domino-team/domino-hardware/Common/Datasheets/USB-AF-006(SMT).jpg

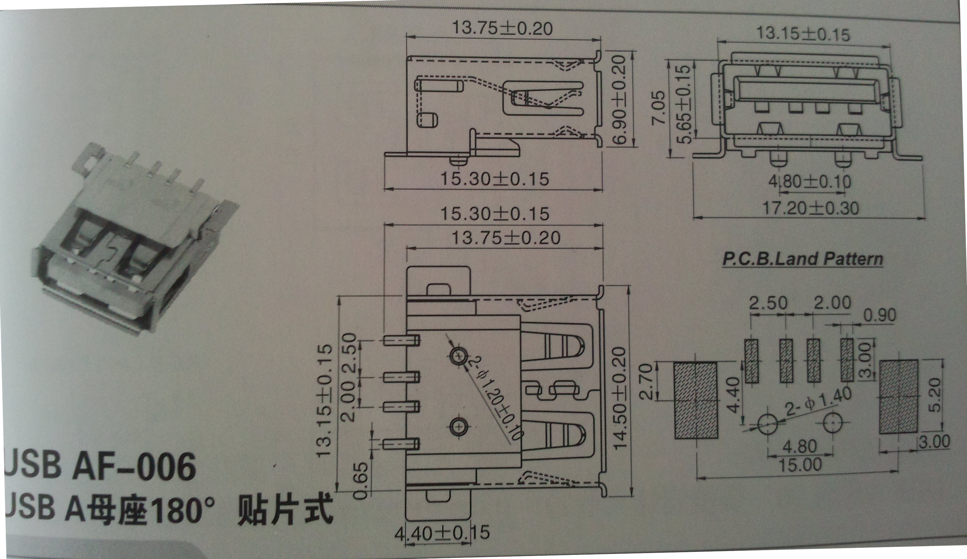
Common/Datasheets/USB-AF-006(SMT).jpg
