domino-team/domino-hardware/Common/Datasheets/usb smt.jpeg

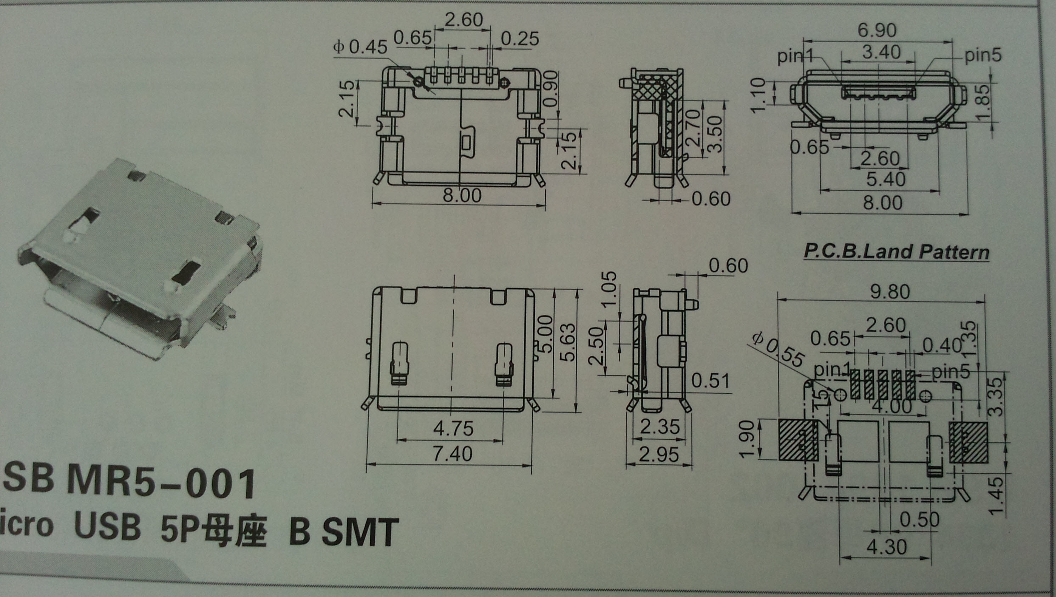
Common/Datasheets/usb smt.jpeg
