domino-team/domino-hardware/README.md

This repository contains the Domino.IO hardware design files.

For further information, please check http://domino.io/
