domino-team/domino-hardware/Common/Datasheets/IT-1124SMD.jpg

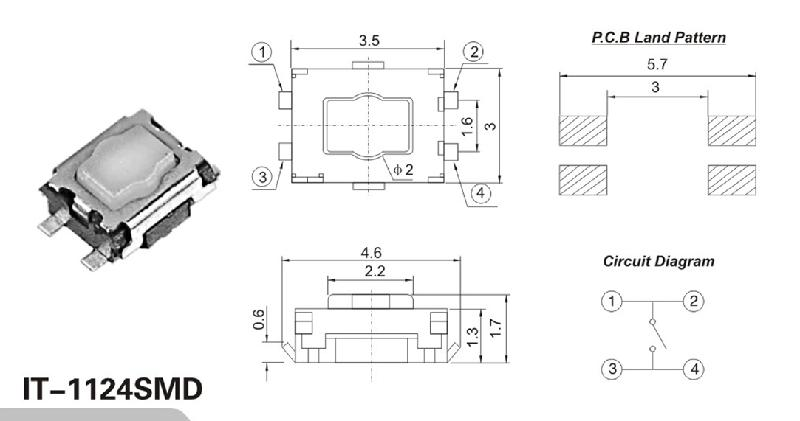
Common/Datasheets/IT-1124SMD.jpg
