domino-team/domino-hardware/Common/Datasheets/IT-1210-footprint.jpg

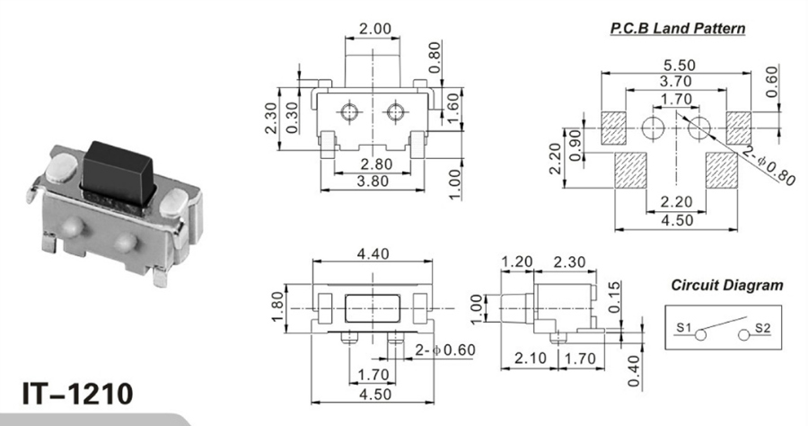
Common/Datasheets/IT-1210-footprint.jpg
