domino-team/domino-hardware/Common/Datasheets/IT-1210.jpg

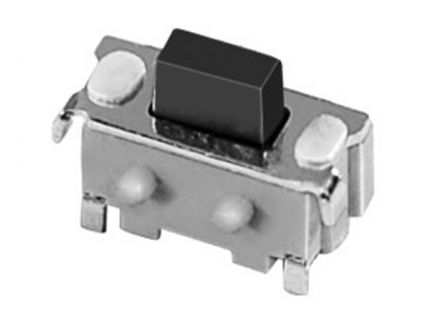
Common/Datasheets/IT-1210.jpg
