domino-team/domino-hardware/Common/Datasheets/MicroUSB-MK5P-5.9(long legs).jpg

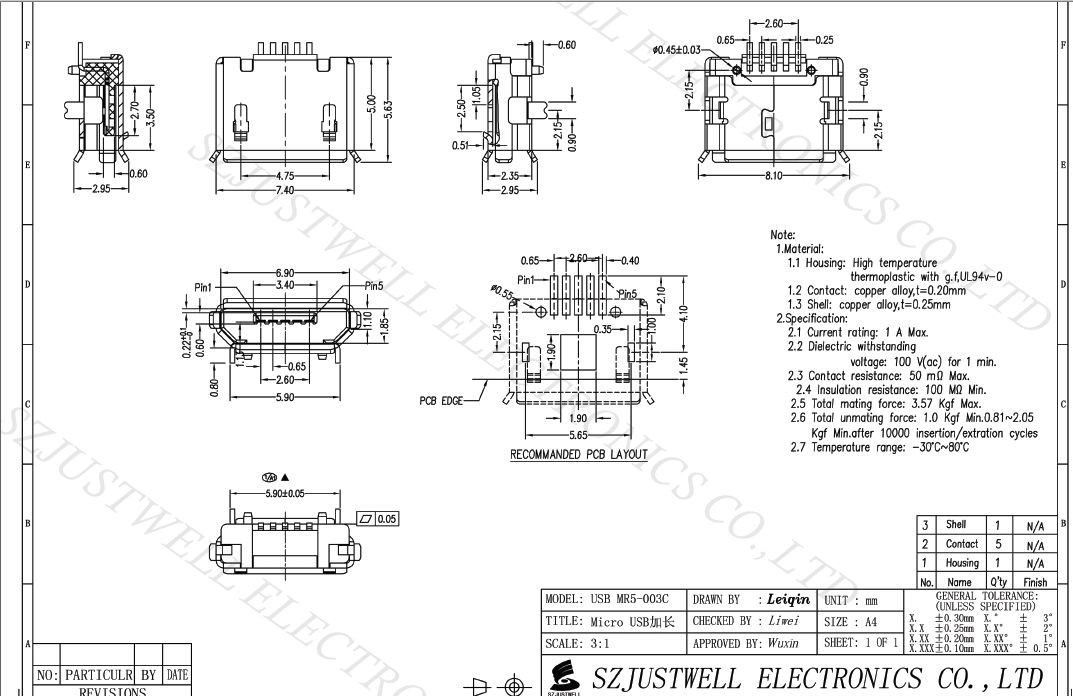
Common/Datasheets/MicroUSB-MK5P-5.9(long legs).jpg
