domino-team/domino-hardware/Common/Datasheets/USB AF-020.jpg

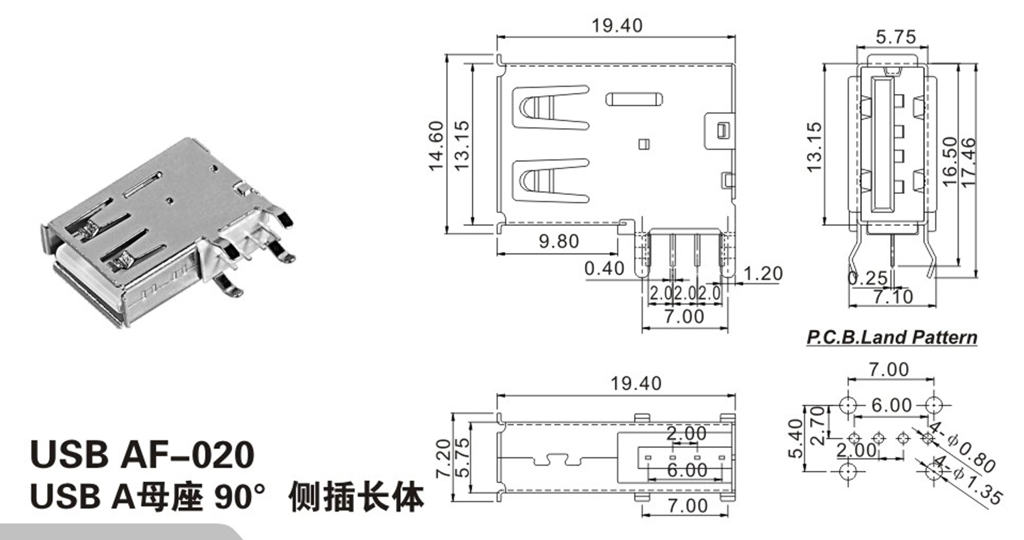
Common/Datasheets/USB AF-020.jpg
