domino-team/domino-hardware/Common/Datasheets/USB-MR5-001.jpg

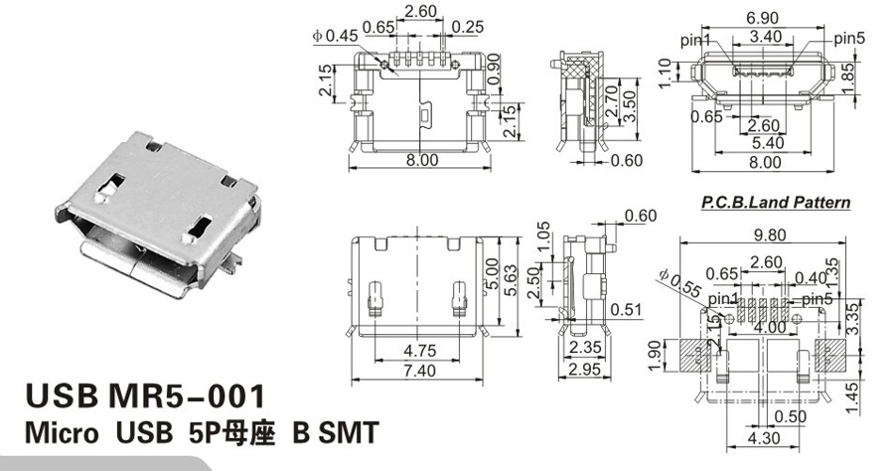
Common/Datasheets/USB-MR5-001.jpg
