domino-team/domino-hardware/Domino Di/PDF/Domino Di_BOM.pdf

# Domino Di Rev. B

Item Qty | Value | Manufacturer | Device | Package | Reference | Description | Remarks
1 | 1 ANY | 2n2 | C1210_2n2_X7R_10%_CER_2kV | C1206 | C1 | CAP CER 2200PF 1KV 10% X7R 1210
2 | 5 ANY | 100n | C0402_100n_X7R_10%_CER_50V | C0402 | C2, C3, C4, C5, C6 | CAP CER 0.1UF 50V 10% X7R 0402
3 | 1 ANY | BLUE | LED0603-BLUE | LED0603 | D1 | LED BLUE CLEAR 0603 SMD
4 | 1 ANY | WHITE | LED0603-WHITE | LED0603 | D2 | LED WHITE CLEAR 0603 SMD
5 | 4 ANY | GREEN | LED0603-GREEN | LED0603 | D3, D4, D5, D6 | LED GREEN CLEAR 0603 SMD
6 | 1 ANY | RED | LED0603-ORANGE | LED0603 | D7 | LED ORANGE CLEAR 0603 SMD
7 | 1 ANY | ORANGE | LED0603-ORANGE | LED0603 | D8 | LED ORANGE CLEAR 0603 SMD
8 | 1 ANY | YELLOW | LED0603-YELLOW | LED0603 | D9 | LED YELLOW CLEAR 0603 SMD
9 | 1 SHEZHEN HUILY ELECTHBJ-2H101NLF | HBJ-2H101NLF | HBJ-2H101NLF | J1 | CONN MAGJACK 2PORT 100 BASE-T
10 | 1 ANY | MH3-1 | MH3-1-0.1 | MH3-1-0.1 | J2 | CONN HEADER VERT .100 1ROW 3POS 8.08 HEAD 3.05 TAIL 15AU
11 | 2 ANY | MH18-1 | MH18-1-0.1 | MH18-1-0.1 | J3, J4 | CONN HEADER VERT .100 1ROW 18POS 8.08 HEAD 3.05 TAIL 15AU
12 | 1 ANY | 4k7 | R0402_4k7_5%_62.5mW | R0402 | R1 | RES 4.7K OHM 1/16W 5% 0402 SMD
13 | 6 ANY | 270R | R0603_270R_5%_125mW | R0603 | R12, R13, R14, R15, R16, R17 | RES 270 OHM 1/8W 5% 0603 SMD
14 | 3 ANY | 330R | R0603_330R_5%_125mW | R0603 | R18, R19, R20 | RES 330 OHM 1/8W 5% 0603 SMD
15 | 1 ANY | 15k | R0402_15k_5%_62.5mW | R0402 | R2 | RES 15K OHM 1/16W 5% 0402 SMD
16 | 1 ANY | 220R | R0402_220R_5%_62.5mW | R0402 | R3 | RES 220 OHM 1/16W 5% 0402 SMD
17 | 8 ANY | 49R9 | R0402_49R9_1%_62.5mW | R0402 | R4, R5, R6, R7, R8, R9, R10, R11 | RES 49.9 OHM 1/16W 1% 0402 SMD
