domino-team/domino-hardware/Domino Single USB/PDF/Domino Single USB_BOM.pdf

# Domino Single USB Rev. E

Item | | Manufacturer | | | | Description
1 | 3 0R | ANY | R0402_0R_5%_62.5mW | R0402 | R3, R5, R6 | RES 0.0 OHM 1/16W JUMP 0402 SMD
2 | 1 1n | ANY | C1206_1n_X7R_10%_CER_500V | C1206 | C5 | CAP CER 1000PF 500V 10% X7R 1206
3 | 1 10u | ANY | C0603_10u_X5R_20%_CER_6V3 | C0603 | C1 | CAP CER 10UF 6.3V 20% X5R 0603
4 | 1 10u | ANY | C0805_10u_X5R_10%_CER_16V | C0805 | C4 | CAP CER 10UF 16V 10% X5R 0805
5 | 1 15k | ANY | R0402_15k_5%_62.5mW | R0402 | R4 | RES 15K OHM 1/16W 5% 0402 SMD
6 | 1 22u | ANY | C0805_22u_X5R_20%_CER_6V3 | C0805 | C2 | CAP CER 22UF 6.3V 20% X5R 0805
7 | 1 33R | ANY | R0402_33R_5%_62.5mW | R0402 | R1 | RES 33 OHM 1/16W 5% 0402 SMD
8 | 1 100k | ANY | R0402_100k_5%_62.5mW | R0402 | R2 | RES 100K OHM 1/16W 5% 0402 SMD
9 | 1 100n | ANY | C0402_100n_X7R_10%_CER_50V | C0402 | C3 | CAP CER 0.1UF 50V 10% X7R 0402
10 | 1 BLM31PG601SN1L | MURATA | BLM31PG601SN1L | FB1206 | L1 | FERRITE CHIP 600 OHM 1500MA 1206
11 | 2 MH10-1 | ANY | MH10-1-0.1 | MH10-1-0.1 | J1, J2 | CONN HEADER VERT .100 1ROW 10POS 8.08 HEAD 3.05 TAIL 15AU
12 | 1 MP65151DJ | MONOLITHIC POWER | MP65151DJ | SOT23-6 | U1 | IC POWER SWITCH 1.7A SOT23-6
13 | 1 PRTR5V0U2X | NXP | PRTR5V0U2X | SOT143B | D1 | TVS DIODE ARRAY 2CH 5V SOT143
Qty | Value | Device | Package | Reference | Remarks
