domino-team/domino-hardware/Domino LED/PDF/Domino LED_BOM.pdf

# Domino LED Rev. D

Item | Manufacturer | Description
1 | 1 BLUE | ANY | LED0603-BLUE | LED0603 | D1 | LED BLUE CLEAR 0603 SMD
2 | 1 WHITE | ANY | LED0603-WHITE | LED0603 | D2 | LED WHITE CLEAR 0603 SMD
3 | 4 GREEN | ANY | LED0603-GREEN | LED0603 | D3, D4, D5, D6 | LED GREEN CLEAR 0603 SMD
4 | 1 RED | ANY | LED0603-RED | LED0603 | D7 | LED RED CLEAR 0603 SMD
5 | 1 ORANGE | ANY | LED0603-ORANGE | LED0603 | D8 | LED ORANGE CLEAR 0603 SMD
6 | 1 YELLOW | ANY | LED0603-YELLOW | LED0603 | D9 | LED YELLOW CLEAR 0603 SMD
7 | 1 MH11-1 | ANY | MH11-1-0.1 | MH11-1-0.1 | J1 | CONN HEADER VERT .100 1ROW 11POS 8.08 HEAD 3.05 TAIL 15AU
8 | 6 270R | ANY | R0603_270R_5%_125mW | R0603 | R1, R2, R3, R4, R5, R6 | RES 270 OHM 1/8W 5% 0603 SMD
9 | 3 330R | ANY | R0603_330R_5%_125mW | R0603 | R7, R8, R9 | RES 330 OHM 1/8W 5% 0603 SMD
Qty | Value | Device | Package | Reference | Remarks
