domino-team/domino-hardware/Domino I2S/BOM/Domino I2S BOM.xlsx

Item | Qty | Value | Manufacturer | Device | Package | Reference | Description | Remarks
1 | 6 | 4u7 | ANY | C0402_4u7_X5R_10%_CER_6V3 | C0402 | C1, C2, C3, C4, C5, C6 | CAP CER 4.7UF 6.3V 10% X5R 0402
2 | 2 | 1n | ANY | C0402_1n_X7R_10%_CER_50V | C0402 | C10, C11 | CAP CER 1NF 50V 10% X7R 0402
3 | 2 | 10n | ANY | C0402_10n_X7R_10%_CER_50V | C0402 | C14, C15 | CAP CER 10000PF 50V 10% X7R 0402
4 | 1 | 220p | ANY | C0402_220p_X7R_10%_CER_50V | C0402 | C7 | CAP CER 0.22UF 50V 10% X7R 0402
5 | 2 | 33p | ANY | C0402_33p_NP0_5%_CER_50V | C0402 | C8, C12 | CAP CER 33PF 50V 5% NP0 0402
6 | 5 | 1u | ANY | C0402_1u_X7R_10%_CER_25V | C0402 | C9, C13, C16, C17, C18 | CAP CER 1UF 25V 10% X7R 0402
7 | 2 | 220u | ANY | C2-5x7_220u_ALU_20%_RAD_6V3 | E2-5 | EC1, EC2 | CAP ALUM 220UF 6.3V 20% RADIAL
8 | 7 | HH-1T1005-121 | CERATECH | HH-1T2012-601 | FB0805 | FB1, FB2, FB3, FB4, FB5, FB6, FB7 | FERRITE CHIP 600 OHM 2500MA 0805
9 | 1 | ST-3538-050 | SZJUSTWELL ELECTRONICS | ST-3538-050 | ST-3538-050 | HP1 | CONN AUDIO JACK 3.5MM STEREO SMD
10 | 2 | MH18-1 | ANY | MH18-1-0.1 | MH18-1-0.1 | J1, J2 | CONN HEADER VERT .100 1ROW 18POS 8.08 HEAD 3.05 TAIL 15AU
11 | 0 | MIC-45-22 | ANY | MIC-45-22 | MIC-45-22 | J3(DNP) | MIC COND ANALOG OMNI
12 | 1 | MH2-1 | ANY | MH2-1-0.1 | MH2-1-0.1 | J4(DNP), J5(DNP), J7 | CONN HEADER VERT .100 1ROW 2POS 8.08 HEAD 3.05 TAIL 15AU
13 | 1 | DLT1120A | AIXIN LTD | DLT1120A | DLT1120A | J6 | TRANSMITTER FIBER OPTIC 16MBPS
14 | 2 | CD54NP-220MC | SUMIDA INC | CD54NP-220MC | CD54 | L1, L2 | FIXED IND 220UH 1.11A 190 MOHM
15 | 3 | 0R | ANY | R0402_0R_5%_62.5mW | R0402 | R1(DNP), R2, R12, R17 | RES 0.0 OHM 1/16W JUMP 0402 SMD
16 | 2 | 4k7 | ANY | R0402_4k7_5%_62.5mW | R0402 | R13, R14 | RES 4.7K OHM 1/16W 5% 0402 SMD
17 | 1 | 10k | ANY | R0402_10k_5%_62.5mW | R0402 | R3(DNP), R4(DNP), R15, R16(DNP) | RES 10K OHM 1/16W 5% 0402 SMD
18 | 5 | 22R | ANY | R0402_22R_5%_62.5mW | R0402 | R5, R6, R8, R10, R11 | RES 22 OHM 1/16W 5% 0402 SMD
19 | 1 | 47k | ANY | R0402_47k_5%_62.5mW | R0402 | R7 | RES 47K OHM 1/16W 5% 0402 SMD
20 | 1 | 680R | ANY | R0402_680R_5%_62.5mW | R0402 | R9 | RES 680 OHM 1/16W 5% 0402 SMD
21 | 1 | WM8978CGEFL | CIRRUS LOGIC | WM8978CGEFL | QFN-32_EP_5X5 | U1 | IC CODEC STER SPEAKER DVR 32QF
