domino-team/domino-hardware/Common/Arduino Yùn Outline.dxf

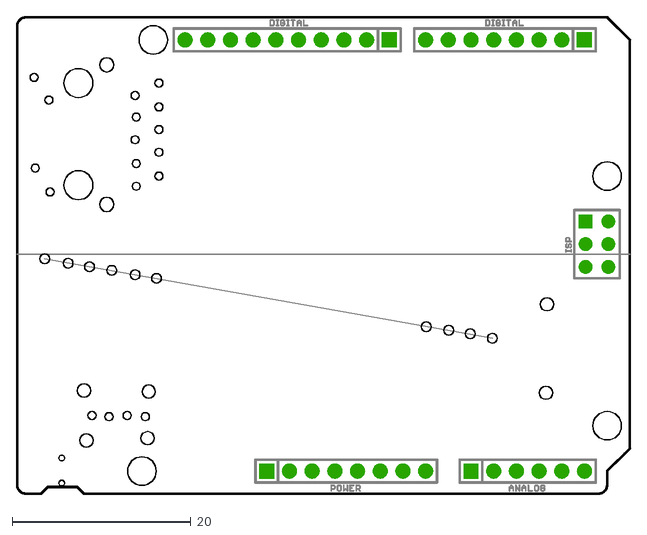
[picture p9: CAD file, 2015-01-17]
Common/Arduino Yùn Outline.dxf
68.8 x 53.6
