domino-team/domino-hardware/Common/Logo/Logos.dxf

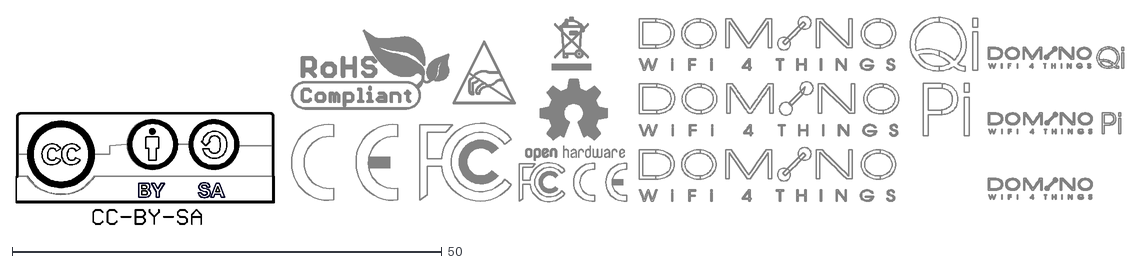
[picture p10: CAD file, 2015-01-20]
Common/Logo/Logos.dxf
128.9 x 24.2
