domino-team/domino-hardware/(threads)

Thread 1 (2015-04-27):

Eagle again, eh?

pfalcon, 2015-04-27:
I remember you replying that you don't have need/time to learn e.g. Kicad if Eagle works for you. "Glad" to see that even a kickstarter is not a reason for you do more homework with OpenSource tools.

Way to go, OpenHardware community! Aka shame-shame-shame ;-)

P.S. And yes, I keep saying this, because next time when in low spirit I reach for a proprietary crap, someone else shamed myself into doing the right thing.

Squonk42, 2015-04-27:
Sorry, but I tried again recently, and KiCAD is missing many important points and still segfaulting very often.

I have been working with many ECAD suites (Orcad, Protel Altiium, PCAD), and I can't used to KiCAD's counter-intuitive part managment, bad translations, random menus, etc.

At least ERC and back-annotation should work, which is apparently not the case.

Closed 2015-04-27.

Thread 2 (2015-05-19):

Correct way to attribute the PCB design

pastcompute, 2015-05-19:
Hi,

I'm looking at designing a shield PCB for the Domino Pi, for which I would like to copy the pinout stencil layer.

What is your preferred text to conform with the CC4 license?

I'm guessing something like the following printed on the stencil layer would suffice
```
Licensed under a Creative Commons
Attribution-Share-Alike Unported License.
See creativecommons.org/licenses/by-sa/4.0/

Attribution: portions of this design, specifically, the pinout stencil, (c) 2014-2015 The Domino Team (http://domino.io)
```

Squonk42, 2015-05-19:
This is fine if you have enough real room to put all this text, but you may also jsut provide a URI or hyperlink to a resource that includes the required information, see http://creativecommons.org/licenses/by-sa/4.0/legalcode, section 3.a.2.

pastcompute, 2015-05-23:
No worries. I was more asking as to how to refer to yourselves, so I guess that wherever it lives, attribution to (c) 2014-2015 The Domino Team (http://domino.io) conveys all the necessary information

Closed 2015-05-23.

Thread 3 (2015-08-22):

Domino Pi CP2104 USB UART not working?

gruvin, 2015-08-22:
Hello

I received my first Domino Pi from the Kickstarter campaign, today. It's working nicely. Great work!

However, it seems that the Silicon Labs CP2104 USB UART device is not working. I have the OS X drivers installed and use several other devices via CP210x chips. But in this case, no serial ports appear on OS X (/dev/tty.blah) or even in the raw USB devices, 'System Report' for that matter.

**Is this a known issue** or do I perhaps have a faulty Domino Pi board? If the latter, then perhaps I should see about checking the solder joints on the CP2104 chip, etc? I am tooled up and fine with that tiny SMD stuff. But would rather not risk damage until I get an answer here.

Thanks! :-)

Bryan.

alzhao, 2015-08-22:
The usb uart bridge should work. It rarely faulty. Is it possible that you
try on Windows or Linux first to see what is happening?
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

gruvin, 2015-08-23:
Thanks for the answer, alzhao. Astonishingly, after a full inspection under the microscope and some continuity testing, etc ... it turned out simply to be TWO faulty USB micro cables! All working now. Yay \o/

gruvin, 2015-08-24:
Alas and perhaps not surprisingly, I did NOT have two faulty cables, after all. The SP2104 chips is only coming online as a valid USB device about one in five times I plug it in. Otherwise, it is not being recognised even at the lowest hardware level.

There doesn't appear to be any dry joints. I guess I must have a dud chip, somehow. Guess I'll order some in, replace it and see what happens.

gruvin, 2015-08-24:
OK. I finally got to the bottom of it.

Pint 9 (/RST) on the CP2014 was being held almost low by a low resistance semi-bridge in the solder beneath the chip. This appears to have come about due to the pads for both pin 9 and 10 being physically missing (peeled up off the board, by the looks) causing both pins to semi attach to the solder on the large, square ground plane under the chip, during solder re-flow.

It took two remove and replace cycles of the chip for me to figure this out. Initially, I removed the chip, cleaned everything up and reinstalled. It seemed to work for about a half hour. Then the problem returned. Looking closer at things directly after removing it a second time, there was evidence suggesting a possible short of pin 9 to GND. I took steps to avoid that happening again on my second re-install and re-flow. Now, touch wood!, everything is working fine.

**NOTE** I would recommend moving the via just inside of pin 2 a few mils further away from pin 2. The drill for the via pushed the via's surrounding track very close to pin 1 - well under 5 mil spacing in my case. Avoiding that potential short seems an easy fix for future versions.

Anyway. A lot to do about very little. But there it is, in case anyone finds it useful.

Bryan.

Squonk42, 2015-08-24:
Hi @gruvin,

Thanks for spotting this! Nice hardware debugging.

Pads 9 and 10 are not supposed to be missing, and adding a pull-up to pin 9 is a very good suggestion.

We tried to put the via on pin 2 this close in order to avoid this via "sucking" solder from the large square central pad. But the last-minute "teardrop" added by the corresponding EagleCAD script made it such that it is barely respecting the 6 mils clearance rule. We will fix it in future revision.

Closed 2015-08-24.
