domino-team/domino-hardware/Domino Di/PDF/Domino Di.pdf

# North Connector Antenna

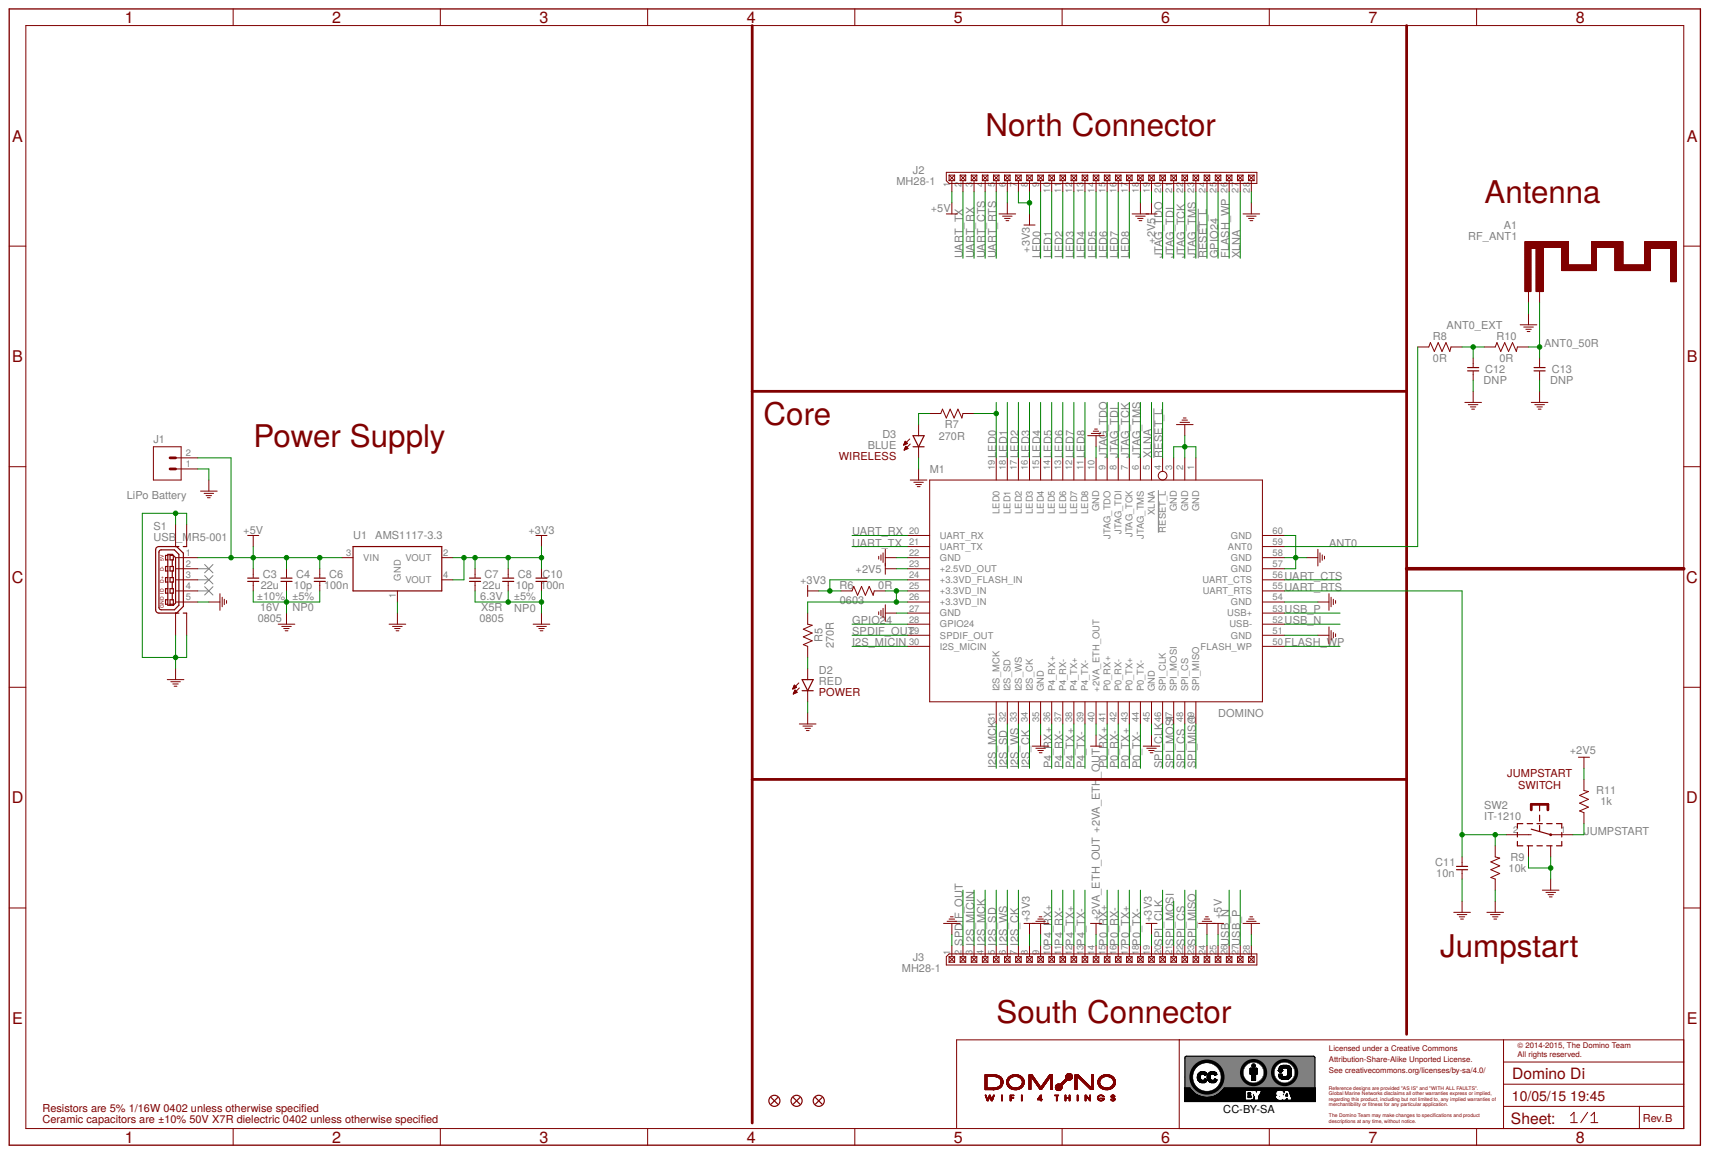
[picture p11: page 1]

Licensed under a Creative Commons Attribution-Share-Alike Unported License. See creativecommons.org/licenses/by-sa/4.0/ Reference designs are provided "AS IS" and "WITH ALL FAULTS". regarding this product, including but not limited to, any implied warranties of The Domino Team may make changes to specifications and product Global Marine Networks disclaims all other warranties express or implied, merchantibility or fitness for any particular application. descriptions at any time, without notice.

Ceramic capacitors are ±10% 50V X7R dielectric 0402 unless otherwise specified Resistors are 5% 1/16W 0402 unless otherwise specified

## DRILL CHART: TOP TO BOTTOM

A

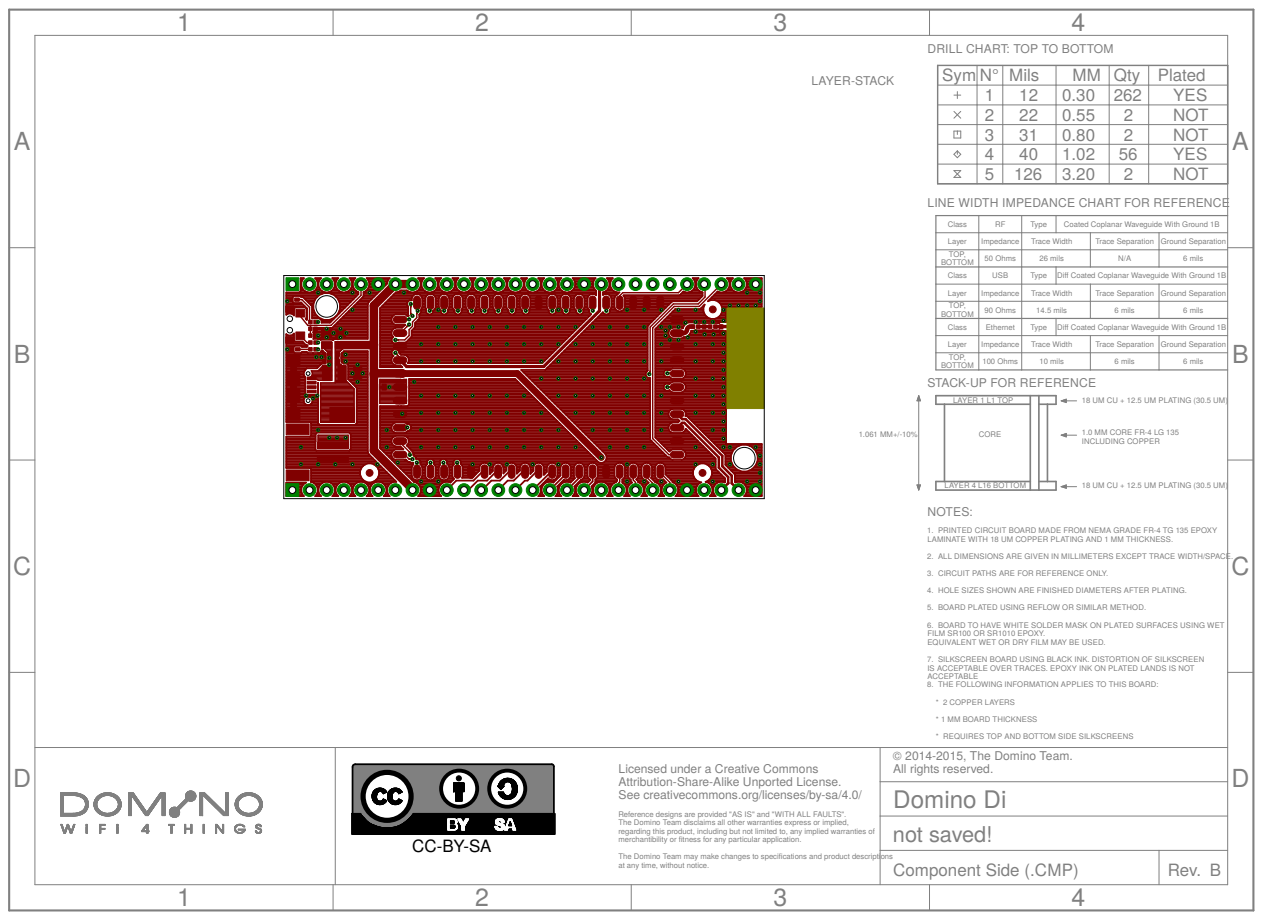
[picture p12: page 2]
LAYER 1 L1 TOP; LAYER 4 L16 BOTTOM; CORE; Rev. B; Layer; Impedance; Trace Width; Trace Separation; Ground Separation TOP, BOTTOM; 90 Ohms; 14.5 mils; 6 mils; 6 mils Class; USB; Type; Diff Coated Coplanar Waveguide With Ground 1B; 100 Ohms; 10 mils; Ethernet; LAYER-STACK; Sym N° Mils; MM Qty Plated; YES; NOT

LINE WIDTH IMPEDANCE CHART FOR REFERENCE

Layer | 50 Ohms RF Impedance | Type 26 mils Diff Coated Coplanar Waveguide With Ground 1B Trace Width | N/A Trace Separation | 6 mils Class Ground Separation TOP, BOTTOM

Coated Coplanar Waveguide With Ground 1B

1.061 MM+/-10% STACK-UP FOR REFERENCE

18 UM CU + 12.5 UM PLATING (30.5 UM)

1.0 MM CORE FR-4 LG 135
INCLUDING COPPER

NOTES: 2. ALL DIMENSIONS ARE GIVEN IN MILLIMETERS EXCEPT TRACE WIDTH/SPACE. 3. CIRCUIT PATHS ARE FOR REFERENCE ONLY.

1. PRINTED CIRCUIT BOARD MADE FROM NEMA GRADE FR-4 TG 135 EPOXY
LAMINATE WITH 18 UM COPPER PLATING AND 1 MM THICKNESS.

4. HOLE SIZES SHOWN ARE FINISHED DIAMETERS AFTER PLATING. 5. BOARD PLATED USING REFLOW OR SIMILAR METHOD. 6. BOARD TO HAVE WHITE SOLDER MASK ON PLATED SURFACES USING WET

FILM SR100 OR SR1010 EPOXY. EQUIVALENT WET OR DRY FILM MAY BE USED. 8. THE FOLLOWING INFORMATION APPLIES TO THIS BOARD: 7. SILKSCREEN BOARD USING BLACK INK. DISTORTION OF SILKSCREEN

IS ACCEPTABLE OVER TRACES. EPOXY INK ON PLATED LANDS IS NOT ACCEPTABLE

* 2 COPPER LAYERS
* 1 MM BOARD THICKNESS
* REQUIRES TOP AND BOTTOM SIDE SILKSCREENS
© 2014-2015, The Domino Team. All rights reserved.
Domino Di
not saved!
Component Side (.CMP)

Licensed under a Creative Commons Attribution-Share-Alike Unported License. See creativecommons.org/licenses/by-sa/4.0/ Reference designs are provided "AS IS" and "WITH ALL FAULTS". The Domino Team disclaims all other warranties express or implied, regarding this product, including but not limited to, any implied warranties of merchantibility or fitness for any particular application. The Domino Team may make changes to specifications and product descriptions at any time, without notice.

## DRILL CHART: TOP TO BOTTOM

A

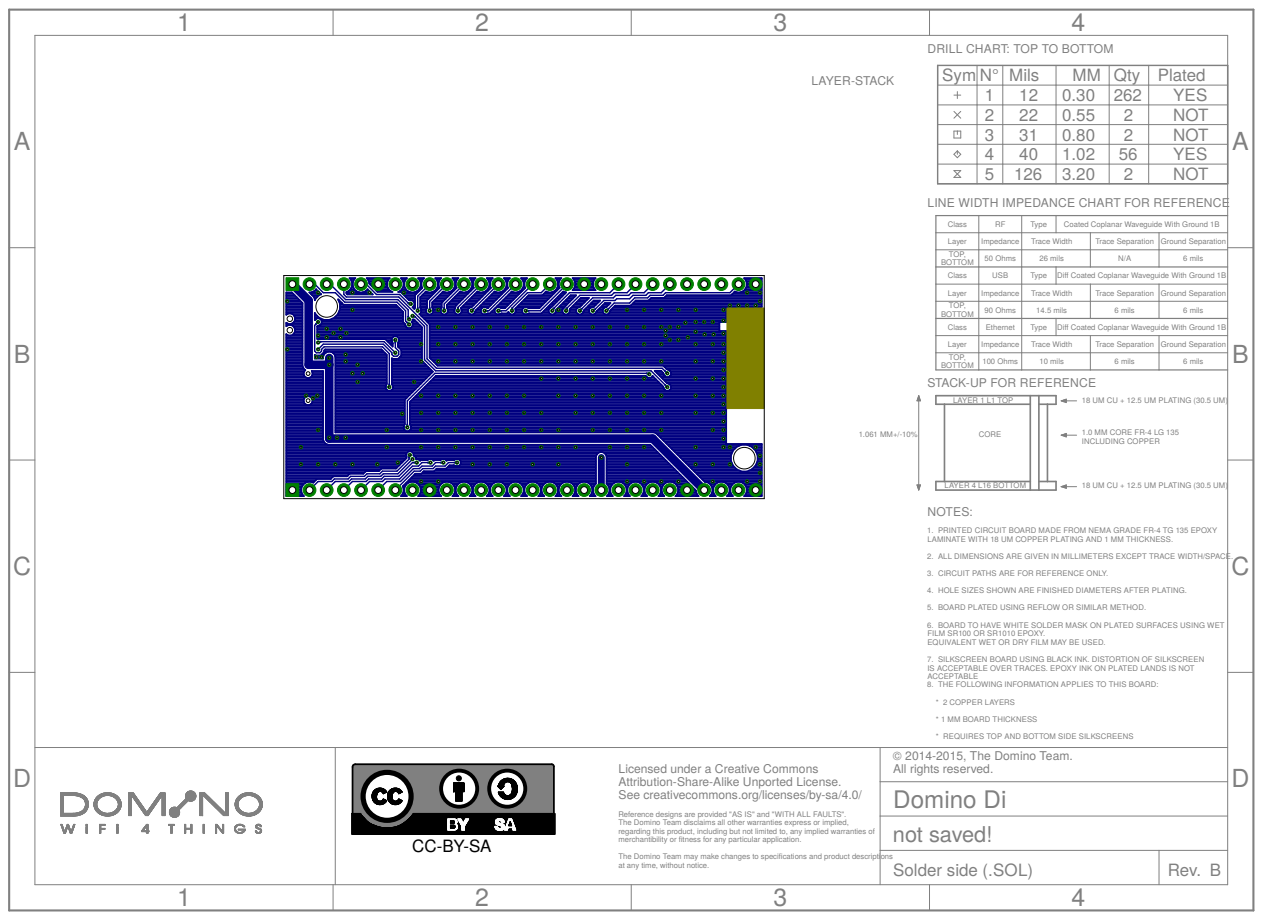
[picture p13: page 3]
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

LINE WIDTH IMPEDANCE CHART FOR REFERENCE

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

Coated Coplanar Waveguide With Ground 1B

1.061 MM+/-10% STACK-UP FOR REFERENCE

18 UM CU + 12.5 UM PLATING (30.5 UM)

1.0 MM CORE FR-4 LG 135
INCLUDING COPPER

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

1. PRINTED CIRCUIT BOARD MADE FROM NEMA GRADE FR-4 TG 135 EPOXY
LAMINATE WITH 18 UM COPPER PLATING AND 1 MM THICKNESS.

4. HOLE SIZES SHOWN ARE FINISHED DIAMETERS AFTER PLATING. 5. BOARD PLATED USING REFLOW OR SIMILAR METHOD. 6. BOARD TO HAVE WHITE SOLDER MASK ON PLATED SURFACES USING WET

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

IS ACCEPTABLE OVER TRACES. EPOXY INK ON PLATED LANDS IS NOT ACCEPTABLE

* 2 COPPER LAYERS
* 1 MM BOARD THICKNESS
* REQUIRES TOP AND BOTTOM SIDE SILKSCREENS
© 2014-2015, The Domino Team. All rights reserved.
Domino Di
not saved!
Solder side (.SOL)

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

Rev. 20150510 B C3 C4 C6 C7 C8 C10 R6 R8 R10 C12 C13D3 R7 M1 S1 D2 R5R11 R9 C11 SW2 U1 J1 Licensed under a Creative Commons Attribution-Share-Alike Unported License. See creativecommons.org/licenses/by-sa/4.0/ Reference designs are provided "AS IS" and "WITH ALL FAULTS". The Domino Team disclaims all other warranties express or implied, regarding this product, including but not limited to, any implied warranties of merchantibility or fitness for any particular application. The Domino Team may make changes to specifications and product descriptions at any time, without notice. © 2014-2015, The Domino Team. All rights reserved. NOTES: 2. ALL DIMENSIONS ARE GIVEN IN MILLIMETERS EXCEPT TRACE WIDTH/SPACE. 3. CIRCUIT PATHS ARE FOR REFERENCE ONLY. * 2 COPPER LAYERS * 1 MM BOARD THICKNESS * REQUIRES TOP AND BOTTOM SIDE SILKSCREENS 4. HOLE SIZES SHOWN ARE FINISHED DIAMETERS AFTER PLATING. 5. BOARD PLATED USING REFLOW OR SIMILAR METHOD. 6. BOARD TO HAVE WHITE SOLDER MASK ON PLATED SURFACES USING WET FILM SR100 OR SR1010 EPOXY. EQUIVALENT WET OR DRY FILM MAY BE USED. 8. THE FOLLOWING INFORMATION APPLIES TO THIS BOARD: 7. SILKSCREEN BOARD USING BLACK INK. DISTORTION OF SILKSCREEN IS ACCEPTABLE OVER TRACES. EPOXY INK ON PLATED LANDS IS NOT ACCEPTABLE 1. PRINTED CIRCUIT BOARD MADE FROM NEMA GRADE FR-4 TG 135 EPOXY LAMINATE WITH 18 UM COPPER PLATING AND 1 MM THICKNESS. LAYER 1 L1 TOP LAYER 4 L16 BOTTOM CORE 18 UM CU + 12.5 UM PLATING (30.5 UM) 18 UM CU + 12.5 UM PLATING (30.5 UM) 1.0 MM CORE FR-4 LG 135 INCLUDING COPPER 1.061 MM+/-10% STACK-UP FOR REFERENCE Rev. B DRILL CHART: TOP TO BOTTOM LINE WIDTH IMPEDANCE CHART FOR REFERENCE Coated Coplanar Waveguide With Ground 1B Layer Impedance Trace Width Trace Separation Ground Separation TOP, BOTTOM 50 Ohms 26 mils N/A 6 mils Class RF Type Diff Coated Coplanar Waveguide With Ground 1B Layer Impedance Trace Width Trace Separation Ground Separation TOP, BOTTOM 90 Ohms 14.5 mils 6 mils 6 mils Class USB Type Diff Coated Coplanar Waveguide With Ground 1B Layer Impedance Trace Width Trace Separation Ground Separation TOP, BOTTOM 100 Ohms 10 mils 6 mils 6 mils Class Ethernet Type Domino Di not saved! ABCD 1 2 3 4 ABCD 1 2 3 4 CC-BY-SA LAYER-STACK Sym N° Mils MM Qty Plated 1 12 0.30 262 YES 2 22 0.55 2 NOT 3 31 0.80 2 NOT 4 40 1.02 56 YES 5 126 3.20 2 NOT Silk screen CMP (.PLC)

## DRILL CHART: TOP TO BOTTOM

A

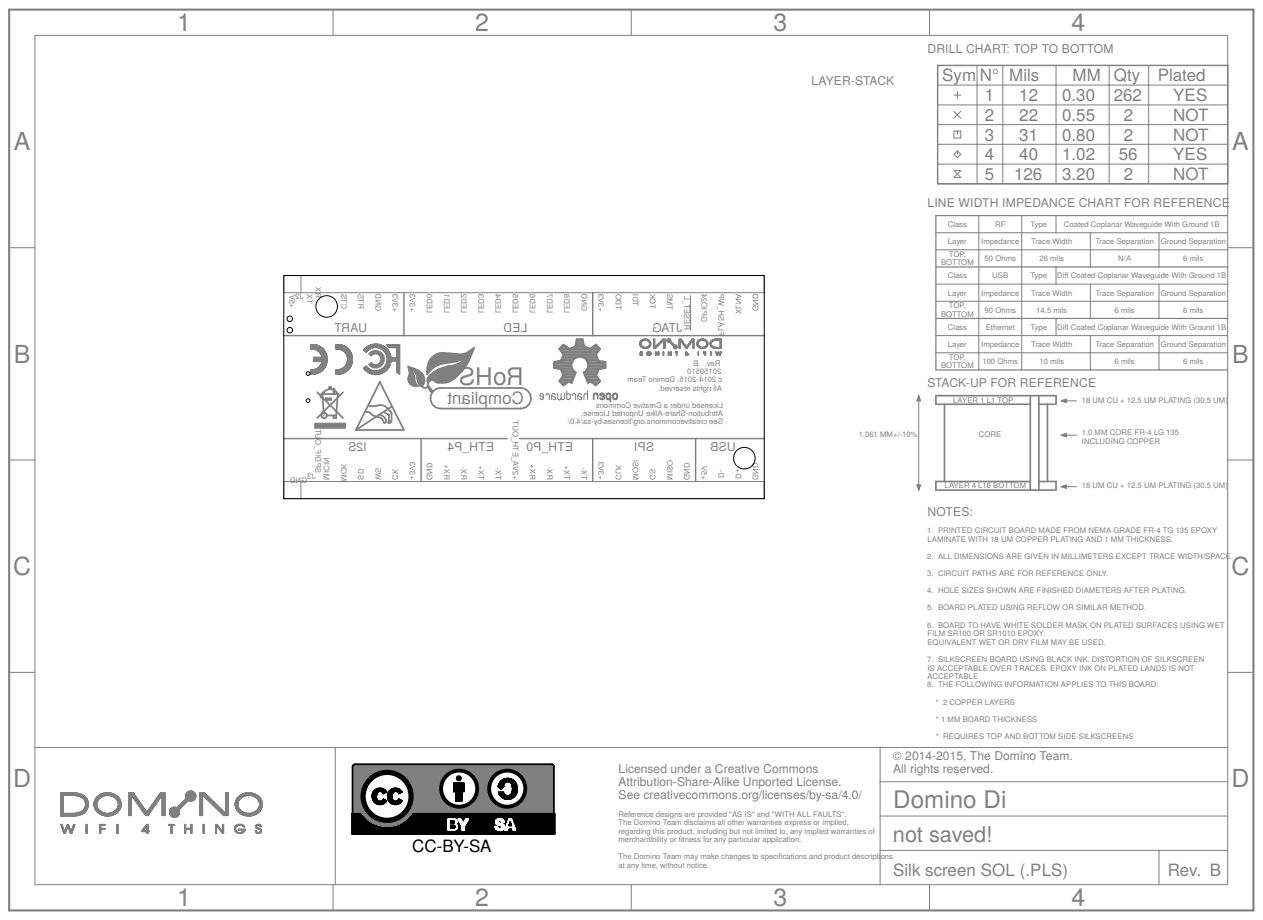
[picture p14: page 5]

LINE WIDTH IMPEDANCE CHART FOR REFERENCE

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

Coated Coplanar Waveguide With Ground 1B

1.061 MM+/-10% STACK-UP FOR REFERENCE

18 UM CU + 12.5 UM PLATING (30.5 UM)

RX+ RX- TX+ TX- +2VA_ETH_OUT RX+ RX- TX+ TX-

1.0 MM CORE FR-4 LG 135
INCLUDING COPPER

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

1. PRINTED CIRCUIT BOARD MADE FROM NEMA GRADE FR-4 TG 135 EPOXY
LAMINATE WITH 18 UM COPPER PLATING AND 1 MM THICKNESS.

4. HOLE SIZES SHOWN ARE FINISHED DIAMETERS AFTER PLATING. 5. BOARD PLATED USING REFLOW OR SIMILAR METHOD. 6. BOARD TO HAVE WHITE SOLDER MASK ON PLATED SURFACES USING WET

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

IS ACCEPTABLE OVER TRACES. EPOXY INK ON PLATED LANDS IS NOT ACCEPTABLE

* 2 COPPER LAYERS
* 1 MM BOARD THICKNESS
* REQUIRES TOP AND BOTTOM SIDE SILKSCREENS
© 2014-2015, The Domino Team. All rights reserved.
Domino Di
not saved!
Silk screen SOL (.PLS)

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

## DRILL CHART: TOP TO BOTTOM

A

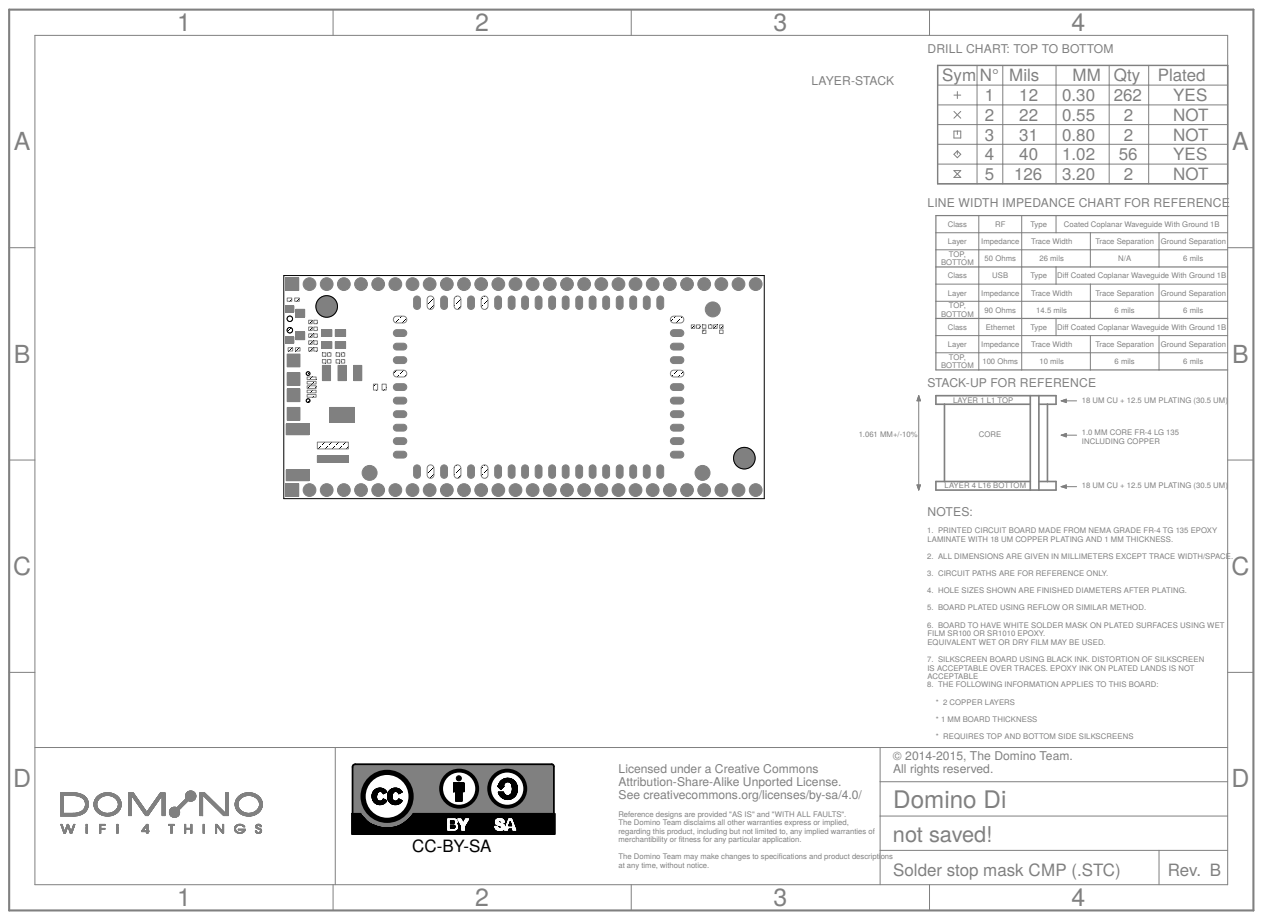
[picture p15: page 6]
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

LINE WIDTH IMPEDANCE CHART FOR REFERENCE

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

Coated Coplanar Waveguide With Ground 1B

1.061 MM+/-10% STACK-UP FOR REFERENCE

18 UM CU + 12.5 UM PLATING (30.5 UM)

1.0 MM CORE FR-4 LG 135
INCLUDING COPPER

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

1. PRINTED CIRCUIT BOARD MADE FROM NEMA GRADE FR-4 TG 135 EPOXY
LAMINATE WITH 18 UM COPPER PLATING AND 1 MM THICKNESS.

4. HOLE SIZES SHOWN ARE FINISHED DIAMETERS AFTER PLATING. 5. BOARD PLATED USING REFLOW OR SIMILAR METHOD. 6. BOARD TO HAVE WHITE SOLDER MASK ON PLATED SURFACES USING WET

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

IS ACCEPTABLE OVER TRACES. EPOXY INK ON PLATED LANDS IS NOT ACCEPTABLE

* 2 COPPER LAYERS
* 1 MM BOARD THICKNESS
* REQUIRES TOP AND BOTTOM SIDE SILKSCREENS
© 2014-2015, The Domino Team. All rights reserved.
Domino Di
not saved!
Solder stop mask CMP (.STC)

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

## DRILL CHART: TOP TO BOTTOM

A

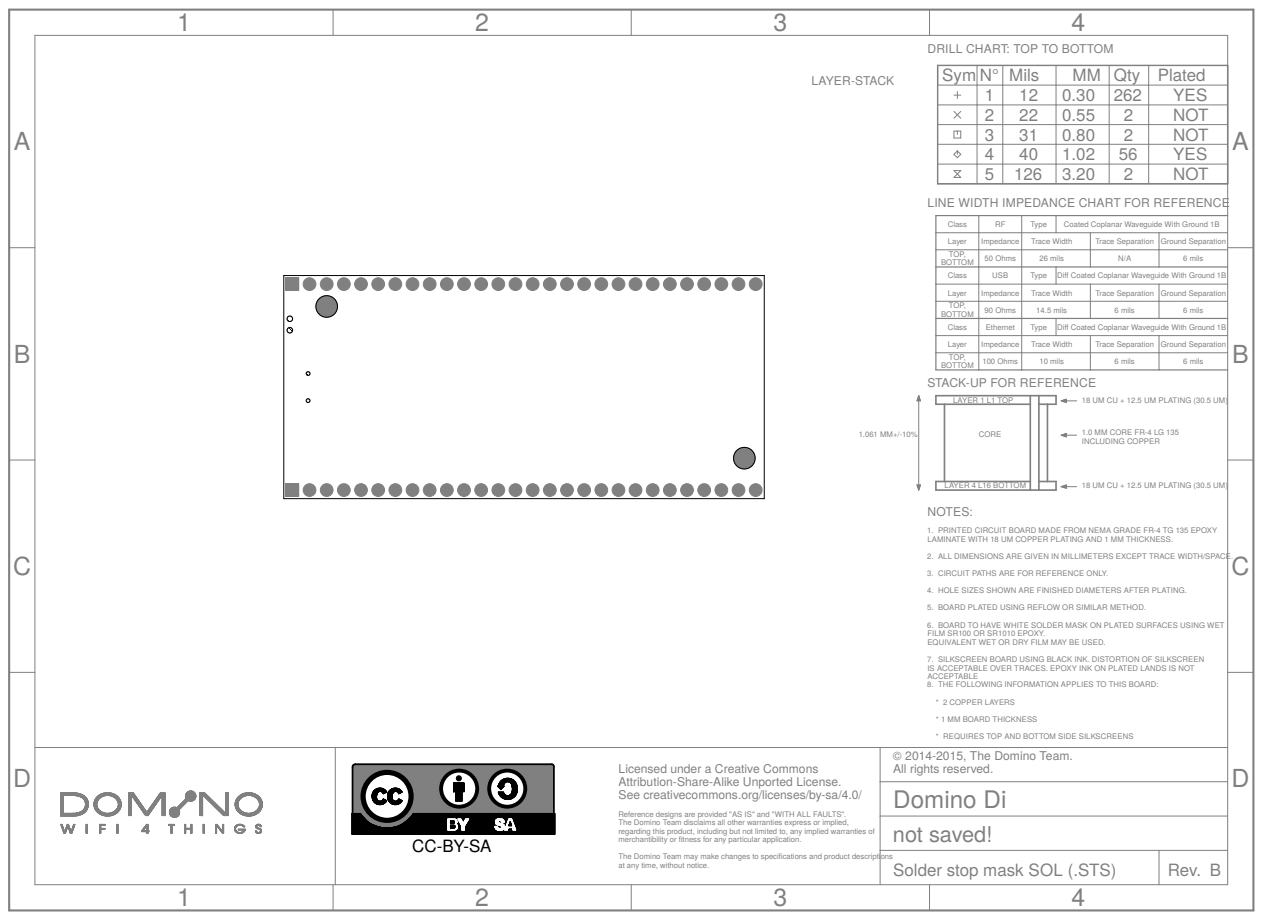
[picture p16: page 7]
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

LINE WIDTH IMPEDANCE CHART FOR REFERENCE

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

Coated Coplanar Waveguide With Ground 1B

1.061 MM+/-10% STACK-UP FOR REFERENCE

18 UM CU + 12.5 UM PLATING (30.5 UM)

1.0 MM CORE FR-4 LG 135
INCLUDING COPPER

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

1. PRINTED CIRCUIT BOARD MADE FROM NEMA GRADE FR-4 TG 135 EPOXY
LAMINATE WITH 18 UM COPPER PLATING AND 1 MM THICKNESS.

4. HOLE SIZES SHOWN ARE FINISHED DIAMETERS AFTER PLATING. 5. BOARD PLATED USING REFLOW OR SIMILAR METHOD. 6. BOARD TO HAVE WHITE SOLDER MASK ON PLATED SURFACES USING WET

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

IS ACCEPTABLE OVER TRACES. EPOXY INK ON PLATED LANDS IS NOT ACCEPTABLE

* 2 COPPER LAYERS
* 1 MM BOARD THICKNESS
* REQUIRES TOP AND BOTTOM SIDE SILKSCREENS
© 2014-2015, The Domino Team. All rights reserved.
Domino Di
not saved!
Solder stop mask SOL (.STS)

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

## DRILL CHART: TOP TO BOTTOM

A

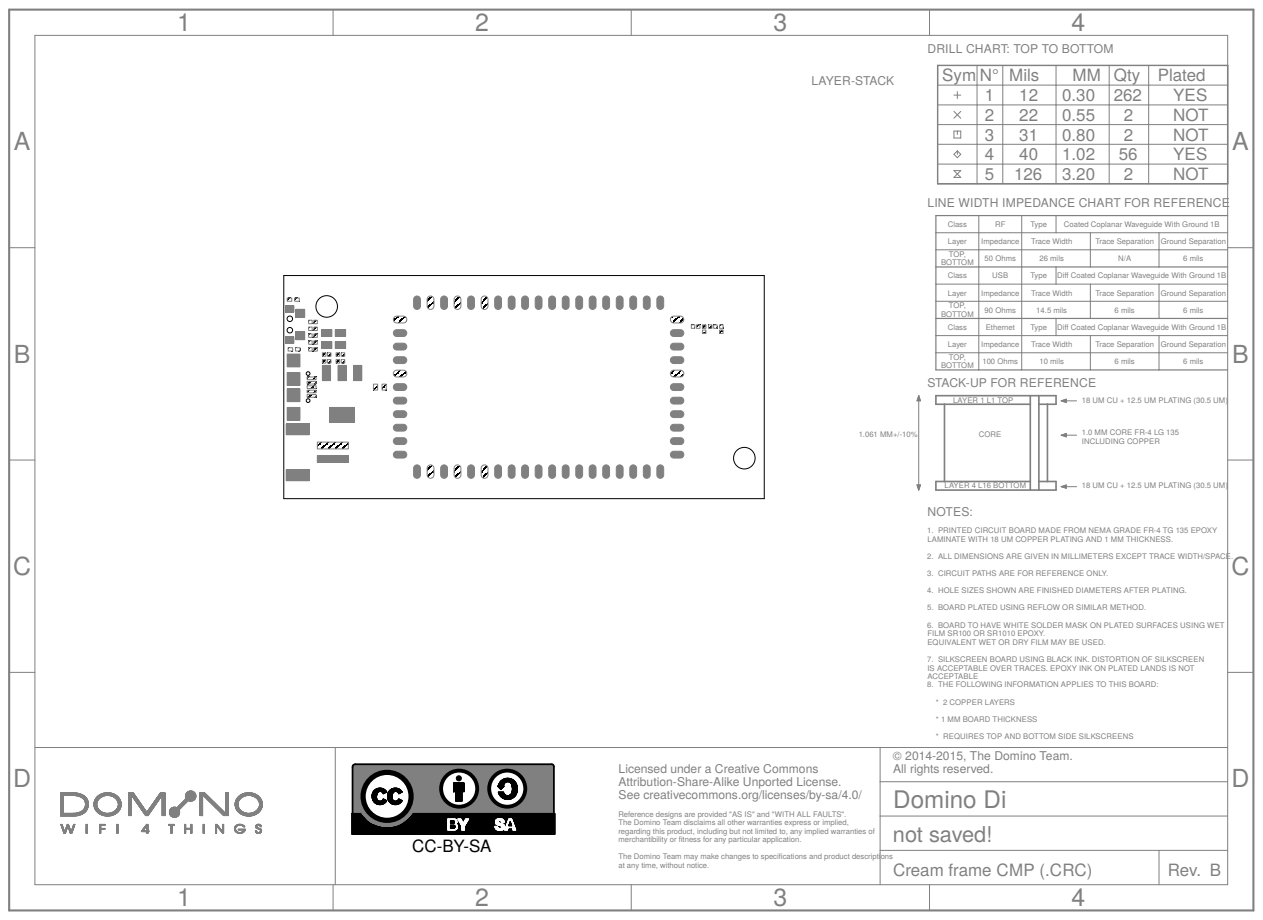
[picture p17: page 8]
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

LINE WIDTH IMPEDANCE CHART FOR REFERENCE

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

Coated Coplanar Waveguide With Ground 1B

1.061 MM+/-10% STACK-UP FOR REFERENCE

18 UM CU + 12.5 UM PLATING (30.5 UM)

1.0 MM CORE FR-4 LG 135
INCLUDING COPPER

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

1. PRINTED CIRCUIT BOARD MADE FROM NEMA GRADE FR-4 TG 135 EPOXY
LAMINATE WITH 18 UM COPPER PLATING AND 1 MM THICKNESS.

4. HOLE SIZES SHOWN ARE FINISHED DIAMETERS AFTER PLATING. 5. BOARD PLATED USING REFLOW OR SIMILAR METHOD. 6. BOARD TO HAVE WHITE SOLDER MASK ON PLATED SURFACES USING WET

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

IS ACCEPTABLE OVER TRACES. EPOXY INK ON PLATED LANDS IS NOT ACCEPTABLE

* 2 COPPER LAYERS
* 1 MM BOARD THICKNESS
* REQUIRES TOP AND BOTTOM SIDE SILKSCREENS
© 2014-2015, The Domino Team. All rights reserved.
Domino Di
not saved!
Cream frame CMP (.CRC)

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

## DRILL CHART: TOP TO BOTTOM

A

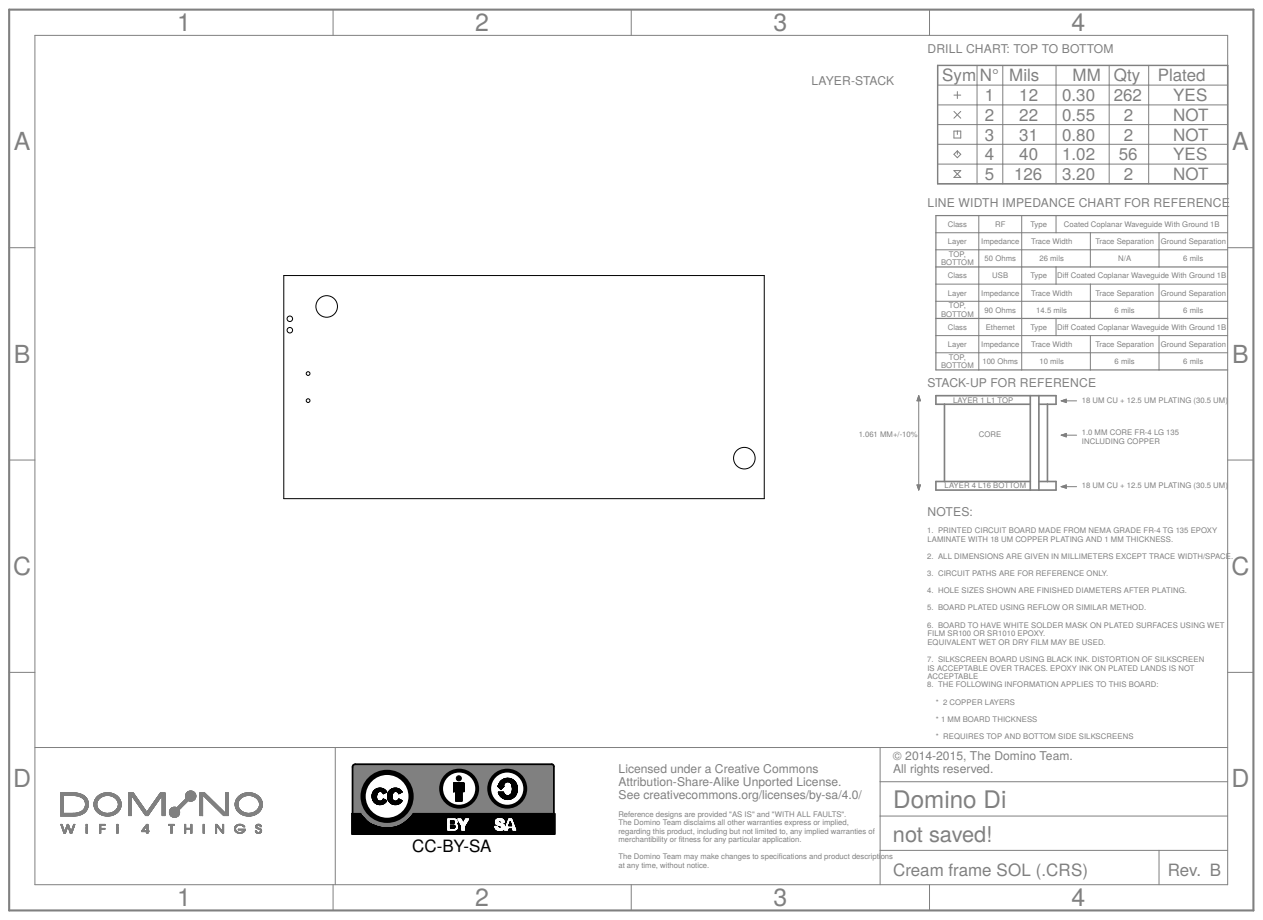
[picture p18: page 9]
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

LINE WIDTH IMPEDANCE CHART FOR REFERENCE

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

Coated Coplanar Waveguide With Ground 1B

1.061 MM+/-10% STACK-UP FOR REFERENCE

18 UM CU + 12.5 UM PLATING (30.5 UM)

1.0 MM CORE FR-4 LG 135
INCLUDING COPPER

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

1. PRINTED CIRCUIT BOARD MADE FROM NEMA GRADE FR-4 TG 135 EPOXY
LAMINATE WITH 18 UM COPPER PLATING AND 1 MM THICKNESS.

4. HOLE SIZES SHOWN ARE FINISHED DIAMETERS AFTER PLATING. 5. BOARD PLATED USING REFLOW OR SIMILAR METHOD. 6. BOARD TO HAVE WHITE SOLDER MASK ON PLATED SURFACES USING WET

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

IS ACCEPTABLE OVER TRACES. EPOXY INK ON PLATED LANDS IS NOT ACCEPTABLE

* 2 COPPER LAYERS
* 1 MM BOARD THICKNESS
* REQUIRES TOP AND BOTTOM SIDE SILKSCREENS
© 2014-2015, The Domino Team. All rights reserved.
Domino Di
not saved!
Cream frame SOL (.CRS)

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

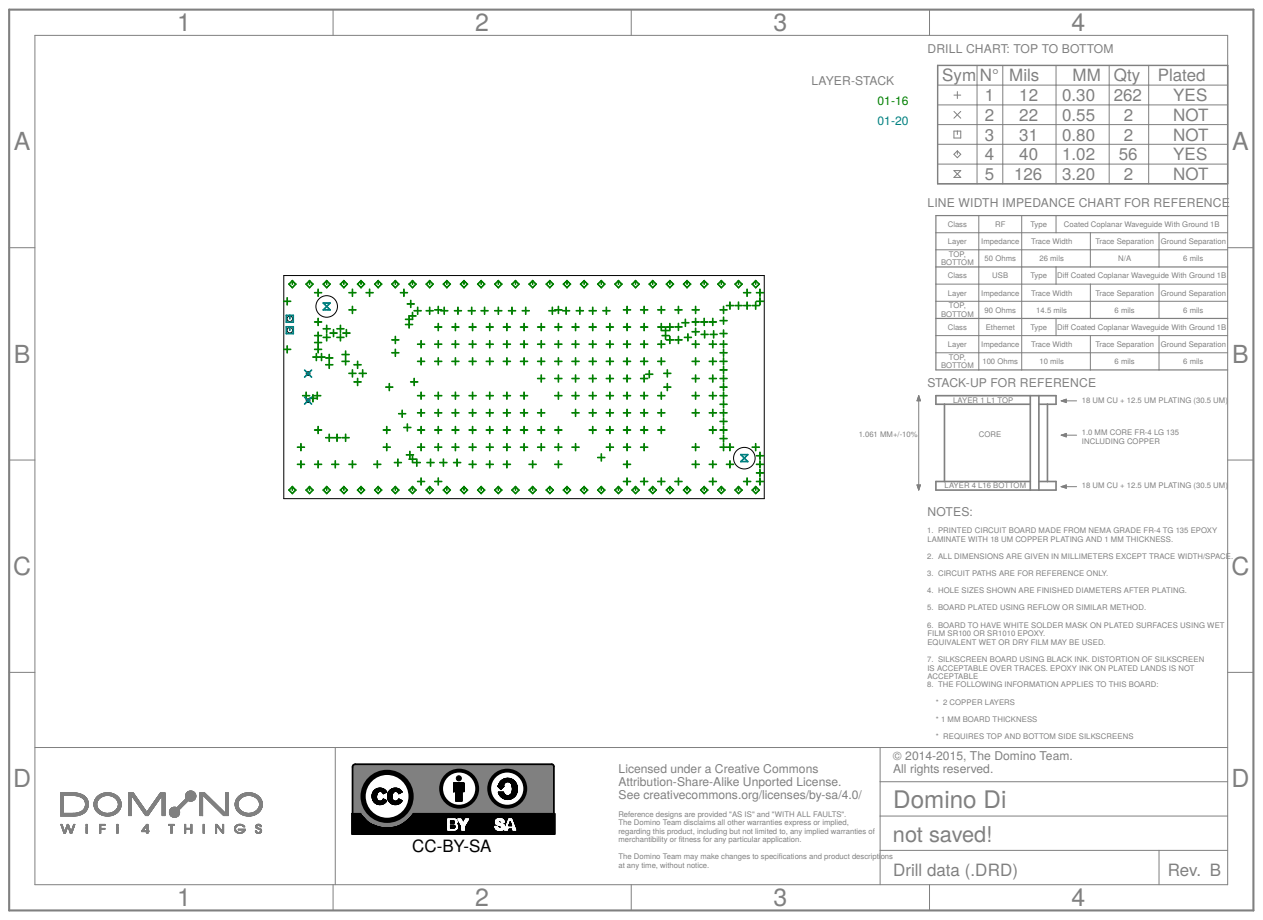
[picture p19: page 10]
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

## DRILL CHART: TOP TO BOTTOM

A

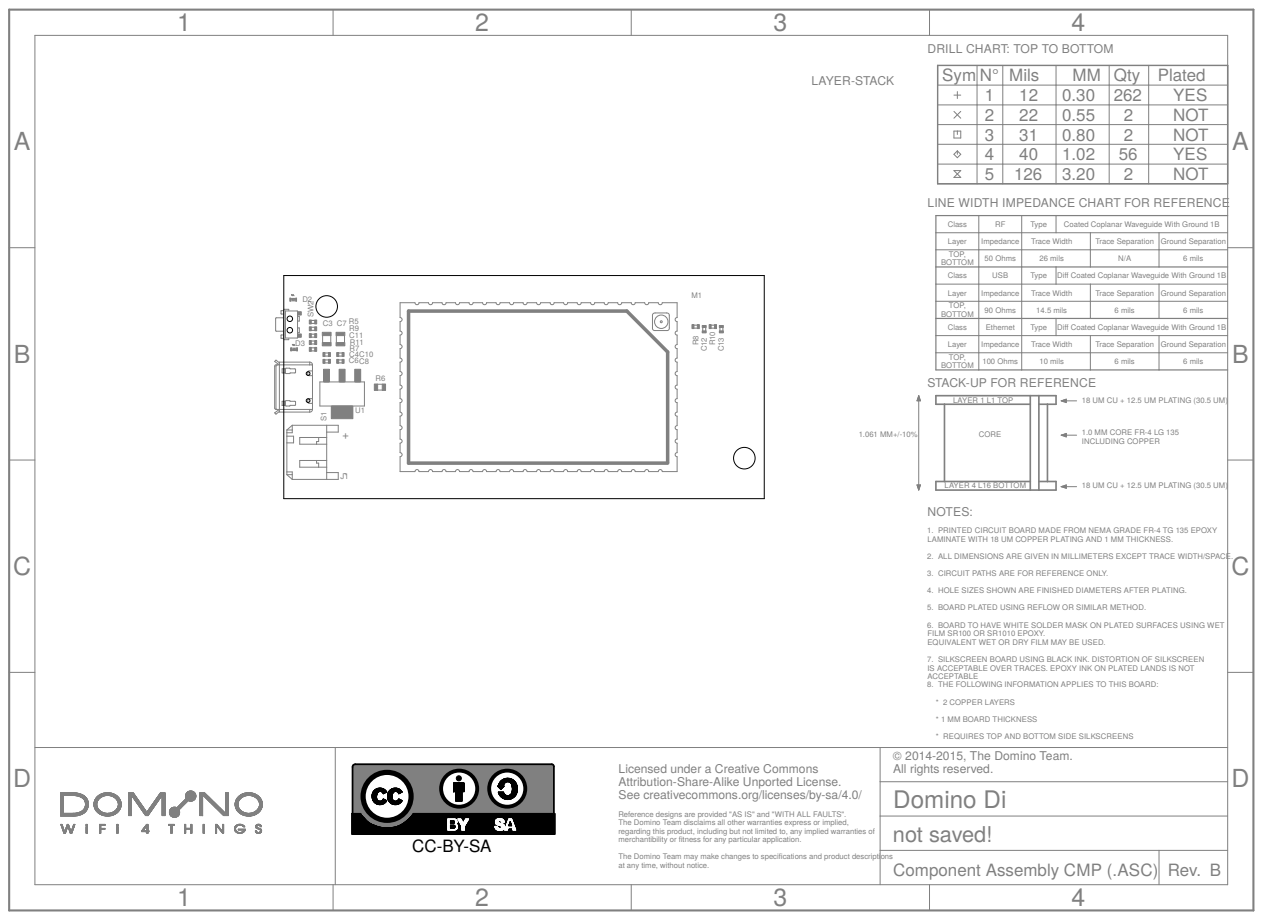
[picture p20: page 11]

LINE WIDTH IMPEDANCE CHART FOR REFERENCE

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

Coated Coplanar Waveguide With Ground 1B

1.061 MM+/-10% STACK-UP FOR REFERENCE

18 UM CU + 12.5 UM PLATING (30.5 UM)

1.0 MM CORE FR-4 LG 135
INCLUDING COPPER

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

1. PRINTED CIRCUIT BOARD MADE FROM NEMA GRADE FR-4 TG 135 EPOXY
LAMINATE WITH 18 UM COPPER PLATING AND 1 MM THICKNESS.

4. HOLE SIZES SHOWN ARE FINISHED DIAMETERS AFTER PLATING. 5. BOARD PLATED USING REFLOW OR SIMILAR METHOD. 6. BOARD TO HAVE WHITE SOLDER MASK ON PLATED SURFACES USING WET

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

IS ACCEPTABLE OVER TRACES. EPOXY INK ON PLATED LANDS IS NOT ACCEPTABLE

* 2 COPPER LAYERS
* 1 MM BOARD THICKNESS
* REQUIRES TOP AND BOTTOM SIDE SILKSCREENS
© 2014-2015, The Domino Team. All rights reserved.
Domino Di
not saved!
Component Assembly CMP (.ASC)

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

## DRILL CHART: TOP TO BOTTOM

A

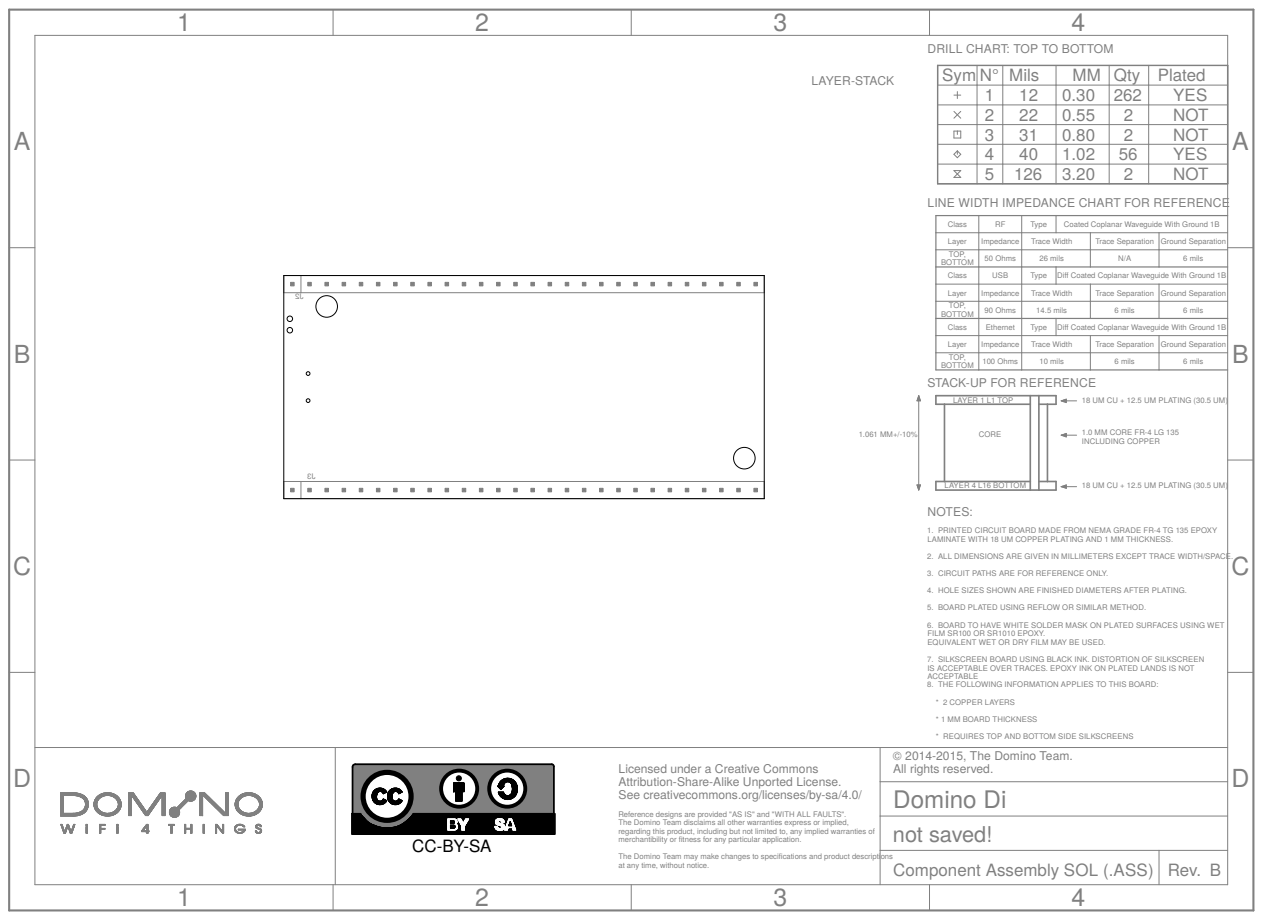
[picture p21: page 12]
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

LINE WIDTH IMPEDANCE CHART FOR REFERENCE

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

Coated Coplanar Waveguide With Ground 1B

1.061 MM+/-10% STACK-UP FOR REFERENCE

18 UM CU + 12.5 UM PLATING (30.5 UM)

1.0 MM CORE FR-4 LG 135
INCLUDING COPPER

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

1. PRINTED CIRCUIT BOARD MADE FROM NEMA GRADE FR-4 TG 135 EPOXY
LAMINATE WITH 18 UM COPPER PLATING AND 1 MM THICKNESS.

4. HOLE SIZES SHOWN ARE FINISHED DIAMETERS AFTER PLATING. 5. BOARD PLATED USING REFLOW OR SIMILAR METHOD. 6. BOARD TO HAVE WHITE SOLDER MASK ON PLATED SURFACES USING WET

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

IS ACCEPTABLE OVER TRACES. EPOXY INK ON PLATED LANDS IS NOT ACCEPTABLE

* 2 COPPER LAYERS
* 1 MM BOARD THICKNESS
* REQUIRES TOP AND BOTTOM SIDE SILKSCREENS
© 2014-2015, The Domino Team. All rights reserved.
Domino Di
not saved!
Component Assembly SOL (.ASS)

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

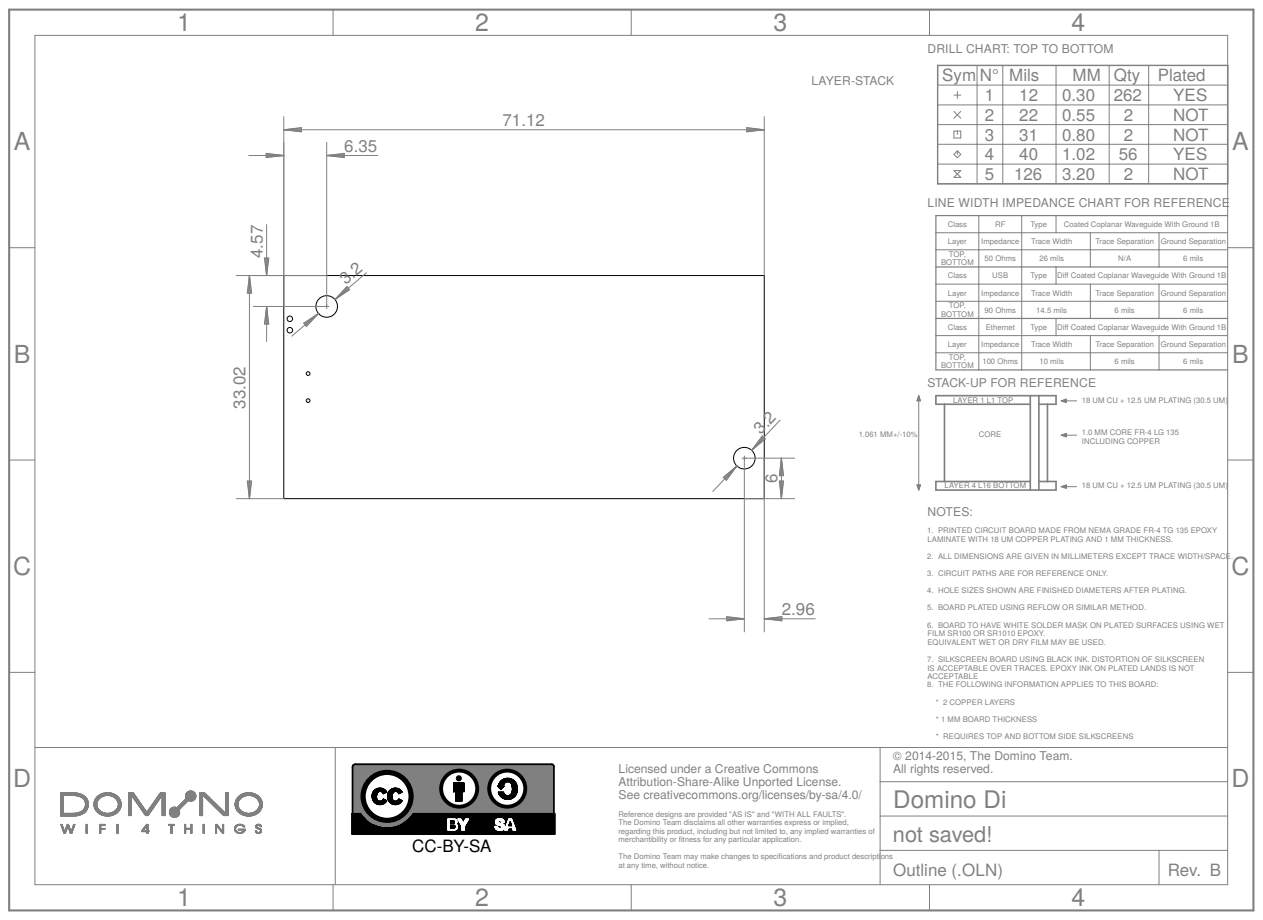
[picture p22: page 13]
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

## DRILL CHART: TOP TO BOTTOM

A

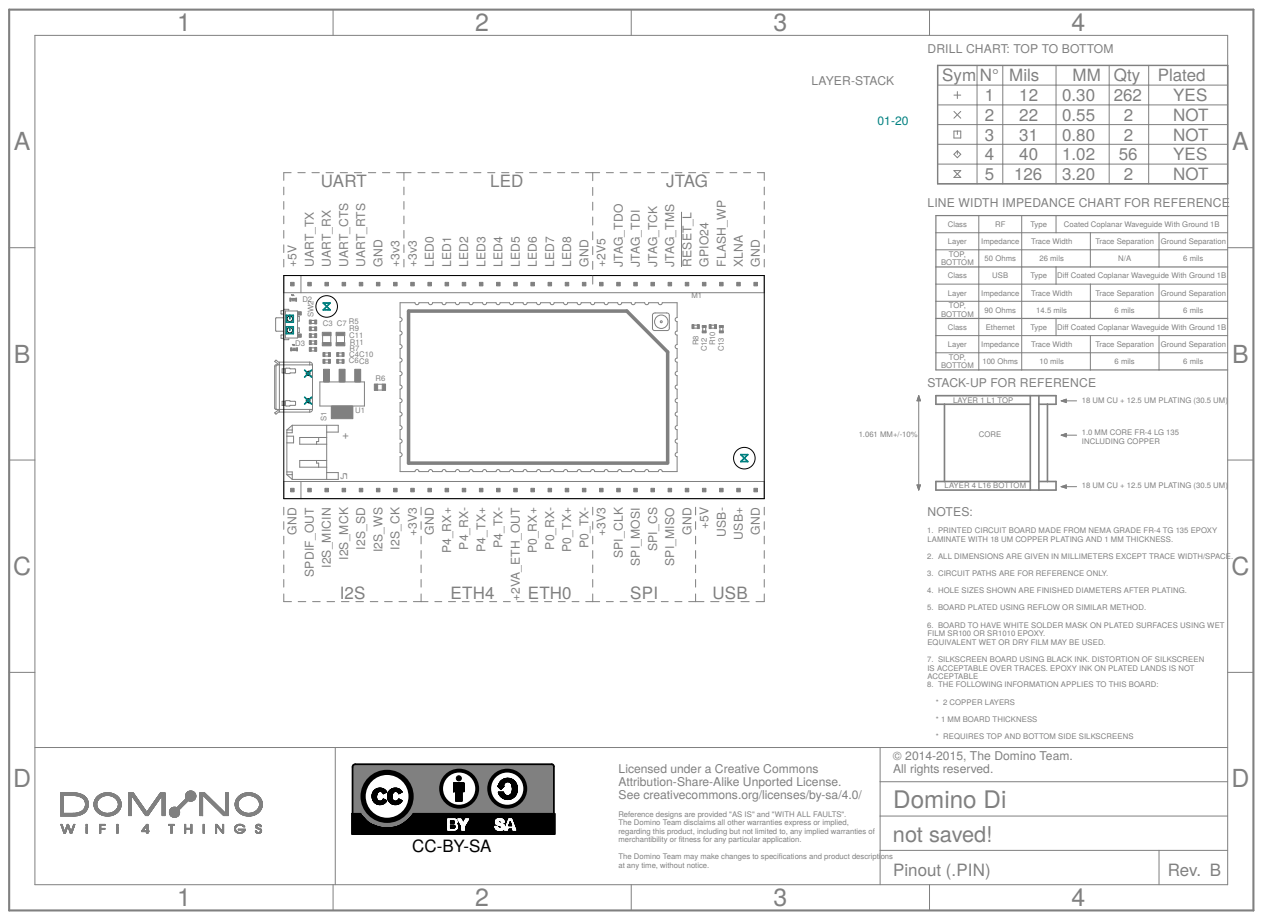
[picture p23: page 14]

LINE WIDTH IMPEDANCE CHART FOR REFERENCE

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

Coated Coplanar Waveguide With Ground 1B

1.061 MM+/-10% STACK-UP FOR REFERENCE

18 UM CU + 12.5 UM PLATING (30.5 UM)

1.0 MM CORE FR-4 LG 135
INCLUDING COPPER

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

1. PRINTED CIRCUIT BOARD MADE FROM NEMA GRADE FR-4 TG 135 EPOXY
LAMINATE WITH 18 UM COPPER PLATING AND 1 MM THICKNESS.

4. HOLE SIZES SHOWN ARE FINISHED DIAMETERS AFTER PLATING. 5. BOARD PLATED USING REFLOW OR SIMILAR METHOD. 6. BOARD TO HAVE WHITE SOLDER MASK ON PLATED SURFACES USING WET

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

IS ACCEPTABLE OVER TRACES. EPOXY INK ON PLATED LANDS IS NOT ACCEPTABLE

* 2 COPPER LAYERS
* 1 MM BOARD THICKNESS
* REQUIRES TOP AND BOTTOM SIDE SILKSCREENS
© 2014-2015, The Domino Team. All rights reserved.
Domino Di
not saved!
Pinout (.PIN)

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

# Domino Di Rev. B

Item Qty | Value | Manufacturer | Device | Package | Reference | Description | Remarks
1 | 1 ANY | 2n2 | C1210_2n2_X7R_10%_CER_2kV | C1206 | C1 | CAP CER 2200PF 1KV 10% X7R 1210
2 | 5 ANY | 100n | C0402_100n_X7R_10%_CER_50V | C0402 | C2, C3, C4, C5, C6 | CAP CER 0.1UF 50V 10% X7R 0402
3 | 1 ANY | BLUE | LED0603-BLUE | LED0603 | D1 | LED BLUE CLEAR 0603 SMD
4 | 1 ANY | WHITE | LED0603-WHITE | LED0603 | D2 | LED WHITE CLEAR 0603 SMD
5 | 4 ANY | GREEN | LED0603-GREEN | LED0603 | D3, D4, D5, D6 | LED GREEN CLEAR 0603 SMD
6 | 1 ANY | RED | LED0603-ORANGE | LED0603 | D7 | LED ORANGE CLEAR 0603 SMD
7 | 1 ANY | ORANGE | LED0603-ORANGE | LED0603 | D8 | LED ORANGE CLEAR 0603 SMD
8 | 1 ANY | YELLOW | LED0603-YELLOW | LED0603 | D9 | LED YELLOW CLEAR 0603 SMD
9 | 1 SHEZHEN HUILY ELECTHBJ-2H101NLF | HBJ-2H101NLF | HBJ-2H101NLF | J1 | CONN MAGJACK 2PORT 100 BASE-T
10 | 1 ANY | MH3-1 | MH3-1-0.1 | MH3-1-0.1 | J2 | CONN HEADER VERT .100 1ROW 3POS 8.08 HEAD 3.05 TAIL 15AU
11 | 2 ANY | MH18-1 | MH18-1-0.1 | MH18-1-0.1 | J3, J4 | CONN HEADER VERT .100 1ROW 18POS 8.08 HEAD 3.05 TAIL 15AU
12 | 1 ANY | 4k7 | R0402_4k7_5%_62.5mW | R0402 | R1 | RES 4.7K OHM 1/16W 5% 0402 SMD
13 | 6 ANY | 270R | R0603_270R_5%_125mW | R0603 | R12, R13, R14, R15, R16, R17 | RES 270 OHM 1/8W 5% 0603 SMD
14 | 3 ANY | 330R | R0603_330R_5%_125mW | R0603 | R18, R19, R20 | RES 330 OHM 1/8W 5% 0603 SMD
15 | 1 ANY | 15k | R0402_15k_5%_62.5mW | R0402 | R2 | RES 15K OHM 1/16W 5% 0402 SMD
16 | 1 ANY | 220R | R0402_220R_5%_62.5mW | R0402 | R3 | RES 220 OHM 1/16W 5% 0402 SMD
17 | 8 ANY | 49R9 | R0402_49R9_1%_62.5mW | R0402 | R4, R5, R6, R7, R8, R9, R10, R11 | RES 49.9 OHM 1/16W 1% 0402 SMD
