domino-team/domino-hardware/Domino Qi Mini/PDF/Domino Qi Mini.pdf

# Power Supply

# POWER Bridge

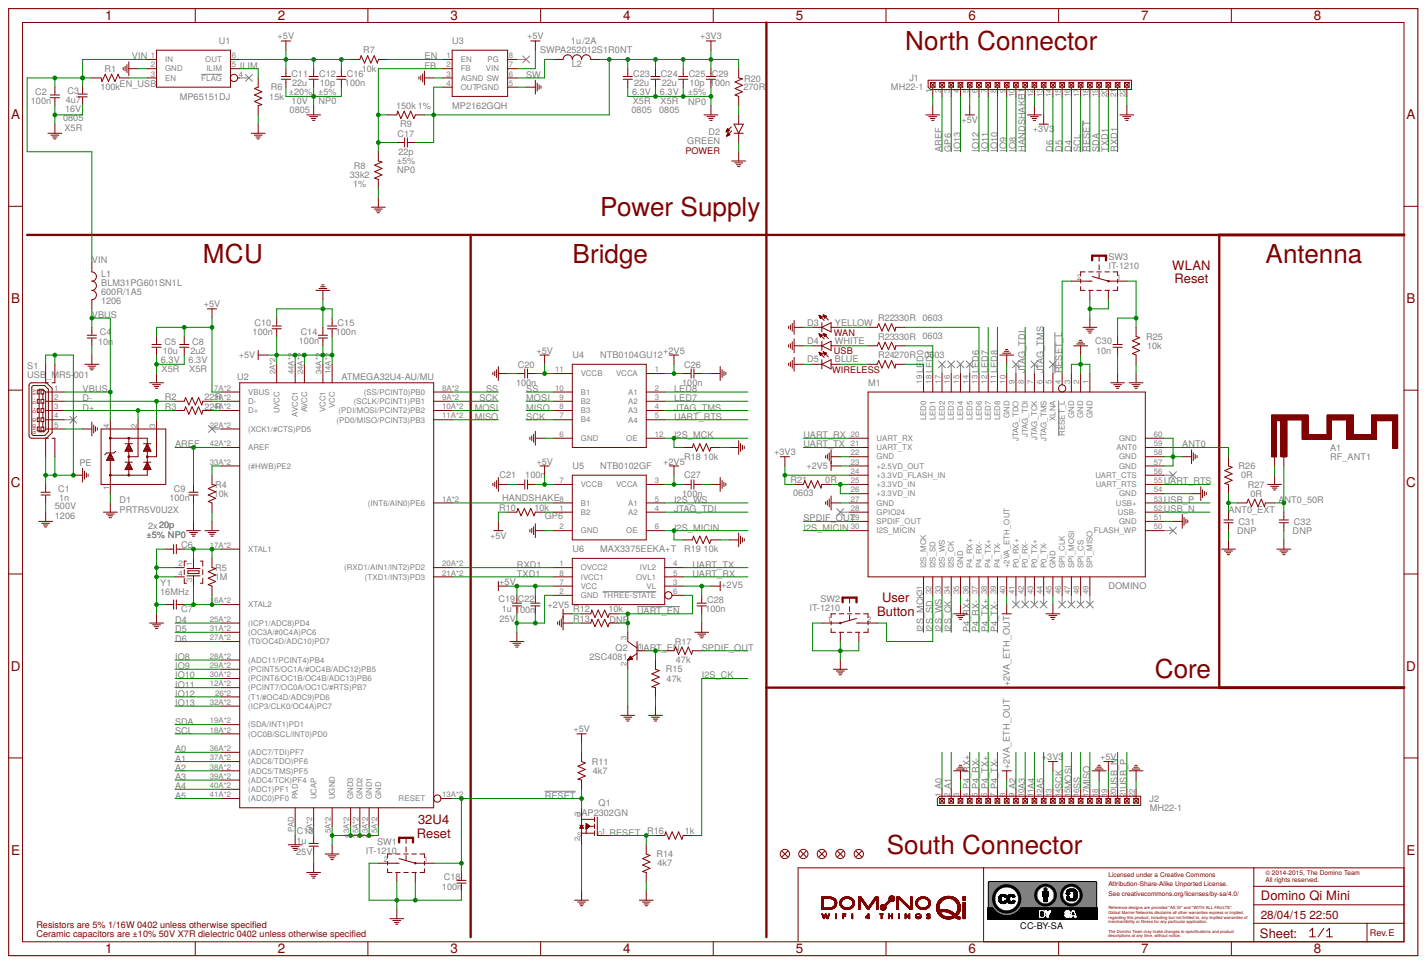
[picture p24: page 1]

+5V +5V +3V3 | North Connector MH22-1

Licensed under a Creative Commons Attribution-Share-Alike Unported License. See creativecommons.org/licenses/by-sa/4.0/ Reference designs are provided "AS IS" and "WITH ALL FAULTS". regarding this product, including but not limited to, any implied warranties of The Domino Team may make changes to specifications and product Global Marine Networks disclaims all other warranties express or implied, merchantibility or fitness for any particular application. descriptions at any time, without notice.

Ceramic capacitors are ±10% 50V X7R dielectric 0402 unless otherwise specified Resistors are 5% 1/16W 0402 unless otherwise specified

## DRILL CHART: TOP TO BOTTOM

A

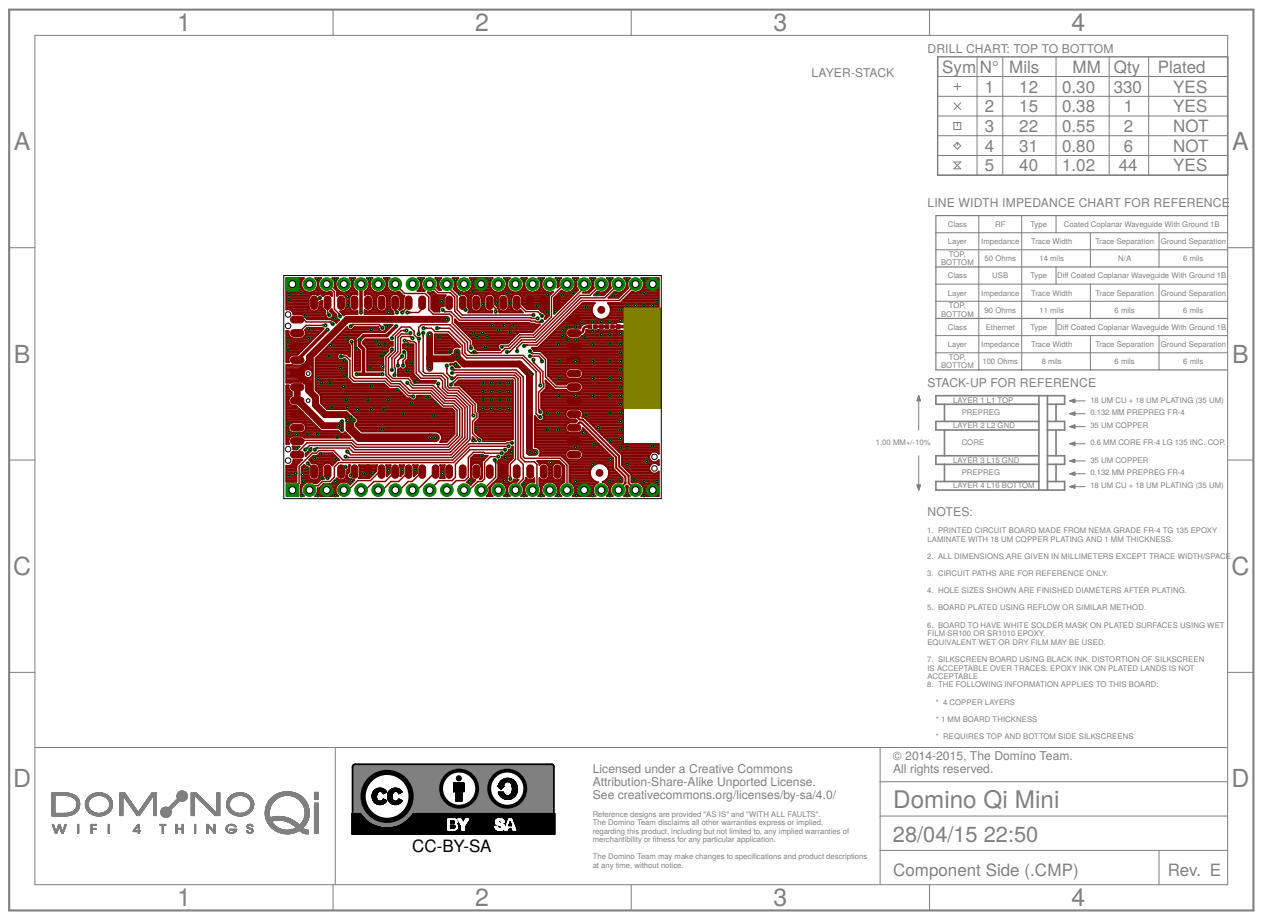
[picture p25: page 2]
Rev. E; Layer; Impedance; Trace Width; Trace Separation; Ground Separation TOP, BOTTOM; 90 Ohms; 11 mils; 6 mils; 6 mils Class; USB; Type; Diff Coated Coplanar Waveguide With Ground 1B; 100 Ohms; 8 mils; Ethernet; LAYER 1 L1 TOP; LAYER 2 L2 GND; LAYER 3 L15 GND; LAYER 4 L16 BOTTOM; PREPREG; CORE; 0.6 MM CORE FR-4 LG 135 INC. COP. STACK-UP FOR REFERENCE; LAYER-STACK; Sym N° Mils; MM Qty Plated; YES; NOT

LINE WIDTH IMPEDANCE CHART FOR REFERENCE

Layer | 50 Ohms RF Impedance | Type 14 mils Diff Coated Coplanar Waveguide With Ground 1B Trace Width | N/A Trace Separation | 6 mils Class Ground Separation TOP, BOTTOM

Coated Coplanar Waveguide With Ground 1B

18 UM CU + 18 UM PLATING (35 UM)
0.132 MM PREPREG FR-4
35 UM COPPER

NOTES: 2. ALL DIMENSIONS ARE GIVEN IN MILLIMETERS EXCEPT TRACE WIDTH/SPACE. 3. CIRCUIT PATHS ARE FOR REFERENCE ONLY.

1. PRINTED CIRCUIT BOARD MADE FROM NEMA GRADE FR-4 TG 135 EPOXY
LAMINATE WITH 18 UM COPPER PLATING AND 1 MM THICKNESS.

4. HOLE SIZES SHOWN ARE FINISHED DIAMETERS AFTER PLATING. 5. BOARD PLATED USING REFLOW OR SIMILAR METHOD. 6. BOARD TO HAVE WHITE SOLDER MASK ON PLATED SURFACES USING WET

FILM SR100 OR SR1010 EPOXY. EQUIVALENT WET OR DRY FILM MAY BE USED. 8. THE FOLLOWING INFORMATION APPLIES TO THIS BOARD: 7. SILKSCREEN BOARD USING BLACK INK. DISTORTION OF SILKSCREEN

IS ACCEPTABLE OVER TRACES. EPOXY INK ON PLATED LANDS IS NOT ACCEPTABLE

* 4 COPPER LAYERS
* 1 MM BOARD THICKNESS
* REQUIRES TOP AND BOTTOM SIDE SILKSCREENS
© 2014-2015, The Domino Team. All rights reserved.
Domino Qi Mini
Component Side (.CMP)

Licensed under a Creative Commons Attribution-Share-Alike Unported License. See creativecommons.org/licenses/by-sa/4.0/ Reference designs are provided "AS IS" and "WITH ALL FAULTS". The Domino Team disclaims all other warranties express or implied, regarding this product, including but not limited to, any implied warranties of merchantibility or fitness for any particular application. The Domino Team may make changes to specifications and product descriptions at any time, without notice.

## DRILL CHART: TOP TO BOTTOM

A

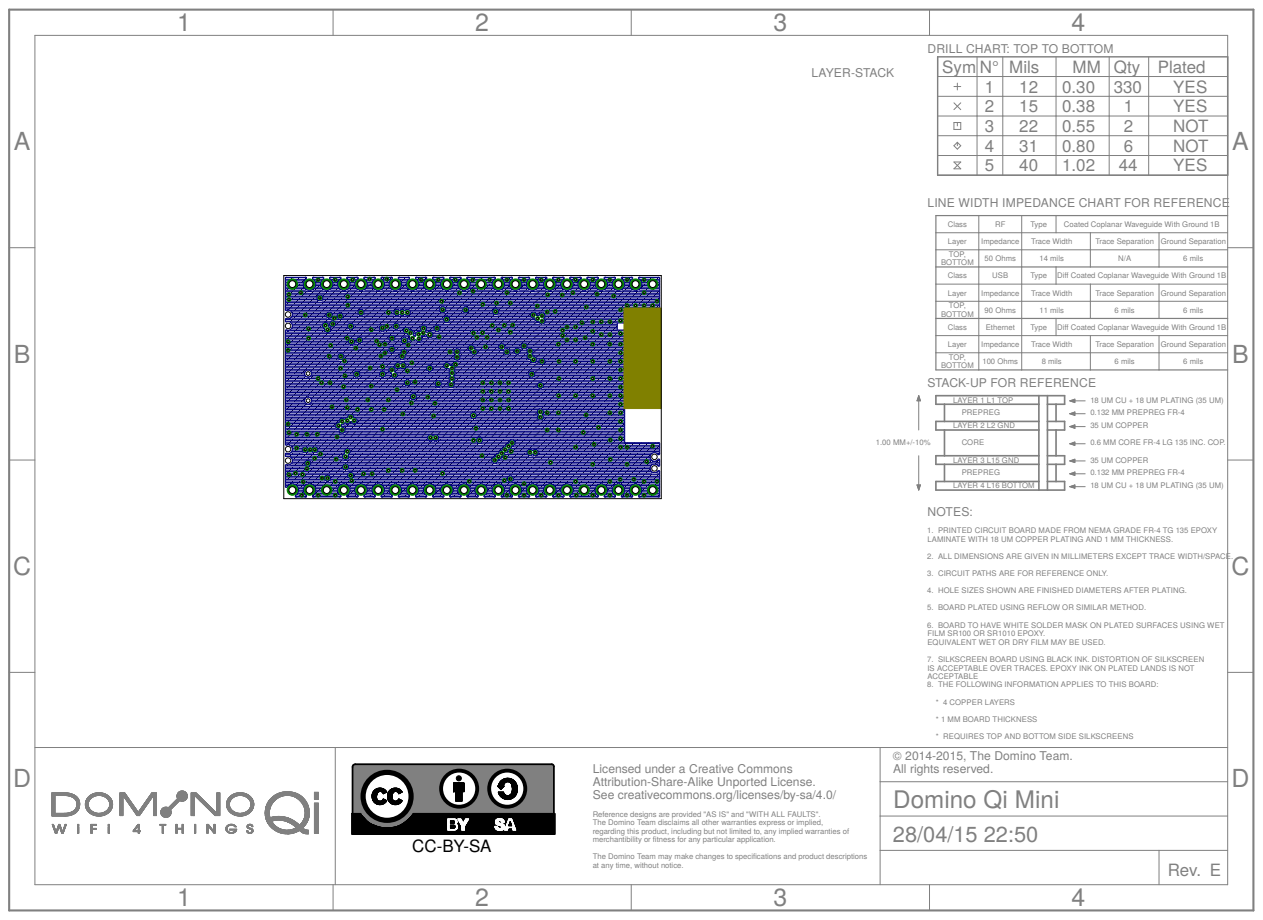
[picture p26: page 3]
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

LINE WIDTH IMPEDANCE CHART FOR REFERENCE

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

Coated Coplanar Waveguide With Ground 1B

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

1. PRINTED CIRCUIT BOARD MADE FROM NEMA GRADE FR-4 TG 135 EPOXY
LAMINATE WITH 18 UM COPPER PLATING AND 1 MM THICKNESS.

4. HOLE SIZES SHOWN ARE FINISHED DIAMETERS AFTER PLATING. 5. BOARD PLATED USING REFLOW OR SIMILAR METHOD. 6. BOARD TO HAVE WHITE SOLDER MASK ON PLATED SURFACES USING WET

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

IS ACCEPTABLE OVER TRACES. EPOXY INK ON PLATED LANDS IS NOT ACCEPTABLE

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

## DRILL CHART: TOP TO BOTTOM

A

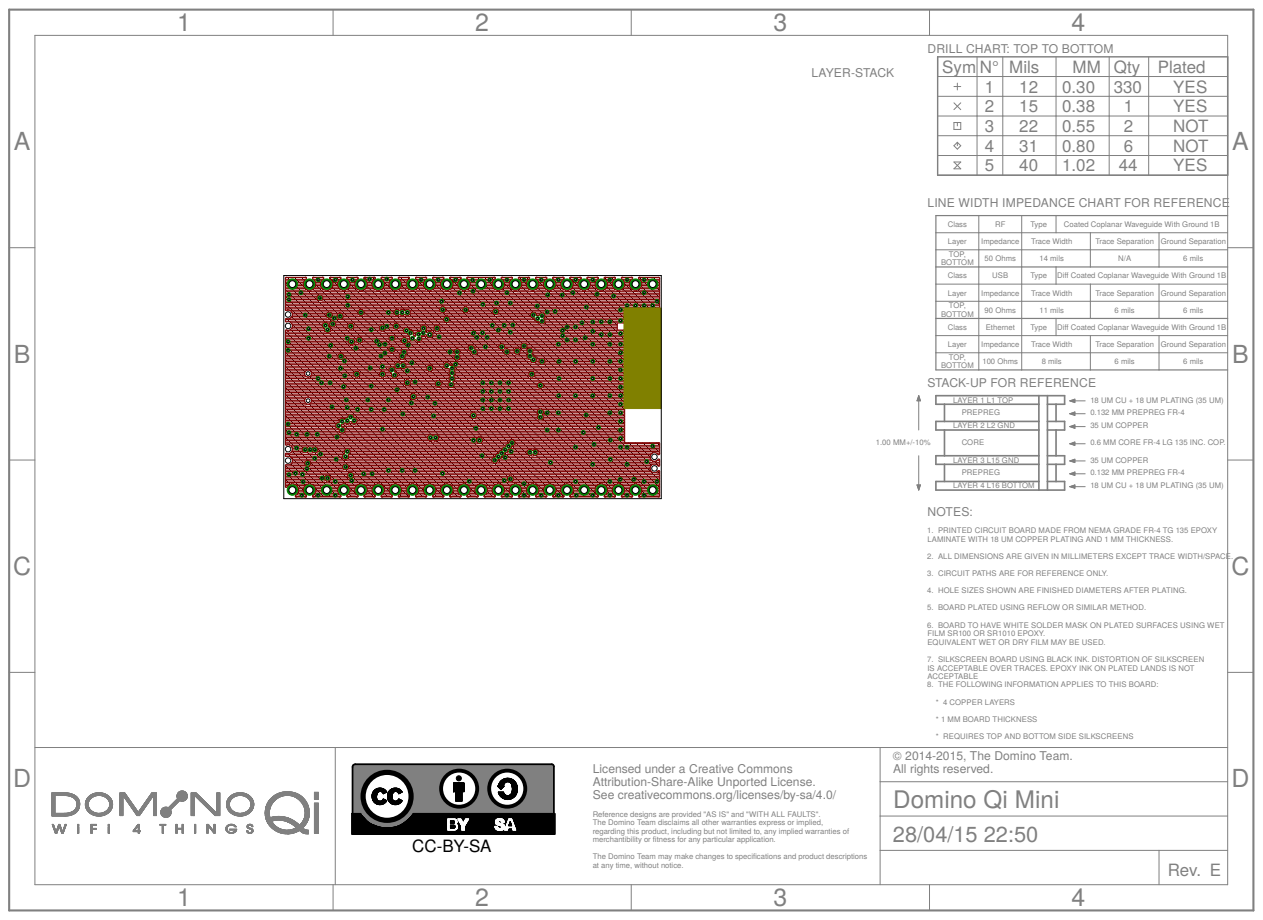
[picture p27: page 4]
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

LINE WIDTH IMPEDANCE CHART FOR REFERENCE

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

Coated Coplanar Waveguide With Ground 1B

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

1. PRINTED CIRCUIT BOARD MADE FROM NEMA GRADE FR-4 TG 135 EPOXY
LAMINATE WITH 18 UM COPPER PLATING AND 1 MM THICKNESS.

4. HOLE SIZES SHOWN ARE FINISHED DIAMETERS AFTER PLATING. 5. BOARD PLATED USING REFLOW OR SIMILAR METHOD. 6. BOARD TO HAVE WHITE SOLDER MASK ON PLATED SURFACES USING WET

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

IS ACCEPTABLE OVER TRACES. EPOXY INK ON PLATED LANDS IS NOT ACCEPTABLE

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

## DRILL CHART: TOP TO BOTTOM

A

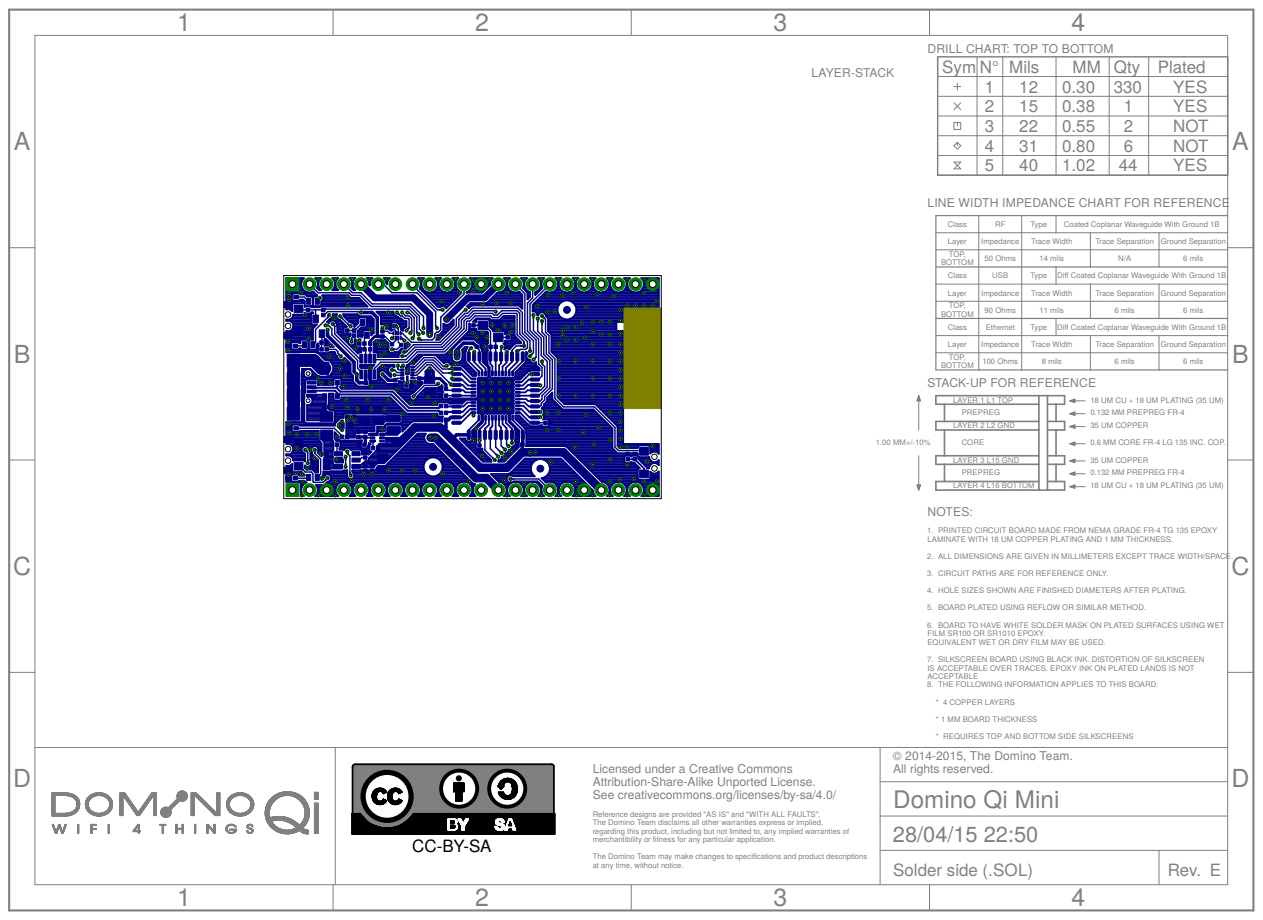
[picture p28: page 5]
Rev. E; Layer; Impedance; Trace Width; Trace Separation; Ground Separation TOP, BOTTOM; 50 Ohms; 14 mils; 6 mils Class; Type; Diff Coated Coplanar Waveguide With Ground 1B; 90 Ohms; 11 mils; 6 mils; USB; 100 Ohms; 8 mils; Ethernet; LAYER 1 L1 TOP; LAYER 2 L2 GND; LAYER 3 L15 GND; LAYER 4 L16 BOTTOM; PREPREG; CORE; 0.6 MM CORE FR-4 LG 135 INC. COP. STACK-UP FOR REFERENCE; LAYER-STACK; Sym N° Mils; MM Qty Plated; YES; NOT

LINE WIDTH IMPEDANCE CHART FOR REFERENCE

Coated Coplanar Waveguide With Ground 1B

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

1. PRINTED CIRCUIT BOARD MADE FROM NEMA GRADE FR-4 TG 135 EPOXY
LAMINATE WITH 18 UM COPPER PLATING AND 1 MM THICKNESS.

4. HOLE SIZES SHOWN ARE FINISHED DIAMETERS AFTER PLATING. 5. BOARD PLATED USING REFLOW OR SIMILAR METHOD. 6. BOARD TO HAVE WHITE SOLDER MASK ON PLATED SURFACES USING WET

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

IS ACCEPTABLE OVER TRACES. EPOXY INK ON PLATED LANDS IS NOT ACCEPTABLE

* 4 COPPER LAYERS
* 1 MM BOARD THICKNESS
* REQUIRES TOP AND BOTTOM SIDE SILKSCREENS
© 2014-2015, The Domino Team. All rights reserved.
Domino Qi Mini
Solder side (.SOL)

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

Rev. 20150428 E R26 R27 C31 C32 M1 J2J1 Licensed under a Creative Commons Attribution-Share-Alike Unported License. See creativecommons.org/licenses/by-sa/4.0/ Reference designs are provided "AS IS" and "WITH ALL FAULTS". The Domino Team disclaims all other warranties express or implied, regarding this product, including but not limited to, any implied warranties of merchantibility or fitness for any particular application. The Domino Team may make changes to specifications and product descriptions at any time, without notice. © 2014-2015, The Domino Team. All rights reserved. NOTES: 2. ALL DIMENSIONS ARE GIVEN IN MILLIMETERS EXCEPT TRACE WIDTH/SPACE. 3. CIRCUIT PATHS ARE FOR REFERENCE ONLY. * 4 COPPER LAYERS * 1 MM BOARD THICKNESS * REQUIRES TOP AND BOTTOM SIDE SILKSCREENS 4. HOLE SIZES SHOWN ARE FINISHED DIAMETERS AFTER PLATING. 5. BOARD PLATED USING REFLOW OR SIMILAR METHOD. 6. BOARD TO HAVE WHITE SOLDER MASK ON PLATED SURFACES USING WET FILM SR100 OR SR1010 EPOXY. EQUIVALENT WET OR DRY FILM MAY BE USED. 8. THE FOLLOWING INFORMATION APPLIES TO THIS BOARD: 7. SILKSCREEN BOARD USING BLACK INK. DISTORTION OF SILKSCREEN IS ACCEPTABLE OVER TRACES. EPOXY INK ON PLATED LANDS IS NOT ACCEPTABLE 1. PRINTED CIRCUIT BOARD MADE FROM NEMA GRADE FR-4 TG 135 EPOXY LAMINATE WITH 18 UM COPPER PLATING AND 1 MM THICKNESS.Rev. E DRILL CHART: TOP TO BOTTOM LINE WIDTH IMPEDANCE CHART FOR REFERENCE Coated Coplanar Waveguide With Ground 1B Layer Impedance Trace Width Trace Separation Ground Separation TOP, BOTTOM 50 Ohms 14 mils N/A 6 mils Class RF Type Diff Coated Coplanar Waveguide With Ground 1B Layer Impedance Trace Width Trace Separation Ground Separation TOP, BOTTOM 90 Ohms 11 mils 6 mils 6 mils Class USB Type Diff Coated Coplanar Waveguide With Ground 1B Layer Impedance Trace Width Trace Separation Ground Separation TOP, BOTTOM 100 Ohms 8 mils 6 mils 6 mils Class Ethernet Type LAYER 1 L1 TOP LAYER 2 L2 GND LAYER 3 L15 GND LAYER 4 L16 BOTTOM PREPREG PREPREG CORE 18 UM CU + 18 UM PLATING (35 UM) 18 UM CU + 18 UM PLATING (35 UM) 35 UM COPPER 35 UM COPPER 0.132 MM PREPREG FR-4 0.132 MM PREPREG FR-4 1.00 MM+/-10% 0.6 MM CORE FR-4 LG 135 INC. COP. STACK-UP FOR REFERENCE Domino Qi Mini 28/04/15 22:50 ABCD 1 2 3 4 ABCD 1 2 3 4 CC-BY-SA LAYER-STACK Sym N° Mils MM Qty Plated 1 12 0.30 330 YES 2 15 0.38 1 YES 3 22 0.55 2 NOT 4 31 0.80 6 NOT 5 40 1.02 44 YES Silk screen CMP (.PLC)

## DRILL CHART: TOP TO BOTTOM

A

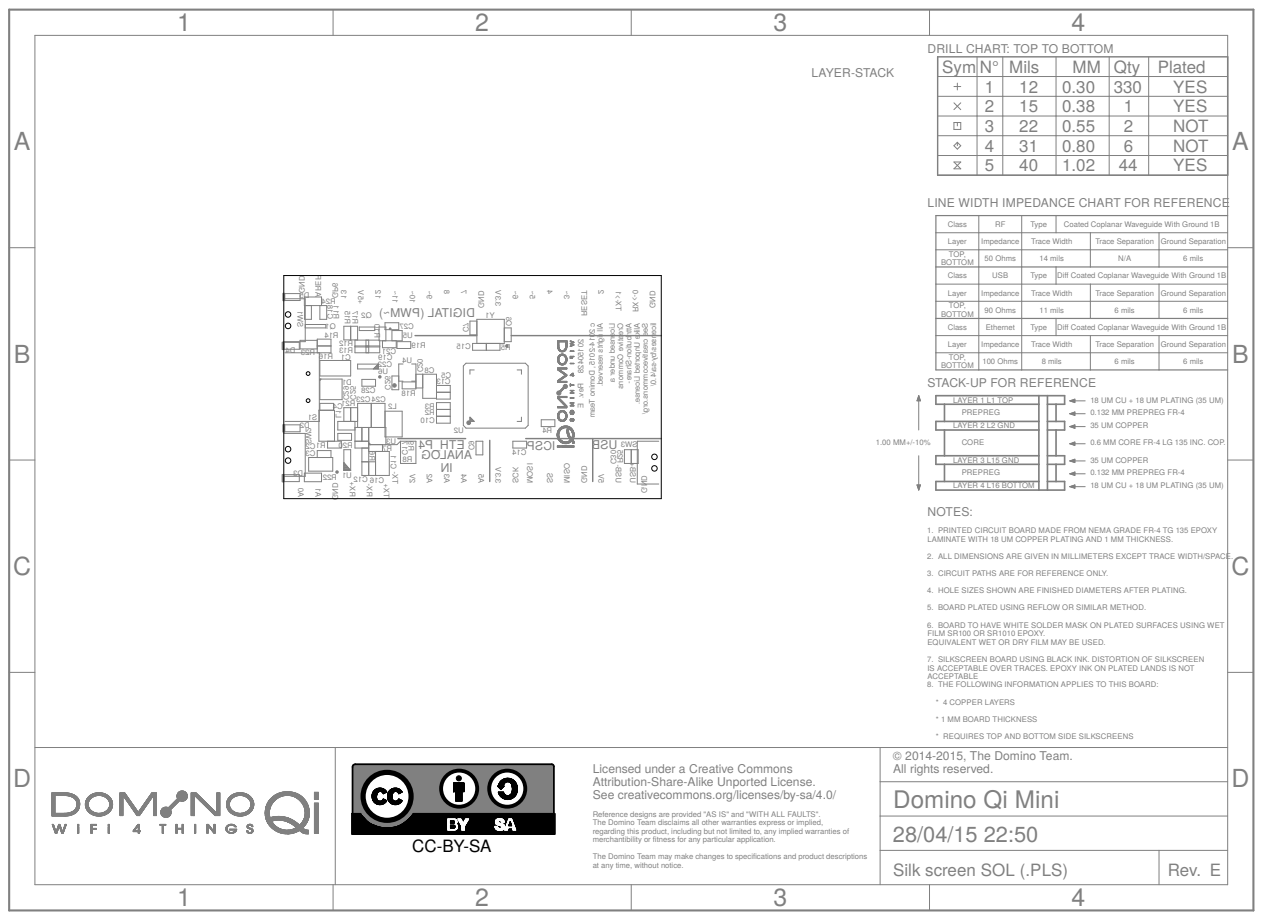
[picture p29: page 7]

LINE WIDTH IMPEDANCE CHART FOR REFERENCE

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

Coated Coplanar Waveguide With Ground 1B

All rights reserved. Licensed under a Creative Commons Attribution-Share- Alike Unported License. See creativecommons.org/

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

1. PRINTED CIRCUIT BOARD MADE FROM NEMA GRADE FR-4 TG 135 EPOXY
LAMINATE WITH 18 UM COPPER PLATING AND 1 MM THICKNESS.

4. HOLE SIZES SHOWN ARE FINISHED DIAMETERS AFTER PLATING. 5. BOARD PLATED USING REFLOW OR SIMILAR METHOD. 6. BOARD TO HAVE WHITE SOLDER MASK ON PLATED SURFACES USING WET

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

IS ACCEPTABLE OVER TRACES. EPOXY INK ON PLATED LANDS IS NOT ACCEPTABLE

* 4 COPPER LAYERS
* 1 MM BOARD THICKNESS
* REQUIRES TOP AND BOTTOM SIDE SILKSCREENS
© 2014-2015, The Domino Team. All rights reserved.
Domino Qi Mini
Silk screen SOL (.PLS)

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

## DRILL CHART: TOP TO BOTTOM

A

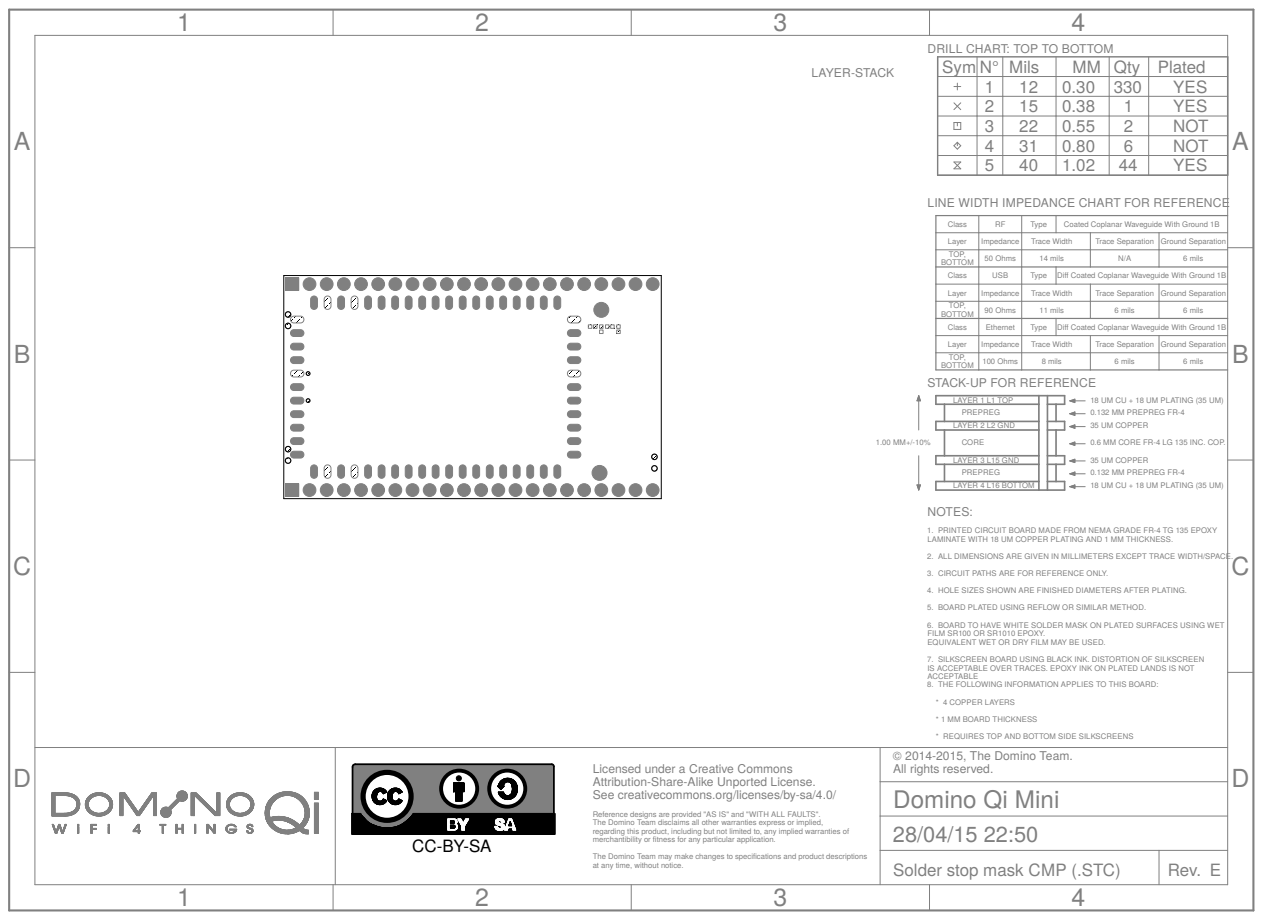
[picture p30: page 8]
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

LINE WIDTH IMPEDANCE CHART FOR REFERENCE

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

Coated Coplanar Waveguide With Ground 1B

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

1. PRINTED CIRCUIT BOARD MADE FROM NEMA GRADE FR-4 TG 135 EPOXY
LAMINATE WITH 18 UM COPPER PLATING AND 1 MM THICKNESS.

4. HOLE SIZES SHOWN ARE FINISHED DIAMETERS AFTER PLATING. 5. BOARD PLATED USING REFLOW OR SIMILAR METHOD. 6. BOARD TO HAVE WHITE SOLDER MASK ON PLATED SURFACES USING WET

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

IS ACCEPTABLE OVER TRACES. EPOXY INK ON PLATED LANDS IS NOT ACCEPTABLE

* 4 COPPER LAYERS
* 1 MM BOARD THICKNESS
* REQUIRES TOP AND BOTTOM SIDE SILKSCREENS
© 2014-2015, The Domino Team. All rights reserved.
Domino Qi Mini
Solder stop mask CMP (.STC)

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

## DRILL CHART: TOP TO BOTTOM

A

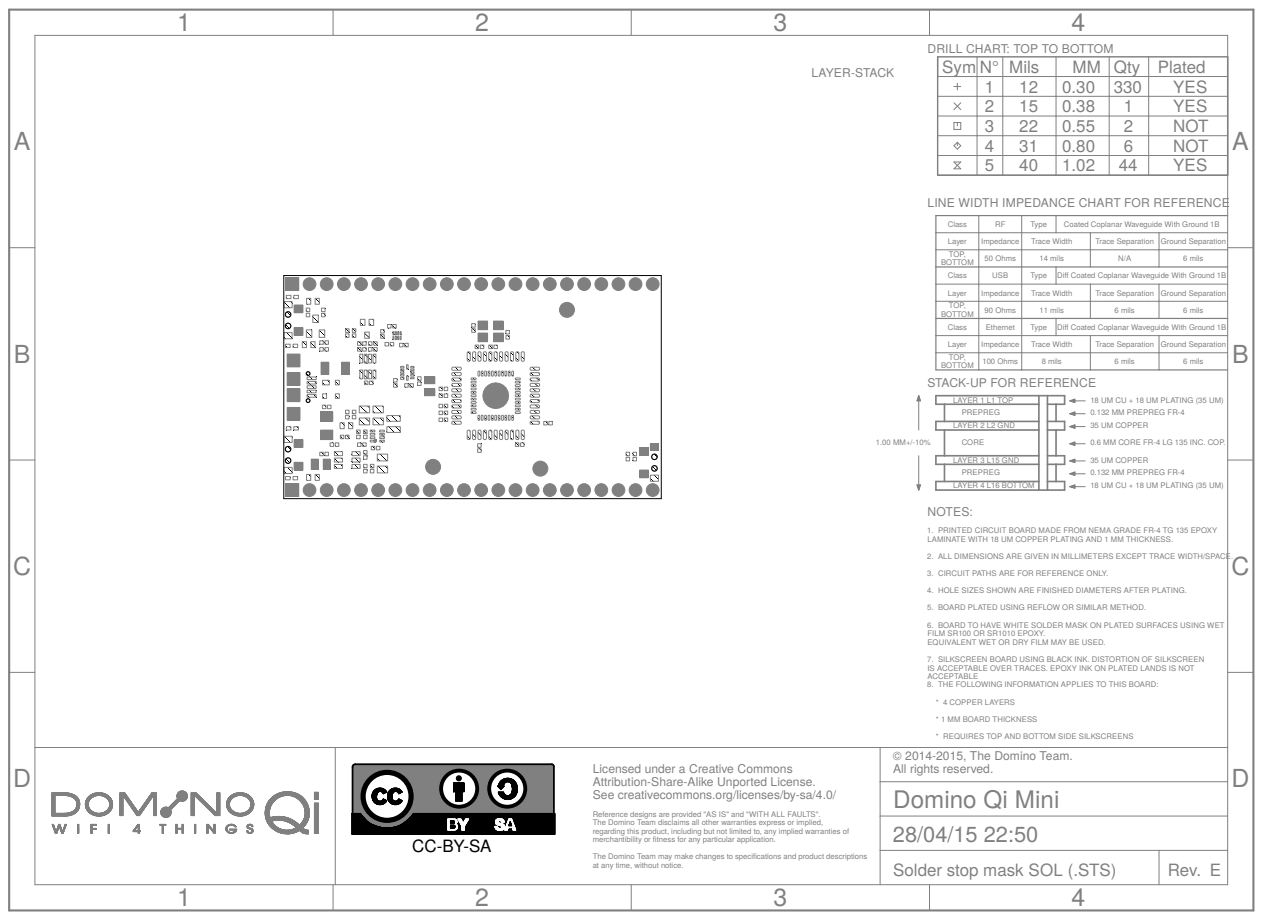
[picture p31: page 9]
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

LINE WIDTH IMPEDANCE CHART FOR REFERENCE

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

Coated Coplanar Waveguide With Ground 1B

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

1. PRINTED CIRCUIT BOARD MADE FROM NEMA GRADE FR-4 TG 135 EPOXY
LAMINATE WITH 18 UM COPPER PLATING AND 1 MM THICKNESS.

4. HOLE SIZES SHOWN ARE FINISHED DIAMETERS AFTER PLATING. 5. BOARD PLATED USING REFLOW OR SIMILAR METHOD. 6. BOARD TO HAVE WHITE SOLDER MASK ON PLATED SURFACES USING WET

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

IS ACCEPTABLE OVER TRACES. EPOXY INK ON PLATED LANDS IS NOT ACCEPTABLE

* 4 COPPER LAYERS
* 1 MM BOARD THICKNESS
* REQUIRES TOP AND BOTTOM SIDE SILKSCREENS
© 2014-2015, The Domino Team. All rights reserved.
Domino Qi Mini
Solder stop mask SOL (.STS)

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

## DRILL CHART: TOP TO BOTTOM

A

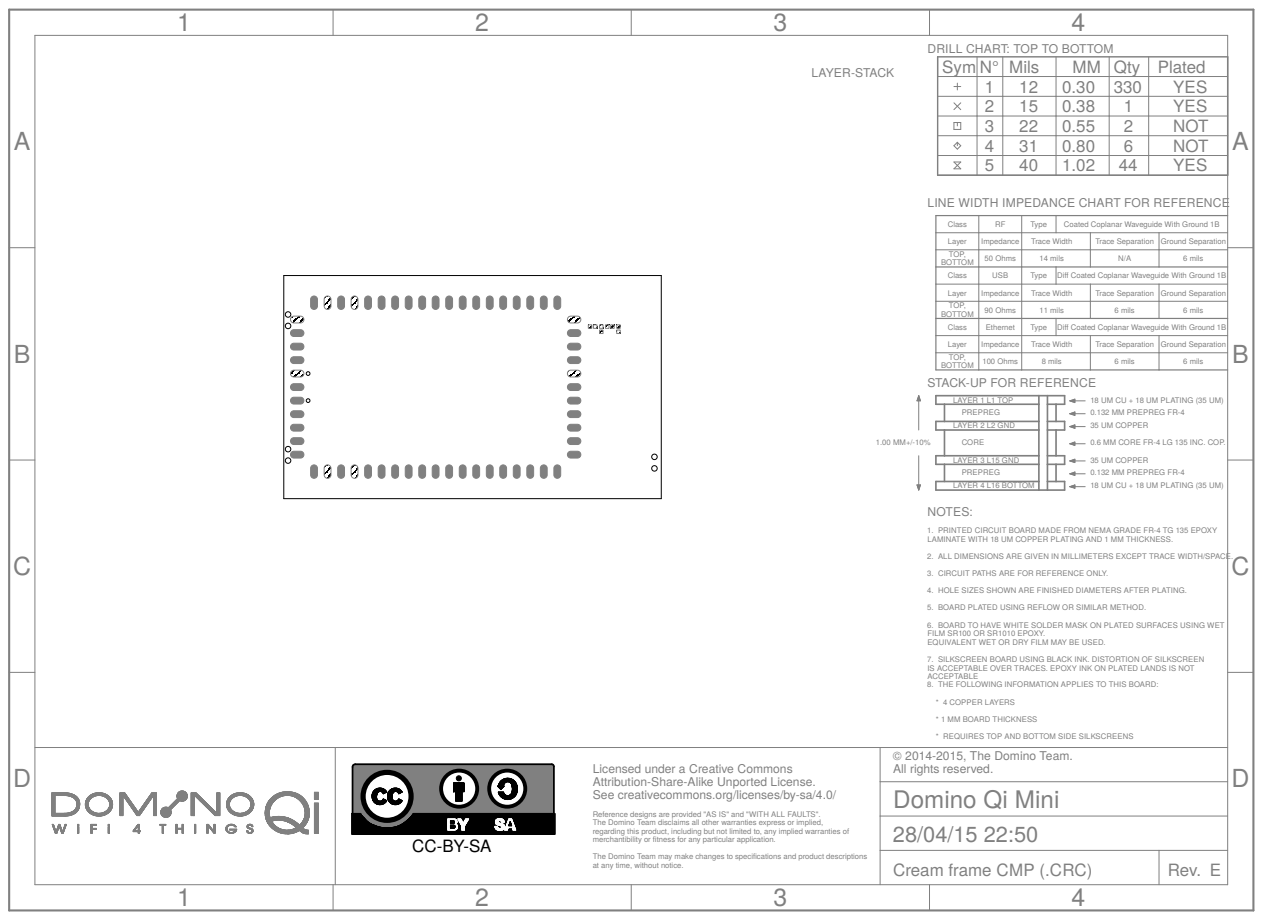
[picture p32: page 10]
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

LINE WIDTH IMPEDANCE CHART FOR REFERENCE

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

Coated Coplanar Waveguide With Ground 1B

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

1. PRINTED CIRCUIT BOARD MADE FROM NEMA GRADE FR-4 TG 135 EPOXY
LAMINATE WITH 18 UM COPPER PLATING AND 1 MM THICKNESS.

4. HOLE SIZES SHOWN ARE FINISHED DIAMETERS AFTER PLATING. 5. BOARD PLATED USING REFLOW OR SIMILAR METHOD. 6. BOARD TO HAVE WHITE SOLDER MASK ON PLATED SURFACES USING WET

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

IS ACCEPTABLE OVER TRACES. EPOXY INK ON PLATED LANDS IS NOT ACCEPTABLE

* 4 COPPER LAYERS
* 1 MM BOARD THICKNESS
* REQUIRES TOP AND BOTTOM SIDE SILKSCREENS
© 2014-2015, The Domino Team. All rights reserved.
Domino Qi Mini
Cream frame CMP (.CRC)

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

## DRILL CHART: TOP TO BOTTOM

A

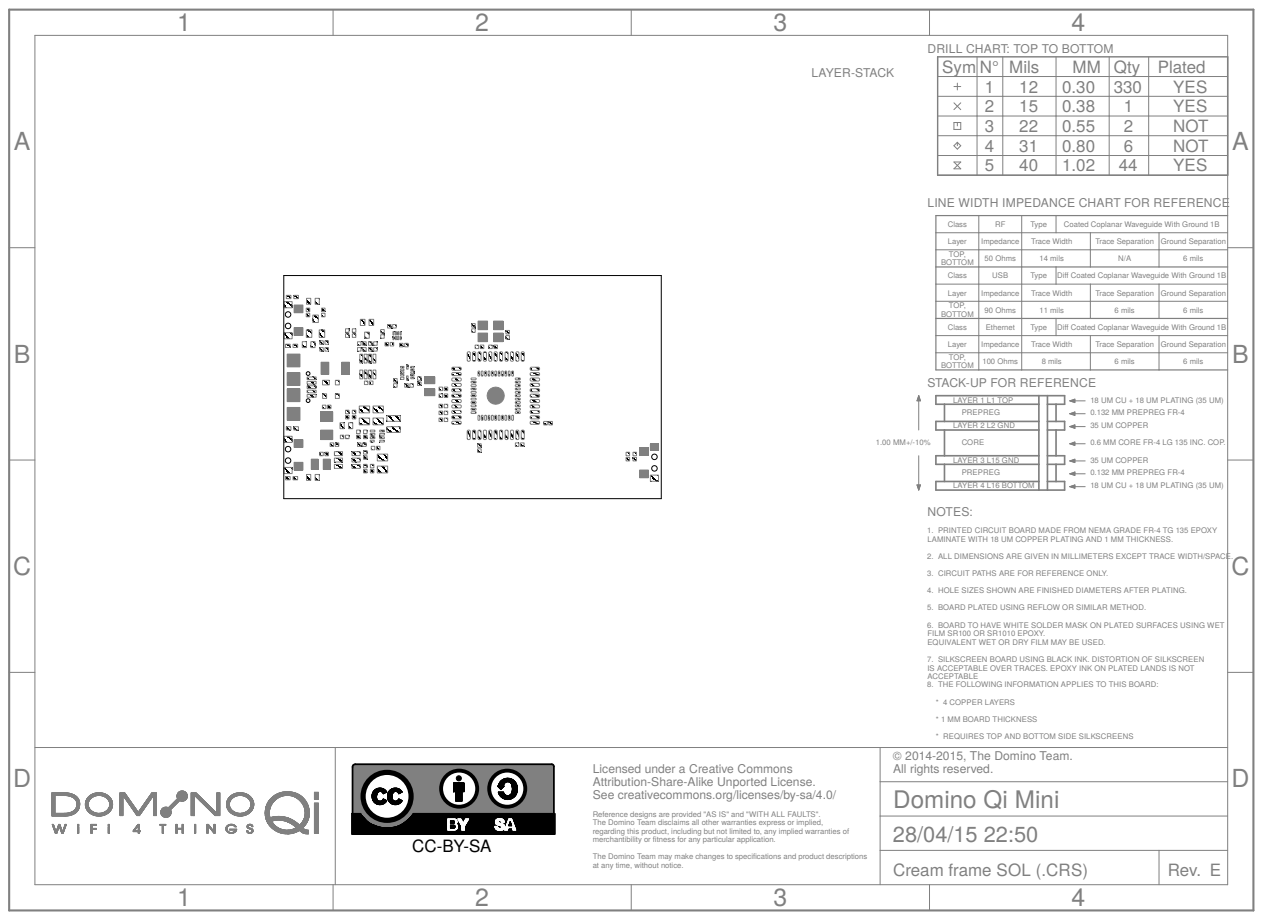
[picture p33: page 11]
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

LINE WIDTH IMPEDANCE CHART FOR REFERENCE

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

Coated Coplanar Waveguide With Ground 1B

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

1. PRINTED CIRCUIT BOARD MADE FROM NEMA GRADE FR-4 TG 135 EPOXY
LAMINATE WITH 18 UM COPPER PLATING AND 1 MM THICKNESS.

4. HOLE SIZES SHOWN ARE FINISHED DIAMETERS AFTER PLATING. 5. BOARD PLATED USING REFLOW OR SIMILAR METHOD. 6. BOARD TO HAVE WHITE SOLDER MASK ON PLATED SURFACES USING WET

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

IS ACCEPTABLE OVER TRACES. EPOXY INK ON PLATED LANDS IS NOT ACCEPTABLE

* 4 COPPER LAYERS
* 1 MM BOARD THICKNESS
* REQUIRES TOP AND BOTTOM SIDE SILKSCREENS
© 2014-2015, The Domino Team. All rights reserved.
Domino Qi Mini
Cream frame SOL (.CRS)

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

## DRILL CHART: TOP TO BOTTOM

A

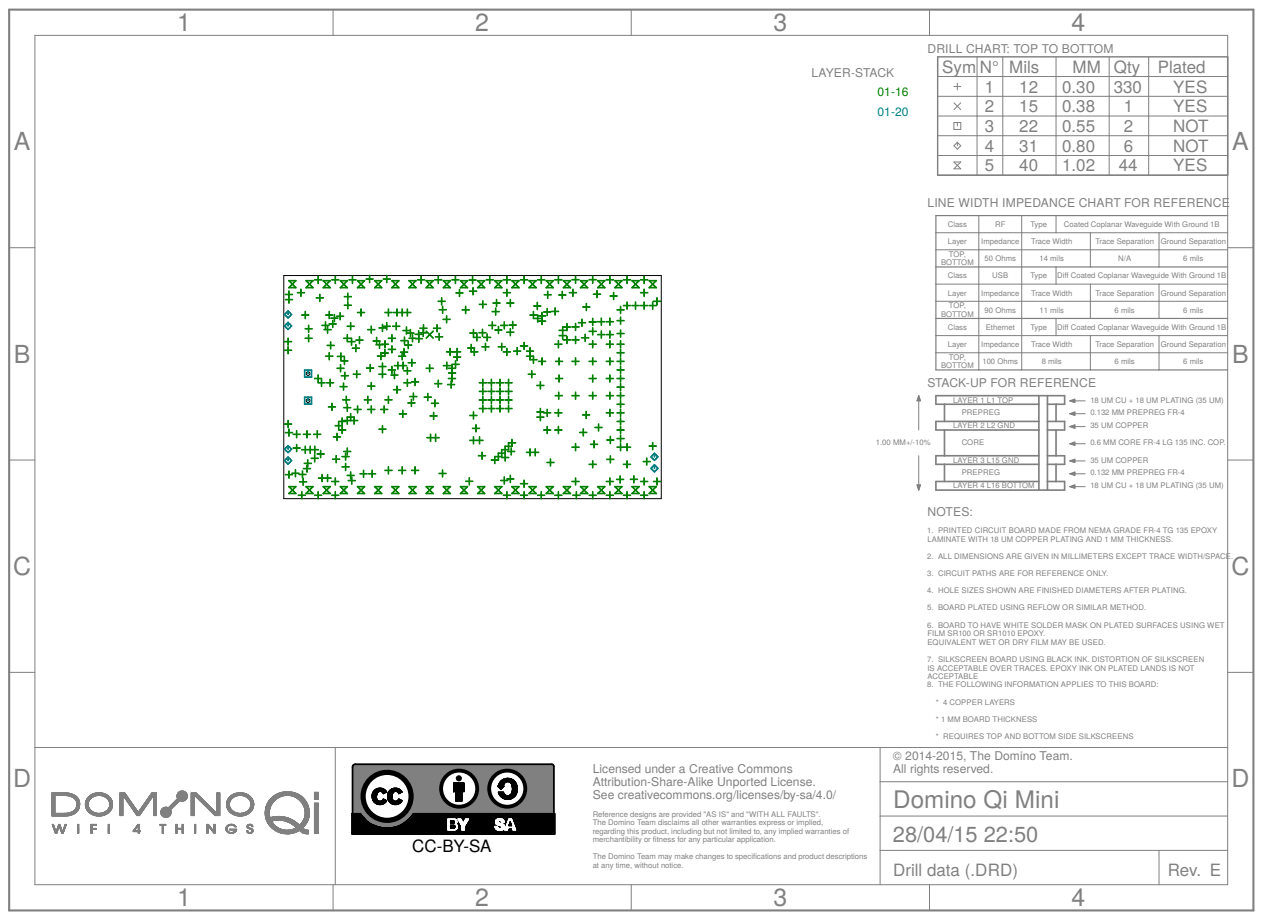
[picture p34: page 12]
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

LINE WIDTH IMPEDANCE CHART FOR REFERENCE

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

Coated Coplanar Waveguide With Ground 1B

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

1. PRINTED CIRCUIT BOARD MADE FROM NEMA GRADE FR-4 TG 135 EPOXY
LAMINATE WITH 18 UM COPPER PLATING AND 1 MM THICKNESS.

4. HOLE SIZES SHOWN ARE FINISHED DIAMETERS AFTER PLATING. 5. BOARD PLATED USING REFLOW OR SIMILAR METHOD. 6. BOARD TO HAVE WHITE SOLDER MASK ON PLATED SURFACES USING WET

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

IS ACCEPTABLE OVER TRACES. EPOXY INK ON PLATED LANDS IS NOT ACCEPTABLE

* 4 COPPER LAYERS
* 1 MM BOARD THICKNESS
* REQUIRES TOP AND BOTTOM SIDE SILKSCREENS
© 2014-2015, The Domino Team. All rights reserved.
Domino Qi Mini
Drill data (.DRD)

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

## DRILL CHART: TOP TO BOTTOM

A

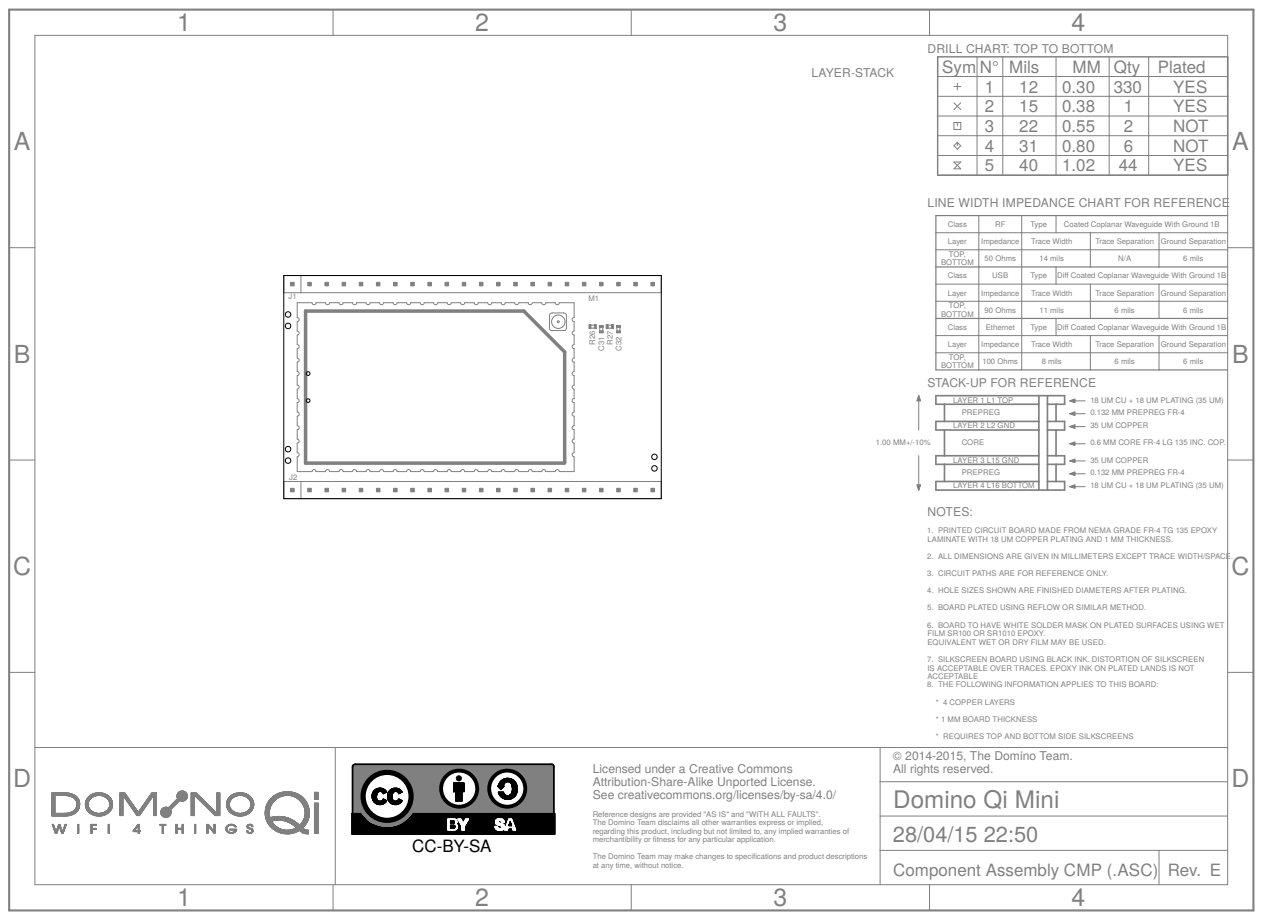
[picture p35: page 13]

LINE WIDTH IMPEDANCE CHART FOR REFERENCE

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

Coated Coplanar Waveguide With Ground 1B

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

1. PRINTED CIRCUIT BOARD MADE FROM NEMA GRADE FR-4 TG 135 EPOXY
LAMINATE WITH 18 UM COPPER PLATING AND 1 MM THICKNESS.

4. HOLE SIZES SHOWN ARE FINISHED DIAMETERS AFTER PLATING. 5. BOARD PLATED USING REFLOW OR SIMILAR METHOD. 6. BOARD TO HAVE WHITE SOLDER MASK ON PLATED SURFACES USING WET

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

IS ACCEPTABLE OVER TRACES. EPOXY INK ON PLATED LANDS IS NOT ACCEPTABLE

* 4 COPPER LAYERS
* 1 MM BOARD THICKNESS
* REQUIRES TOP AND BOTTOM SIDE SILKSCREENS
© 2014-2015, The Domino Team. All rights reserved.
Domino Qi Mini
Component Assembly CMP (.ASC)

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

## DRILL CHART: TOP TO BOTTOM

A

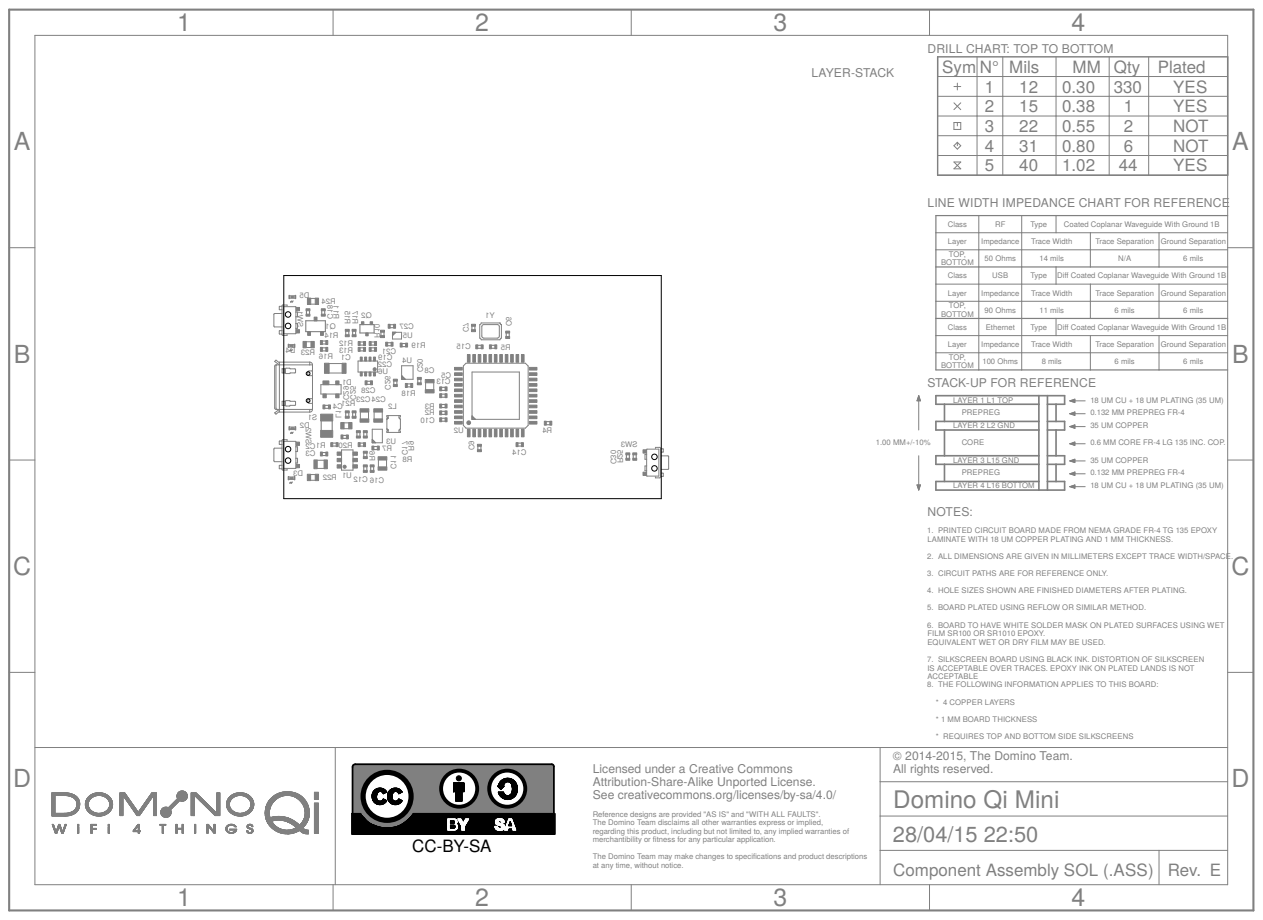
[picture p36: page 14]

LINE WIDTH IMPEDANCE CHART FOR REFERENCE

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

Coated Coplanar Waveguide With Ground 1B

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

1. PRINTED CIRCUIT BOARD MADE FROM NEMA GRADE FR-4 TG 135 EPOXY
LAMINATE WITH 18 UM COPPER PLATING AND 1 MM THICKNESS.

4. HOLE SIZES SHOWN ARE FINISHED DIAMETERS AFTER PLATING. 5. BOARD PLATED USING REFLOW OR SIMILAR METHOD. 6. BOARD TO HAVE WHITE SOLDER MASK ON PLATED SURFACES USING WET

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

IS ACCEPTABLE OVER TRACES. EPOXY INK ON PLATED LANDS IS NOT ACCEPTABLE

* 4 COPPER LAYERS
* 1 MM BOARD THICKNESS
* REQUIRES TOP AND BOTTOM SIDE SILKSCREENS
© 2014-2015, The Domino Team. All rights reserved.
Domino Qi Mini
Component Assembly SOL (.ASS)

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

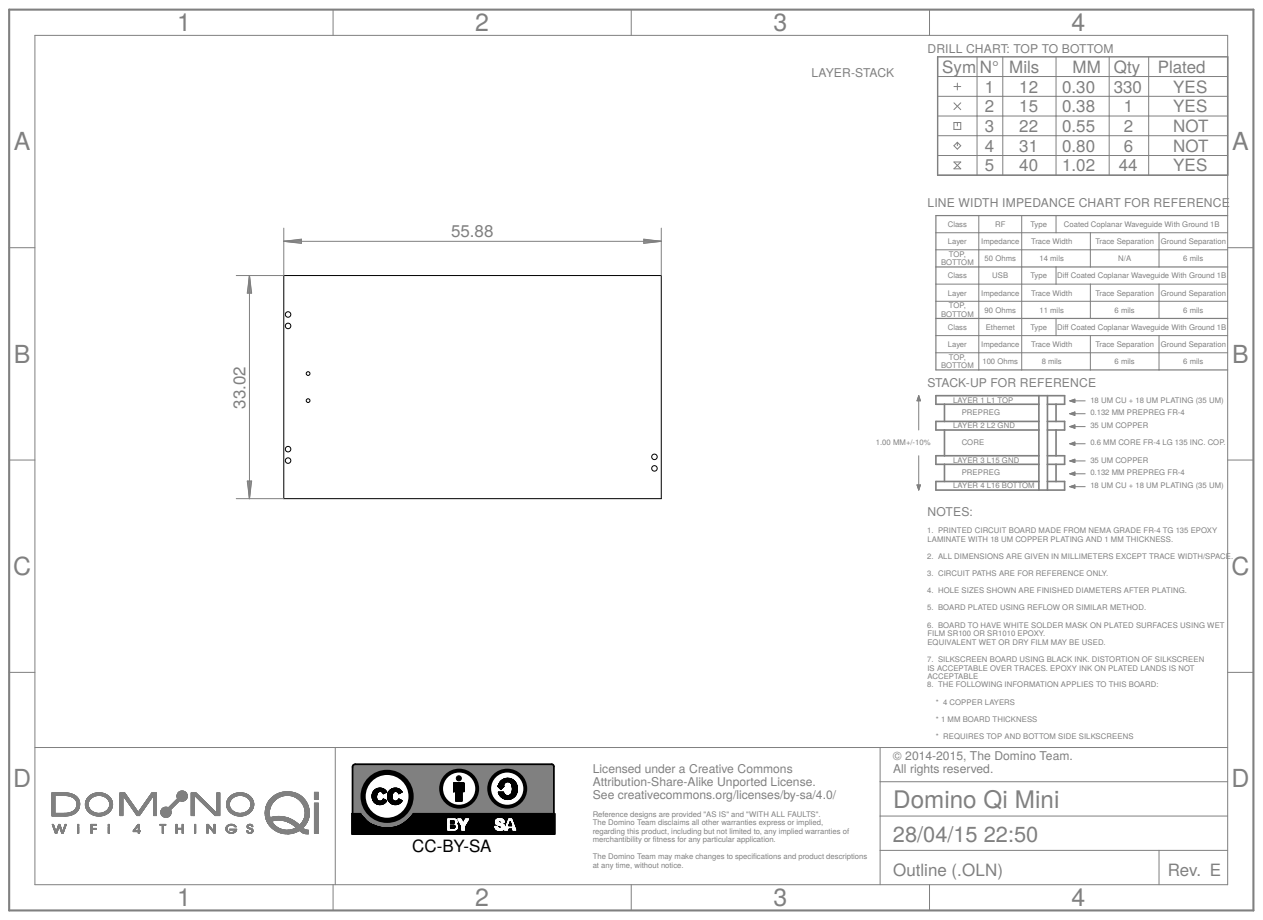
[picture p37: page 15]
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

## DRILL CHART: TOP TO BOTTOM

A

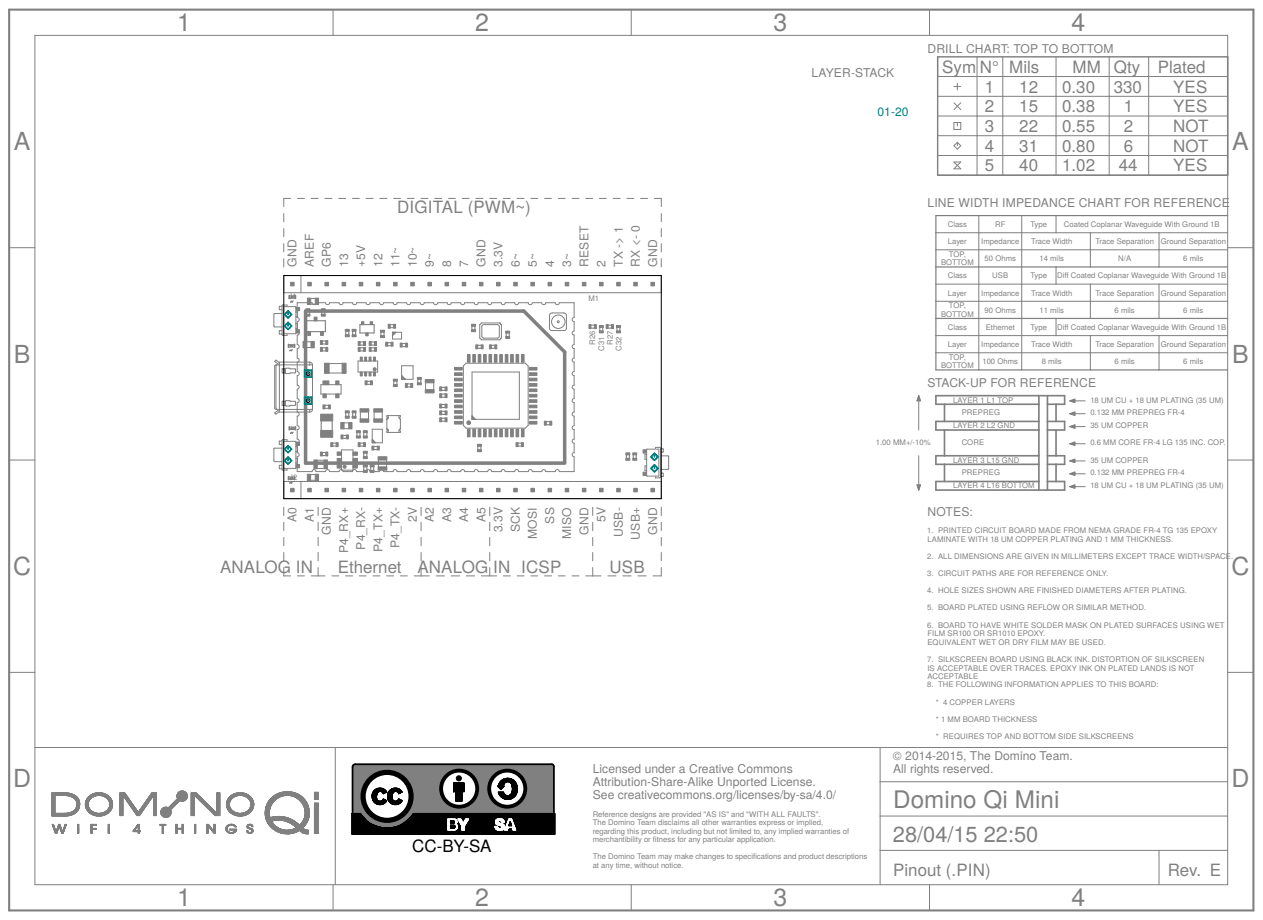
[picture p38: page 16]

LINE WIDTH IMPEDANCE CHART FOR REFERENCE

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

Coated Coplanar Waveguide With Ground 1B

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

1. PRINTED CIRCUIT BOARD MADE FROM NEMA GRADE FR-4 TG 135 EPOXY
LAMINATE WITH 18 UM COPPER PLATING AND 1 MM THICKNESS.

4. HOLE SIZES SHOWN ARE FINISHED DIAMETERS AFTER PLATING. 5. BOARD PLATED USING REFLOW OR SIMILAR METHOD. 6. BOARD TO HAVE WHITE SOLDER MASK ON PLATED SURFACES USING WET

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

IS ACCEPTABLE OVER TRACES. EPOXY INK ON PLATED LANDS IS NOT ACCEPTABLE

* 4 COPPER LAYERS
* 1 MM BOARD THICKNESS
* REQUIRES TOP AND BOTTOM SIDE SILKSCREENS
© 2014-2015, The Domino Team. All rights reserved.
Domino Qi Mini
Pinout (.PIN)

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
