domino-team/domino-hardware/Domino Dual Ethernet/PDF/Domino Dual Ethernet.pdf

## R12 R13 R14 R15 R16

A

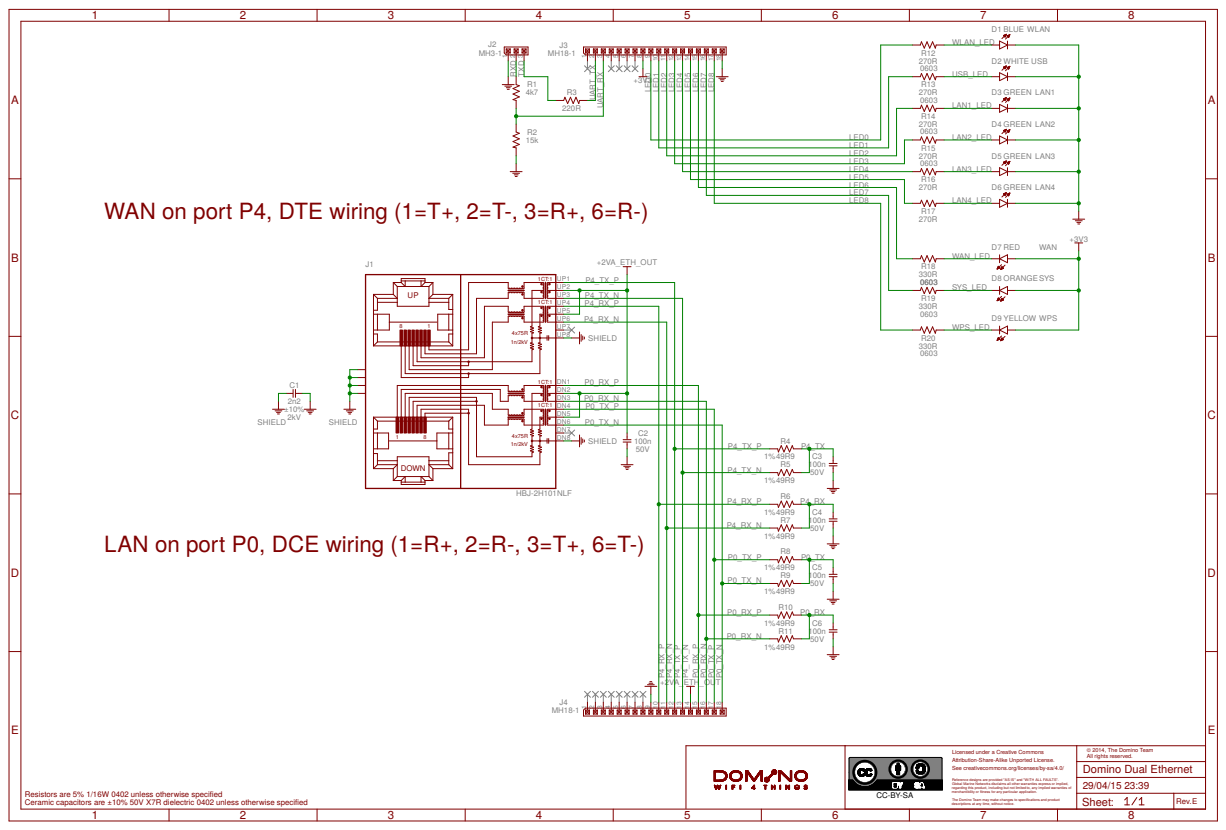
[picture p39: page 1]

LED1
LED2
LED3
LED4 LED5

WAN on port P4, DTE wiring (1=T+, 2=T-, 3=R+, 6=R-)

UP1 UP2 UP3 UP4 UP6 UP5 UP8 UP7 DN1 DN2 DN3 DN4 DN6 DN5 DN8 DN7 P0_RX_P
P4_TX_N
P4_RX_P
P4_RX_N

P0_RX_N
P0_TX_P
P0_TX_N

LAN on port P0, DCE wiring (1=R+, 2=R-, 3=T+, 6=T-)

Licensed under a Creative Commons Attribution-Share-Alike Unported License. See creativecommons.org/licenses/by-sa/4.0/ Reference designs are provided "AS IS" and "WITH ALL FAULTS". regarding this product, including but not limited to, any implied warranties of The Domino Team may make changes to specifications and product Global Marine Networks disclaims all other warranties express or implied, merchantibility or fitness for any particular application. descriptions at any time, without notice.

Ceramic capacitors are ±10% 50V X7R dielectric 0402 unless otherwise specified Resistors are 5% 1/16W 0402 unless otherwise specified

## DRILL CHART: TOP TO BOTTOM

A

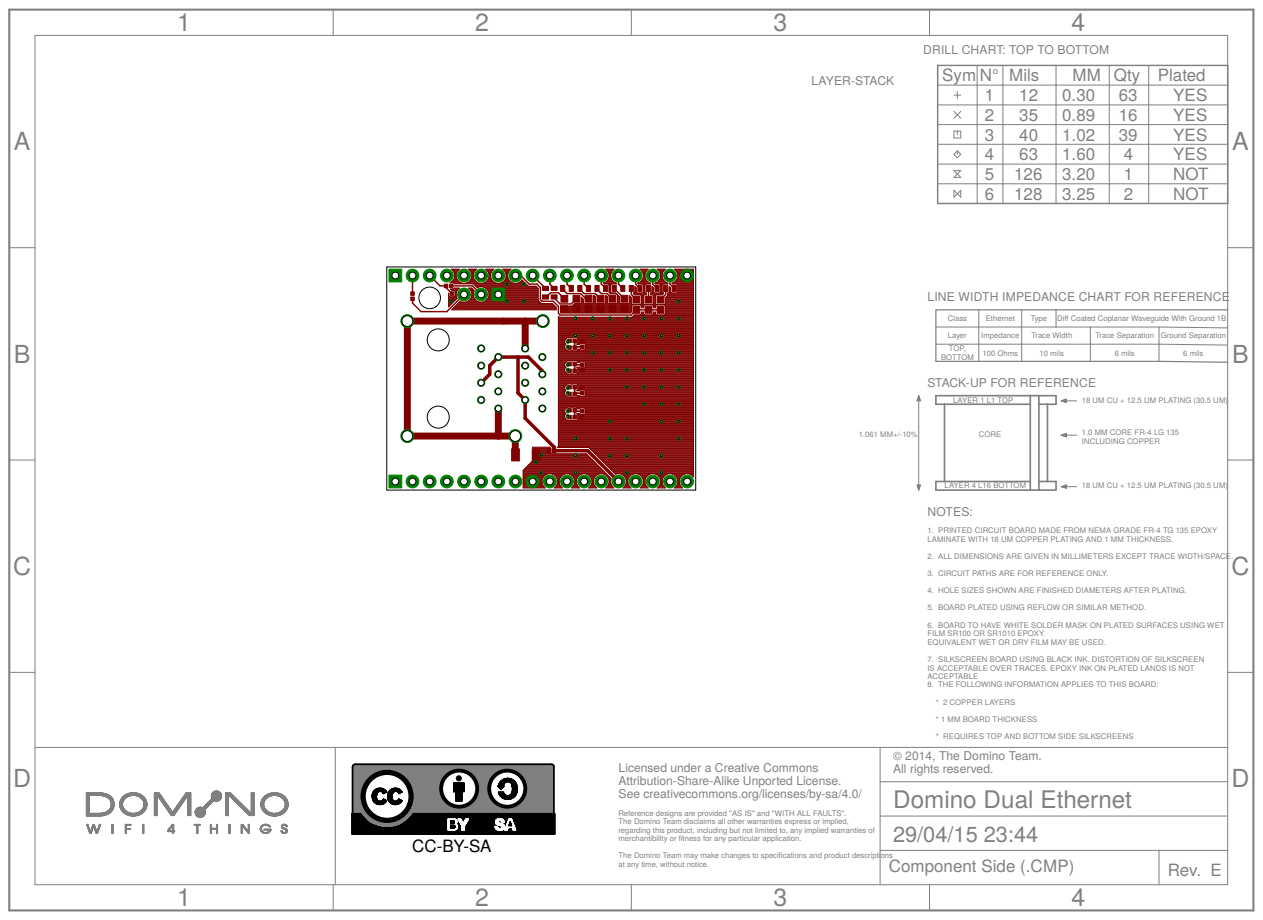
[picture p40: page 2]
LAYER 1 L1 TOP; LAYER 4 L16 BOTTOM; CORE; 100 Ohms; 10 mils; 6 mils; 6 mils Class; Ethernet; Type; © 2014, The Domino Team. All rights reserved.; Rev. E; LAYER-STACK; Sym N° Mils; MM Qty Plated; YES; NOT

LINE WIDTH IMPEDANCE CHART FOR REFERENCE

Diff Coated Coplanar Waveguide With Ground 1B

Layer | Impedance | Trace Width | Trace Separation | Ground Separation TOP, BOTTOM

1.061 MM+/-10% STACK-UP FOR REFERENCE

18 UM CU + 12.5 UM PLATING (30.5 UM)

1.0 MM CORE FR-4 LG 135
INCLUDING COPPER

NOTES: 2. ALL DIMENSIONS ARE GIVEN IN MILLIMETERS EXCEPT TRACE WIDTH/SPACE. 3. CIRCUIT PATHS ARE FOR REFERENCE ONLY.

1. PRINTED CIRCUIT BOARD MADE FROM NEMA GRADE FR-4 TG 135 EPOXY
LAMINATE WITH 18 UM COPPER PLATING AND 1 MM THICKNESS.

4. HOLE SIZES SHOWN ARE FINISHED DIAMETERS AFTER PLATING. 5. BOARD PLATED USING REFLOW OR SIMILAR METHOD. 6. BOARD TO HAVE WHITE SOLDER MASK ON PLATED SURFACES USING WET

FILM SR100 OR SR1010 EPOXY. EQUIVALENT WET OR DRY FILM MAY BE USED. 8. THE FOLLOWING INFORMATION APPLIES TO THIS BOARD: 7. SILKSCREEN BOARD USING BLACK INK. DISTORTION OF SILKSCREEN

IS ACCEPTABLE OVER TRACES. EPOXY INK ON PLATED LANDS IS NOT ACCEPTABLE

* 2 COPPER LAYERS
* 1 MM BOARD THICKNESS
* REQUIRES TOP AND BOTTOM SIDE SILKSCREENS
Domino Dual Ethernet

Licensed under a Creative Commons Attribution-Share-Alike Unported License. See creativecommons.org/licenses/by-sa/4.0/ Reference designs are provided "AS IS" and "WITH ALL FAULTS". The Domino Team disclaims all other warranties express or implied, regarding this product, including but not limited to, any implied warranties of merchantibility or fitness for any particular application. The Domino Team may make changes to specifications and product descriptions at any time, without notice. CC-BY-SA

Component Side (.CMP)

## DRILL CHART: TOP TO BOTTOM

A

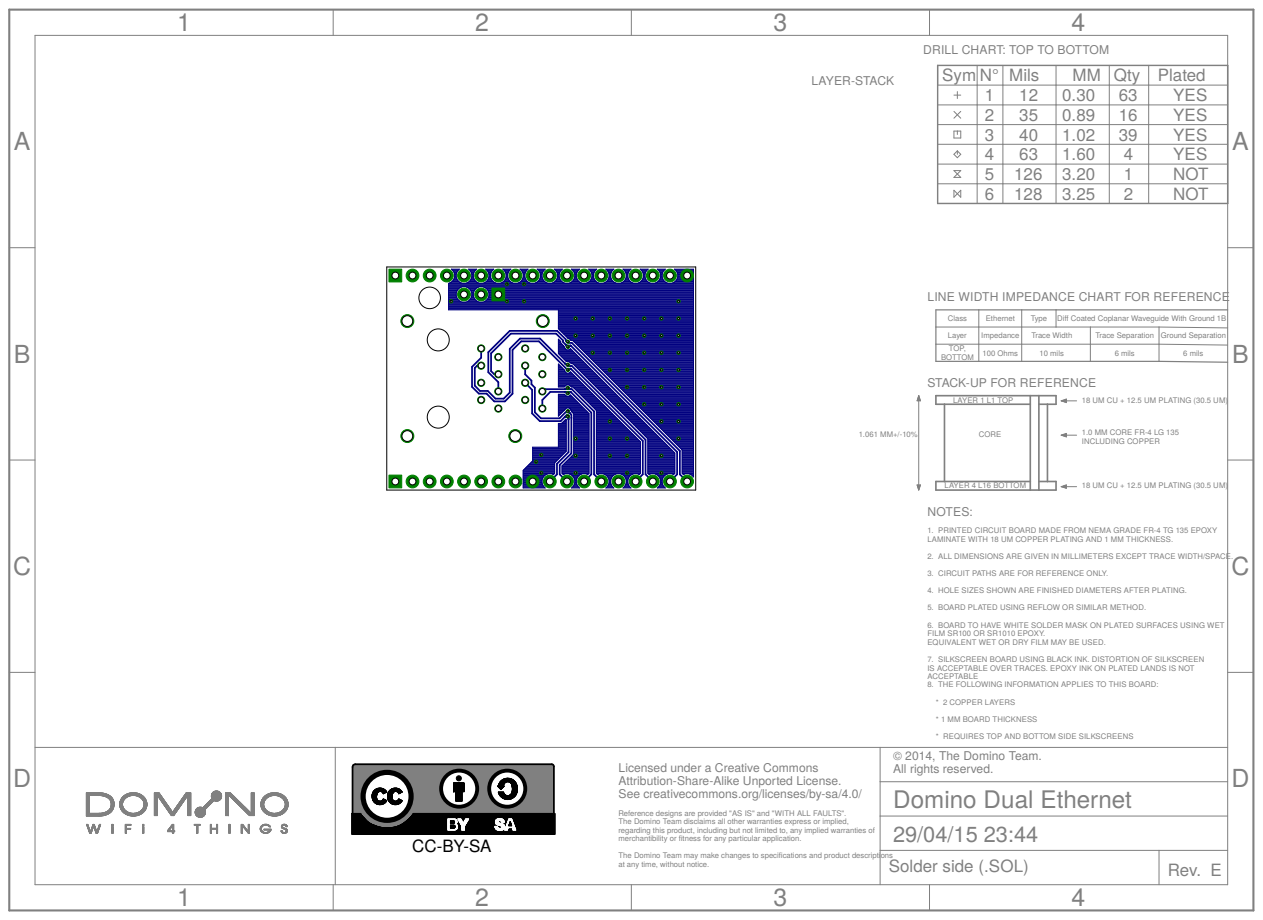
[picture p41: page 3]
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

LINE WIDTH IMPEDANCE CHART FOR REFERENCE

Diff Coated Coplanar Waveguide With Ground 1B

Layer | Impedance | Trace Width | Trace Separation | Ground Separation TOP, BOTTOM

1.061 MM+/-10% STACK-UP FOR REFERENCE

18 UM CU + 12.5 UM PLATING (30.5 UM)

1.0 MM CORE FR-4 LG 135
INCLUDING COPPER

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

1. PRINTED CIRCUIT BOARD MADE FROM NEMA GRADE FR-4 TG 135 EPOXY
LAMINATE WITH 18 UM COPPER PLATING AND 1 MM THICKNESS.

4. HOLE SIZES SHOWN ARE FINISHED DIAMETERS AFTER PLATING. 5. BOARD PLATED USING REFLOW OR SIMILAR METHOD. 6. BOARD TO HAVE WHITE SOLDER MASK ON PLATED SURFACES USING WET

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

IS ACCEPTABLE OVER TRACES. EPOXY INK ON PLATED LANDS IS NOT ACCEPTABLE

* 2 COPPER LAYERS
* 1 MM BOARD THICKNESS
* REQUIRES TOP AND BOTTOM SIDE SILKSCREENS
Domino Dual Ethernet

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

Solder side (.SOL)

## DRILL CHART: TOP TO BOTTOM

A

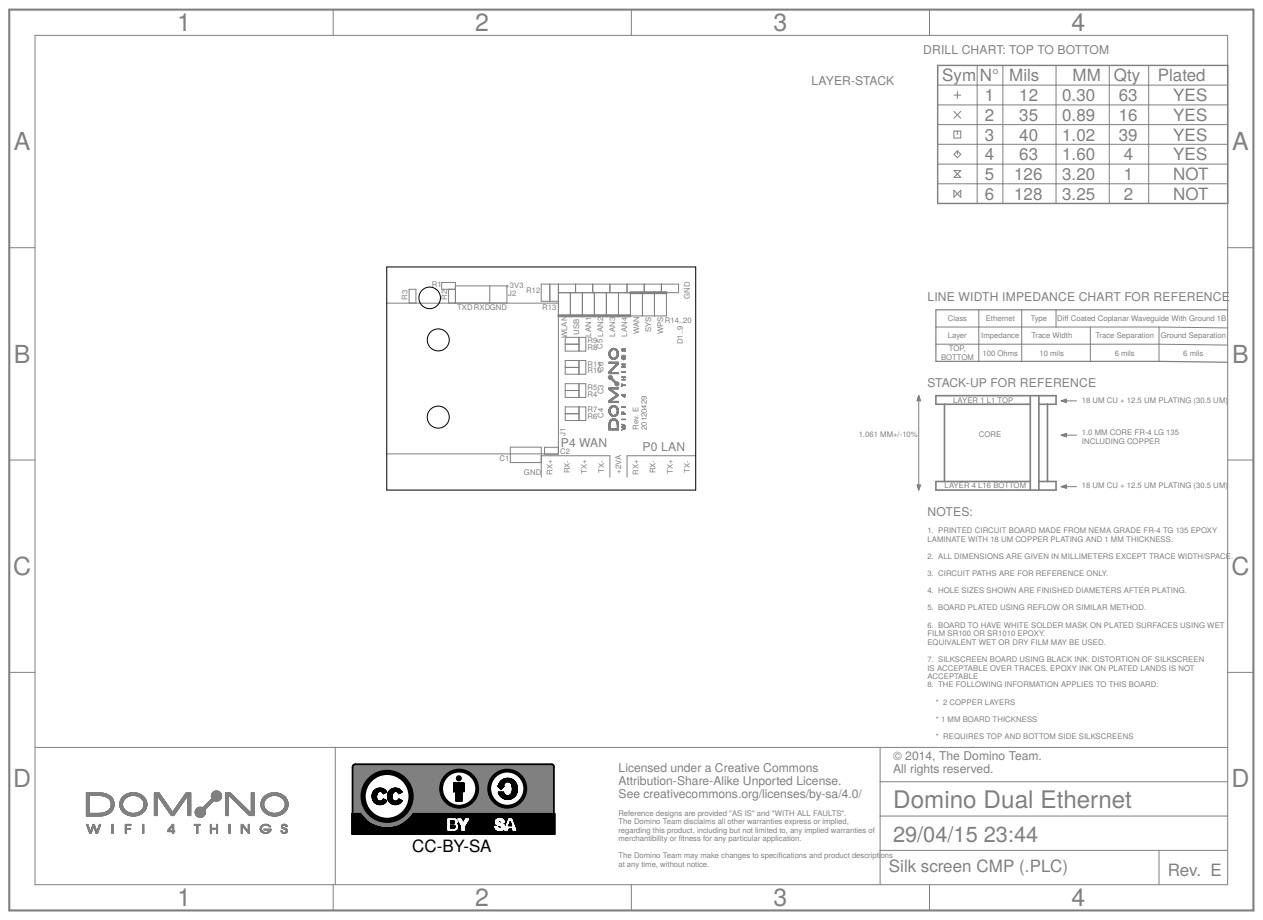
[picture p42: page 4]

LINE WIDTH IMPEDANCE CHART FOR REFERENCE

Diff Coated Coplanar Waveguide With Ground 1B

Layer | Impedance | Trace Width | Trace Separation | Ground Separation TOP, BOTTOM

1.061 MM+/-10% STACK-UP FOR REFERENCE

18 UM CU + 12.5 UM PLATING (30.5 UM)

RX+ RX- TX+ TX- P0 LAN

1.0 MM CORE FR-4 LG 135
INCLUDING COPPER

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

1. PRINTED CIRCUIT BOARD MADE FROM NEMA GRADE FR-4 TG 135 EPOXY
LAMINATE WITH 18 UM COPPER PLATING AND 1 MM THICKNESS.

4. HOLE SIZES SHOWN ARE FINISHED DIAMETERS AFTER PLATING. 5. BOARD PLATED USING REFLOW OR SIMILAR METHOD. 6. BOARD TO HAVE WHITE SOLDER MASK ON PLATED SURFACES USING WET

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

IS ACCEPTABLE OVER TRACES. EPOXY INK ON PLATED LANDS IS NOT ACCEPTABLE

* 2 COPPER LAYERS
* 1 MM BOARD THICKNESS
* REQUIRES TOP AND BOTTOM SIDE SILKSCREENS
Domino Dual Ethernet

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

Silk screen CMP (.PLC)

## DRILL CHART: TOP TO BOTTOM

A

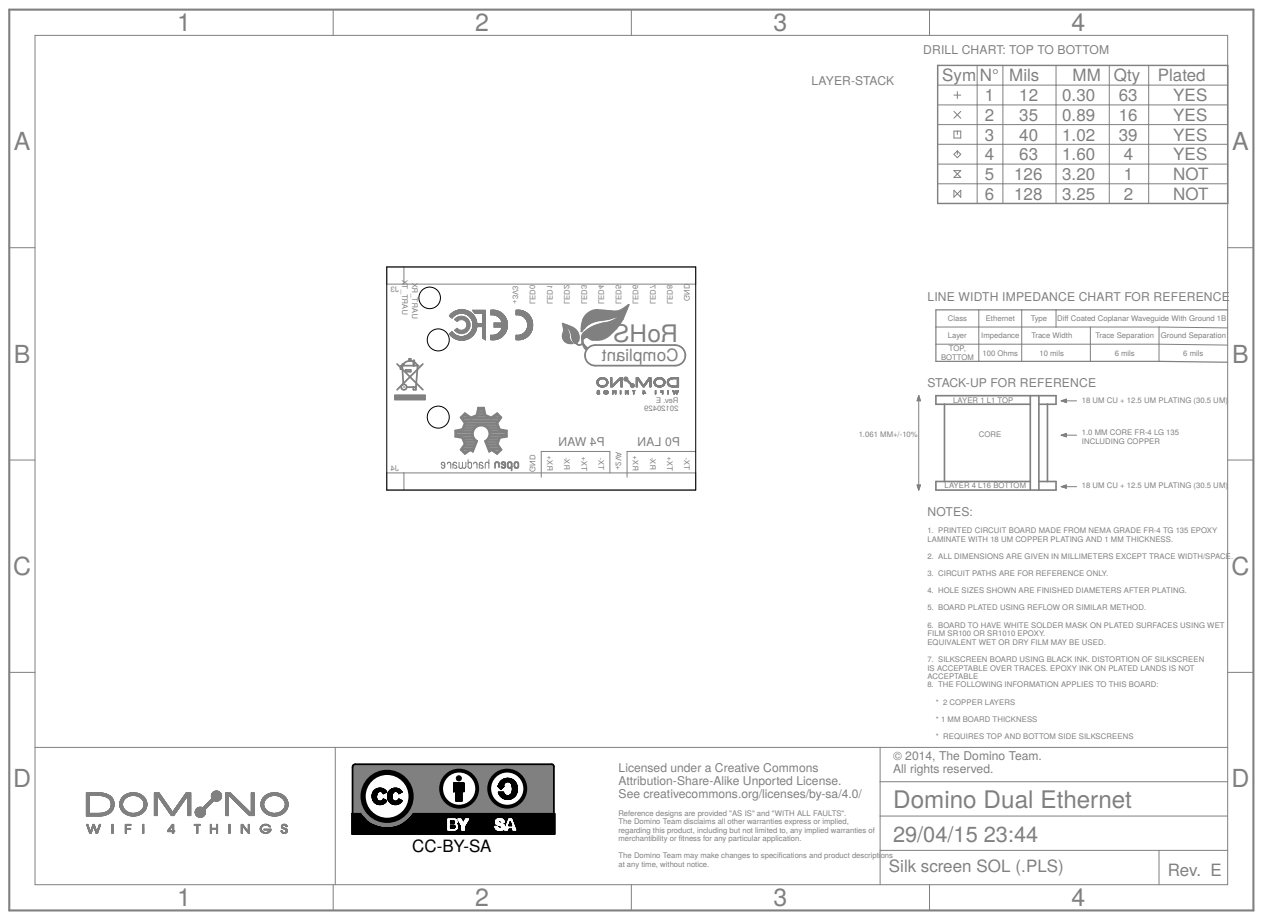
[picture p43: page 5]

LINE WIDTH IMPEDANCE CHART FOR REFERENCE

Diff Coated Coplanar Waveguide With Ground 1B

Layer | Impedance | Trace Width | Trace Separation | Ground Separation TOP, BOTTOM

1.061 MM+/-10% STACK-UP FOR REFERENCE

18 UM CU + 12.5 UM PLATING (30.5 UM)

RX+ RX- TX+ TX- NAL 0P

1.0 MM CORE FR-4 LG 135
INCLUDING COPPER

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

1. PRINTED CIRCUIT BOARD MADE FROM NEMA GRADE FR-4 TG 135 EPOXY
LAMINATE WITH 18 UM COPPER PLATING AND 1 MM THICKNESS.

4. HOLE SIZES SHOWN ARE FINISHED DIAMETERS AFTER PLATING. 5. BOARD PLATED USING REFLOW OR SIMILAR METHOD. 6. BOARD TO HAVE WHITE SOLDER MASK ON PLATED SURFACES USING WET

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

IS ACCEPTABLE OVER TRACES. EPOXY INK ON PLATED LANDS IS NOT ACCEPTABLE

* 2 COPPER LAYERS
* 1 MM BOARD THICKNESS
* REQUIRES TOP AND BOTTOM SIDE SILKSCREENS
Domino Dual Ethernet

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

Silk screen SOL (.PLS)

## DRILL CHART: TOP TO BOTTOM

A

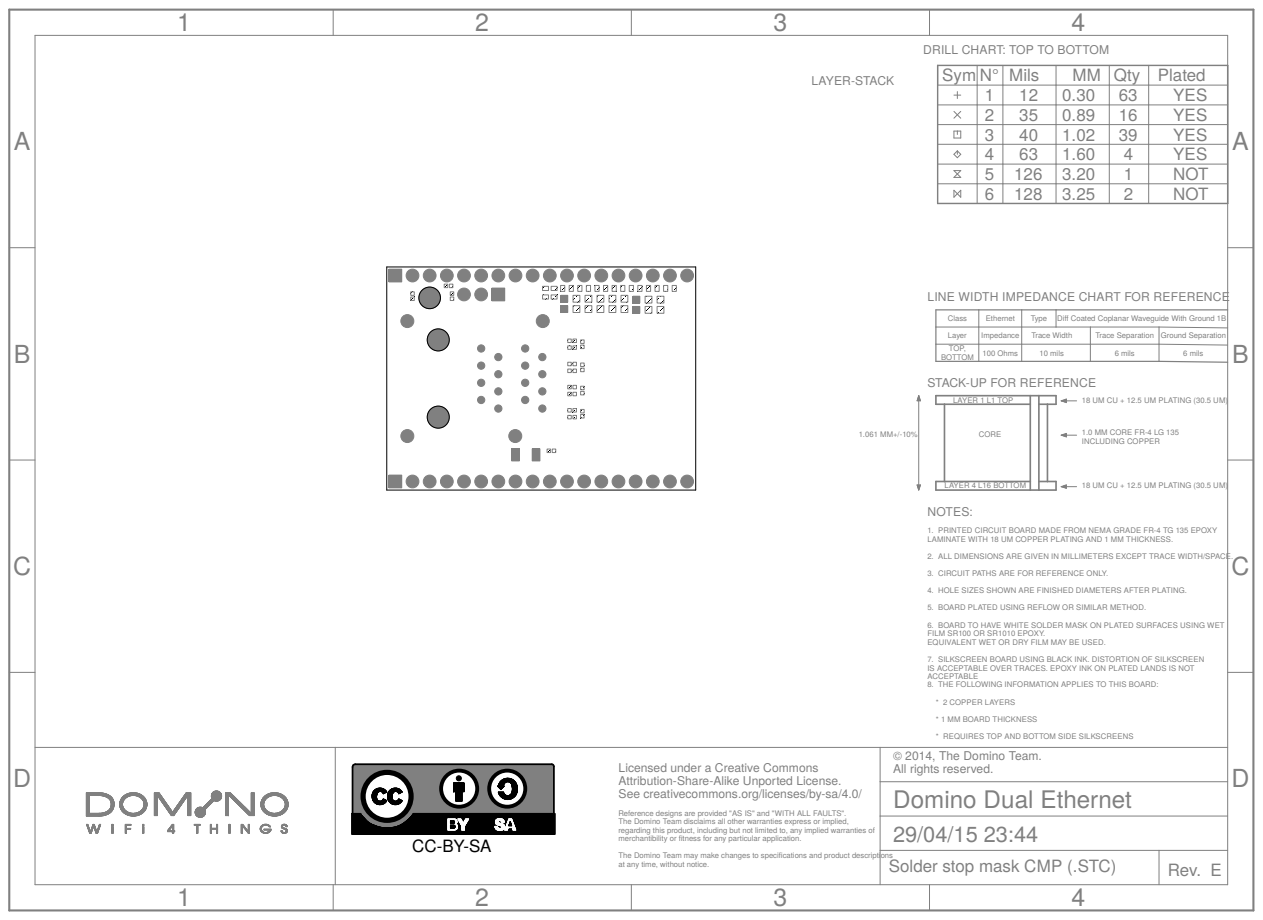
[picture p44: page 6]
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

LINE WIDTH IMPEDANCE CHART FOR REFERENCE

Diff Coated Coplanar Waveguide With Ground 1B

Layer | Impedance | Trace Width | Trace Separation | Ground Separation TOP, BOTTOM

1.061 MM+/-10% STACK-UP FOR REFERENCE

18 UM CU + 12.5 UM PLATING (30.5 UM)

1.0 MM CORE FR-4 LG 135
INCLUDING COPPER

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

1. PRINTED CIRCUIT BOARD MADE FROM NEMA GRADE FR-4 TG 135 EPOXY
LAMINATE WITH 18 UM COPPER PLATING AND 1 MM THICKNESS.

4. HOLE SIZES SHOWN ARE FINISHED DIAMETERS AFTER PLATING. 5. BOARD PLATED USING REFLOW OR SIMILAR METHOD. 6. BOARD TO HAVE WHITE SOLDER MASK ON PLATED SURFACES USING WET

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

IS ACCEPTABLE OVER TRACES. EPOXY INK ON PLATED LANDS IS NOT ACCEPTABLE

* 2 COPPER LAYERS
* 1 MM BOARD THICKNESS
* REQUIRES TOP AND BOTTOM SIDE SILKSCREENS
Domino Dual Ethernet

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

Solder stop mask CMP (.STC)

## DRILL CHART: TOP TO BOTTOM

A

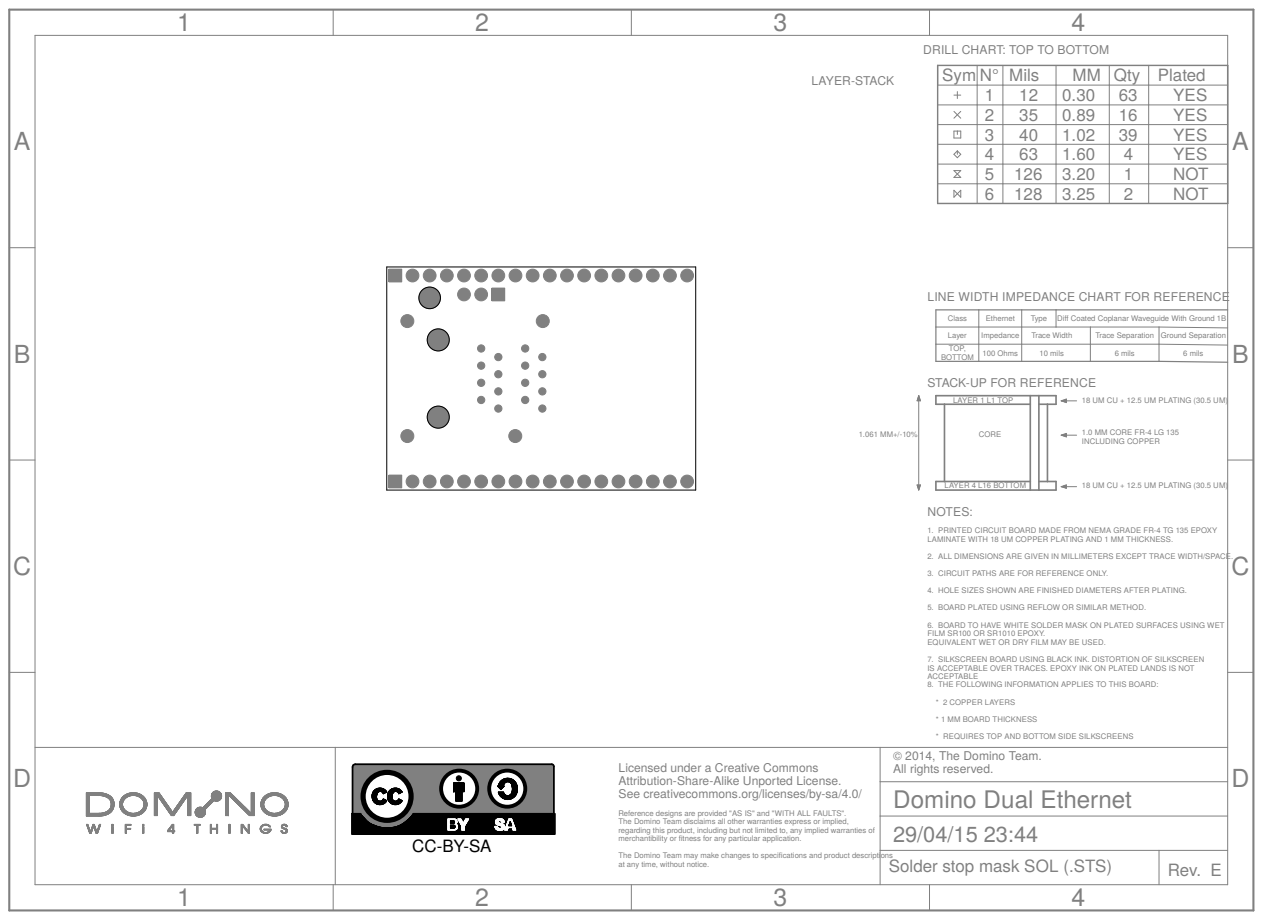
[picture p45: page 7]
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

LINE WIDTH IMPEDANCE CHART FOR REFERENCE

Diff Coated Coplanar Waveguide With Ground 1B

Layer | Impedance | Trace Width | Trace Separation | Ground Separation TOP, BOTTOM

1.061 MM+/-10% STACK-UP FOR REFERENCE

18 UM CU + 12.5 UM PLATING (30.5 UM)

1.0 MM CORE FR-4 LG 135
INCLUDING COPPER

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

1. PRINTED CIRCUIT BOARD MADE FROM NEMA GRADE FR-4 TG 135 EPOXY
LAMINATE WITH 18 UM COPPER PLATING AND 1 MM THICKNESS.

4. HOLE SIZES SHOWN ARE FINISHED DIAMETERS AFTER PLATING. 5. BOARD PLATED USING REFLOW OR SIMILAR METHOD. 6. BOARD TO HAVE WHITE SOLDER MASK ON PLATED SURFACES USING WET

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

IS ACCEPTABLE OVER TRACES. EPOXY INK ON PLATED LANDS IS NOT ACCEPTABLE

* 2 COPPER LAYERS
* 1 MM BOARD THICKNESS
* REQUIRES TOP AND BOTTOM SIDE SILKSCREENS
Domino Dual Ethernet

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

Solder stop mask SOL (.STS)

## DRILL CHART: TOP TO BOTTOM

A

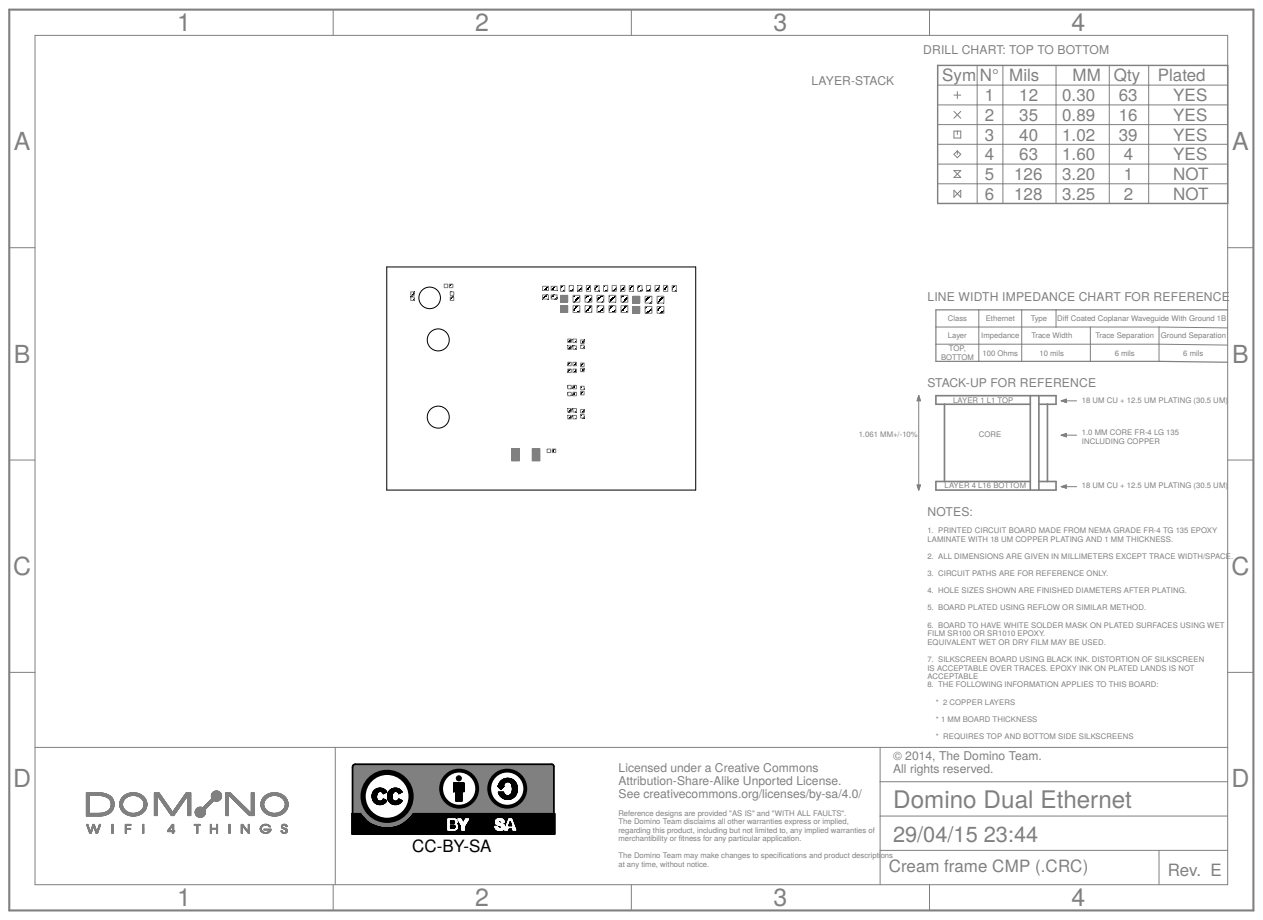
[picture p46: page 8]
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

LINE WIDTH IMPEDANCE CHART FOR REFERENCE

Diff Coated Coplanar Waveguide With Ground 1B

Layer | Impedance | Trace Width | Trace Separation | Ground Separation TOP, BOTTOM

1.061 MM+/-10% STACK-UP FOR REFERENCE

18 UM CU + 12.5 UM PLATING (30.5 UM)

1.0 MM CORE FR-4 LG 135
INCLUDING COPPER

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

1. PRINTED CIRCUIT BOARD MADE FROM NEMA GRADE FR-4 TG 135 EPOXY
LAMINATE WITH 18 UM COPPER PLATING AND 1 MM THICKNESS.

4. HOLE SIZES SHOWN ARE FINISHED DIAMETERS AFTER PLATING. 5. BOARD PLATED USING REFLOW OR SIMILAR METHOD. 6. BOARD TO HAVE WHITE SOLDER MASK ON PLATED SURFACES USING WET

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

IS ACCEPTABLE OVER TRACES. EPOXY INK ON PLATED LANDS IS NOT ACCEPTABLE

* 2 COPPER LAYERS
* 1 MM BOARD THICKNESS
* REQUIRES TOP AND BOTTOM SIDE SILKSCREENS
Domino Dual Ethernet

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

Cream frame CMP (.CRC)

## DRILL CHART: TOP TO BOTTOM

A

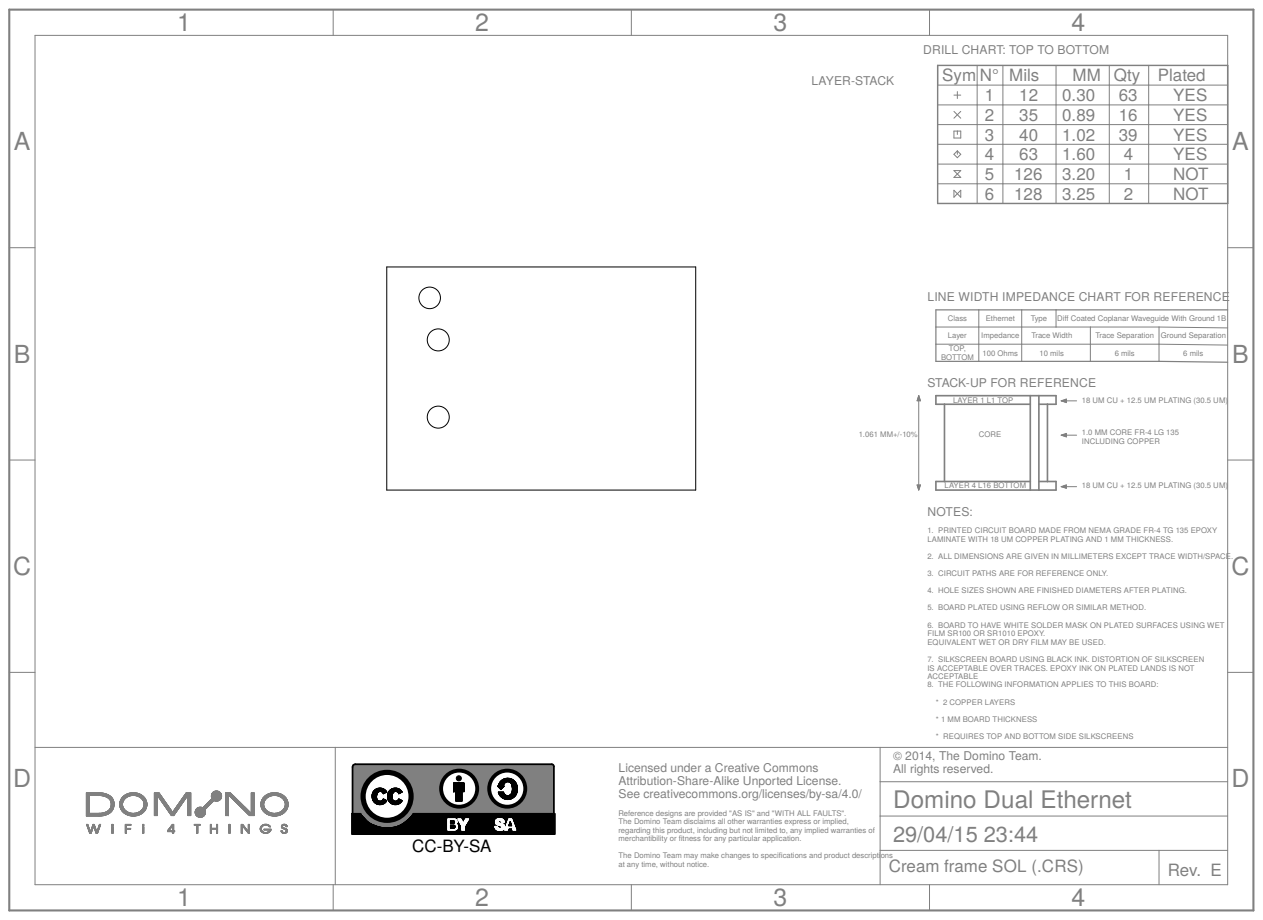
[picture p47: page 9]
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

LINE WIDTH IMPEDANCE CHART FOR REFERENCE

Diff Coated Coplanar Waveguide With Ground 1B

Layer | Impedance | Trace Width | Trace Separation | Ground Separation TOP, BOTTOM

1.061 MM+/-10% STACK-UP FOR REFERENCE

18 UM CU + 12.5 UM PLATING (30.5 UM)

1.0 MM CORE FR-4 LG 135
INCLUDING COPPER

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

1. PRINTED CIRCUIT BOARD MADE FROM NEMA GRADE FR-4 TG 135 EPOXY
LAMINATE WITH 18 UM COPPER PLATING AND 1 MM THICKNESS.

4. HOLE SIZES SHOWN ARE FINISHED DIAMETERS AFTER PLATING. 5. BOARD PLATED USING REFLOW OR SIMILAR METHOD. 6. BOARD TO HAVE WHITE SOLDER MASK ON PLATED SURFACES USING WET

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

IS ACCEPTABLE OVER TRACES. EPOXY INK ON PLATED LANDS IS NOT ACCEPTABLE

* 2 COPPER LAYERS
* 1 MM BOARD THICKNESS
* REQUIRES TOP AND BOTTOM SIDE SILKSCREENS
Domino Dual Ethernet

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

Cream frame SOL (.CRS)

## DRILL CHART: TOP TO BOTTOM

A

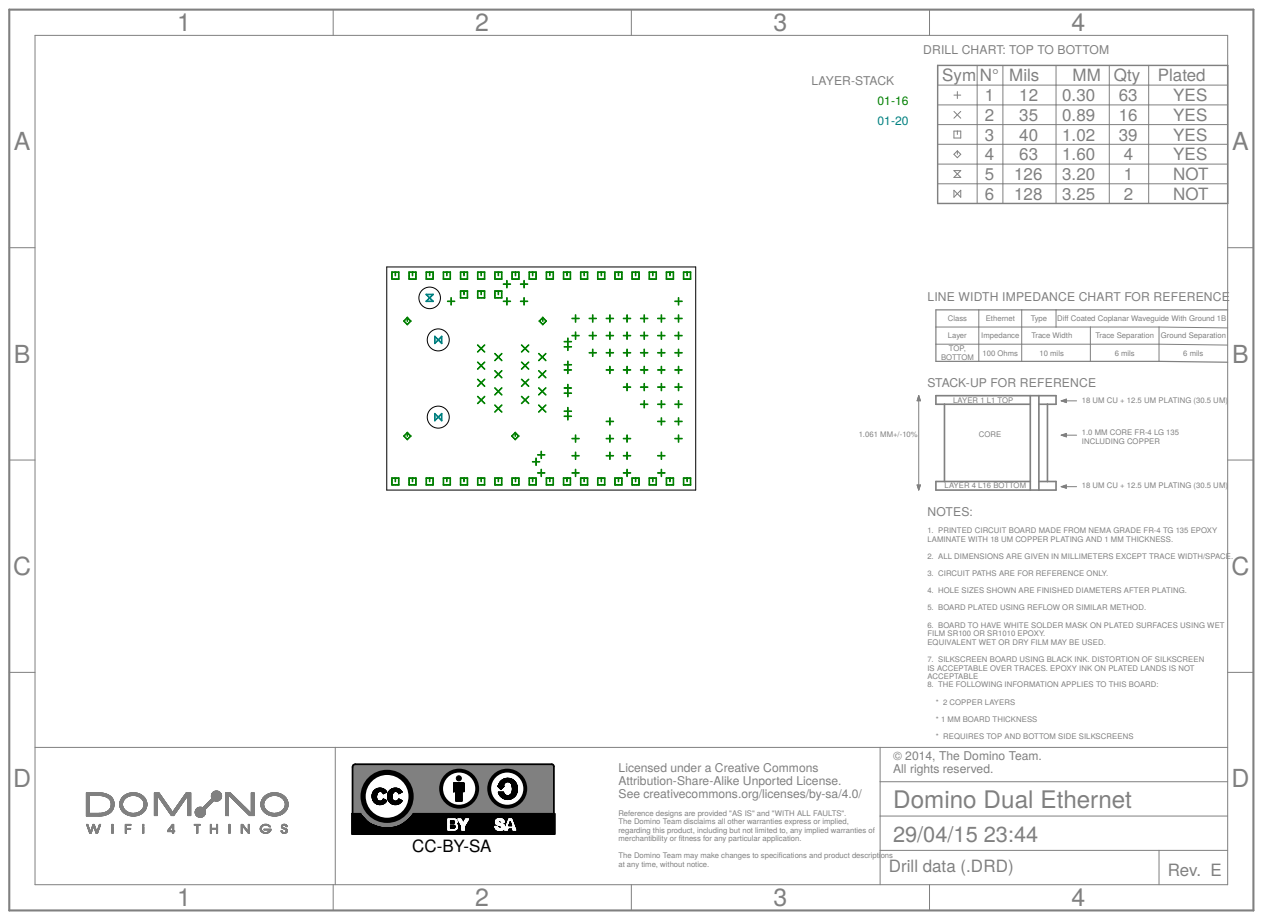
[picture p48: page 10]
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

LINE WIDTH IMPEDANCE CHART FOR REFERENCE

Diff Coated Coplanar Waveguide With Ground 1B

Layer | Impedance | Trace Width | Trace Separation | Ground Separation TOP, BOTTOM

1.061 MM+/-10% STACK-UP FOR REFERENCE

18 UM CU + 12.5 UM PLATING (30.5 UM)

1.0 MM CORE FR-4 LG 135
INCLUDING COPPER

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

1. PRINTED CIRCUIT BOARD MADE FROM NEMA GRADE FR-4 TG 135 EPOXY
LAMINATE WITH 18 UM COPPER PLATING AND 1 MM THICKNESS.

4. HOLE SIZES SHOWN ARE FINISHED DIAMETERS AFTER PLATING. 5. BOARD PLATED USING REFLOW OR SIMILAR METHOD. 6. BOARD TO HAVE WHITE SOLDER MASK ON PLATED SURFACES USING WET

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

IS ACCEPTABLE OVER TRACES. EPOXY INK ON PLATED LANDS IS NOT ACCEPTABLE

* 2 COPPER LAYERS
* 1 MM BOARD THICKNESS
* REQUIRES TOP AND BOTTOM SIDE SILKSCREENS
Domino Dual Ethernet

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

Drill data (.DRD)

## DRILL CHART: TOP TO BOTTOM

A

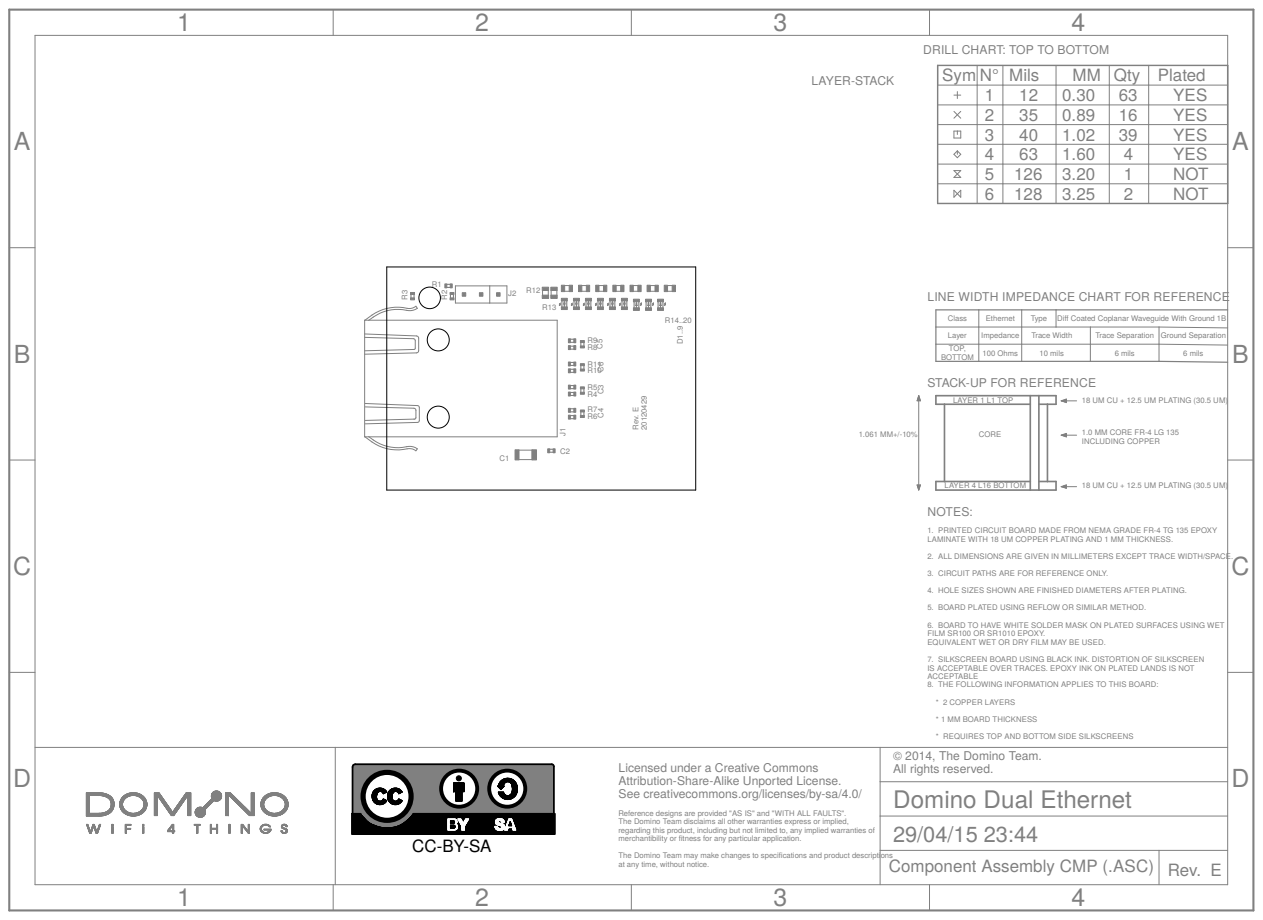
[picture p49: page 11]

LINE WIDTH IMPEDANCE CHART FOR REFERENCE

Diff Coated Coplanar Waveguide With Ground 1B

Layer | Impedance | Trace Width | Trace Separation | Ground Separation TOP, BOTTOM

1.061 MM+/-10% STACK-UP FOR REFERENCE

18 UM CU + 12.5 UM PLATING (30.5 UM)

1.0 MM CORE FR-4 LG 135
INCLUDING COPPER

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

1. PRINTED CIRCUIT BOARD MADE FROM NEMA GRADE FR-4 TG 135 EPOXY
LAMINATE WITH 18 UM COPPER PLATING AND 1 MM THICKNESS.

4. HOLE SIZES SHOWN ARE FINISHED DIAMETERS AFTER PLATING. 5. BOARD PLATED USING REFLOW OR SIMILAR METHOD. 6. BOARD TO HAVE WHITE SOLDER MASK ON PLATED SURFACES USING WET

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

IS ACCEPTABLE OVER TRACES. EPOXY INK ON PLATED LANDS IS NOT ACCEPTABLE

* 2 COPPER LAYERS
* 1 MM BOARD THICKNESS
* REQUIRES TOP AND BOTTOM SIDE SILKSCREENS
Domino Dual Ethernet

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

Component Assembly CMP (.ASC)

## DRILL CHART: TOP TO BOTTOM

A

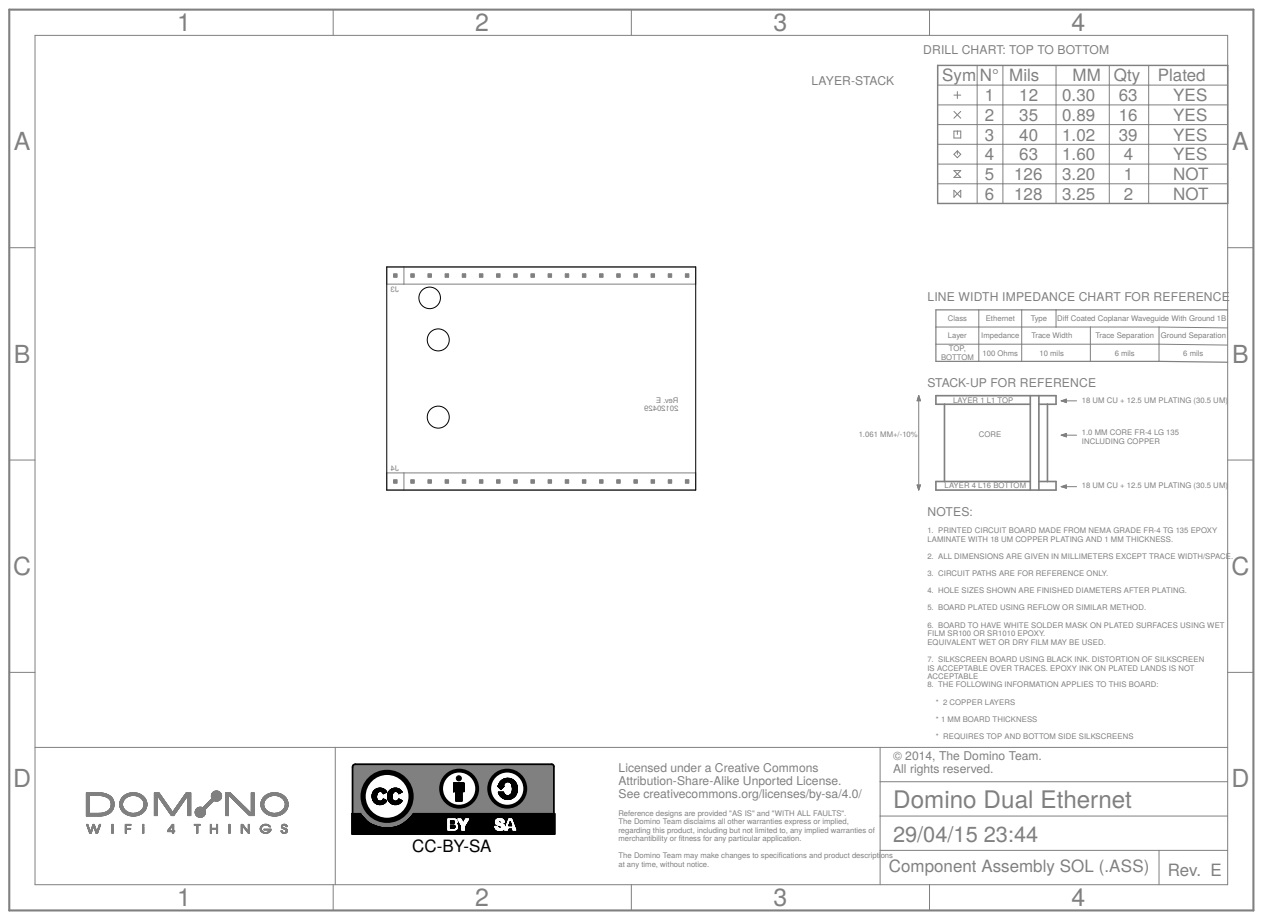
[picture p50: page 12]
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

LINE WIDTH IMPEDANCE CHART FOR REFERENCE

Diff Coated Coplanar Waveguide With Ground 1B

Layer | Impedance | Trace Width | Trace Separation | Ground Separation TOP, BOTTOM

1.061 MM+/-10% STACK-UP FOR REFERENCE

18 UM CU + 12.5 UM PLATING (30.5 UM)

1.0 MM CORE FR-4 LG 135
INCLUDING COPPER

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

1. PRINTED CIRCUIT BOARD MADE FROM NEMA GRADE FR-4 TG 135 EPOXY
LAMINATE WITH 18 UM COPPER PLATING AND 1 MM THICKNESS.

4. HOLE SIZES SHOWN ARE FINISHED DIAMETERS AFTER PLATING. 5. BOARD PLATED USING REFLOW OR SIMILAR METHOD. 6. BOARD TO HAVE WHITE SOLDER MASK ON PLATED SURFACES USING WET

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

IS ACCEPTABLE OVER TRACES. EPOXY INK ON PLATED LANDS IS NOT ACCEPTABLE

* 2 COPPER LAYERS
* 1 MM BOARD THICKNESS
* REQUIRES TOP AND BOTTOM SIDE SILKSCREENS
Domino Dual Ethernet

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

Component Assembly SOL (.ASS)

## DRILL CHART: TOP TO BOTTOM

A

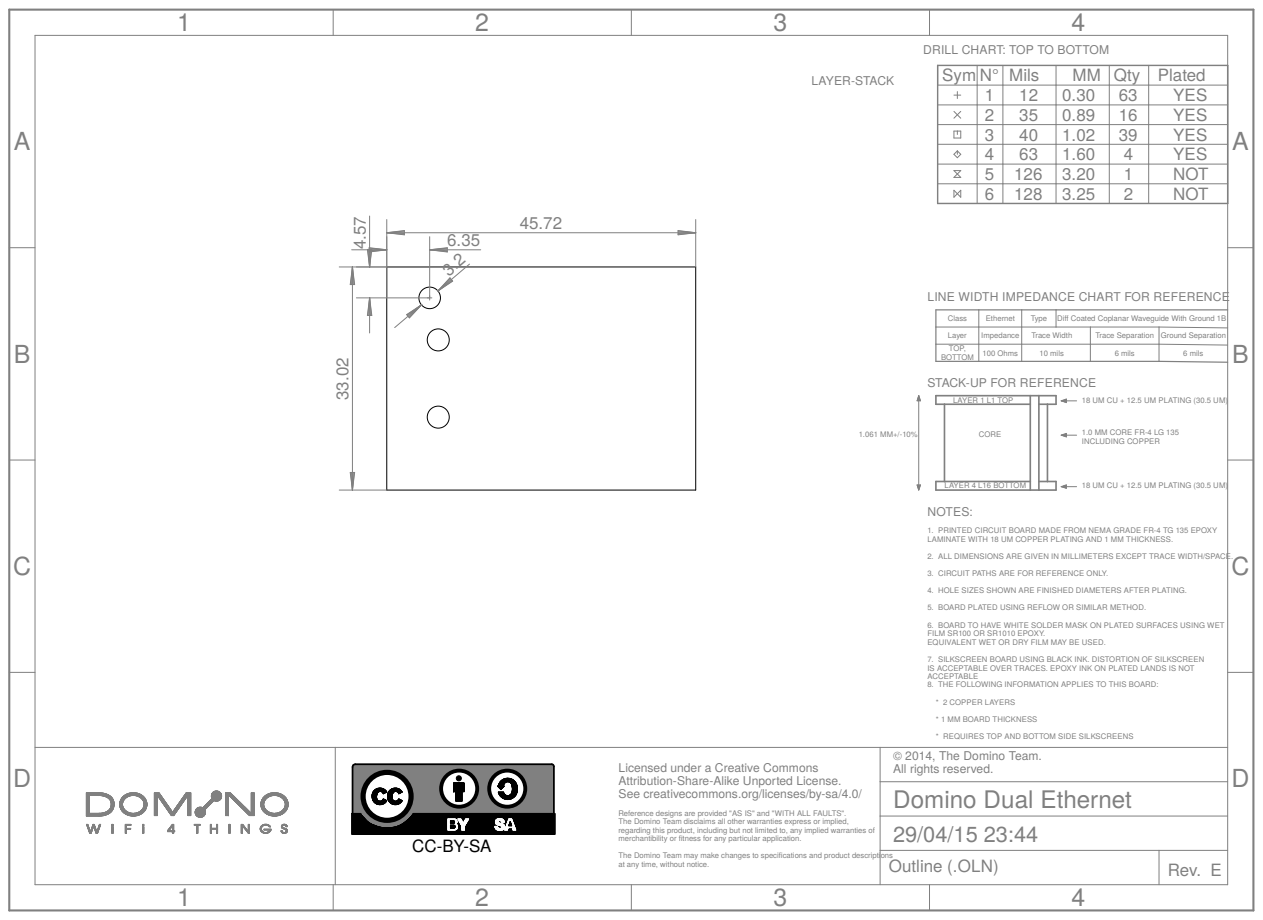
[picture p51: page 13]
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

LINE WIDTH IMPEDANCE CHART FOR REFERENCE

Diff Coated Coplanar Waveguide With Ground 1B

Layer | Impedance | Trace Width | Trace Separation | Ground Separation TOP, BOTTOM

1.061 MM+/-10% STACK-UP FOR REFERENCE

18 UM CU + 12.5 UM PLATING (30.5 UM)

1.0 MM CORE FR-4 LG 135
INCLUDING COPPER

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

1. PRINTED CIRCUIT BOARD MADE FROM NEMA GRADE FR-4 TG 135 EPOXY
LAMINATE WITH 18 UM COPPER PLATING AND 1 MM THICKNESS.

4. HOLE SIZES SHOWN ARE FINISHED DIAMETERS AFTER PLATING. 5. BOARD PLATED USING REFLOW OR SIMILAR METHOD. 6. BOARD TO HAVE WHITE SOLDER MASK ON PLATED SURFACES USING WET

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

IS ACCEPTABLE OVER TRACES. EPOXY INK ON PLATED LANDS IS NOT ACCEPTABLE

* 2 COPPER LAYERS
* 1 MM BOARD THICKNESS
* REQUIRES TOP AND BOTTOM SIDE SILKSCREENS
Domino Dual Ethernet

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

Outline (.OLN)

Rev. 20120429 E R14..20D1..9 R6 CR7 4 R4 CR5 3 R12 R13 R10 CR11 6 R8 CR9 5 C2 C1 J1 J2 R1 R2R3 DRILL CHART: TOP TO BOTTOM NOTES: 2. ALL DIMENSIONS ARE GIVEN IN MILLIMETERS EXCEPT TRACE WIDTH/SPACE. 3. CIRCUIT PATHS ARE FOR REFERENCE ONLY. * 2 COPPER LAYERS * 1 MM BOARD THICKNESS * REQUIRES TOP AND BOTTOM SIDE SILKSCREENS 4. HOLE SIZES SHOWN ARE FINISHED DIAMETERS AFTER PLATING. 5. BOARD PLATED USING REFLOW OR SIMILAR METHOD. 6. BOARD TO HAVE WHITE SOLDER MASK ON PLATED SURFACES USING WET FILM SR100 OR SR1010 EPOXY. EQUIVALENT WET OR DRY FILM MAY BE USED. 8. THE FOLLOWING INFORMATION APPLIES TO THIS BOARD: 7. SILKSCREEN BOARD USING BLACK INK. DISTORTION OF SILKSCREEN IS ACCEPTABLE OVER TRACES. EPOXY INK ON PLATED LANDS IS NOT ACCEPTABLE 1. PRINTED CIRCUIT BOARD MADE FROM NEMA GRADE FR-4 TG 135 EPOXY LAMINATE WITH 18 UM COPPER PLATING AND 1 MM THICKNESS. LAYER 1 L1 TOP LAYER 4 L16 BOTTOM CORE 18 UM CU + 12.5 UM PLATING (30.5 UM) 18 UM CU + 12.5 UM PLATING (30.5 UM) 1.0 MM CORE FR-4 LG 135 INCLUDING COPPER 1.061 MM+/-10% STACK-UP FOR REFERENCE LINE WIDTH IMPEDANCE CHART FOR REFERENCE Diff Coated Coplanar Waveguide With Ground 1B Layer Impedance Trace Width Trace Separation Ground Separation TOP, BOTTOM 100 Ohms 10 mils 6 mils 6 mils Class Ethernet Type Licensed under a Creative Commons Attribution-Share-Alike Unported License. See creativecommons.org/licenses/by-sa/4.0/ Reference designs are provided "AS IS" and "WITH ALL FAULTS". The Domino Team disclaims all other warranties express or implied, regarding this product, including but not limited to, any implied warranties of merchantibility or fitness for any particular application. The Domino Team may make changes to specifications and product descriptions at any time, without notice. © 2014, The Domino Team. All rights reserved. Rev. E Domino Dual Ethernet 29/04/15 23:44 ABCD 1 2 3 4 ABCD 1 2 3 4 CC-BY-SA LAYER-STACK Sym N° Mils MM Qty Plated 1 12 0.30 63 YES 2 35 0.89 16 YES 3 40 1.02 39 YES 4 63 1.60 4 YES 5 126 3.20 1 NOT 6 128 3.25 2 NOT 01-20 GND P4_RX+ P4_RX- P4_TX+ P4_TX- +2VA_ETH_OUT Pinout (.PIN) +3V3 LED0 LED1 GND ELD2 LED3 LED4 LED6 LED7 LED5 LED8 P0_RX+ P0_RX- P0_TX+ P0_TX- UART_TX UART_RX GND RXD TXD

# Domino Dual Ethernet Rev. E

Item Qty | Value | Manufacturer | Device | Package | Reference | Description | Remarks
1 | 1 2n2 | ANY | C1210_2n2_X7R_10%_CER_2kV | C1206 | C1 | CAP CER 2200PF 1KV 10% X7R 1210
2 | 5 100n | ANY | C0402_100n_X7R_10%_CER_50V | C0402 | C2, C3, C4, C5, C6 | CAP CER 0.1UF 50V 10% X7R 0402
3 | 1 BLUE | ANY | LED0603-BLUE | LED0603 | D1 | LED BLUE CLEAR 0603 SMD
4 | 1 WHITE | ANY | LED0603-WHITE | LED0603 | D2 | LED WHITE CLEAR 0603 SMD
5 | 4 GREEN | ANY | LED0603-GREEN | LED0603 | D3, D4, D5, D6 | LED GREEN CLEAR 0603 SMD
6 | 1 RED | ANY | LED0603-ORANGE | LED0603 | D7 | LED ORANGE CLEAR 0603 SMD
7 | 1 ORANGE | ANY | LED0603-ORANGE | LED0603 | D8 | LED ORANGE CLEAR 0603 SMD
8 | 1 YELLOW | ANY | LED0603-YELLOW | LED0603 | D9 | LED YELLOW CLEAR 0603 SMD
9 | 1 HBJ-2H101NLF | SHEZHEN HUILY ELECTRONICS HBJ-2H101NLF | HBJ-2H101NLF | J1 | CONN MAGJACK 2PORT 100 BASE-T
10 | 1 MH3-1 | ANY | MH3-1-0.1 | MH3-1-0.1 | J2 | CONN HEADER VERT .100 1ROW 3POS 8.08 HEAD 3.05 TAIL 15AU
11 | 2 MH18-1 | ANY | MH18-1-0.1 | MH18-1-0.1 | J3, J4 | CONN HEADER VERT .100 1ROW 18POS 8.08 HEAD 3.05 TAIL 15AU
12 | 1 4k7 | ANY | R0402_4k7_5%_62.5mW | R0402 | R1 | RES 4.7K OHM 1/16W 5% 0402 SMD
13 | 6 270R | ANY | R0603_270R_5%_125mW | R0603 | R12, R13, R14, R15, R16, R17 | RES 270 OHM 1/8W 5% 0603 SMD
14 | 3 330R | ANY | R0603_330R_5%_125mW | R0603 | R18, R19, R20 | RES 330 OHM 1/8W 5% 0603 SMD
15 | 1 15k | ANY | R0402_15k_5%_62.5mW | R0402 | R2 | RES 15K OHM 1/16W 5% 0402 SMD
16 | 1 220R | ANY | R0402_220R_5%_62.5mW | R0402 | R3 | RES 220 OHM 1/16W 5% 0402 SMD
17 | 8 49R9 | ANY | R0402_49R9_1%_62.5mW | R0402 | R4, R5, R6, R7, R8, R9, R10, R11 | RES 49.9 OHM 1/16W 1% 0402 SMD
