domino-team/domino-hardware/Domino Single USB/PDF/Domino Single USB.pdf

A

A

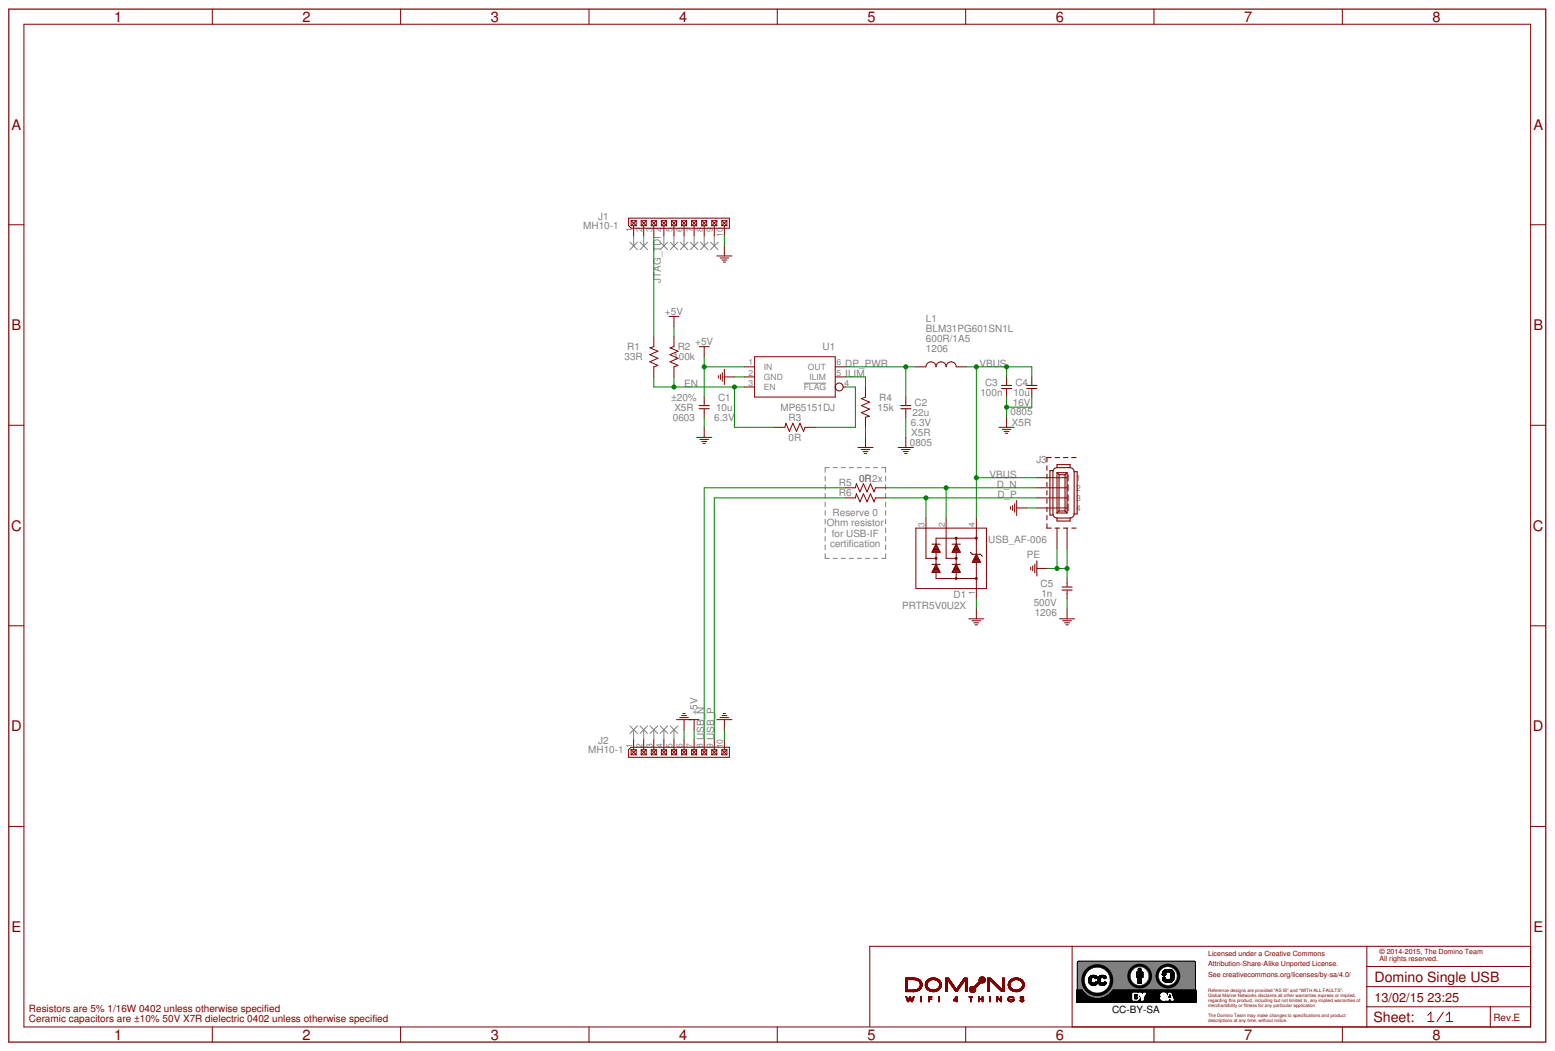
[picture p66: page 1]

Licensed under a Creative Commons Attribution-Share-Alike Unported License. See creativecommons.org/licenses/by-sa/4.0/ Reference designs are provided "AS IS" and "WITH ALL FAULTS". regarding this product, including but not limited to, any implied warranties of The Domino Team may make changes to specifications and product Global Marine Networks disclaims all other warranties express or implied, merchantibility or fitness for any particular application. descriptions at any time, without notice.

Ceramic capacitors are ±10% 50V X7R dielectric 0402 unless otherwise specified Resistors are 5% 1/16W 0402 unless otherwise specified

## DRILL CHART: TOP TO BOTTOM

A

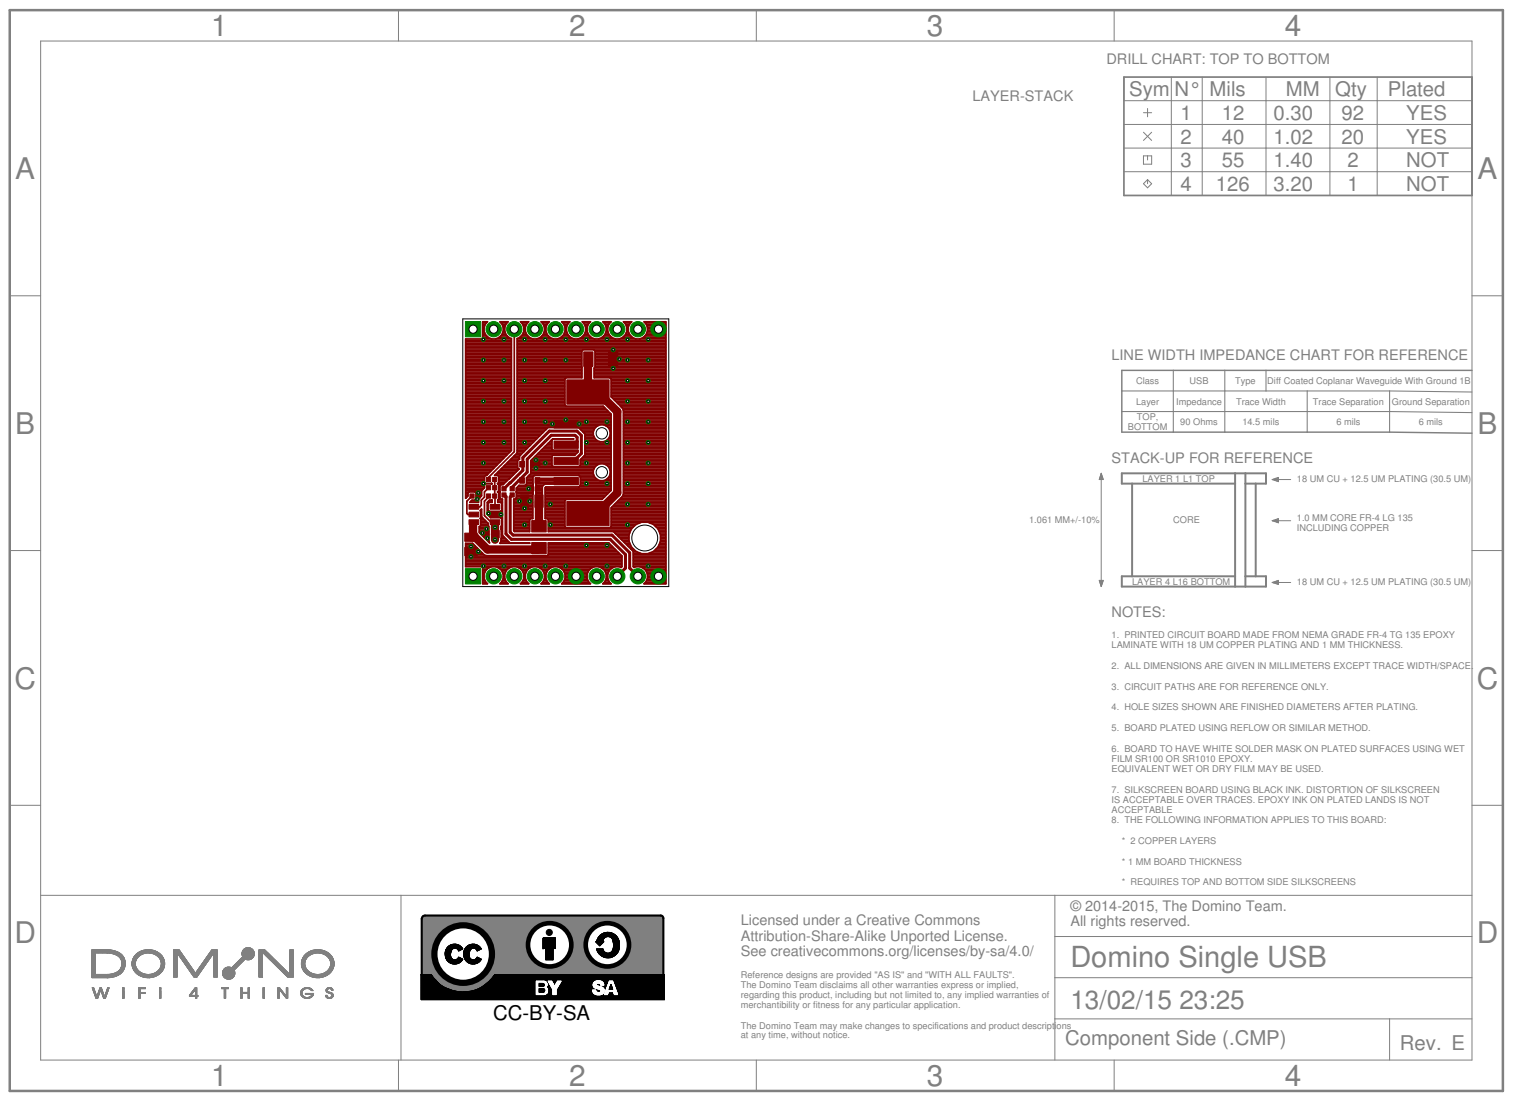
[picture p67: page 2]
LAYER 1 L1 TOP; LAYER 4 L16 BOTTOM; CORE; © 2014-2015, The Domino Team. All rights reserved.; Rev. E; LAYER-STACK; Sym N° Mils; MM Qty Plated; YES; NOT

LINE WIDTH IMPEDANCE CHART FOR REFERENCE

Layer | 90 Ohms USB Impedance | Type 14.5 mils Trace Width | 6 mils Trace Separation | 6 mils Class Ground Separation TOP, BOTTOM

Diff Coated Coplanar Waveguide With Ground 1B

1.061 MM+/-10% STACK-UP FOR REFERENCE

18 UM CU + 12.5 UM PLATING (30.5 UM)

1.0 MM CORE FR-4 LG 135
INCLUDING COPPER

NOTES: 2. ALL DIMENSIONS ARE GIVEN IN MILLIMETERS EXCEPT TRACE WIDTH/SPACE. 3. CIRCUIT PATHS ARE FOR REFERENCE ONLY.

1. PRINTED CIRCUIT BOARD MADE FROM NEMA GRADE FR-4 TG 135 EPOXY
LAMINATE WITH 18 UM COPPER PLATING AND 1 MM THICKNESS.

4. HOLE SIZES SHOWN ARE FINISHED DIAMETERS AFTER PLATING. 5. BOARD PLATED USING REFLOW OR SIMILAR METHOD. 6. BOARD TO HAVE WHITE SOLDER MASK ON PLATED SURFACES USING WET

FILM SR100 OR SR1010 EPOXY. EQUIVALENT WET OR DRY FILM MAY BE USED. 8. THE FOLLOWING INFORMATION APPLIES TO THIS BOARD: 7. SILKSCREEN BOARD USING BLACK INK. DISTORTION OF SILKSCREEN

IS ACCEPTABLE OVER TRACES. EPOXY INK ON PLATED LANDS IS NOT ACCEPTABLE

* 2 COPPER LAYERS
* 1 MM BOARD THICKNESS
* REQUIRES TOP AND BOTTOM SIDE SILKSCREENS
Domino Single USB

Licensed under a Creative Commons Attribution-Share-Alike Unported License. See creativecommons.org/licenses/by-sa/4.0/ Reference designs are provided "AS IS" and "WITH ALL FAULTS". The Domino Team disclaims all other warranties express or implied, regarding this product, including but not limited to, any implied warranties of merchantibility or fitness for any particular application. The Domino Team may make changes to specifications and product descriptions at any time, without notice. CC-BY-SA

Component Side (.CMP)

## DRILL CHART: TOP TO BOTTOM

A

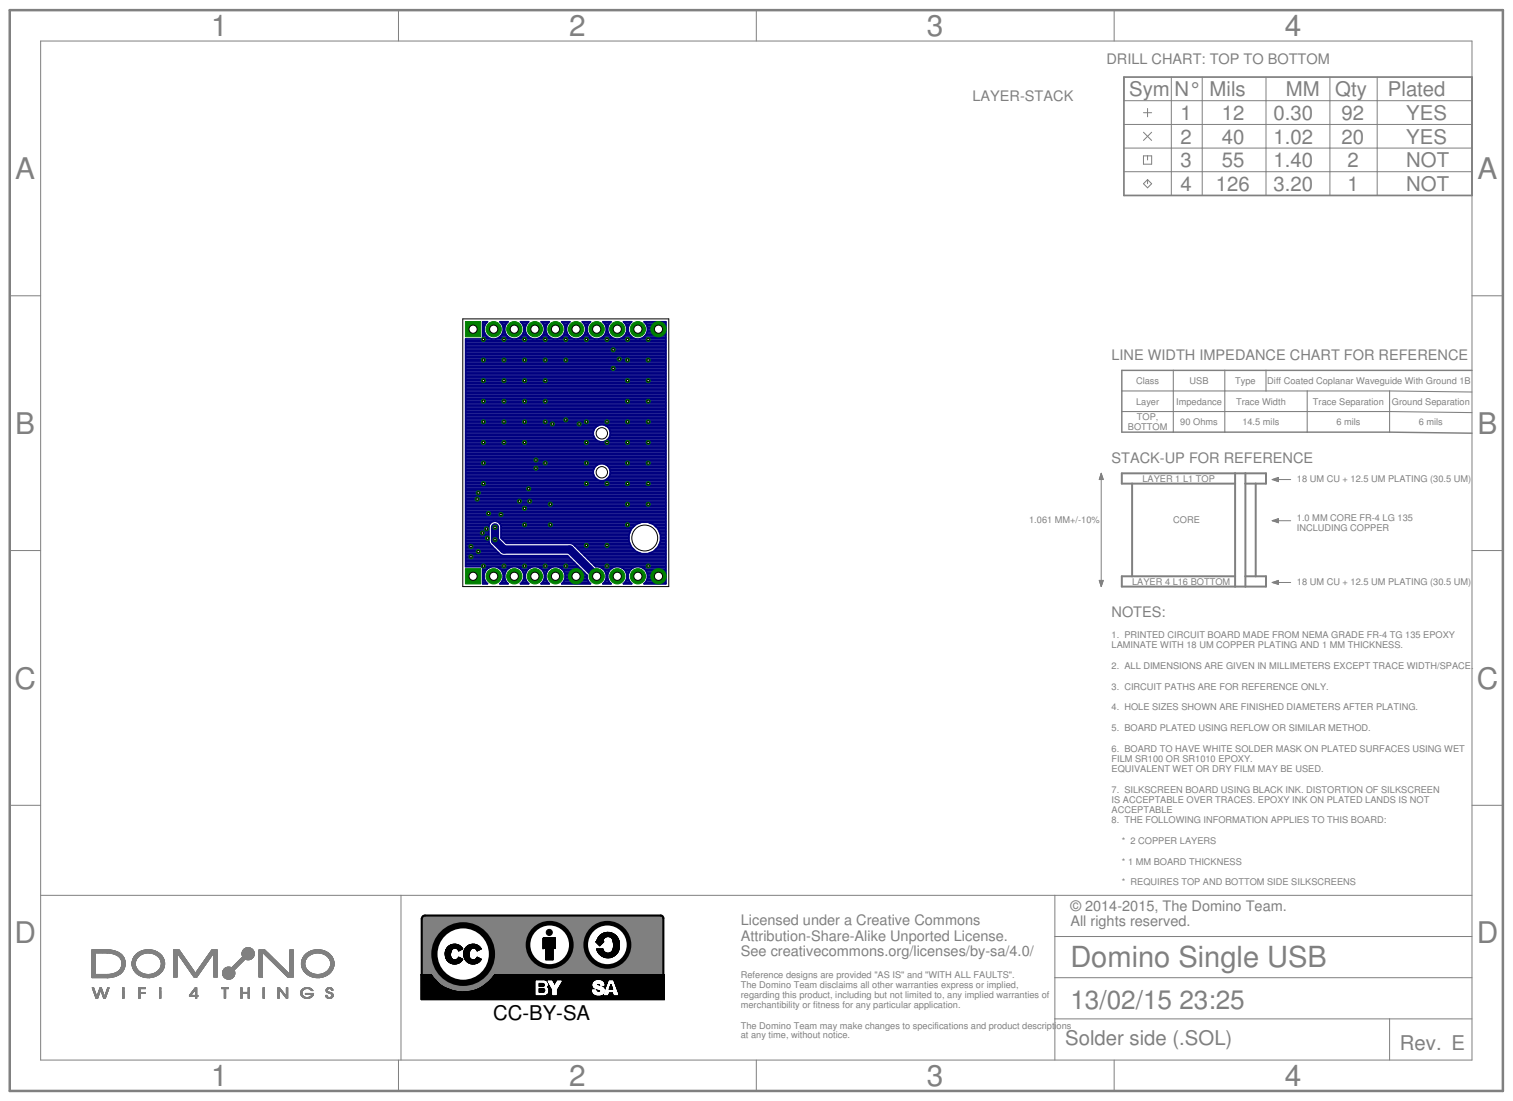
[picture p68: page 3]
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

LINE WIDTH IMPEDANCE CHART FOR REFERENCE

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

Diff Coated Coplanar Waveguide With Ground 1B

1.061 MM+/-10% STACK-UP FOR REFERENCE

18 UM CU + 12.5 UM PLATING (30.5 UM)

1.0 MM CORE FR-4 LG 135
INCLUDING COPPER

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

1. PRINTED CIRCUIT BOARD MADE FROM NEMA GRADE FR-4 TG 135 EPOXY
LAMINATE WITH 18 UM COPPER PLATING AND 1 MM THICKNESS.

4. HOLE SIZES SHOWN ARE FINISHED DIAMETERS AFTER PLATING. 5. BOARD PLATED USING REFLOW OR SIMILAR METHOD. 6. BOARD TO HAVE WHITE SOLDER MASK ON PLATED SURFACES USING WET

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

IS ACCEPTABLE OVER TRACES. EPOXY INK ON PLATED LANDS IS NOT ACCEPTABLE

* 2 COPPER LAYERS
* 1 MM BOARD THICKNESS
* REQUIRES TOP AND BOTTOM SIDE SILKSCREENS
Domino Single USB

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

Solder side (.SOL)

## DRILL CHART: TOP TO BOTTOM

A

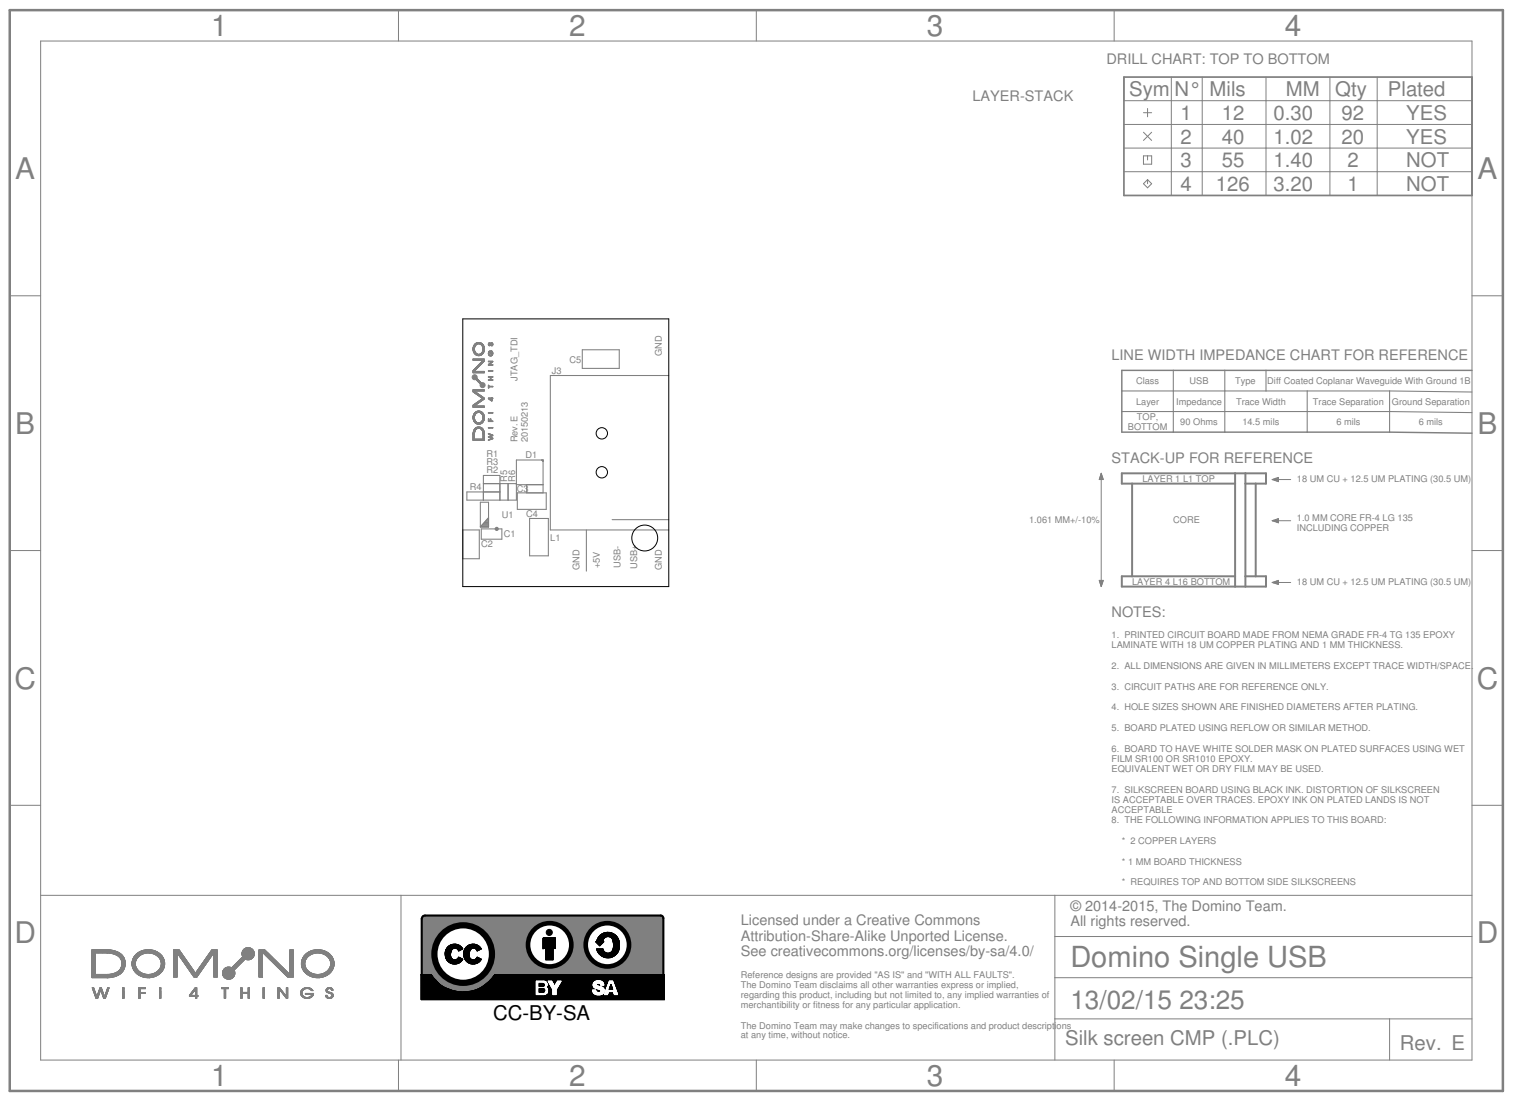
[picture p69: page 4]

LINE WIDTH IMPEDANCE CHART FOR REFERENCE

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

Diff Coated Coplanar Waveguide With Ground 1B

1.061 MM+/-10% STACK-UP FOR REFERENCE

18 UM CU + 12.5 UM PLATING (30.5 UM)

1.0 MM CORE FR-4 LG 135
INCLUDING COPPER

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

1. PRINTED CIRCUIT BOARD MADE FROM NEMA GRADE FR-4 TG 135 EPOXY
LAMINATE WITH 18 UM COPPER PLATING AND 1 MM THICKNESS.

4. HOLE SIZES SHOWN ARE FINISHED DIAMETERS AFTER PLATING. 5. BOARD PLATED USING REFLOW OR SIMILAR METHOD. 6. BOARD TO HAVE WHITE SOLDER MASK ON PLATED SURFACES USING WET

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

IS ACCEPTABLE OVER TRACES. EPOXY INK ON PLATED LANDS IS NOT ACCEPTABLE

* 2 COPPER LAYERS
* 1 MM BOARD THICKNESS
* REQUIRES TOP AND BOTTOM SIDE SILKSCREENS
Domino Single USB

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

Silk screen CMP (.PLC)

## DRILL CHART: TOP TO BOTTOM

A

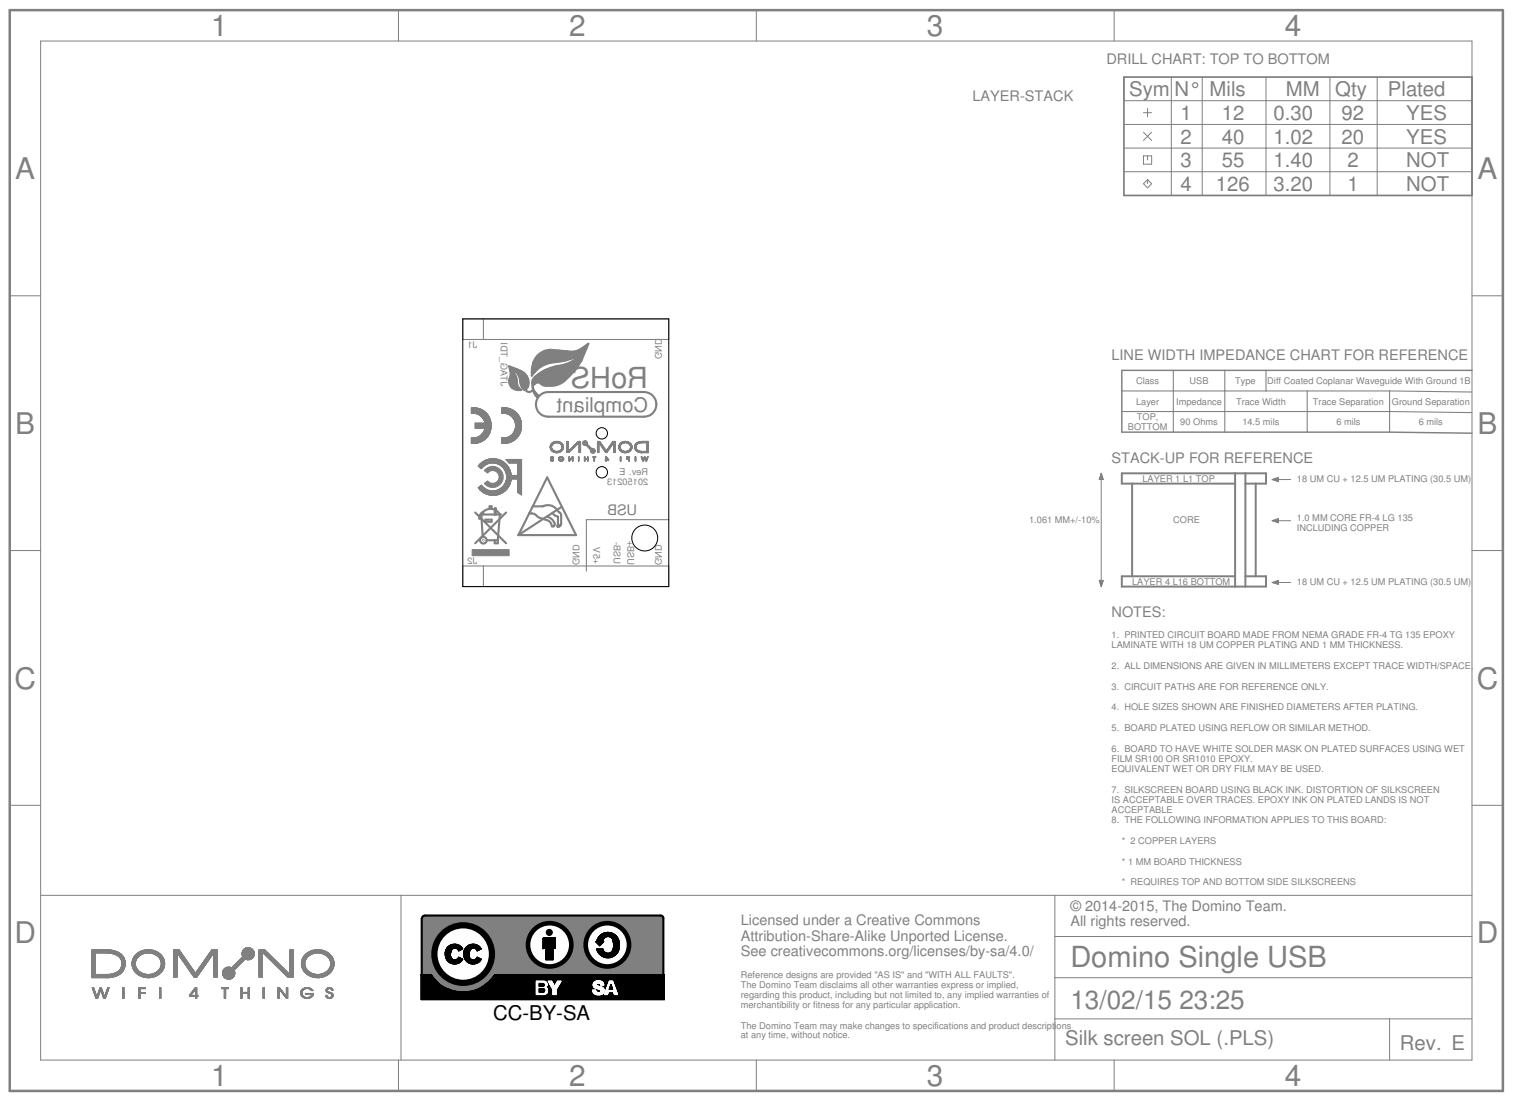
[picture p70: page 5]
GND BSU; GND; JTAG_TDI SHo R; LAYER 1 L1 TOP; LAYER 4 L16 BOTTOM; CORE; © 2014-2015, The Domino Team. All rights reserved.; Rev. E; LAYER-STACK; Sym N° Mils; MM Qty Plated; YES; NOT

LINE WIDTH IMPEDANCE CHART FOR REFERENCE

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

Diff Coated Coplanar Waveguide With Ground 1B

1.061 MM+/-10% STACK-UP FOR REFERENCE

18 UM CU + 12.5 UM PLATING (30.5 UM)

1.0 MM CORE FR-4 LG 135
INCLUDING COPPER

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

1. PRINTED CIRCUIT BOARD MADE FROM NEMA GRADE FR-4 TG 135 EPOXY
LAMINATE WITH 18 UM COPPER PLATING AND 1 MM THICKNESS.

4. HOLE SIZES SHOWN ARE FINISHED DIAMETERS AFTER PLATING. 5. BOARD PLATED USING REFLOW OR SIMILAR METHOD. 6. BOARD TO HAVE WHITE SOLDER MASK ON PLATED SURFACES USING WET

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

IS ACCEPTABLE OVER TRACES. EPOXY INK ON PLATED LANDS IS NOT ACCEPTABLE

* 2 COPPER LAYERS
* 1 MM BOARD THICKNESS
* REQUIRES TOP AND BOTTOM SIDE SILKSCREENS
Domino Single USB

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

Silk screen SOL (.PLS)

## DRILL CHART: TOP TO BOTTOM

A

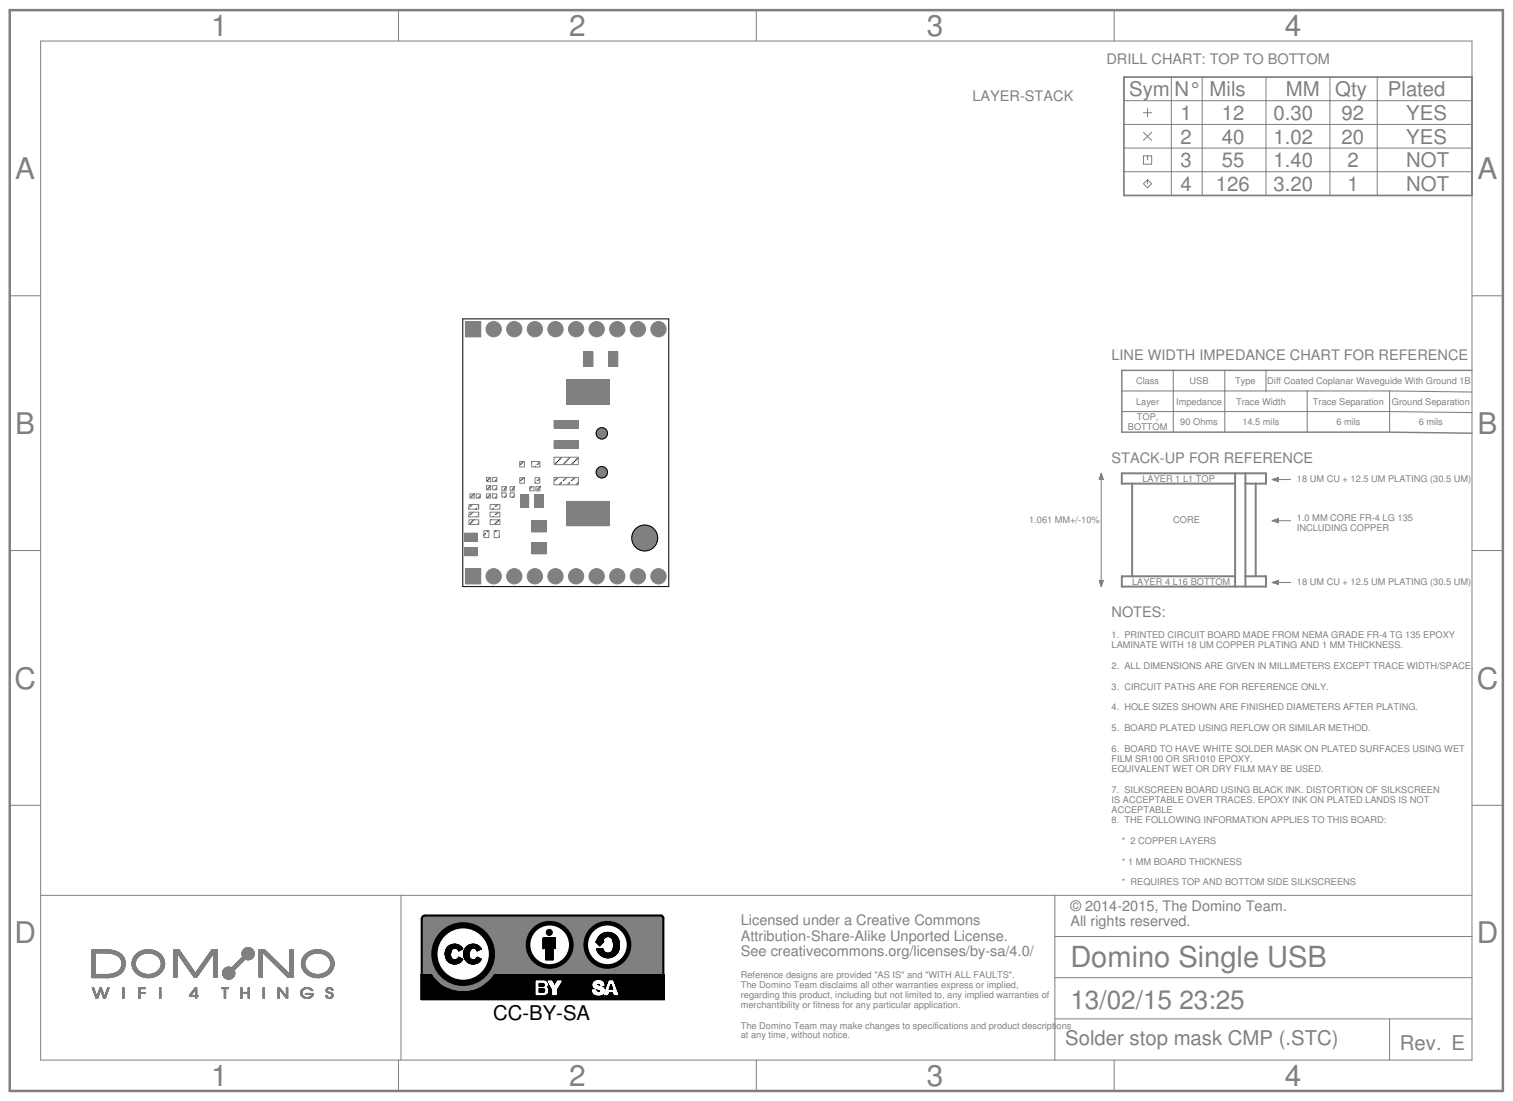
[picture p71: page 6]
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

LINE WIDTH IMPEDANCE CHART FOR REFERENCE

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

Diff Coated Coplanar Waveguide With Ground 1B

1.061 MM+/-10% STACK-UP FOR REFERENCE

18 UM CU + 12.5 UM PLATING (30.5 UM)

1.0 MM CORE FR-4 LG 135
INCLUDING COPPER

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

1. PRINTED CIRCUIT BOARD MADE FROM NEMA GRADE FR-4 TG 135 EPOXY
LAMINATE WITH 18 UM COPPER PLATING AND 1 MM THICKNESS.

4. HOLE SIZES SHOWN ARE FINISHED DIAMETERS AFTER PLATING. 5. BOARD PLATED USING REFLOW OR SIMILAR METHOD. 6. BOARD TO HAVE WHITE SOLDER MASK ON PLATED SURFACES USING WET

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

IS ACCEPTABLE OVER TRACES. EPOXY INK ON PLATED LANDS IS NOT ACCEPTABLE

* 2 COPPER LAYERS
* 1 MM BOARD THICKNESS
* REQUIRES TOP AND BOTTOM SIDE SILKSCREENS
Domino Single USB

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

Solder stop mask CMP (.STC)

## DRILL CHART: TOP TO BOTTOM

A

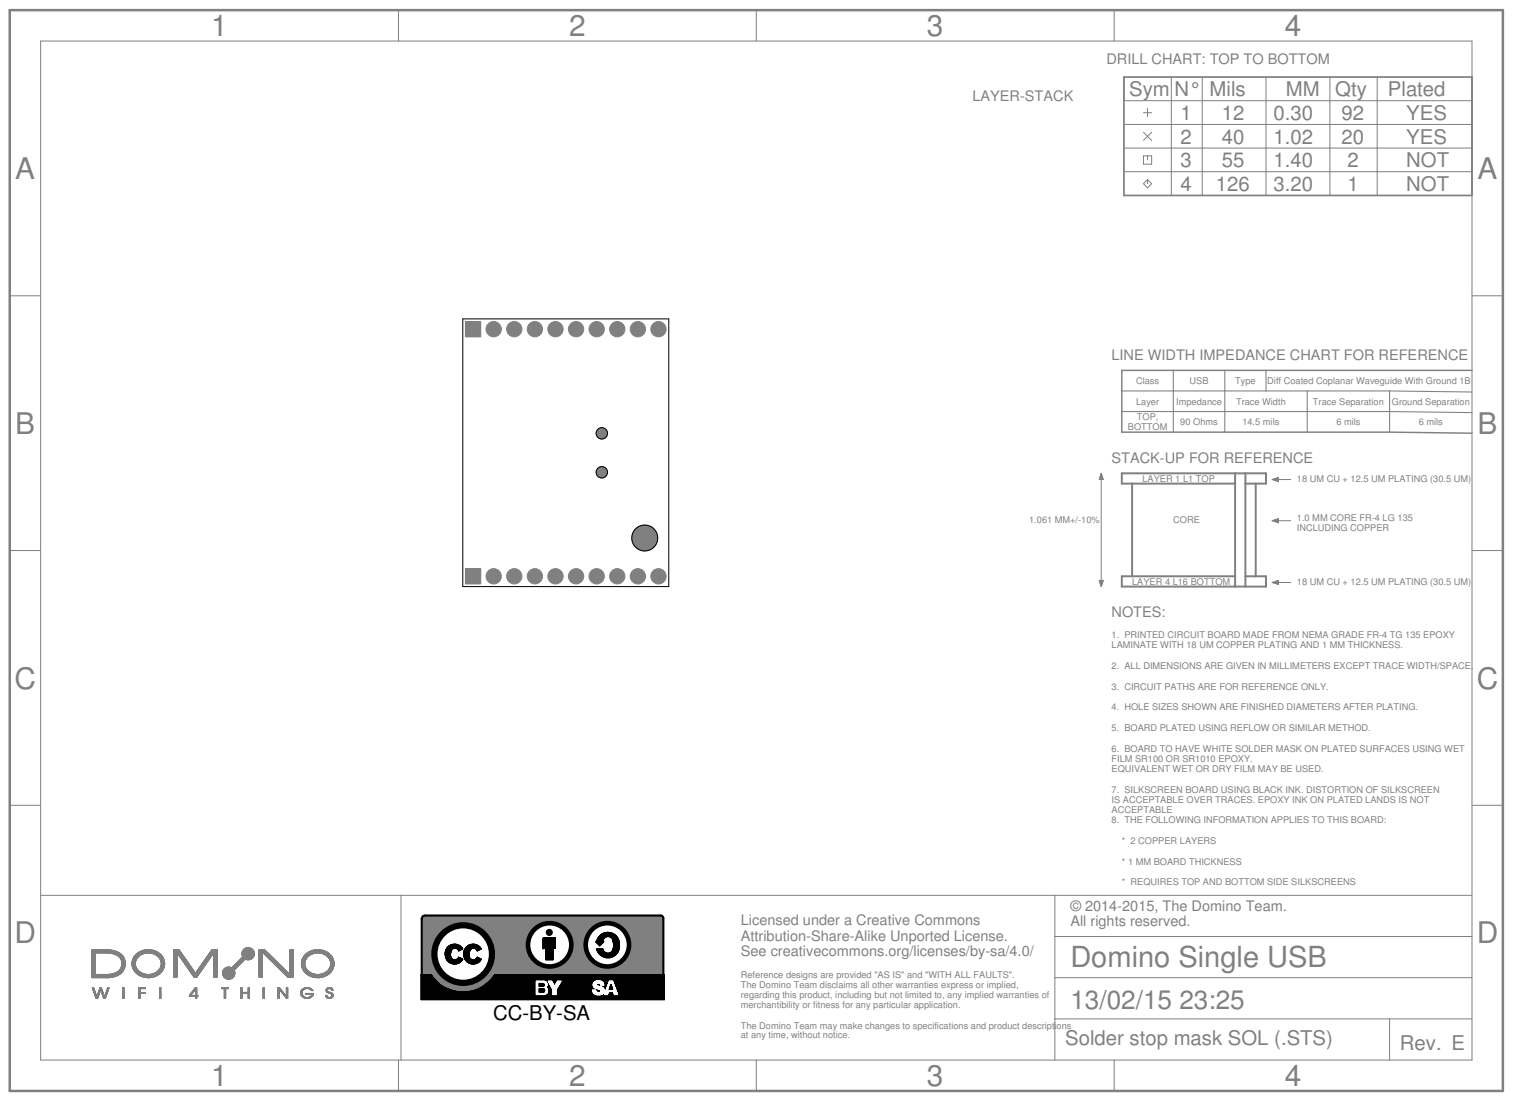
[picture p72: page 7]
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

LINE WIDTH IMPEDANCE CHART FOR REFERENCE

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

Diff Coated Coplanar Waveguide With Ground 1B

1.061 MM+/-10% STACK-UP FOR REFERENCE

18 UM CU + 12.5 UM PLATING (30.5 UM)

1.0 MM CORE FR-4 LG 135
INCLUDING COPPER

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

1. PRINTED CIRCUIT BOARD MADE FROM NEMA GRADE FR-4 TG 135 EPOXY
LAMINATE WITH 18 UM COPPER PLATING AND 1 MM THICKNESS.

4. HOLE SIZES SHOWN ARE FINISHED DIAMETERS AFTER PLATING. 5. BOARD PLATED USING REFLOW OR SIMILAR METHOD. 6. BOARD TO HAVE WHITE SOLDER MASK ON PLATED SURFACES USING WET

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

IS ACCEPTABLE OVER TRACES. EPOXY INK ON PLATED LANDS IS NOT ACCEPTABLE

* 2 COPPER LAYERS
* 1 MM BOARD THICKNESS
* REQUIRES TOP AND BOTTOM SIDE SILKSCREENS
Domino Single USB

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

Solder stop mask SOL (.STS)

## DRILL CHART: TOP TO BOTTOM

A

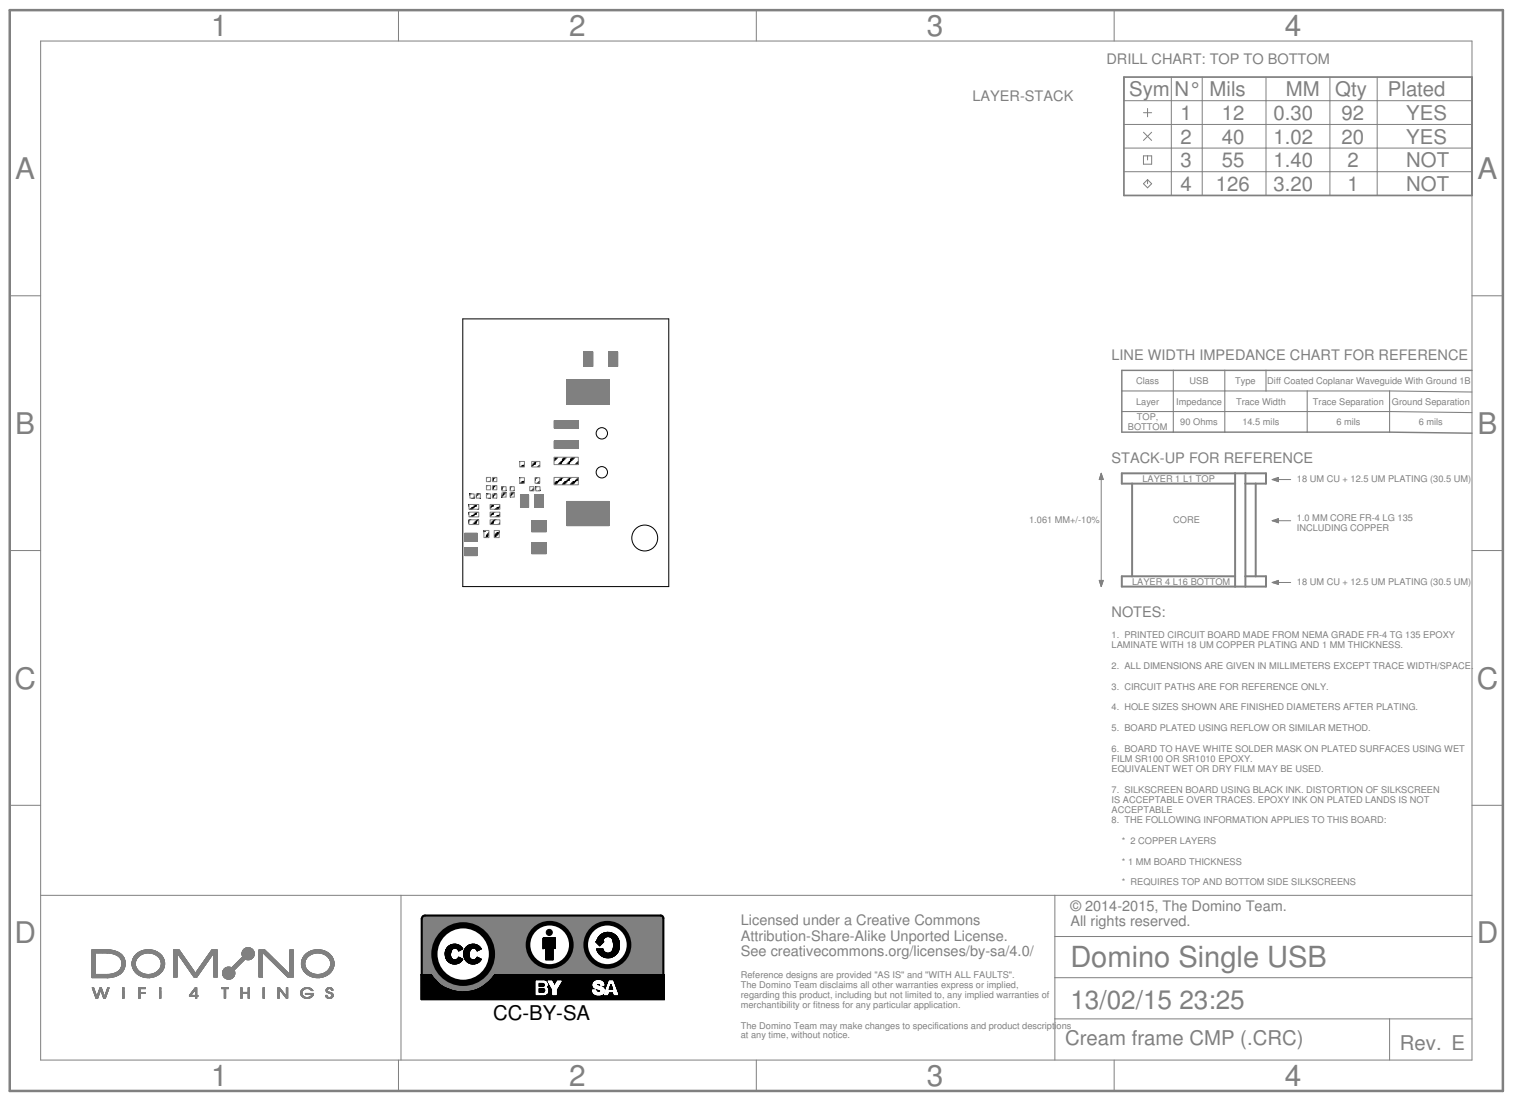
[picture p73: page 8]
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

LINE WIDTH IMPEDANCE CHART FOR REFERENCE

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

Diff Coated Coplanar Waveguide With Ground 1B

1.061 MM+/-10% STACK-UP FOR REFERENCE

18 UM CU + 12.5 UM PLATING (30.5 UM)

1.0 MM CORE FR-4 LG 135
INCLUDING COPPER

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

1. PRINTED CIRCUIT BOARD MADE FROM NEMA GRADE FR-4 TG 135 EPOXY
LAMINATE WITH 18 UM COPPER PLATING AND 1 MM THICKNESS.

4. HOLE SIZES SHOWN ARE FINISHED DIAMETERS AFTER PLATING. 5. BOARD PLATED USING REFLOW OR SIMILAR METHOD. 6. BOARD TO HAVE WHITE SOLDER MASK ON PLATED SURFACES USING WET

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

IS ACCEPTABLE OVER TRACES. EPOXY INK ON PLATED LANDS IS NOT ACCEPTABLE

* 2 COPPER LAYERS
* 1 MM BOARD THICKNESS
* REQUIRES TOP AND BOTTOM SIDE SILKSCREENS
Domino Single USB

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

Cream frame CMP (.CRC)

## DRILL CHART: TOP TO BOTTOM

A

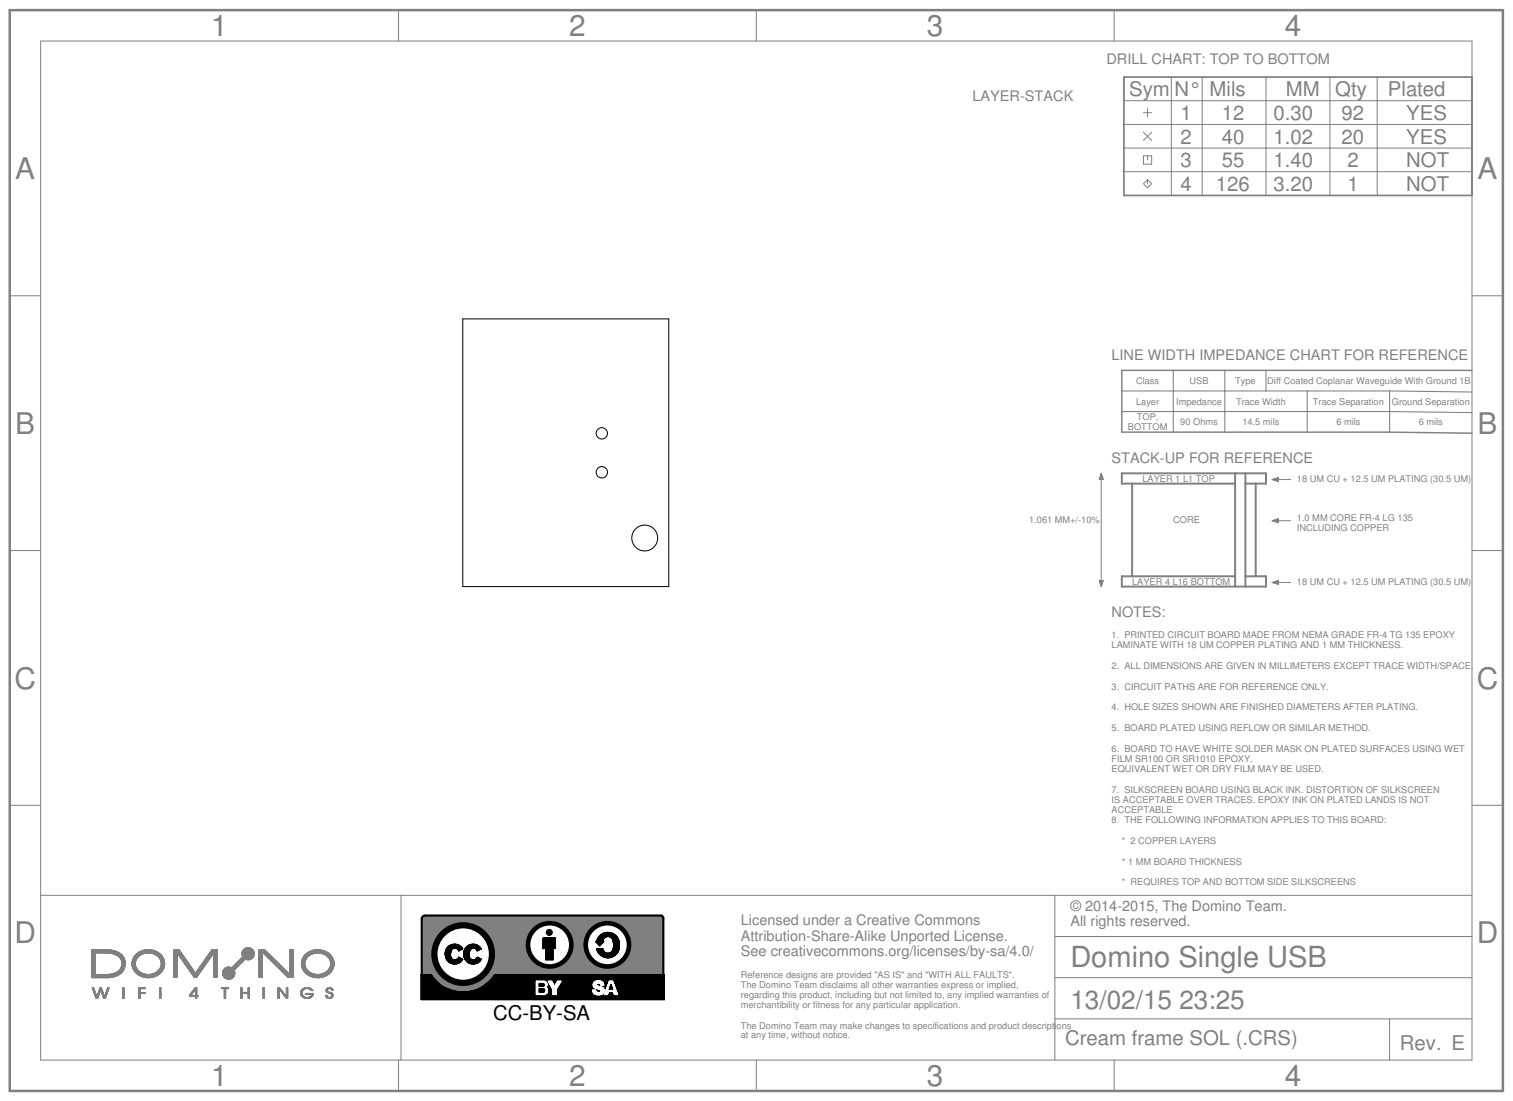
[picture p74: page 9]
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

LINE WIDTH IMPEDANCE CHART FOR REFERENCE

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

Diff Coated Coplanar Waveguide With Ground 1B

1.061 MM+/-10% STACK-UP FOR REFERENCE

18 UM CU + 12.5 UM PLATING (30.5 UM)

1.0 MM CORE FR-4 LG 135
INCLUDING COPPER

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

1. PRINTED CIRCUIT BOARD MADE FROM NEMA GRADE FR-4 TG 135 EPOXY
LAMINATE WITH 18 UM COPPER PLATING AND 1 MM THICKNESS.

4. HOLE SIZES SHOWN ARE FINISHED DIAMETERS AFTER PLATING. 5. BOARD PLATED USING REFLOW OR SIMILAR METHOD. 6. BOARD TO HAVE WHITE SOLDER MASK ON PLATED SURFACES USING WET

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

IS ACCEPTABLE OVER TRACES. EPOXY INK ON PLATED LANDS IS NOT ACCEPTABLE

* 2 COPPER LAYERS
* 1 MM BOARD THICKNESS
* REQUIRES TOP AND BOTTOM SIDE SILKSCREENS
Domino Single USB

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

Cream frame SOL (.CRS)

## DRILL CHART: TOP TO BOTTOM

A

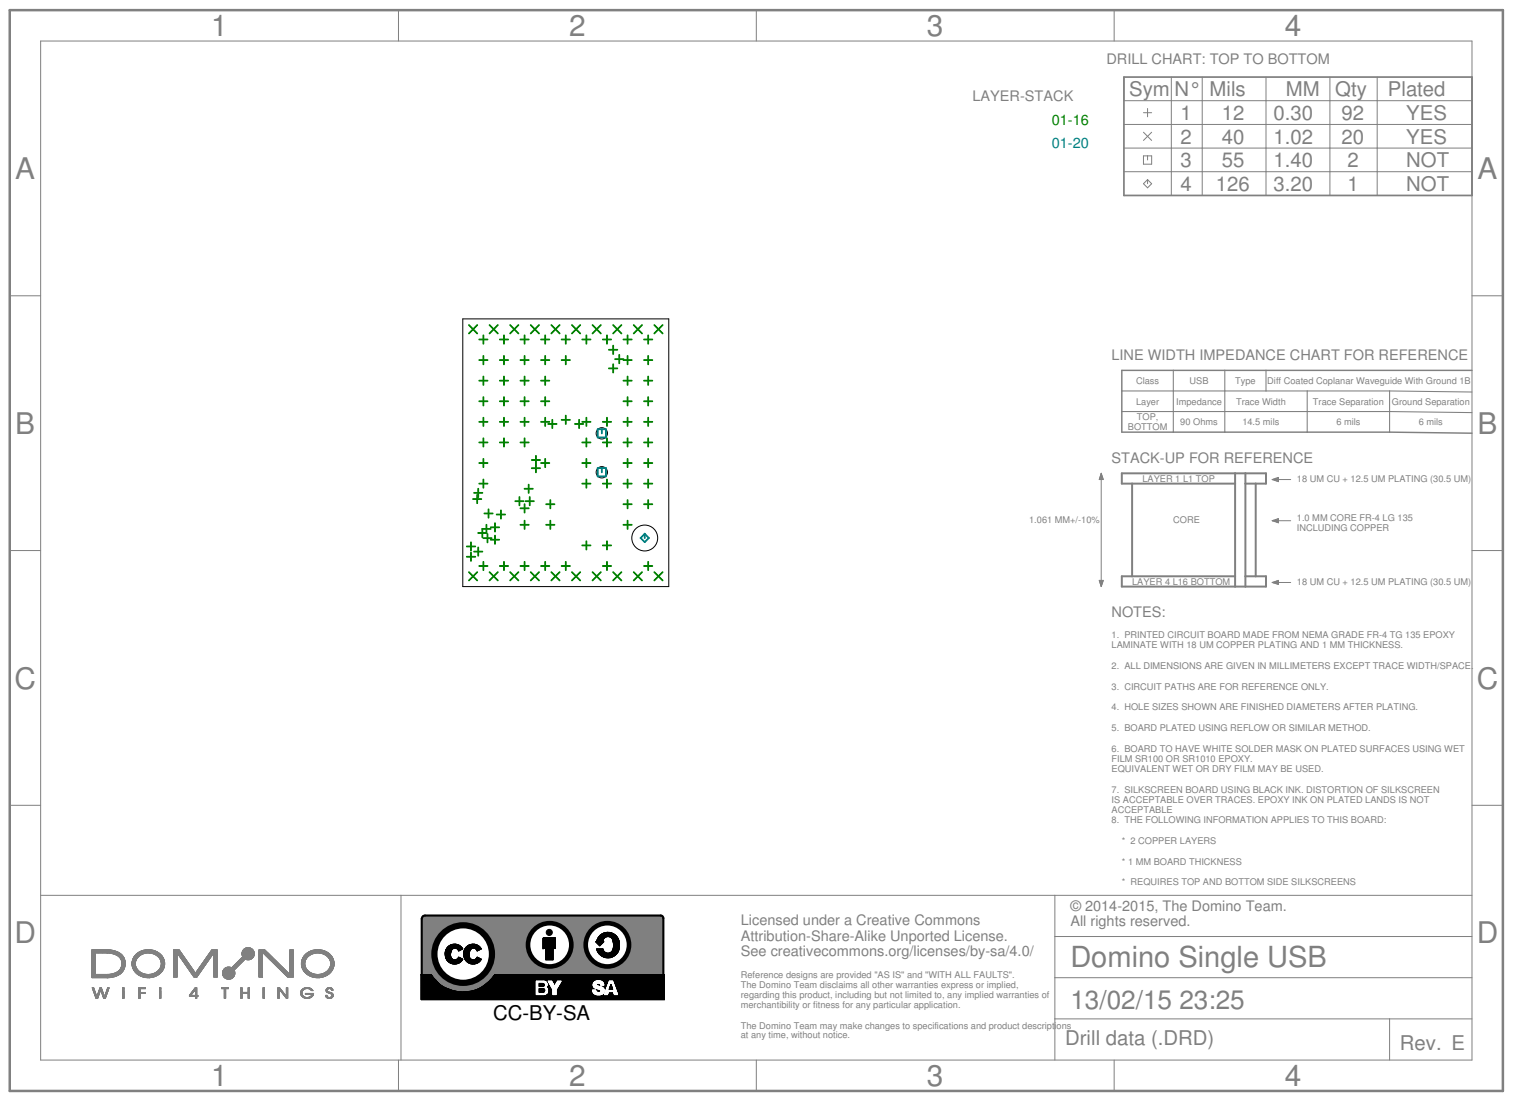
[picture p75: page 10]
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

LINE WIDTH IMPEDANCE CHART FOR REFERENCE

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

Diff Coated Coplanar Waveguide With Ground 1B

1.061 MM+/-10% STACK-UP FOR REFERENCE

18 UM CU + 12.5 UM PLATING (30.5 UM)

1.0 MM CORE FR-4 LG 135
INCLUDING COPPER

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

1. PRINTED CIRCUIT BOARD MADE FROM NEMA GRADE FR-4 TG 135 EPOXY
LAMINATE WITH 18 UM COPPER PLATING AND 1 MM THICKNESS.

4. HOLE SIZES SHOWN ARE FINISHED DIAMETERS AFTER PLATING. 5. BOARD PLATED USING REFLOW OR SIMILAR METHOD. 6. BOARD TO HAVE WHITE SOLDER MASK ON PLATED SURFACES USING WET

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

IS ACCEPTABLE OVER TRACES. EPOXY INK ON PLATED LANDS IS NOT ACCEPTABLE

* 2 COPPER LAYERS
* 1 MM BOARD THICKNESS
* REQUIRES TOP AND BOTTOM SIDE SILKSCREENS
Domino Single USB

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

Drill data (.DRD)

## DRILL CHART: TOP TO BOTTOM

A

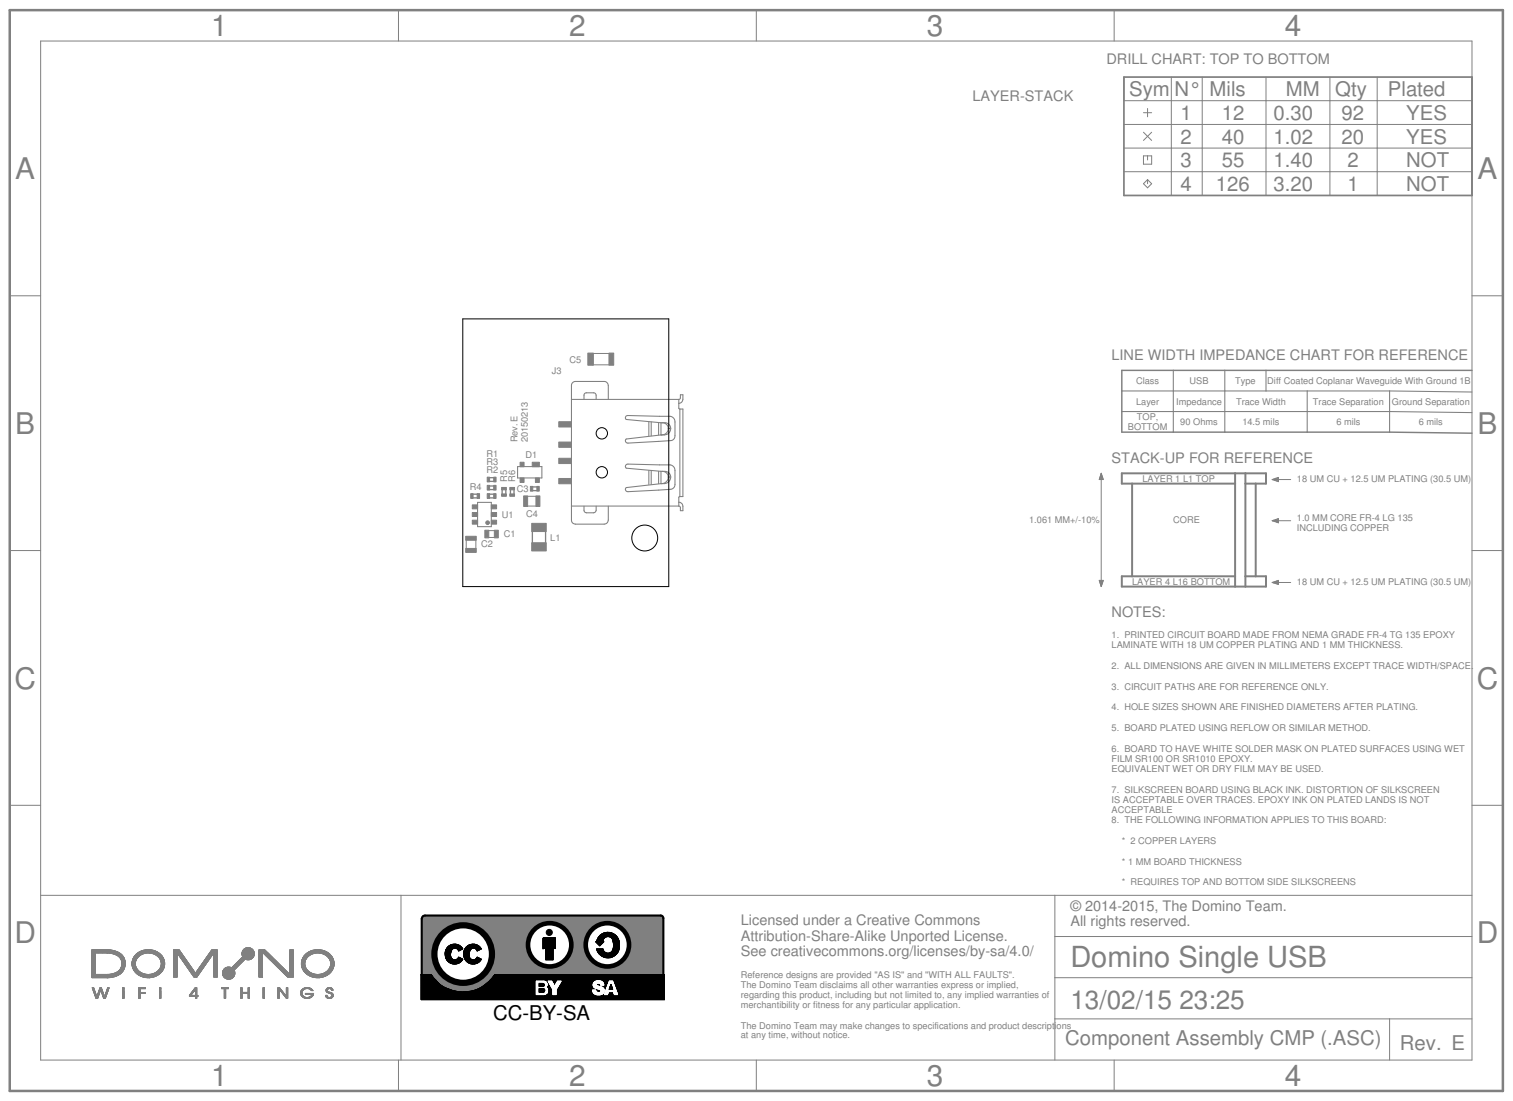
[picture p76: page 11]

LINE WIDTH IMPEDANCE CHART FOR REFERENCE

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

Diff Coated Coplanar Waveguide With Ground 1B

1.061 MM+/-10% STACK-UP FOR REFERENCE

18 UM CU + 12.5 UM PLATING (30.5 UM)

1.0 MM CORE FR-4 LG 135
INCLUDING COPPER

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

1. PRINTED CIRCUIT BOARD MADE FROM NEMA GRADE FR-4 TG 135 EPOXY
LAMINATE WITH 18 UM COPPER PLATING AND 1 MM THICKNESS.

4. HOLE SIZES SHOWN ARE FINISHED DIAMETERS AFTER PLATING. 5. BOARD PLATED USING REFLOW OR SIMILAR METHOD. 6. BOARD TO HAVE WHITE SOLDER MASK ON PLATED SURFACES USING WET

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

IS ACCEPTABLE OVER TRACES. EPOXY INK ON PLATED LANDS IS NOT ACCEPTABLE

* 2 COPPER LAYERS
* 1 MM BOARD THICKNESS
* REQUIRES TOP AND BOTTOM SIDE SILKSCREENS
Domino Single USB

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

Component Assembly CMP (.ASC)

## DRILL CHART: TOP TO BOTTOM

A

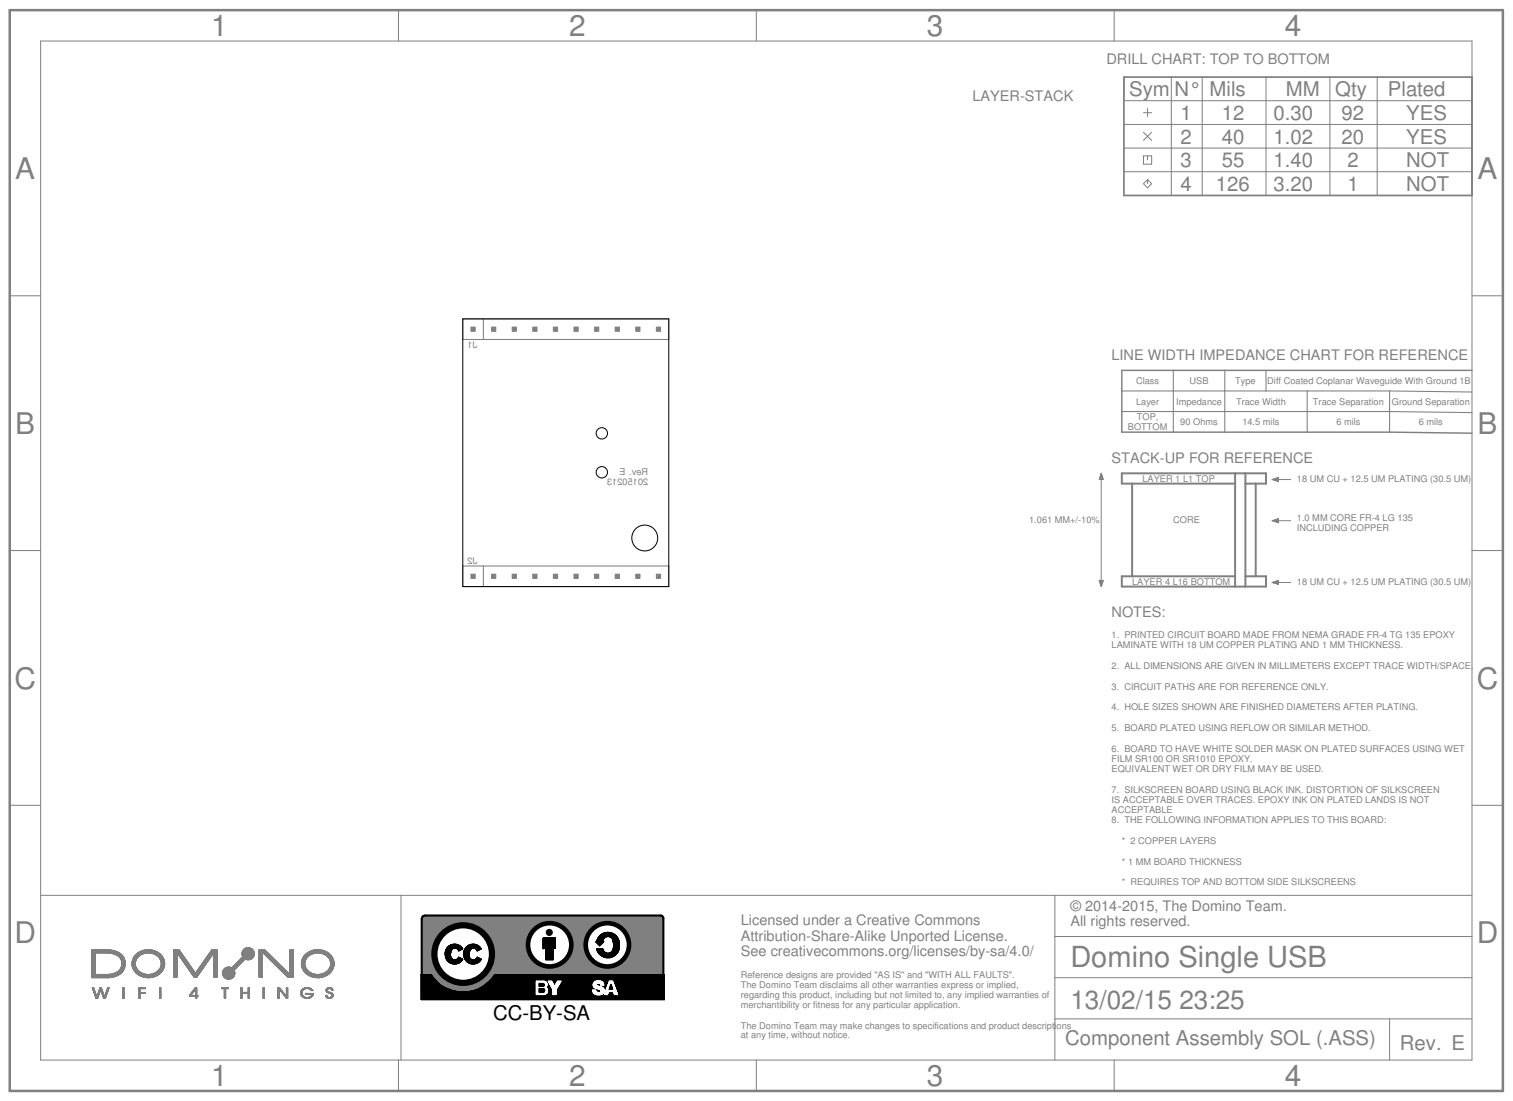
[picture p77: page 12]
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

LINE WIDTH IMPEDANCE CHART FOR REFERENCE

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

Diff Coated Coplanar Waveguide With Ground 1B

1.061 MM+/-10% STACK-UP FOR REFERENCE

18 UM CU + 12.5 UM PLATING (30.5 UM)

1.0 MM CORE FR-4 LG 135
INCLUDING COPPER

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

1. PRINTED CIRCUIT BOARD MADE FROM NEMA GRADE FR-4 TG 135 EPOXY
LAMINATE WITH 18 UM COPPER PLATING AND 1 MM THICKNESS.

4. HOLE SIZES SHOWN ARE FINISHED DIAMETERS AFTER PLATING. 5. BOARD PLATED USING REFLOW OR SIMILAR METHOD. 6. BOARD TO HAVE WHITE SOLDER MASK ON PLATED SURFACES USING WET

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

IS ACCEPTABLE OVER TRACES. EPOXY INK ON PLATED LANDS IS NOT ACCEPTABLE

* 2 COPPER LAYERS
* 1 MM BOARD THICKNESS
* REQUIRES TOP AND BOTTOM SIDE SILKSCREENS
Domino Single USB

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

Component Assembly SOL (.ASS)

## DRILL CHART: TOP TO BOTTOM

A

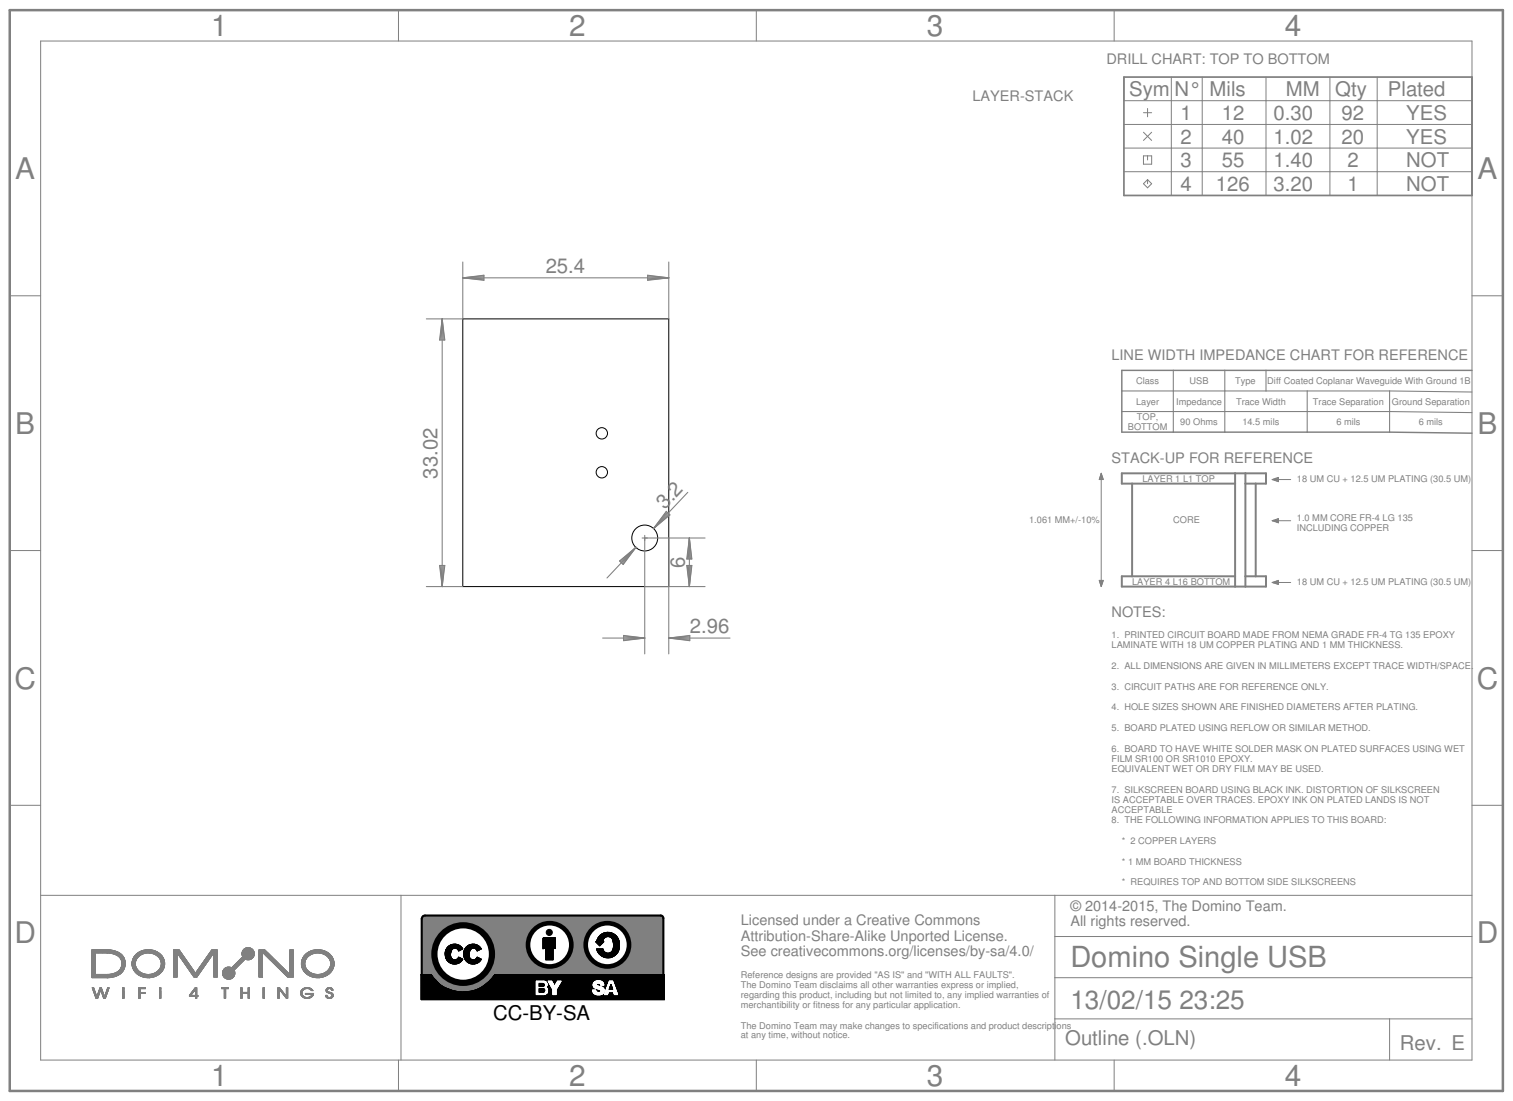
[picture p78: page 13]
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

LINE WIDTH IMPEDANCE CHART FOR REFERENCE

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

Diff Coated Coplanar Waveguide With Ground 1B

1.061 MM+/-10% STACK-UP FOR REFERENCE

18 UM CU + 12.5 UM PLATING (30.5 UM)

1.0 MM CORE FR-4 LG 135
INCLUDING COPPER

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

1. PRINTED CIRCUIT BOARD MADE FROM NEMA GRADE FR-4 TG 135 EPOXY
LAMINATE WITH 18 UM COPPER PLATING AND 1 MM THICKNESS.

4. HOLE SIZES SHOWN ARE FINISHED DIAMETERS AFTER PLATING. 5. BOARD PLATED USING REFLOW OR SIMILAR METHOD. 6. BOARD TO HAVE WHITE SOLDER MASK ON PLATED SURFACES USING WET

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

IS ACCEPTABLE OVER TRACES. EPOXY INK ON PLATED LANDS IS NOT ACCEPTABLE

* 2 COPPER LAYERS
* 1 MM BOARD THICKNESS
* REQUIRES TOP AND BOTTOM SIDE SILKSCREENS
Domino Single USB

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

Outline (.OLN)

## DRILL CHART: TOP TO BOTTOM

A

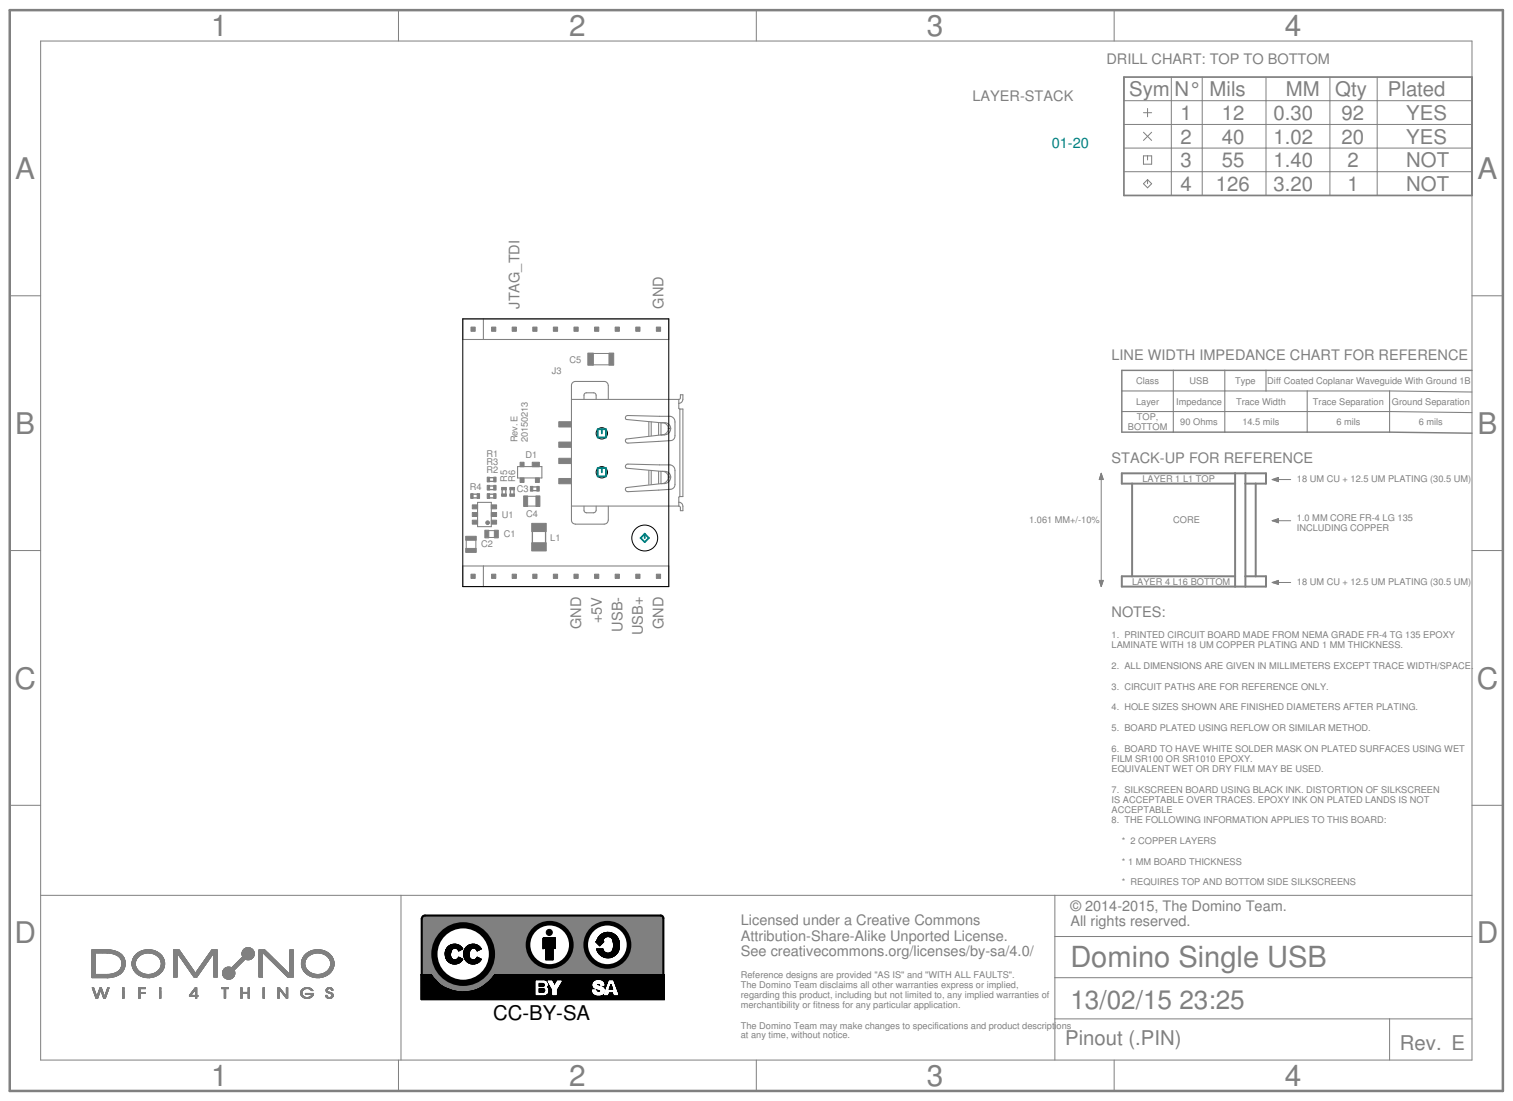
[picture p79: page 14]

LINE WIDTH IMPEDANCE CHART FOR REFERENCE

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

Diff Coated Coplanar Waveguide With Ground 1B

1.061 MM+/-10% STACK-UP FOR REFERENCE

18 UM CU + 12.5 UM PLATING (30.5 UM)

1.0 MM CORE FR-4 LG 135
INCLUDING COPPER

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

1. PRINTED CIRCUIT BOARD MADE FROM NEMA GRADE FR-4 TG 135 EPOXY
LAMINATE WITH 18 UM COPPER PLATING AND 1 MM THICKNESS.

4. HOLE SIZES SHOWN ARE FINISHED DIAMETERS AFTER PLATING. 5. BOARD PLATED USING REFLOW OR SIMILAR METHOD. 6. BOARD TO HAVE WHITE SOLDER MASK ON PLATED SURFACES USING WET

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

IS ACCEPTABLE OVER TRACES. EPOXY INK ON PLATED LANDS IS NOT ACCEPTABLE

* 2 COPPER LAYERS
* 1 MM BOARD THICKNESS
* REQUIRES TOP AND BOTTOM SIDE SILKSCREENS
Domino Single USB

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

Pinout (.PIN)

# Domino Single USB Rev. E

Item | | Manufacturer | | | | Description
1 | 3 0R | ANY | R0402_0R_5%_62.5mW | R0402 | R3, R5, R6 | RES 0.0 OHM 1/16W JUMP 0402 SMD
2 | 1 1n | ANY | C1206_1n_X7R_10%_CER_500V | C1206 | C5 | CAP CER 1000PF 500V 10% X7R 1206
3 | 1 10u | ANY | C0603_10u_X5R_20%_CER_6V3 | C0603 | C1 | CAP CER 10UF 6.3V 20% X5R 0603
4 | 1 10u | ANY | C0805_10u_X5R_10%_CER_16V | C0805 | C4 | CAP CER 10UF 16V 10% X5R 0805
5 | 1 15k | ANY | R0402_15k_5%_62.5mW | R0402 | R4 | RES 15K OHM 1/16W 5% 0402 SMD
6 | 1 22u | ANY | C0805_22u_X5R_20%_CER_6V3 | C0805 | C2 | CAP CER 22UF 6.3V 20% X5R 0805
7 | 1 33R | ANY | R0402_33R_5%_62.5mW | R0402 | R1 | RES 33 OHM 1/16W 5% 0402 SMD
8 | 1 100k | ANY | R0402_100k_5%_62.5mW | R0402 | R2 | RES 100K OHM 1/16W 5% 0402 SMD
9 | 1 100n | ANY | C0402_100n_X7R_10%_CER_50V | C0402 | C3 | CAP CER 0.1UF 50V 10% X7R 0402
10 | 1 BLM31PG601SN1L | MURATA | BLM31PG601SN1L | FB1206 | L1 | FERRITE CHIP 600 OHM 1500MA 1206
11 | 2 MH10-1 | ANY | MH10-1-0.1 | MH10-1-0.1 | J1, J2 | CONN HEADER VERT .100 1ROW 10POS 8.08 HEAD 3.05 TAIL 15AU
12 | 1 MP65151DJ | MONOLITHIC POWER | MP65151DJ | SOT23-6 | U1 | IC POWER SWITCH 1.7A SOT23-6
13 | 1 PRTR5V0U2X | NXP | PRTR5V0U2X | SOT143B | D1 | TVS DIODE ARRAY 2CH 5V SOT143
Qty | Value | Device | Package | Reference | Remarks
