domino-team/domino-hardware/Common/PDF/Domino Mechanical.pdf

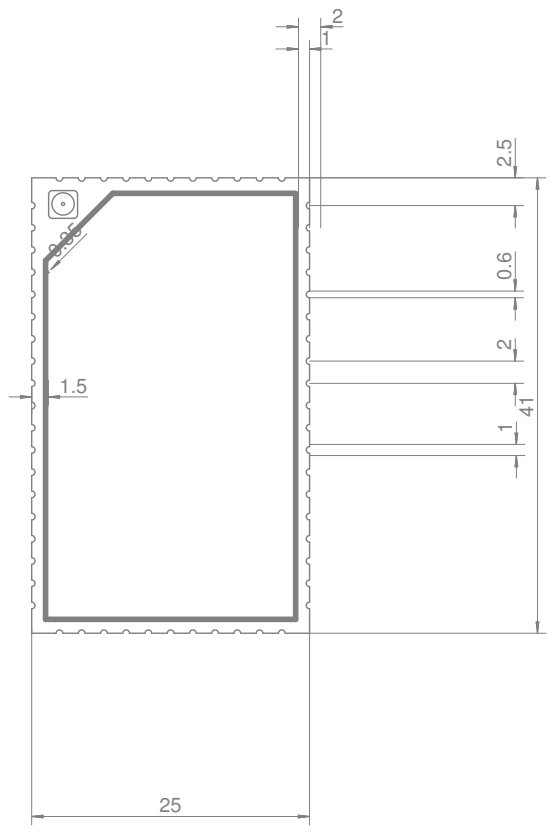
[picture p80: page 1]
