domino-team/domino-hardware/Domino Di/Domino Di.brd

## EAGLE design Domino Di/Domino Di.brd (2015-05-10)

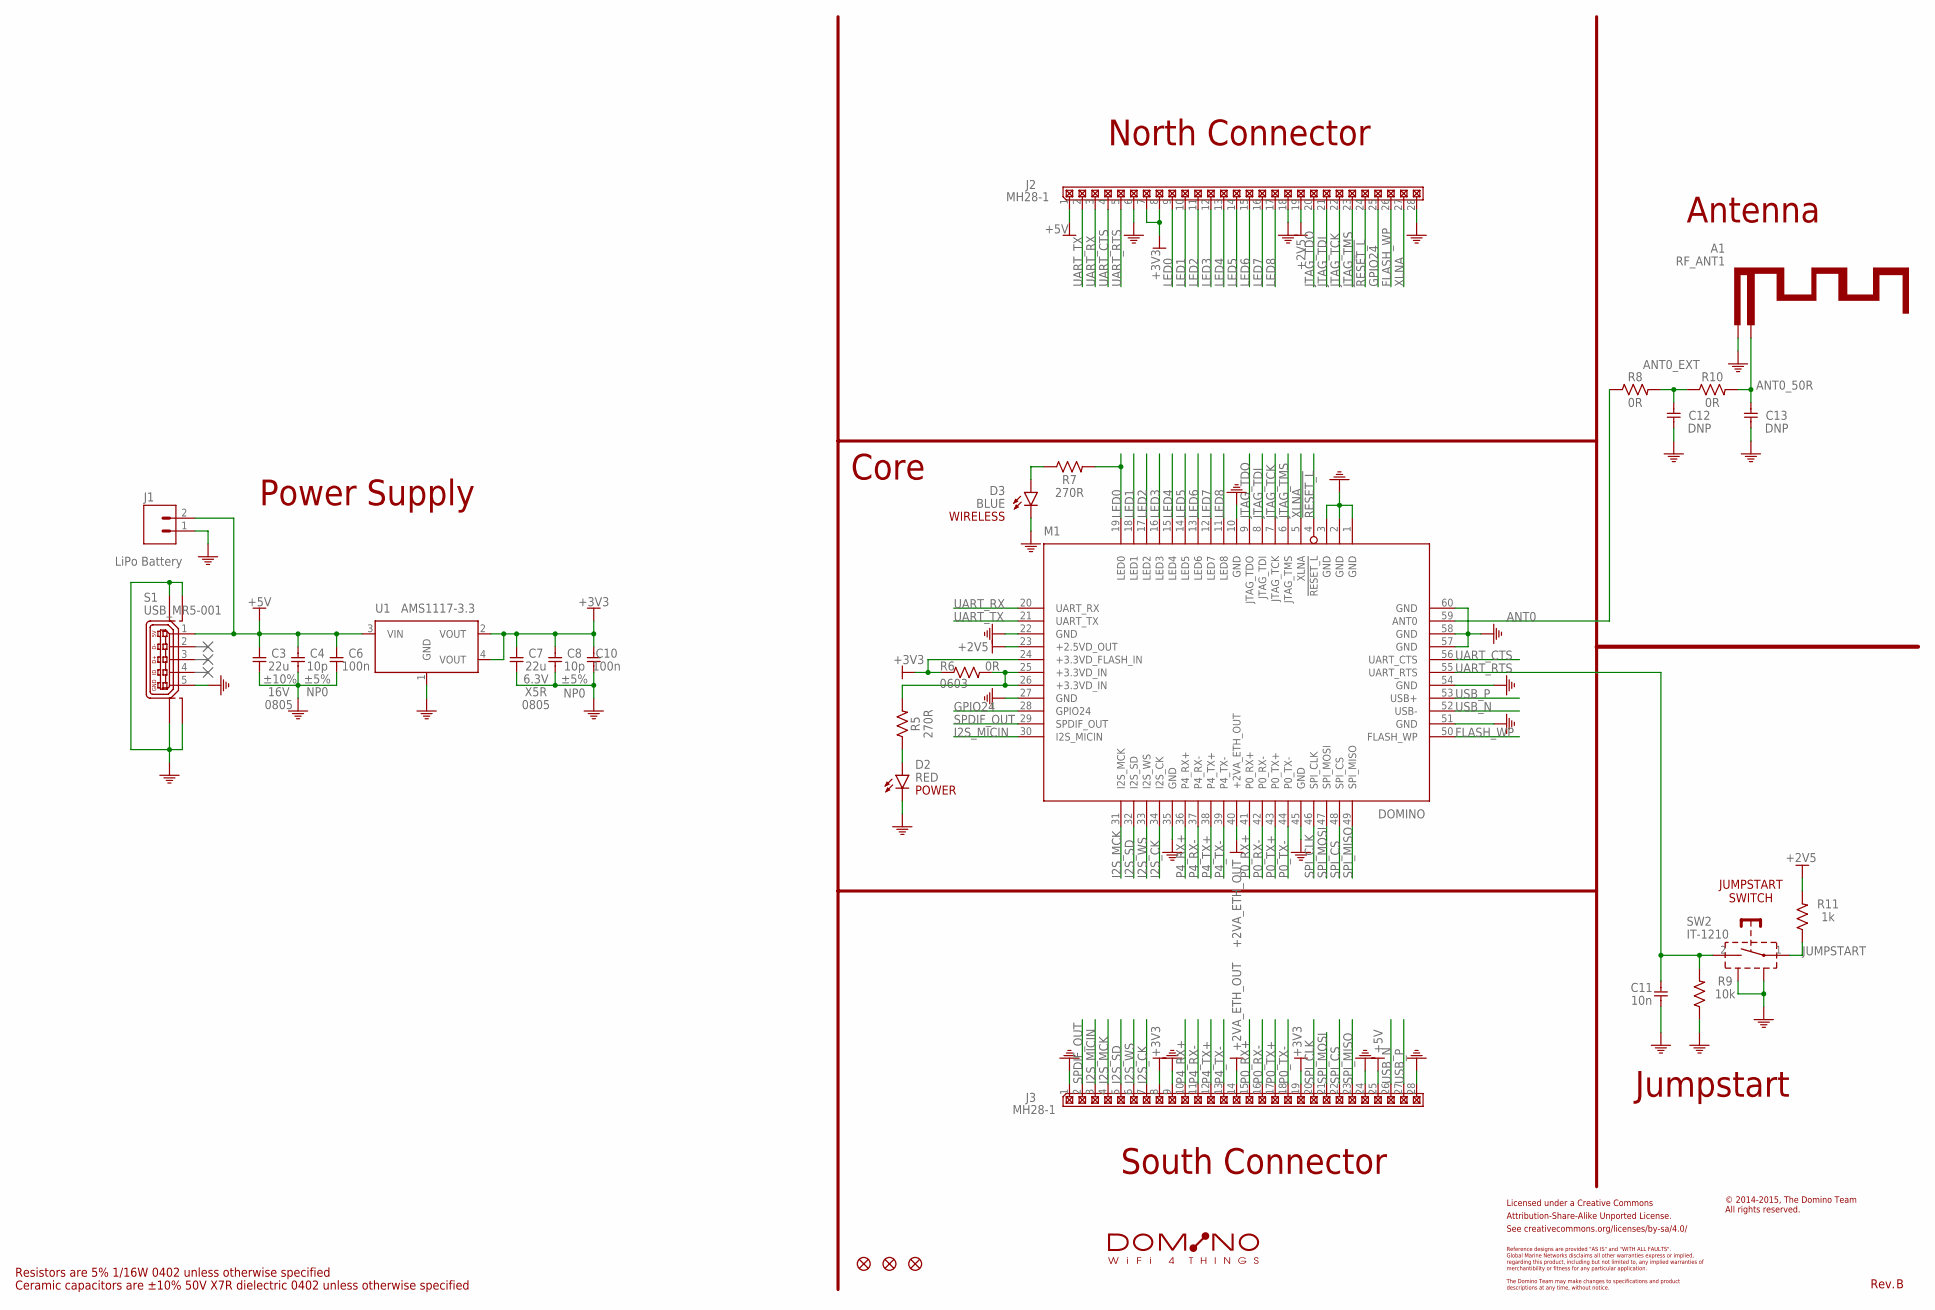
[picture p81: schematic Domino Di.sch]

Parts:
A1: RF_ANT1; PARTNO WIFI_ANT-2.4GHz
C3, C7: 22u; C0805; PARTNO C0805_22u_X5R_20%_CER_6V3
C4, C8: 10p; C0402; PARTNO C0402_10p_NP0_5%_CER_50V
C6, C10: 100n; C0402; PARTNO C0402_100n_X7R_10%_CER_50V
C11: 10n; C0402; PARTNO C0402_10n_X7R_10%_CER_50V
C12, C13: DNP; C0402; PARTNO C0402_DNP
CC-BY-SA: CC-BY-SA_LOGO
D2: RED; LED0402; PARTNO LED0402-RED
D3: BLUE; LED0402; PARTNO LED0402-BLUE
F1, F2, F3: FIDUCIAL
J1: LiPo Battery; S2B-PH-SM4-TB; PARTNO S2B-PH-SM4-TB
J2, J3: MH28-1; MH28-1-0.1; PARTNO MH28-1-0.1
M1: DOMINO; PARTNO DOMINO-CORE
R5, R7: 270R; R0402; PARTNO R0402_270R_5%_62.5mW
R6: 0R; R0603; PARTNO R0603_0R_5%_125mW
R8, R10: 0R; R0402; PARTNO R0402_0R_5%_62.5mW
R9: 10k; R0402; PARTNO R0402_10k_5%_62.5mW
R11: 1k; R0402; PARTNO R0402_1k_5%_62.5mW
S1: USB_MR5-001; USB-MR5-001; PARTNO USB MR5-001
SW2: IT-1210; PARTNO IT-1210
U1: AMS1117-3.3; SOT223; PARTNO AMS1117-3.3
W1: DOMINO_LOGO

Connections:
!RESET_L: J2.24, M1.4 (!RESET_L)
+2V5: J2.19, M1.23 (+2.5VD_OUT), R11.2
+2VA_ETH_OUT: J3.14, M1.40 (+2VA_ETH_OUT)
+3.3VD_IN: M1.25 (+3.3VD_IN), M1.26 (+3.3VD_IN), R5.2, R6.2
+3V3: C7.1, C8.1, C10.1, J2.7, J2.8, J3.8, J3.19, M1.24 (+3.3VD_FLASH_IN), R6.1, U1.2 (VOUT), U1.4 (VOUT)
+5V: C3.1, C4.1, C6.1, J1.2, J2.1, J3.25, S1.1, U1.3 (VIN)
ANT0: M1.59 (ANT0), R8.1
ANT0_50R: A1.FEED, C13.1, R10.2
ANT0_EXT: C12.1, R8.2, R10.1
BLUE_LED: D3.2 (A), R7.1
FLASH_WP: J2.26, M1.50 (FLASH_WP)
GND: A1.GND, C3.2, C4.2, C6.2, C7.2, C8.2, C10.2, C11.2, C12.2, C13.2, D2.1 (C), D3.1 (C), J1.1, J2.6, J2.18, J2.28, J3.1, J3.9, J3.24, J3.28, M1.1 (GND), M1.2 (GND), M1.3 (GND), M1.10 (GND), M1.22 (GND), M1.27 (GND), M1.35 (GND), M1.45 (GND), M1.51 (GND), M1.54 (GND), M1.57 (GND), M1.58 (GND), M1.60 (GND), R9.1, S1.5, S1.SH$1 (M0), S1.SH$2 (M1), S1.SH$3 (M2), S1.SH$4 (M3), SW2.SH$1, SW2.SH$2, U1.1 (GND)
GPIO24: J2.25, M1.28 (GPIO24)
I2S_CK: J3.7, M1.34 (I2S_CK)
I2S_MCK: J3.4, M1.31 (I2S_MCK)
I2S_MICIN: J3.3, M1.30 (I2S_MICIN)
I2S_SD: J3.5, M1.32 (I2S_SD)
I2S_WS: J3.6, M1.33 (I2S_WS)
JTAG_TCK: J2.22, M1.7 (JTAG_TCK)
JTAG_TDI: J2.21, M1.8 (JTAG_TDI)
JTAG_TDO: J2.20, M1.9 (JTAG_TDO)
JTAG_TMS: J2.23, M1.6 (JTAG_TMS)
JUMPSTART: R11.1, SW2.1
LED0: J2.9, M1.19 (LED0), R7.2
LED1: J2.10, M1.18 (LED1)
LED2: J2.11, M1.17 (LED2)
LED3: J2.12, M1.16 (LED3)
LED4: J2.13, M1.15 (LED4)
LED5: J2.14, M1.14 (LED5)
LED6: J2.15, M1.13 (LED6)
LED7: J2.16, M1.12 (LED7)
LED8: J2.17, M1.11 (LED8)
unnamed: D2.2 (A), R5.1
P0_RX+: J3.15, M1.41 (P0_RX+)
P0_RX-: J3.16, M1.42 (P0_RX-)
P0_TX+: J3.17, M1.43 (P0_TX+)
P0_TX-: J3.18, M1.44 (P0_TX-)
P4_RX+: J3.10, M1.36 (P4_RX+)
P4_RX-: J3.11, M1.37 (P4_RX-)
P4_TX+: J3.12, M1.38 (P4_TX+)
P4_TX-: J3.13, M1.39 (P4_TX-)
SPDIF_OUT: J3.2, M1.29 (SPDIF_OUT)
SPI_CLK: J3.20, M1.46 (SPI_CLK)
SPI_CS: J3.22, M1.48 (SPI_CS)
SPI_MISO: J3.23, M1.49 (SPI_MISO)
SPI_MOSI: J3.21, M1.47 (SPI_MOSI)
UART_CTS: J2.4, M1.56 (UART_CTS)
UART_RTS: C11.1, J2.5, M1.55 (UART_RTS), R9.2, SW2.2
UART_RX: J2.3, M1.20 (UART_RX)
UART_TX: J2.2, M1.21 (UART_TX)
USB_N: J3.26, M1.52 (USB-)
USB_P: J3.27, M1.53 (USB+)
XLNA: J2.27, M1.5 (XLNA)

Notes on the sheet:
Power Supply
North Connector
South Connector
Antenna
Core
Ceramic capacitors are ±10% 50V X7R dielectric 0402 unless otherwise specified
Resistors are 5% 1/16W 0402 unless otherwise specified
Licensed under a Creative Commons
Attribution-Share-Alike Unported License.
See creativecommons.org/licenses/by-sa/4.0/
Reference designs are provided "AS IS" and "WITH ALL FAULTS".
regarding this product, including but not limited to, any implied warranties of
The Domino Team may make changes to specifications and product
Global Marine Networks disclaims all other warranties express or implied,
merchantibility or fitness for any particular application.
descriptions at any time, without notice.
© 2014-2015, The Domino Team All rights reserved.
Rev.
WIRELESS
POWER
JUMPSTART SWITCH
Jumpstart

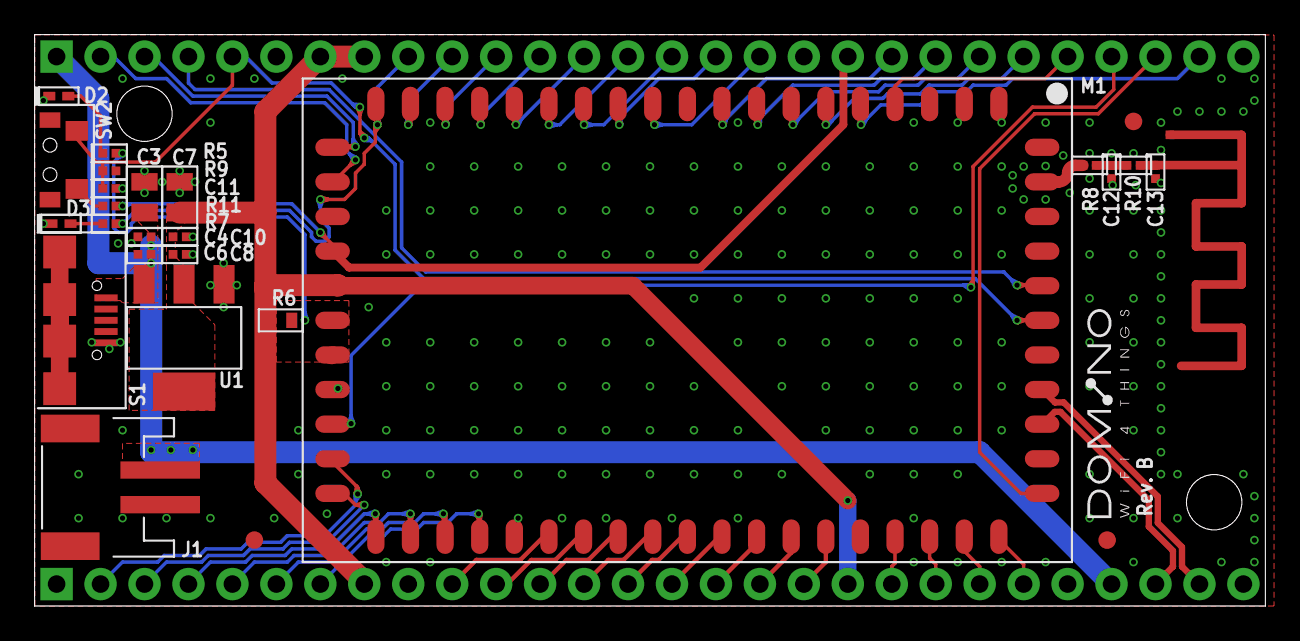
[picture p82: board Domino Di.brd from above]

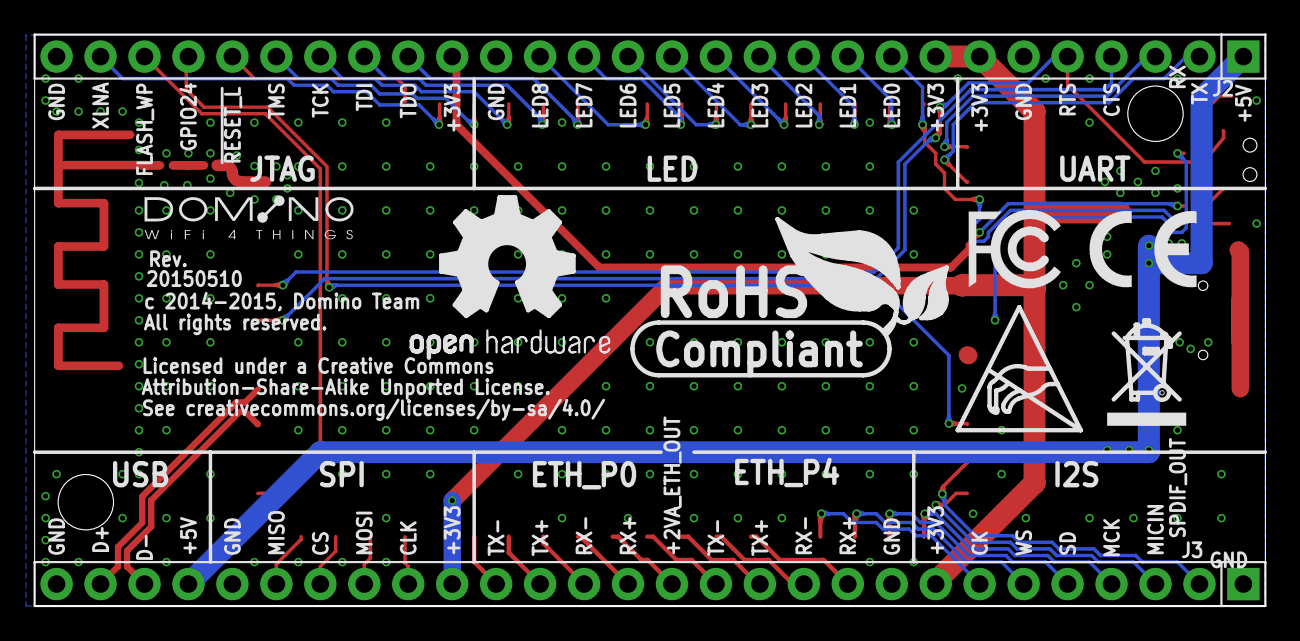
[picture p83: board Domino Di.brd from below]

Board: 2 copper layers, 71.1 x 33.0 mm, 41 parts (9 on the bottom side), 53 nets.

Other parts of the board:
DRILEGEND: DRILEGEND
U$6, U$8: DOMINO_LOGO_SMALL
U$28: A5L-LOC
U$36: ESD_LOGO
U$38: OPEN_HARDWARE_LOGO
U$39: RECYCLE_BIN_LOGO
U$40: ROHS_LOGO
U$41: CE_LOGO_SMALL
U$42: FCC_LOGO_SMALL
