domino-team/domino-hardware/Domino Qi Mini/Domino Qi Mini.brd

## EAGLE design Domino Qi Mini/Domino Qi Mini.brd (2015-05-09)

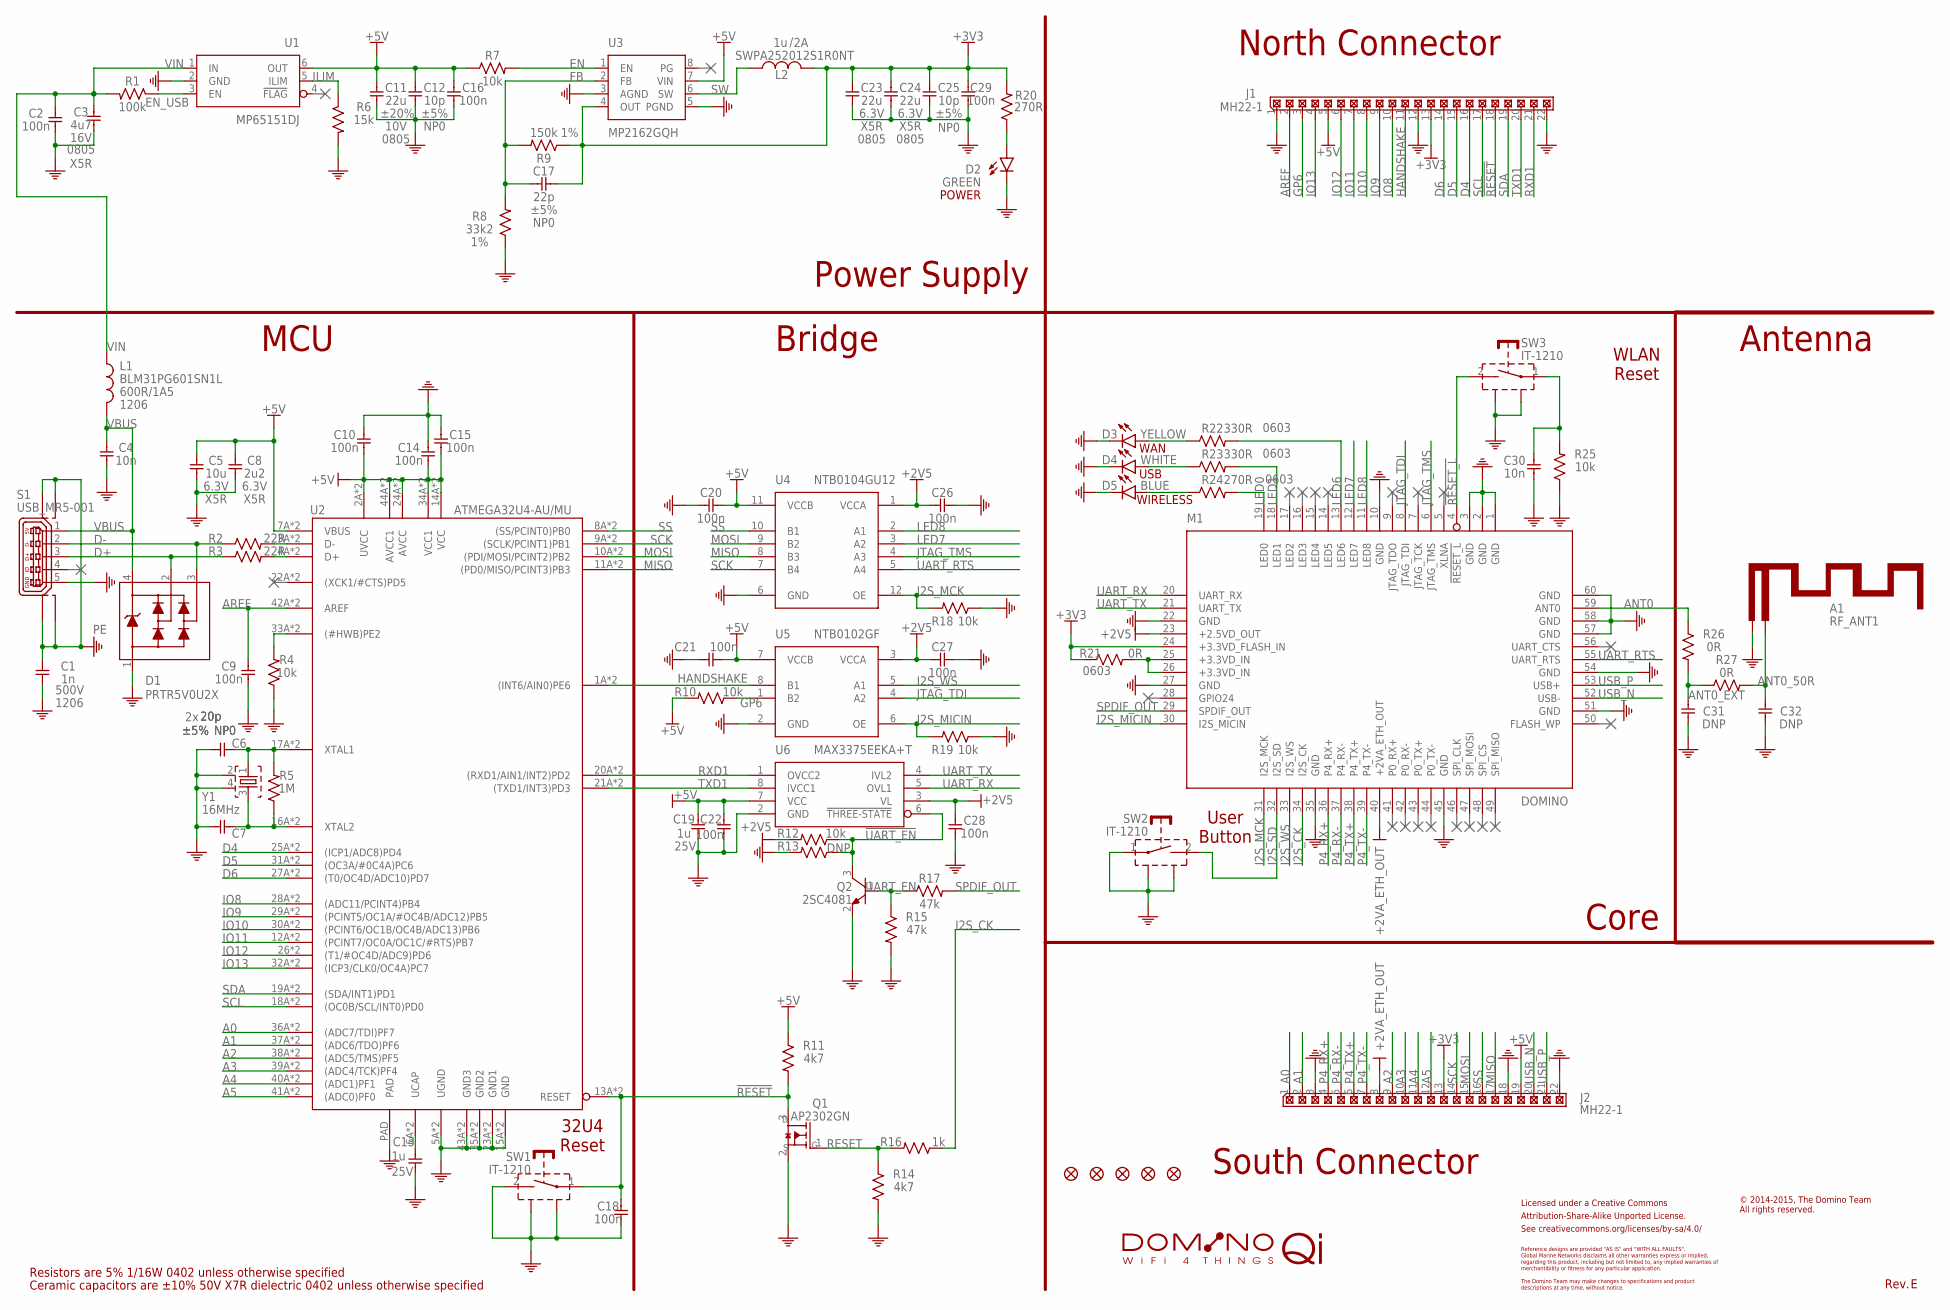
[picture p84: schematic Domino Qi Mini.sch]

Parts:
A1: RF_ANT1; PARTNO RF_ANT1
C1: 1n; C1206; PARTNO C1206_1n_X7R_10%_CER_500V
C2, C9, C10, C14, C15, C16, C18, C20, C21, C22, C26, C27, C28, C29: 100n; C0402; PARTNO C0402_100n_X7R_10%_CER_50V
C3: 4u7; C0805; PARTNO C0805_4u7_X5R_10%_CER_16V
C4, C30: 10n; C0402; PARTNO C0402_10n_X7R_10%_CER_50V
C5: 10u; C0402; PARTNO C0402_10u_X5R_10%_CER_6V3
C6, C7: 20p; C0402; PARTNO C0402_20p_NP0_5%_CER_50V
C8: 2u2; C0805; PARTNO C0402_2u2_X5R_10%_CER_6V3
C11: 22u; C0805; PARTNO C1206_22u_X7R_20%_CER_10V
C12, C25: 10p; C0402; PARTNO C0402_10p_NP0_5%_CER_50V
C13, C19: 1u; C0402; PARTNO C0402_1u_X7R_10%_CER_25V
C17: 22p; C0402; PARTNO C0402_22p_NP0_5%_CER_50V
C23, C24: 22u; C0805; PARTNO C0805_22u_X5R_20%_CER_6V3
C31, C32: DNP; C0402; PARTNO C0402_DNP
CC-BY-SA: CC-BY-SA_LOGO
D1: PRTR5V0U2X; SOT143B; PARTNO PRTR5V0U2X
D2: GREEN; LED0402; PARTNO LED0603-GREEN
D3: YELLOW; LED0402; PARTNO LED0603-YELLOW
D4: WHITE; LED0402; PARTNO LED0603-WHITE
D5: BLUE; LED0402; PARTNO LED0603-BLUE
F1, F2, F3, F4, F5: FIDUCIAL
J1, J2: MH22-1; MH22-1-0.1; PARTNO MH22-1-0.1
L1: BLM31PG601SN1L; FB1206; PARTNO BLM31PG601SN1L
L2: SWPA252012S1R0NT; SWPA252012S; PARTNO SWPA252012SMT
M1: DOMINO; PARTNO DOMINO-CORE
Q1: AP2302GN; SOT23-3; PARTNO AP2302GN
Q2: 2SC4081; SOT323; PARTNO 2SC4081
R1: 100k; R0402; PARTNO R0402_100k_5%_62.5mW
R2, R3: 22R; R0402; PARTNO R0402_22R_5%_62.5mW
R4, R7, R10, R12, R13, R18, R19, R25: 10k; R0402; PARTNO R0402_10k_5%_62.5mW
R5: 1M; R0402; PARTNO R0402_1M_5%_62.5mW
R6: 15k; R0402; PARTNO R0402_15k_5%_62.5mW
R8: 33k2; R0402; PARTNO R0402_33k2_1%_62.5mW
R9: 150k; R0402; PARTNO R0402_150k_1%_62.5mW
R11, R14: 4k7; R0402; PARTNO R0402_4k7_5%_62.5mW
R15, R17: 47k; R0402; PARTNO R0402_47k_5%_62.5mW
R16: 1k; R0402; PARTNO R0402_1k_5%_62.5mW
R20: 270R; R0402; PARTNO R0402_270R_5%_62.5mW
R21: 0R; R0603; PARTNO R0603_0R_5%_125mW
R22, R23: 330R; R0603; PARTNO R0603_330R_5%_125mW
R24: 270R; R0603; PARTNO R0603_270R_5%_125mW
R26, R27: 0R; R0402; PARTNO R0402_0R_5%_62.5mW
S1: USB_MR5-001; USB-MR5-001; PARTNO USB MR5-003A
SW1, SW2, SW3: IT-1210; PARTNO IT-1210
U1: MP65151DJ; SOT23-6; PARTNO MP65151DJ
U2: ATMEGA32U4-AU/MU; ATMEGA32U4_DUAL_FOOTPRINT; PARTNO ATMEGA32U4-MU
U3: MP2162GQH; QFN-8_2X1.5; PARTNO MP2162GQH
U4: NTB0104GU12; XQFN-12; PARTNO NTB0104GU12
U5: NTB0102GF; SOT1089; PARTNO NTB0102GF
U6: MAX3375EEKA+T; SOT23-8; PARTNO MAX3375EEKA+T
W1: DOMINO_QI_LOGO
Y1: 16MHz; CRYSTAL_32X25; PARTNO CRYSTAL_16MHZ_32X25_2SH_12PF_30PPM

Connections:
!RESET: C18.1, J1.18, Q1.3 (D), R11.2, SW1.1, U2.13A (RESET), U2.13M (RESET)
!RESET_L: M1.4 (!RESET_L), SW3.2
!UART_EN: Q2.3 (C), R12.1, R13.1, U6.6 (!THREE-STATE)
+2V5: C26.1, C27.1, C28.1, M1.23 (+2.5VD_OUT), R12.2, U4.1 (VCCA), U5.3 (VCCA), U6.3 (VL)
+2VA_ETH_OUT: J2.8, M1.40 (+2VA_ETH_OUT)
+3.3VD_IN: M1.25 (+3.3VD_IN), M1.26 (+3.3VD_IN), R21.2
+3V3: C17.2, C23.1, C24.1, C25.1, C29.1, J1.13, J2.13, L2.2, M1.24 (+3.3VD_FLASH_IN), R9.1, R20.2, R21.1, U3.4 (OUT)
+5V: C5.1, C8.1, C10.1, C11.1, C12.1, C14.1, C15.1, C16.1, C19.2, C20.1, C21.1, C22.1, J1.5, J2.19, R7.1, R10.2, R11.1, U1.6 (OUT), U2.2A (UVCC), U2.2M (UVCC), U2.7A (VBUS), U2.7M (VBUS), U2.14A (VCC), U2.14M (VCC), U2.24A (AVCC), U2.24M (AVCC), U2.34A (VCC1), U2.34M (VCC1), U2.44A (AVCC1), U2.44M (AVCC1), U3.7 (VIN), U4.11 (VCCB), U5.7 (VCCB), U6.7 (VCC)
A0: J2.1, U2.36A ((ADC7/TDI)PF7), U2.36M ((ADC7/TDI)PF7)
A1: J2.2, U2.37A ((ADC6/TDO)PF6), U2.37M ((ADC6/TDO)PF6)
A2: J2.9, U2.38A ((ADC5/TMS)PF5), U2.38M ((ADC5/TMS)PF5)
A3: J2.10, U2.39A ((ADC4/TCK)PF4), U2.39M ((ADC4/TCK)PF4)
A4: J2.11, U2.40A ((ADC1)PF1), U2.40M ((ADC1)PF1)
A5: J2.12, U2.41A ((ADC0)PF0), U2.41M ((ADC0)PF0)
ANT0: M1.59 (ANT0), R26.1
ANT0_50R: A1.FEED, C32.1, R27.2
ANT0_EXT: C31.1, R26.2, R27.1
AREF: C9.1, J1.2, U2.42A (AREF), U2.42M (AREF)
BLUE_LED: D5.2 (A), R24.1
BLUE_LED1: D4.2 (A), R23.1
BLUE_LED2: D3.2 (A), R22.1
D4: J1.16, U2.25A ((ICP1/ADC8)PD4), U2.25M ((ICP1/ADC8)PD4)
D5: J1.15, U2.31A ((OC3A/#0C4A)PC6), U2.31M ((OC3A/#0C4A)PC6)
D6: J1.14, U2.27A ((T0/OC4D/ADC10)PD7), U2.27M ((T0/OC4D/ADC10)PD7)
D+: D1.2, R3.1, S1.3
D-: D1.3, R2.1, S1.2
EN: R7.2, U3.1 (EN)
EN_USB: R1.1, U1.3 (EN)
FB: C17.1, R8.2, R9.2, U3.2 (FB)
GND: A1.GND, C1.2, C2.2, C3.2, C4.2, C5.2, C6.1, C7.1, C8.2, C9.2, C10.2, C11.2, C12.2, C13.1, C14.2, C15.2, C16.2, C18.2, C19.1, C20.2, C21.2, C22.2, C23.2, C24.2, C25.2, C26.2, C27.2, C28.2, C29.2, C30.2, C31.2, C32.2, D1.1, D2.1 (C), D3.1 (C), D4.1 (C), D5.1 (C), J1.1, J1.12, J1.22, J2.3, J2.18, J2.22, M1.1 (GND), M1.2 (GND), M1.3 (GND), M1.10 (GND), M1.22 (GND), M1.27 (GND), M1.35 (GND), M1.45 (GND), M1.51 (GND), M1.54 (GND), M1.57 (GND), M1.58 (GND), M1.60 (GND), Q1.2 (S), Q2.2 (E), R4.1, R6.2, R8.1, R13.2, R14.2, R15.2, R18.1, R19.1, R25.1, S1.5, SW1.2, SW1.SH$1, SW1.SH$2, SW2.1, SW2.SH$1, SW2.SH$2, SW3.SH$1, SW3.SH$2, U1.2 (GND), U2.5A (UGND), U2.5M (UGND), U2.15A (GND), U2.15M (GND), U2.23A (GND1), U2.23M (GND1), U2.35A (GND2), U2.35M (GND2), U2.43A (GND3), U2.43M (GND3), U2.PAD, U3.3 (AGND), U3.5 (PGND), U4.6 (GND), U5.2 (GND), U6.2 (GND), Y1.2, Y1.4
GP6: J1.3, R10.1, U5.1 (B2)
HANDSHAKE: J1.11, U2.1A ((INT6/AIN0)PE6), U2.1M ((INT6/AIN0)PE6), U5.8 (B1)
I2S_CK: M1.34 (I2S_CK), R16.1
I2S_MCK: M1.31 (I2S_MCK), R18.2, U4.12 (OE)
I2S_MICIN: M1.30 (I2S_MICIN), R19.2, U5.6 (OE)
I2S_SD: M1.32 (I2S_SD), SW2.2
I2S_WS: M1.33 (I2S_WS), U5.5 (A1)
ILIM: R6.1, U1.5 (ILIM)
IO8: J1.10, U2.28A ((ADC11/PCINT4)PB4), U2.28M ((ADC11/PCINT4)PB4)
IO9: J1.9, U2.29A ((PCINT5/OC1A/#OC4B/ADC12)PB5), U2.29M ((PCINT5/OC1A/#OC4B/ADC12)PB5)
IO10: J1.8, U2.30A ((PCINT6/OC1B/OC4B/ADC13)PB6), U2.30M ((PCINT6/OC1B/OC4B/ADC13)PB6)
IO11: J1.7, U2.12A ((PCINT7/OC0A/OC1C/#RTS)PB7), U2.12M ((PCINT7/OC0A/OC1C/#RTS)PB7)
IO12: J1.6, U2.26 ((T1/#OC4D/ADC9)PD6), U2.26M ((T1/#OC4D/ADC9)PD6)
IO13: J1.4, U2.32A ((ICP3/CLK0/OC4A)PC7), U2.32M ((ICP3/CLK0/OC4A)PC7)
JTAG_TDI: M1.8 (JTAG_TDI), U5.4 (A2)
JTAG_TMS: M1.6 (JTAG_TMS), U4.4 (A3)
LED0: M1.19 (LED0), R24.2
LED1: M1.18 (LED1), R23.2
LED6: M1.13 (LED6), R22.2
LED7: M1.12 (LED7), U4.3 (A2)
LED8: M1.11 (LED8), U4.2 (A1)
MISO: J2.17, U2.11A ((PD0/MISO/PCINT3)PB3), U2.11M ((PD0/MISO/PCINT3)PB3), U4.8 (B3)
MOSI: J2.15, U2.10A ((PDI/MOSI/PCINT2)PB2), U2.10M ((PDI/MOSI/PCINT2)PB2), U4.9 (B2)
unnamed: R2.2, U2.3A (D-), U2.3M (D-)
unnamed: R4.2, U2.33A ((#HWB)PE2), U2.33M ((#HWB)PE2)
unnamed: R3.2, U2.4A (D+), U2.4M (D+)
P4_RX+: J2.4, M1.36 (P4_RX+)
P4_RX-: J2.5, M1.37 (P4_RX-)
P4_TX+: J2.6, M1.38 (P4_TX+)
P4_TX-: J2.7, M1.39 (P4_TX-)
PE: C1.1, S1.SH$1 (M0), S1.SH$2 (M1), S1.SH$3 (M2), S1.SH$4 (M3)
POWER_LED: D2.2 (A), R20.1
RESET: Q1.1 (G), R14.1, R16.2
RESET_SWITCH: C30.1, R25.2, SW3.1
RXD1: J1.21, U2.20A ((RXD1/AIN1/INT2)PD2), U2.20M ((RXD1/AIN1/INT2)PD2), U6.1 (OVCC2)
SCK: J2.14, U2.9A ((SCLK/PCINT1)PB1), U2.9M ((SCLK/PCINT1)PB1), U4.7 (B4)
SCL: J1.17, U2.18A ((OC0B/SCL/INT0)PD0), U2.18M ((OC0B/SCL/INT0)PD0)
SDA: J1.19, U2.19A ((SDA/INT1)PD1), U2.19M ((SDA/INT1)PD1)
SPDIF_OUT: M1.29 (SPDIF_OUT), R17.2
SS: J2.16, U2.8A ((SS/PCINT0)PB0), U2.8M ((SS/PCINT0)PB0), U4.10 (B1)
SW: L2.1, U3.6 (SW)
TXD1: J1.20, U2.21A ((TXD1/INT3)PD3), U2.21M ((TXD1/INT3)PD3), U6.8 (IVCC1)
UART_EN: Q2.1 (B), R15.1, R17.1
UART_RTS: M1.55 (UART_RTS), U4.5 (A4)
UART_RX: M1.20 (UART_RX), U6.5 (OVL1)
UART_TX: M1.21 (UART_TX), U6.4 (IVL2)
UCAP: C13.2, U2.6A (UCAP), U2.6M (UCAP)
USB_N: J2.20, M1.52 (USB-)
USB_P: J2.21, M1.53 (USB+)
VBUS: C4.1, D1.4, L1.2, S1.1
VIN: C2.1, C3.1, L1.1, R1.2, U1.1 (IN)
XTAL1: C6.2, R5.2, U2.17A (XTAL1), U2.17M (XTAL1), Y1.1
XTAL2: C7.2, R5.1, U2.16A (XTAL2), U2.16M (XTAL2), Y1.3

Notes on the sheet:
Power Supply
North Connector
South Connector
Antenna
Core
MCU
Ceramic capacitors are ±10% 50V X7R dielectric 0402 unless otherwise specified
Resistors are 5% 1/16W 0402 unless otherwise specified
Licensed under a Creative Commons
Attribution-Share-Alike Unported License.
See creativecommons.org/licenses/by-sa/4.0/
Reference designs are provided "AS IS" and "WITH ALL FAULTS".
regarding this product, including but not limited to, any implied warranties of
The Domino Team may make changes to specifications and product
Global Marine Networks disclaims all other warranties express or implied,
merchantibility or fitness for any particular application.
descriptions at any time, without notice.
© 2014-2015, The Domino Team All rights reserved.
Rev.
WIRELESS
POWER
Bridge
32U4 Reset
USB
WAN
User Button
WLAN Reset

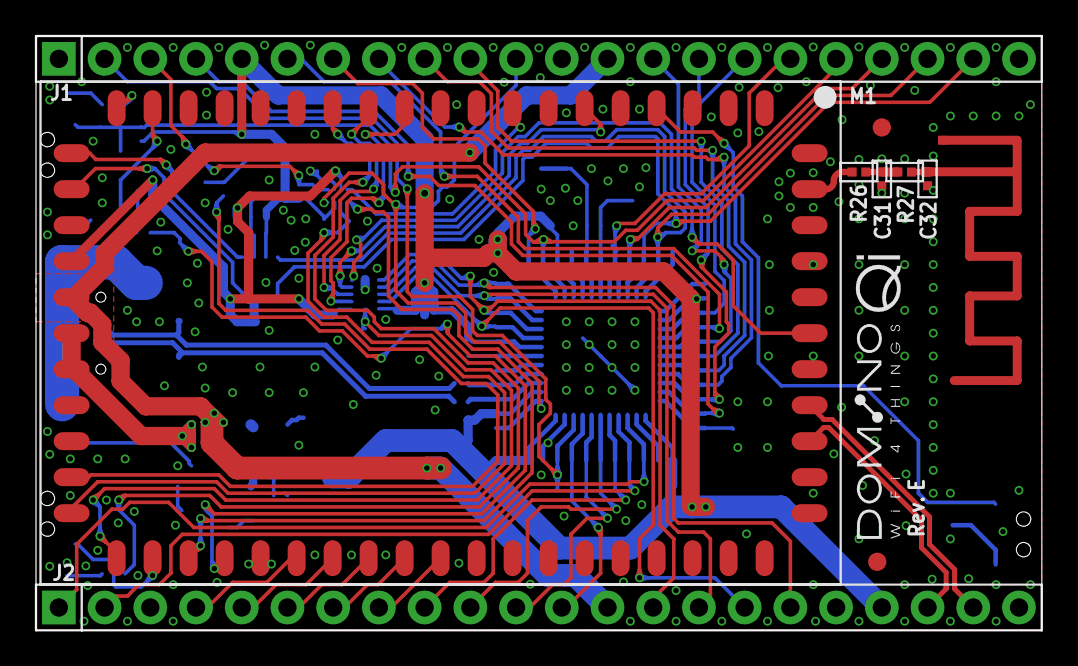
[picture p85: board Domino Qi Mini.brd from above]

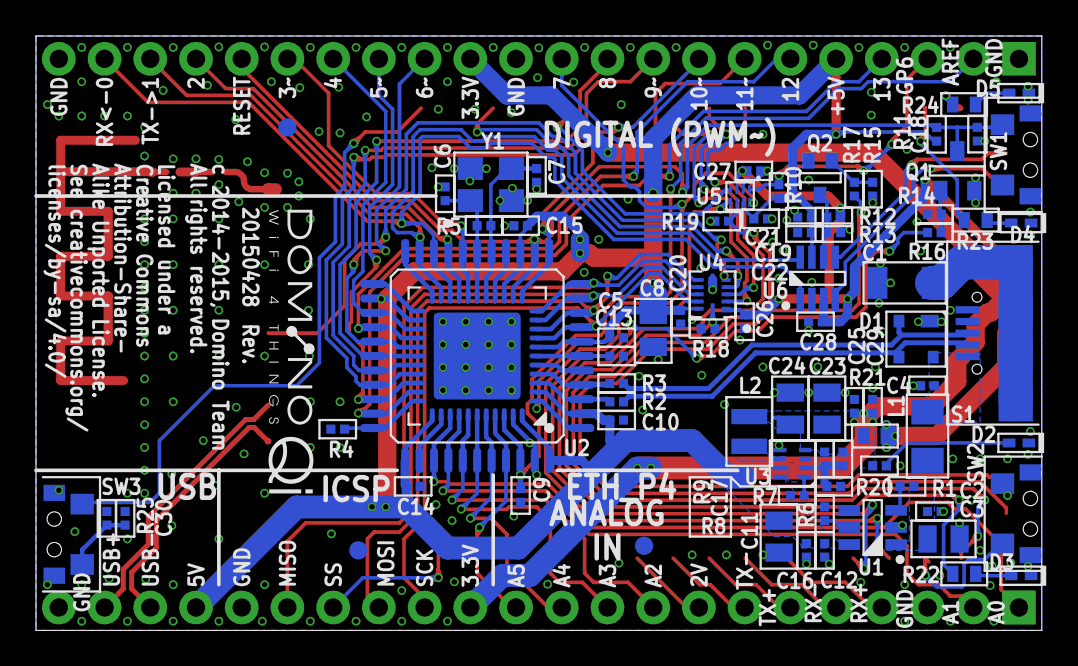
[picture p86: board Domino Qi Mini.brd from below]

Board: 4 copper layers, 55.9 x 33.0 mm, 94 parts (79 on the bottom side), 83 nets.

Other parts of the board:
DRILEGEND: DRILEGEND
U$3, U$5: DOMINO_QI_LOGO_SMALL
U$28: A5L-LOC
