domino-team/domino-hardware/Domino Dual Ethernet/Domino Dual Ethernet.brd

## EAGLE design Domino Dual Ethernet/Domino Dual Ethernet.brd (2015-05-09)

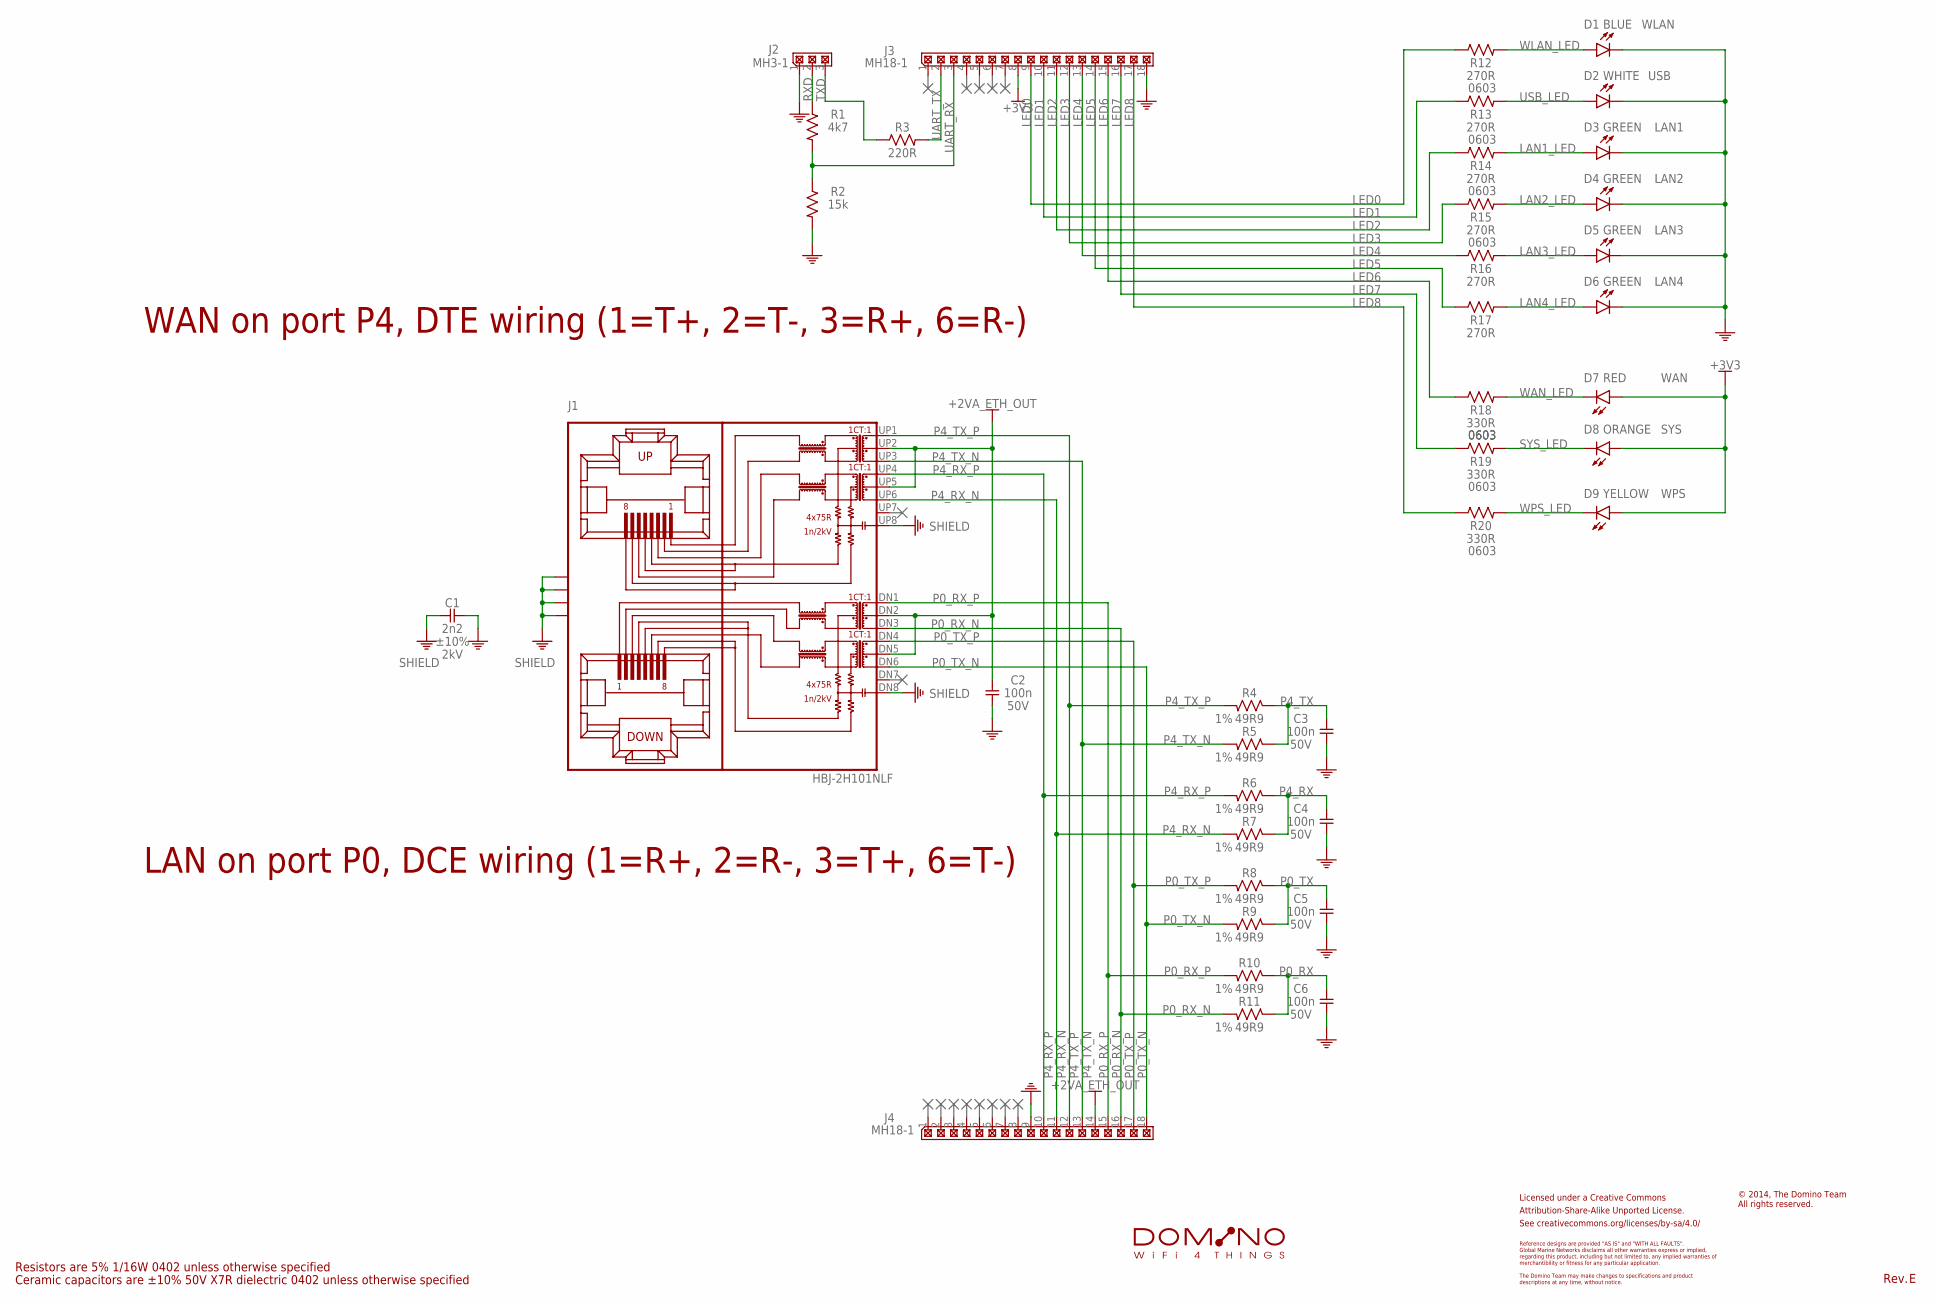
[picture p87: schematic Domino Dual Ethernet.sch]

Parts:
C1: 2n2; C1206; PARTNO C1210_2n2_X7R_10%_CER_2kV
C2, C3, C4, C5, C6: 100n; C0402; PARTNO C0402_100n_X7R_10%_CER_50V
CC-BY-SA1: CC-BY-SA_LOGO
D1: BLUE; LED0603; PARTNO LED0603-BLUE
D2: WHITE; LED0603; PARTNO LED0603-WHITE
D3, D4, D5, D6: GREEN; LED0603; PARTNO LED0603-GREEN
D7: RED; LED0603; PARTNO LED0603-ORANGE
D8: ORANGE; LED0603; PARTNO LED0603-ORANGE
D9: YELLOW; LED0603; PARTNO LED0603-YELLOW
J1: HBJ-2H101NLF; PARTNO HBJ-2H101NLF
J2: MH3-1; MH3-1-0.1; PARTNO MH3-1-0.1
J3, J4: MH18-1; MH18-1-0.1; PARTNO MH18-1-0.1
L1: DOMINO_LOGO
R1: 4k7; R0402; PARTNO R0402_4k7_5%_62.5mW
R2: 15k; R0402; PARTNO R0402_15k_5%_62.5mW
R3: 220R; R0402; PARTNO R0402_220R_5%_62.5mW
R4, R5, R6, R7, R8, R9, R10, R11: 49R9; R0402; PARTNO R0402_49R9_1%_62.5mW
R12, R13, R14, R15, R16, R17: 270R; R0603; PARTNO R0603_270R_5%_125mW
R18, R19, R20: 330R; R0603; PARTNO R0603_330R_5%_125mW

Connections:
+2VA_ETH_OUT: C2.2, J1.DN2 (DR2), J1.DN5 (DR5), J1.UP2 (UR2), J1.UP5 (UR5), J4.14
+3V3: D7.2 (A), D8.2 (A), D9.2 (A), J3.8
GND: C1.1, C2.1, C3.1, C4.1, C5.1, C6.1, D1.1 (C), D2.1 (C), D3.1 (C), D4.1 (C), D5.1 (C), D6.1 (C), J2.1, J3.18, J4.9, R2.2
LAN1_LED: D3.2 (A), R14.2
LAN2_LED: D4.2 (A), R15.2
LAN3_LED: D5.2 (A), R16.2
LAN4_LED: D6.2 (A), R17.2
LED0: J3.9, R12.1
LED1: J3.10, R13.1
LED2: J3.11, R14.1
LED3: J3.12, R15.1
LED4: J3.13, R16.1
LED5: J3.14, R17.1
LED6: J3.15, R18.1
LED7: J3.16, R19.1
LED8: J3.17, R20.1
P0_RX: C6.2, R10.1, R11.1
P0_RX_N: J1.DN3 (DR3), J4.16, R11.2
P0_RX_P: J1.DN1 (DR1), J4.15, R10.2
P0_TX: C5.2, R8.1, R9.1
P0_TX_N: J1.DN6 (DR6), J4.18, R9.2
P0_TX_P: J1.DN4 (DR4), J4.17, R8.2
P4_RX: C4.2, R6.1, R7.1
P4_RX_N: J1.UP6 (UR6), J4.11, R7.2
P4_RX_P: J1.UP4 (UR4), J4.10, R6.2
P4_TX: C3.2, R4.1, R5.1
P4_TX_N: J1.UP3 (UR3), J4.13, R5.2
P4_TX_P: J1.UP1 (UR1), J4.12, R4.2
RXD: J2.2, R1.1
SHIELD: C1.2, J1.DN8 (DR8), J1.P$1 (SHIELD), J1.P$2 (SHIELD), J1.P$3 (SHIELD), J1.P$4 (SHIELD), J1.UP8 (UR8)
SYS_LED: D8.1 (C), R19.2
TXD: J2.3, R3.1
UART_RX: J3.3, R1.2, R2.1
UART_TX: J3.2, R3.2
USB_LED: D2.2 (A), R13.2
WAN_LED: D7.1 (C), R18.2
WLAN_LED: D1.2 (A), R12.2
WPS_LED: D9.1 (C), R20.2

Notes on the sheet:
Ceramic capacitors are ±10% 50V X7R dielectric 0402 unless otherwise specified
Resistors are 5% 1/16W 0402 unless otherwise specified
Licensed under a Creative Commons
Attribution-Share-Alike Unported License.
See creativecommons.org/licenses/by-sa/4.0/
Reference designs are provided "AS IS" and "WITH ALL FAULTS".
regarding this product, including but not limited to, any implied warranties of
The Domino Team may make changes to specifications and product
Global Marine Networks disclaims all other warranties express or implied,
merchantibility or fitness for any particular application.
descriptions at any time, without notice.
© 2014, The Domino Team All rights reserved.
Rev.
WAN on port P4, DTE wiring (1=T+, 2=T-, 3=R+, 6=R-)
WLAN
USB
LAN1
LAN2
LAN3
LAN4
SYS
WPS
WAN
LAN on port P0, DCE wiring (1=R+, 2=R-, 3=T+, 6=T-)

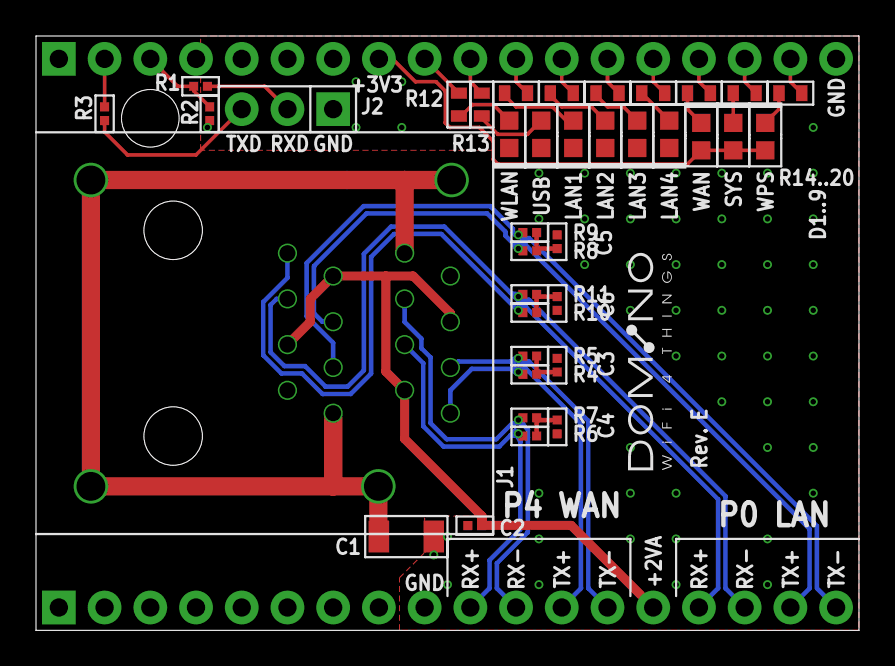
[picture p88: board Domino Dual Ethernet.brd from above]

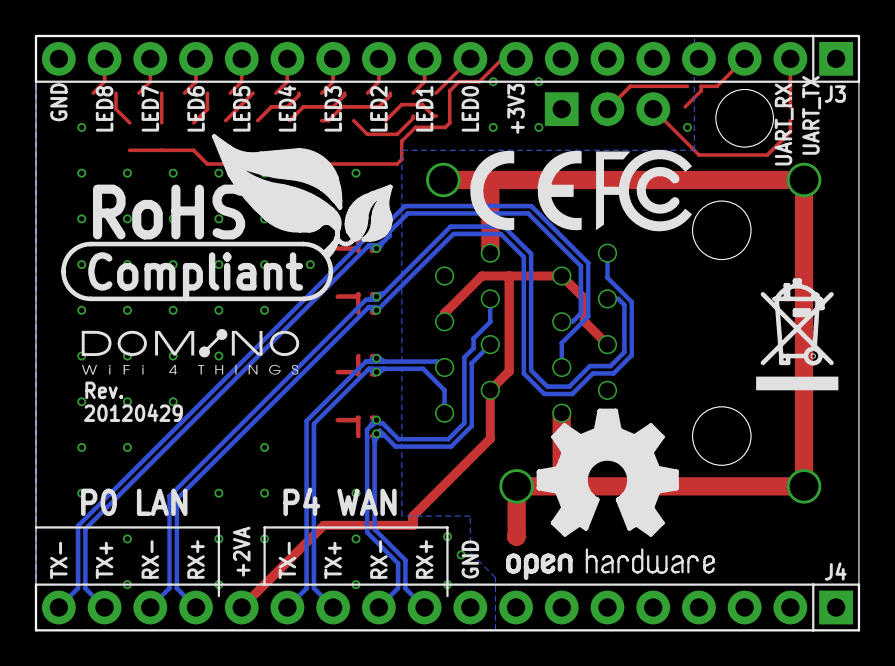
[picture p89: board Domino Dual Ethernet.brd from below]

Board: 2 copper layers, 45.7 x 33.0 mm, 50 parts (8 on the bottom side), 38 nets.

Other parts of the board:
DRILEGEND: DRILEGEND
U$3: A5L-LOC
U$4, U$11: DOMINO_LOGO_SMALL
U$5: CE_LOGO_SMALL
U$6: FCC_LOGO_SMALL
U$7: OPEN_HARDWARE_LOGO
U$8: RECYCLE_BIN_LOGO
U$9: ROHS_LOGO
