domino-team/domino-hardware/Domino Single USB/Domino Single USB No Teardrop.brd

## EAGLE design Domino Single USB/Domino Single USB No Teardrop.brd (2015-02-13)

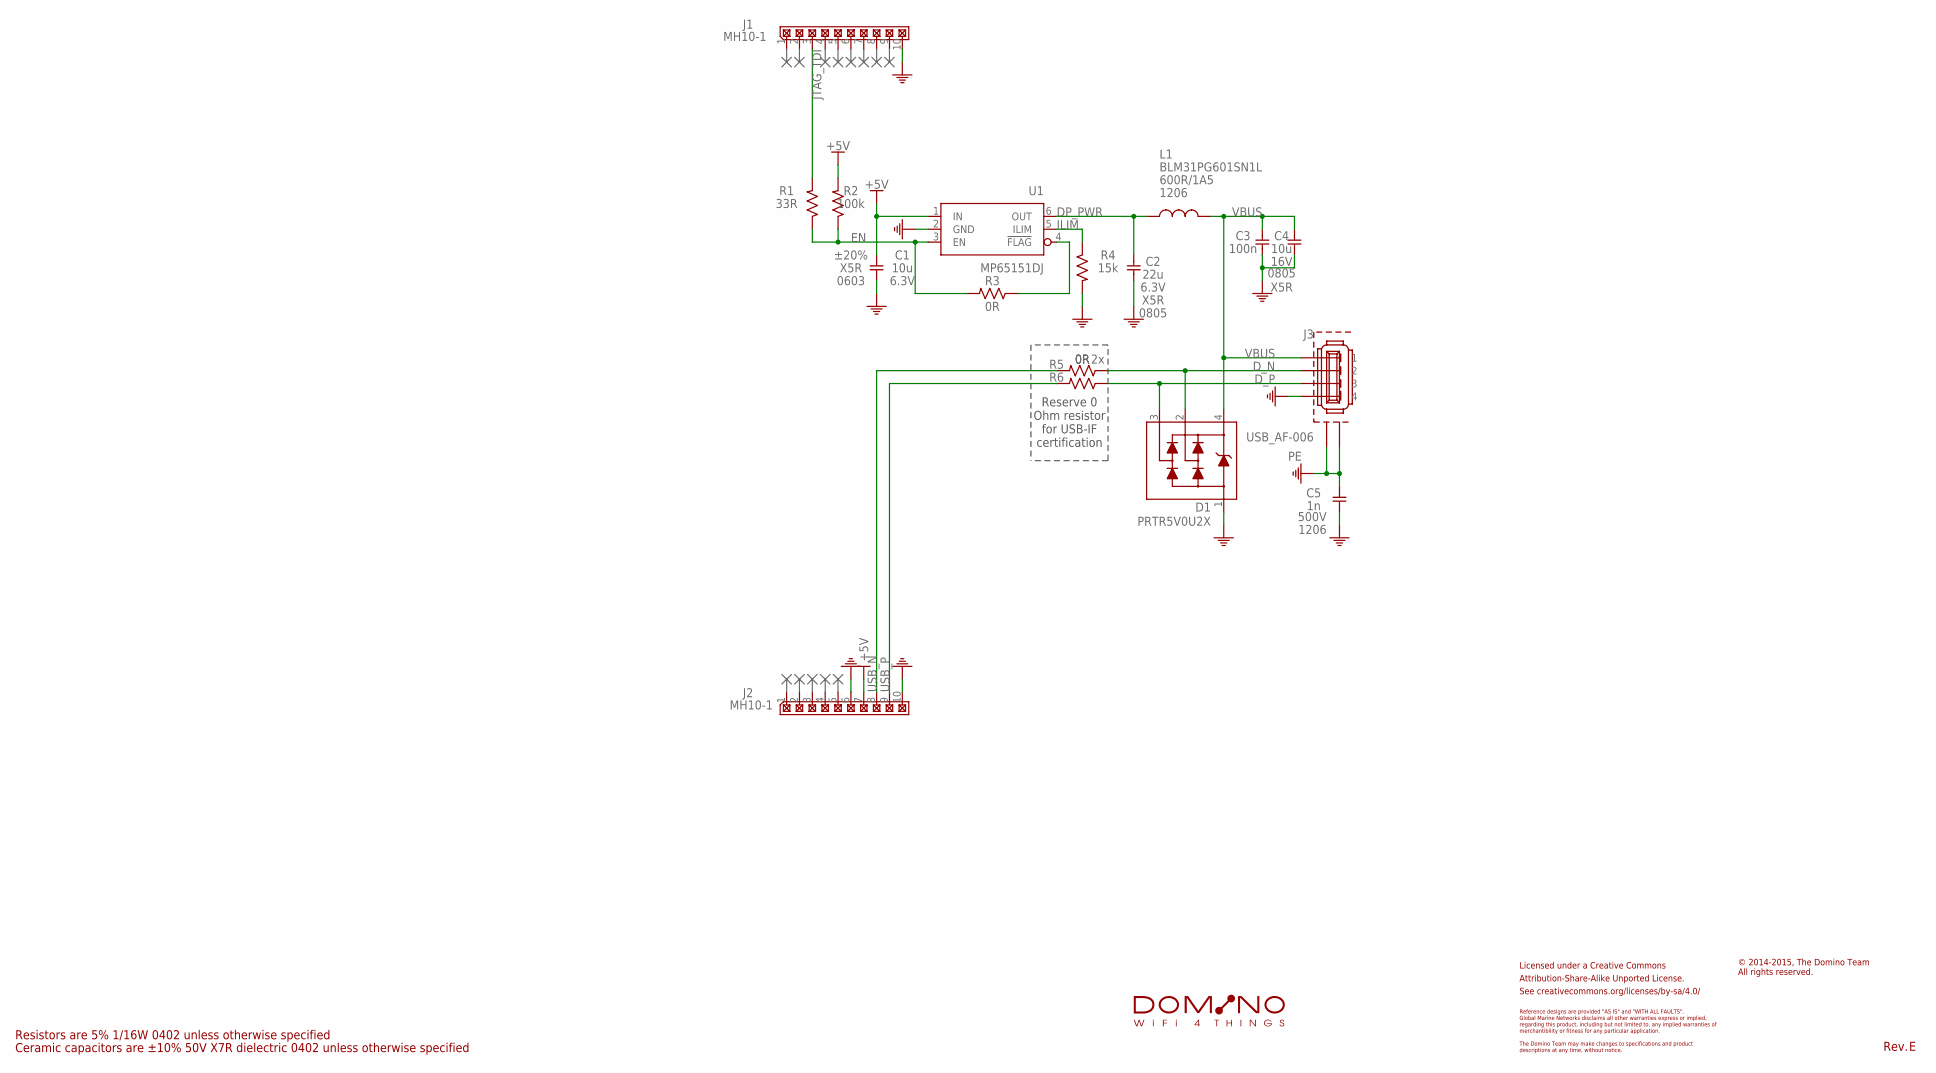
[picture p90: schematic Domino Single USB No Teardrop.sch]

Parts:
C1: 10u; C0603; PARTNO C0603_10u_X5R_20%_CER_6V3
C2: 22u; C0805; PARTNO C0805_22u_X5R_20%_CER_6V3
C3: 100n; C0402; PARTNO C0402_100n_X7R_10%_CER_50V
C4: 10u; C0805; PARTNO C0805_10u_X5R_10%_CER_16V
C5: 1n; C1206; PARTNO C1206_1n_X7R_10%_CER_500V
CC-BY-SA1: CC-BY-SA_LOGO
D1: PRTR5V0U2X; SOT143B; PARTNO PRTR5V0U2X
J1, J2: MH10-1; MH10-1-0.1; PARTNO MH10-1-0.1
J3: USB_AF-006; PARTNO USB_AF-006
L1: BLM31PG601SN1L; FB1206; PARTNO BLM31PG601SN1L
R1: 33R; R0402; PARTNO R0402_33R_5%_62.5mW
R2: 100k; R0402; PARTNO R0402_100k_5%_62.5mW
R3, R5, R6: 0R; R0402; PARTNO R0402_0R_5%_62.5mW
R4: 15k; R0402; PARTNO R0402_15k_5%_62.5mW
S1: DOMINO_LOGO
U1: MP65151DJ; SOT23-6; PARTNO MP65151DJ

Connections:
+5V: C1.1, J2.7, R2.2, U1.1 (IN)
DP_PWR: C2.1, L1.1, U1.6 (OUT)
D_N: D1.2, J3.2, R5.1
D_P: D1.3, J3.3, R6.1
EN: R1.1, R2.1, R3.2, U1.3 (EN)
GND: C1.2, C2.2, C3.2, C4.2, C5.2, D1.1, J1.10, J2.6, J2.10, J3.4, R4.2, U1.2 (GND)
ILIM: R4.1, U1.5 (ILIM)
JTAG_TDI: J1.3, R1.2
unnamed: R3.1, U1.4 (!FLAG)
PE: C5.1, J3.S$1 (G), J3.S$2 (G)
USB_N: J2.8, R5.2
USB_P: J2.9, R6.2
VBUS: C3.1, C4.1, D1.4, J3.1, L1.2

Notes on the sheet:
Ceramic capacitors are ±10% 50V X7R dielectric 0402 unless otherwise specified
Resistors are 5% 1/16W 0402 unless otherwise specified
Licensed under a Creative Commons
Attribution-Share-Alike Unported License.
See creativecommons.org/licenses/by-sa/4.0/
Reference designs are provided "AS IS" and "WITH ALL FAULTS".
regarding this product, including but not limited to, any implied warranties of
The Domino Team may make changes to specifications and product
Global Marine Networks disclaims all other warranties express or implied,
merchantibility or fitness for any particular application.
descriptions at any time, without notice.
© 2014-2015, The Domino Team All rights reserved.
Rev.
Reserve 0 Ohm resistor for USB-IF certification

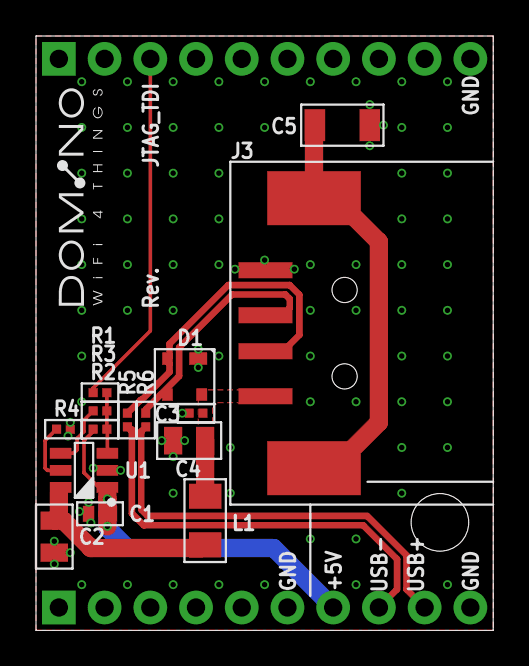
[picture p91: board Domino Single USB No Teardrop.brd from above]

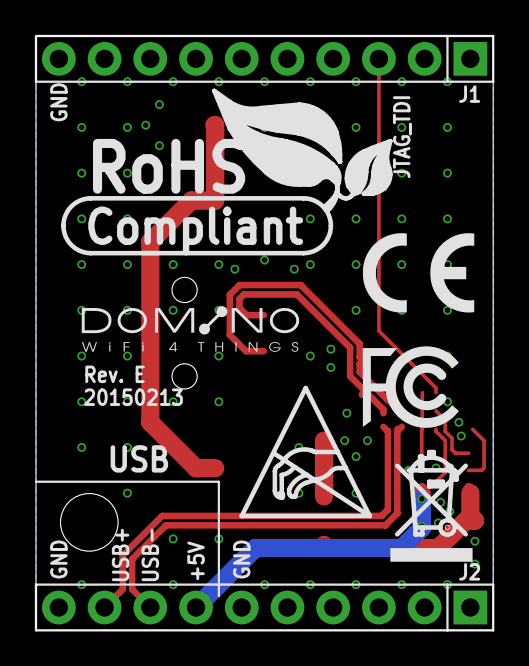
[picture p92: board Domino Single USB No Teardrop.brd from below]

Board: 2 copper layers, 25.4 x 33.0 mm, 28 parts (8 on the bottom side), 13 nets.

Other parts of the board:
DRILEGEND: DRILEGEND
U$1: ROHS_LOGO
U$3: A5L-LOC
U$4, U$10: DOMINO_LOGO_SMALL
U$5: CE_LOGO_SMALL
U$6: FCC_LOGO_SMALL
U$8: RECYCLE_BIN_LOGO
U$11: ESD_LOGO
