domino-team/domino-hardware/Domino Pi/Domino Pi No Teardrop.brd

## EAGLE design Domino Pi/Domino Pi No Teardrop.brd (2015-02-13)

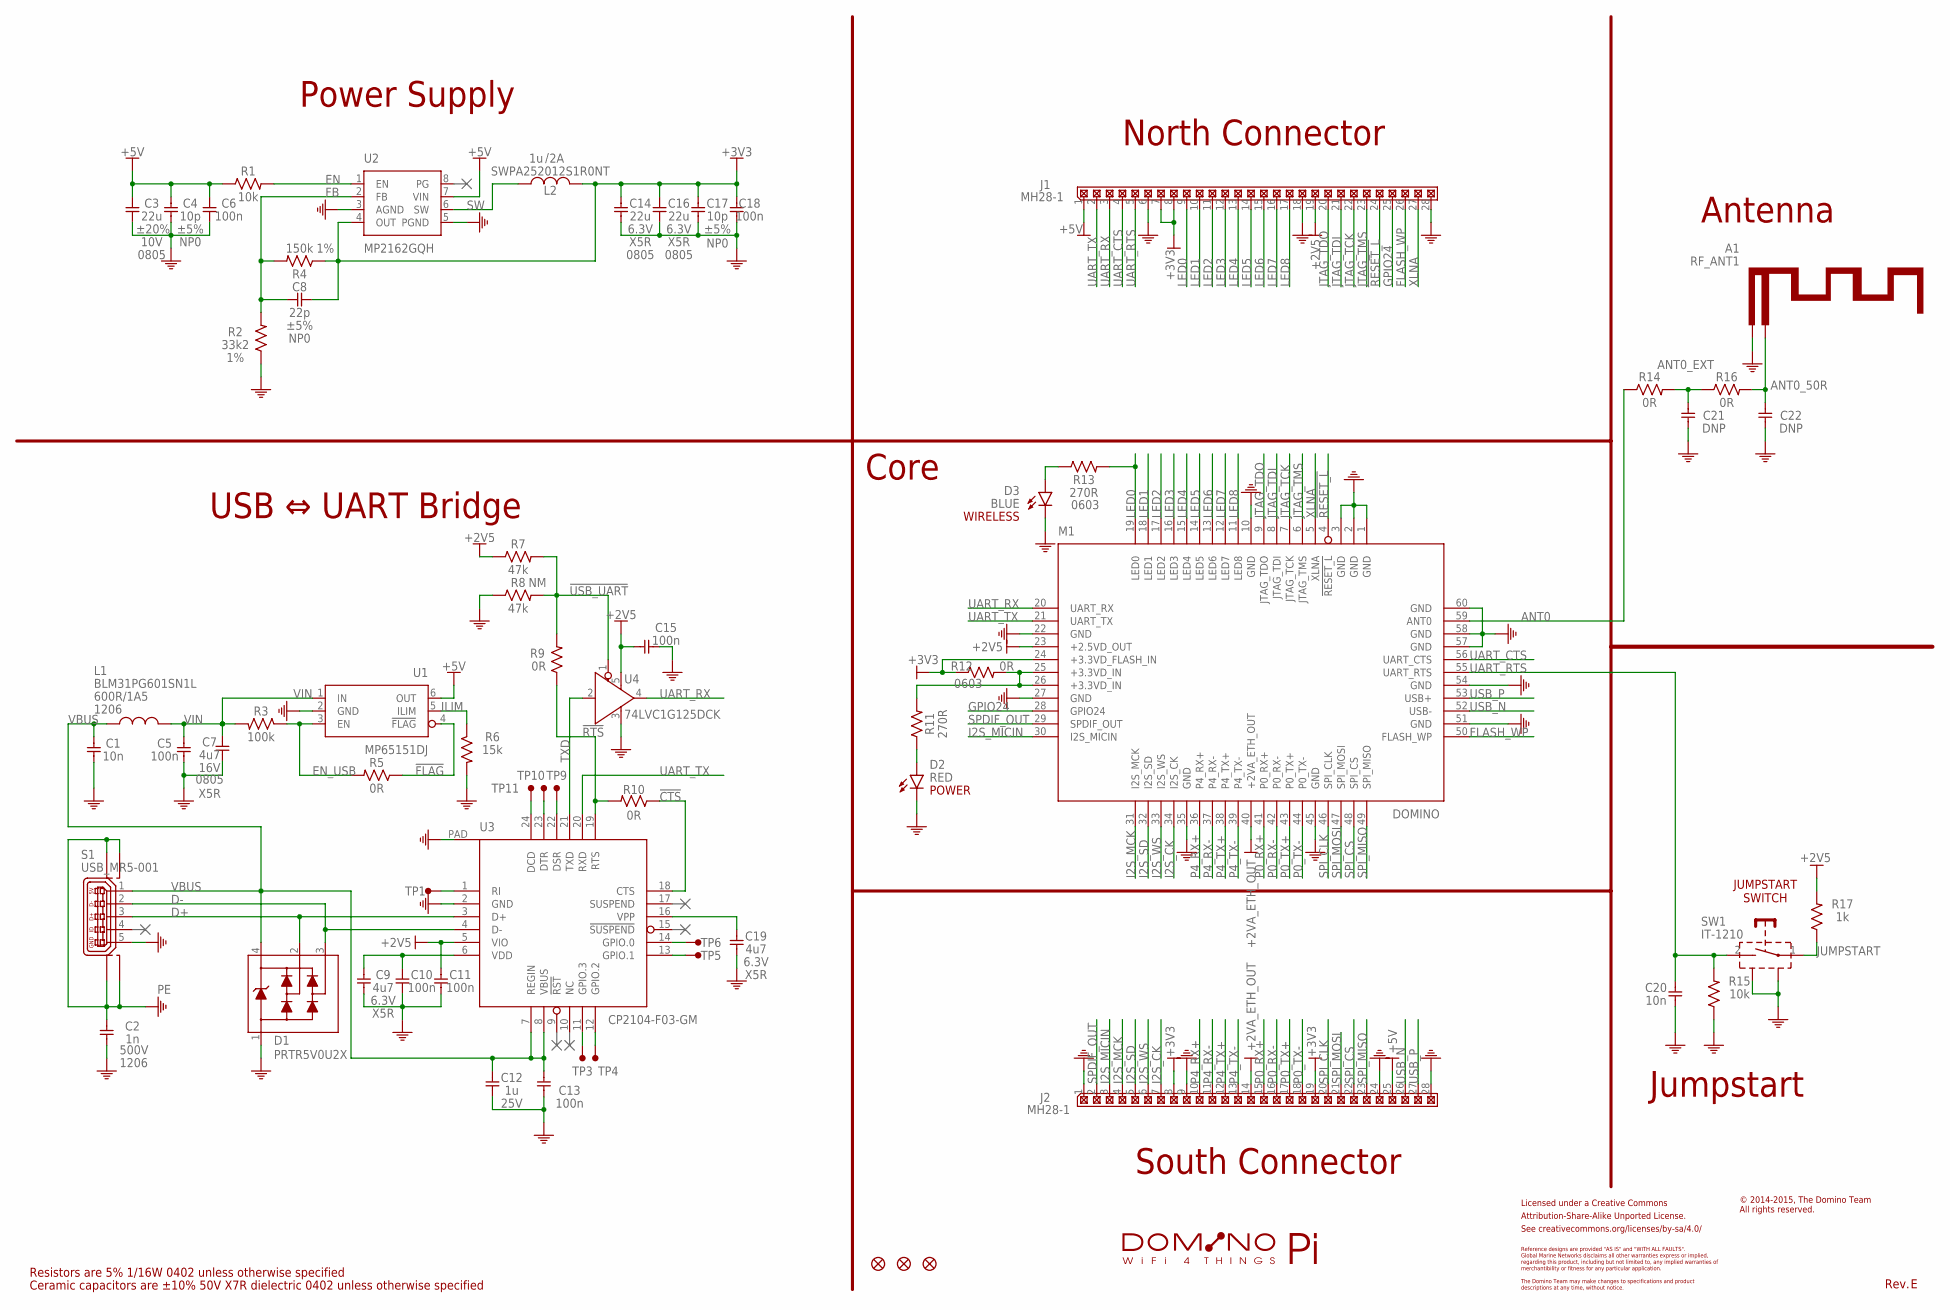
[picture p93: schematic Domino Pi No Teardrop.sch]

Parts:
A1: RF_ANT1; PARTNO WIFI_ANT-2.4GHz
C1, C20: 10n; C0402; PARTNO C0402_10n_X7R_10%_CER_50V
C2: 1n; C1206; PARTNO C1206_1n_X7R_10%_CER_500V
C3: 22u; C0805; PARTNO C1206_22u_X7R_20%_CER_10V
C4, C17: 10p; C0402; PARTNO C0402_10p_NP0_5%_CER_50V
C5, C6, C10, C11, C13, C15, C18: 100n; C0402; PARTNO C0402_100n_X7R_10%_CER_50V
C7: 4u7; C0805; PARTNO C0805_4u7_X5R_10%_CER_16V
C8: 22p; C0402; PARTNO C0402_22p_NP0_5%_CER_50V
C9, C19: 4u7; C0402; PARTNO C0402_4u7_X5R_10%_CER_6V3
C12: 1u; C0402; PARTNO C0402_1u_X7R_10%_CER_25V
C14, C16: 22u; C0805; PARTNO C0805_22u_X5R_20%_CER_6V3
C21, C22: DNP; C0402; PARTNO C0402_DNP
CC-BY-SA: CC-BY-SA_LOGO
D1: PRTR5V0U2X; SOT143B; PARTNO PRTR5V0U2X
D2: RED; LED0402; PARTNO LED0402-RED
D3: BLUE; LED0402; PARTNO LED0402-BLUE
F1, F2, F3: FIDUCIAL
J1, J2: MH28-1; MH28-1-0.1; PARTNO MH28-1-0.1
L1: BLM31PG601SN1L; FB1206; PARTNO BLM31PG601SN1L
L2: SWPA252012S1R0NT; SWPA252012S; PARTNO SWPA252012SMT
M1: DOMINO; PARTNO DOMINO-CORE
R1, R15: 10k; R0402; PARTNO R0402_10k_5%_62.5mW
R2: 33k2; R0402; PARTNO R0402_33k2_1%_62.5mW
R3: 100k; R0402; PARTNO R0402_100k_5%_62.5mW
R4: 150k; R0402; PARTNO R0402_150k_1%_62.5mW
R5, R9, R10, R14, R16: 0R; R0402; PARTNO R0402_0R_5%_62.5mW
R6: 15k; R0402; PARTNO R0402_15k_5%_62.5mW
R7, R8: 47k; R0402; PARTNO R0402_47k_5%_62.5mW
R11: 270R; R0402; PARTNO R0402_270R_5%_62.5mW
R12: 0R; R0603; PARTNO R0603_0R_5%_125mW
R13: 270R; R0603; PARTNO R0603_270R_5%_125mW
R17: 1k; R0402; PARTNO R0402_1k_5%_62.5mW
S1: USB_MR5-001; USB-MR5-001; PARTNO USB MR5-001
SW1: IT-1210; PARTNO IT-1210
TP1, TP3, TP4, TP5, TP6, TP9, TP10, TP11: TEST_PAD
U1: MP65151DJ; SOT23-6; PARTNO MP65151DJ
U2: MP2162GQH; QFN-8_2X1.5; PARTNO MP2162GQH
U3: CP2104-F03-GM; QFN-25_4X4; PARTNO CP2104-F03-GM
U4: 74LVC1G125DCK; SC70; PARTNO 74LVC1G125DCK
W1: DOMINO_PI_LOGO

Connections:
!CTS: R10.1, U3.18 (CTS)
!FLAG: R5.1, U1.4 (!FLAG)
!RESET_L: J1.24, M1.4 (!RESET_L)
!RTS: R9.1, R10.2, U3.19 (RTS)
!USB_UART: R7.2, R8.2, R9.2, U4.1 (!OE)
+2V5: C11.1, C15.2, J1.19, M1.23 (+2.5VD_OUT), R7.1, R17.2, U3.5 (VIO), U4.5 (VCC)
+2VA_ETH_OUT: J2.14, M1.40 (+2VA_ETH_OUT)
+3.3VD_IN: M1.25 (+3.3VD_IN), M1.26 (+3.3VD_IN), R11.2, R12.2
+3V3: C8.2, C14.1, C16.1, C17.1, C18.1, J1.7, J1.8, J2.8, J2.19, L2.2, M1.24 (+3.3VD_FLASH_IN), R4.1, R12.1, U2.4 (OUT)
+5V: C3.1, C4.1, C6.1, J1.1, J2.25, R1.1, U1.6 (OUT), U2.7 (VIN)
ANT0: M1.59 (ANT0), R14.1
ANT0_50R: A1.FEED, C22.1, R16.2
ANT0_EXT: C21.1, R14.2, R16.1
BLUE_LED: D3.2 (A), R13.1
D+: D1.2, S1.3, U3.3 (D+)
D-: D1.3, S1.2, U3.4 (D-)
EN: R1.2, U2.1 (EN)
EN_USB: R3.1, R5.2, U1.3 (EN)
FB: C8.1, R2.2, R4.2, U2.2 (FB)
FLASH_WP: J1.26, M1.50 (FLASH_WP)
GND: A1.GND, C1.2, C2.2, C3.2, C4.2, C5.2, C6.2, C7.2, C9.2, C10.2, C11.2, C12.2, C13.2, C14.2, C15.1, C16.2, C17.2, C18.2, C19.2, C20.2, C21.2, C22.2, D1.1, D2.1 (C), D3.1 (C), J1.6, J1.18, J1.28, J2.1, J2.9, J2.24, J2.28, M1.1 (GND), M1.2 (GND), M1.3 (GND), M1.10 (GND), M1.22 (GND), M1.27 (GND), M1.35 (GND), M1.45 (GND), M1.51 (GND), M1.54 (GND), M1.57 (GND), M1.58 (GND), M1.60 (GND), R2.1, R6.2, R8.1, R15.1, S1.5, SW1.SH$1, SW1.SH$2, U1.2 (GND), U2.3 (AGND), U2.5 (PGND), U3.2 (GND), U3.PAD, U4.3 (GND)
GPIO24: J1.25, M1.28 (GPIO24)
I2S_CK: J2.7, M1.34 (I2S_CK)
I2S_MCK: J2.4, M1.31 (I2S_MCK)
I2S_MICIN: J2.3, M1.30 (I2S_MICIN)
I2S_SD: J2.5, M1.32 (I2S_SD)
I2S_WS: J2.6, M1.33 (I2S_WS)
ILIM: R6.1, U1.5 (ILIM)
JTAG_TCK: J1.22, M1.7 (JTAG_TCK)
JTAG_TDI: J1.21, M1.8 (JTAG_TDI)
JTAG_TDO: J1.20, M1.9 (JTAG_TDO)
JTAG_TMS: J1.23, M1.6 (JTAG_TMS)
JUMPSTART: R17.1, SW1.1
LED0: J1.9, M1.19 (LED0), R13.2
LED1: J1.10, M1.18 (LED1)
LED2: J1.11, M1.17 (LED2)
LED3: J1.12, M1.16 (LED3)
LED4: J1.13, M1.15 (LED4)
LED5: J1.14, M1.14 (LED5)
LED6: J1.15, M1.13 (LED6)
LED7: J1.16, M1.12 (LED7)
LED8: J1.17, M1.11 (LED8)
unnamed: D2.2 (A), R11.1
unnamed: TP9.1, U3.22 (DSR)
unnamed: TP1.1, U3.1 (RI)
unnamed: TP3.1, U3.11 (GPIO.3)
unnamed: TP4.1, U3.12 (GPIO.2)
unnamed: TP10.1, U3.23 (DTR)
unnamed: TP11.1, U3.24 (DCD)
unnamed: TP6.1, U3.14 (GPIO.0)
unnamed: TP5.1, U3.13 (GPIO.1)
unnamed: C19.1, U3.16 (VPP)
P0_RX+: J2.15, M1.41 (P0_RX+)
P0_RX-: J2.16, M1.42 (P0_RX-)
P0_TX+: J2.17, M1.43 (P0_TX+)
P0_TX-: J2.18, M1.44 (P0_TX-)
P4_RX+: J2.10, M1.36 (P4_RX+)
P4_RX-: J2.11, M1.37 (P4_RX-)
P4_TX+: J2.12, M1.38 (P4_TX+)
P4_TX-: J2.13, M1.39 (P4_TX-)
PE: C2.1, S1.SH$1 (M0), S1.SH$2 (M1), S1.SH$3 (M2), S1.SH$4 (M3)
SPDIF_OUT: J2.2, M1.29 (SPDIF_OUT)
SPI_CLK: J2.20, M1.46 (SPI_CLK)
SPI_CS: J2.22, M1.48 (SPI_CS)
SPI_MISO: J2.23, M1.49 (SPI_MISO)
SPI_MOSI: J2.21, M1.47 (SPI_MOSI)
SW: L2.1, U2.6 (SW)
TXD: U3.21 (TXD), U4.2 (A)
UART_CTS: J1.4, M1.56 (UART_CTS)
UART_RTS: C20.1, J1.5, M1.55 (UART_RTS), R15.2, SW1.2
UART_RX: J1.3, M1.20 (UART_RX), U4.4 (Y)
UART_TX: J1.2, M1.21 (UART_TX), U3.20 (RXD)
USB_N: J2.26, M1.52 (USB-)
USB_P: J2.27, M1.53 (USB+)
VBUS: C1.1, C12.1, C13.1, D1.4, L1.2, S1.1, U3.7 (REGIN), U3.8 (VBUS)
VDD: C9.1, C10.1, U3.6 (VDD)
VIN: C5.1, C7.1, L1.1, R3.2, U1.1 (IN)
XLNA: J1.27, M1.5 (XLNA)

Notes on the sheet:
Power Supply
North Connector
South Connector
Antenna
Core
USB ⇔ UART Bridge
Ceramic capacitors are ±10% 50V X7R dielectric 0402 unless otherwise specified
Resistors are 5% 1/16W 0402 unless otherwise specified
Licensed under a Creative Commons
Attribution-Share-Alike Unported License.
See creativecommons.org/licenses/by-sa/4.0/
Reference designs are provided "AS IS" and "WITH ALL FAULTS".
regarding this product, including but not limited to, any implied warranties of
The Domino Team may make changes to specifications and product
Global Marine Networks disclaims all other warranties express or implied,
merchantibility or fitness for any particular application.
descriptions at any time, without notice.
© 2014-2015, The Domino Team All rights reserved.
Rev.
WIRELESS
POWER
JUMPSTART SWITCH
Jumpstart

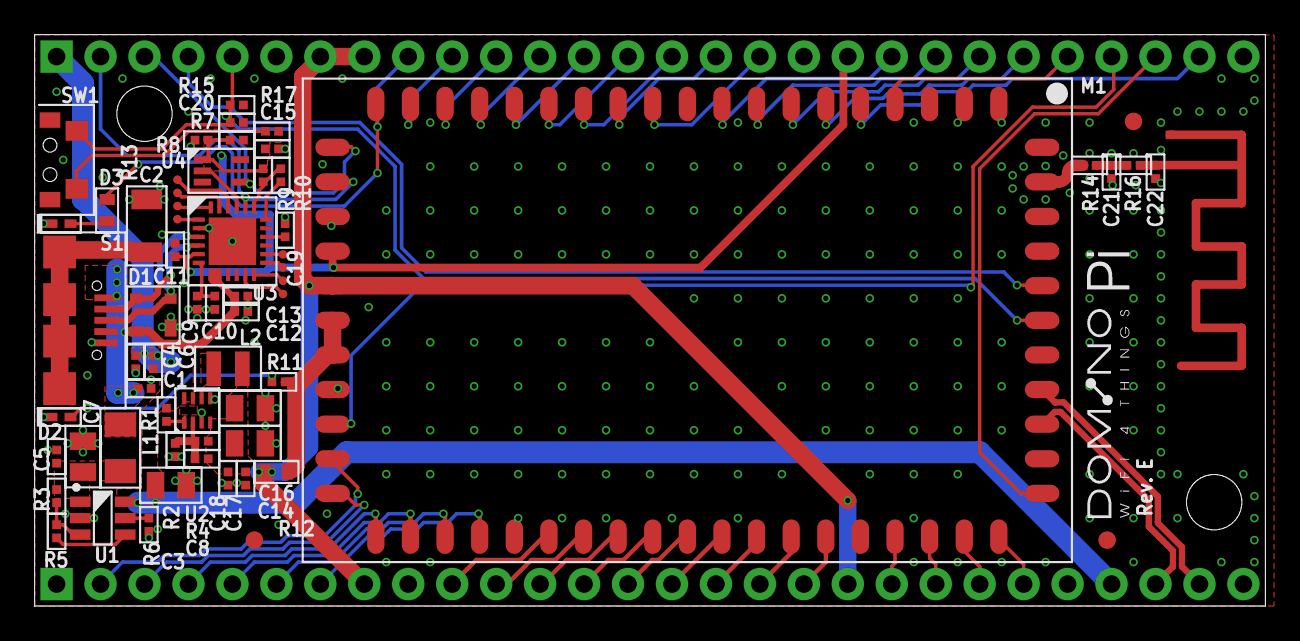
[picture p94: board Domino Pi No Teardrop.brd from above]

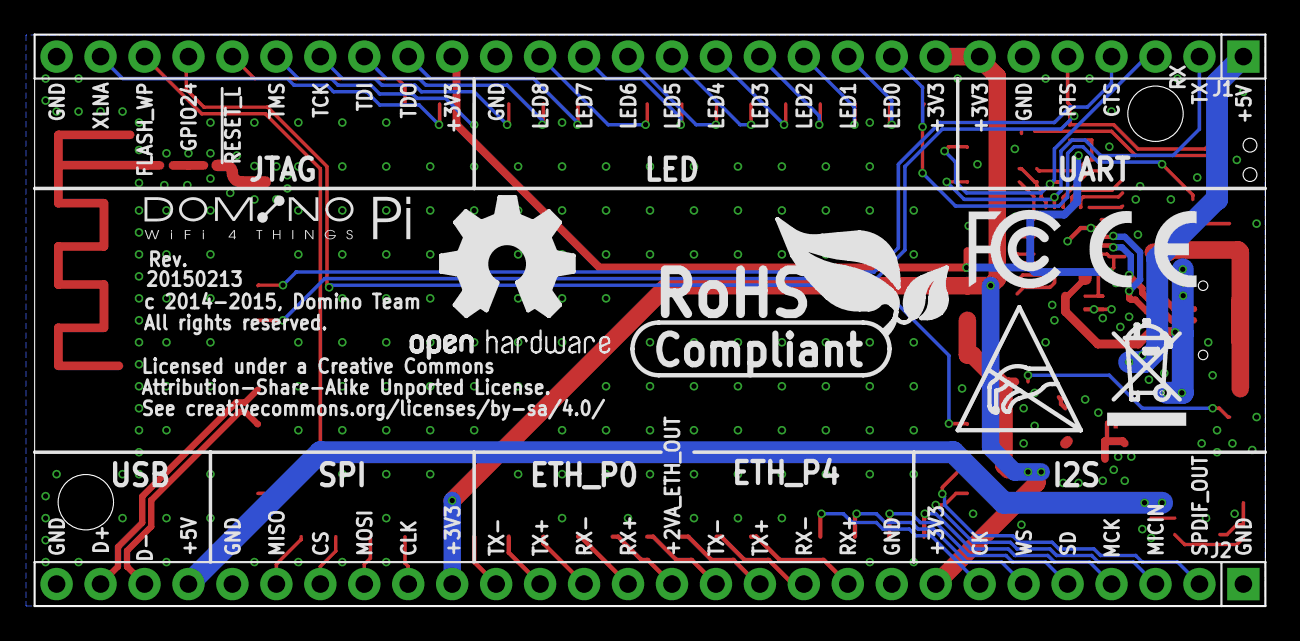
[picture p95: board Domino Pi No Teardrop.brd from below]

Board: 2 copper layers, 71.1 x 33.0 mm, 77 parts (9 on the bottom side), 78 nets.

Other parts of the board:
DRILEGEND: DRILEGEND
U$6, U$8: DOMINO_PI_LOGO_SMALL
U$28: A5L-LOC
U$36: ESD_LOGO
U$38: OPEN_HARDWARE_LOGO
U$39: RECYCLE_BIN_LOGO
U$40: ROHS_LOGO
U$41: CE_LOGO_SMALL
U$42: FCC_LOGO_SMALL
