domino-team/domino-hardware/Domino LED/Domino LED No Teardrop.brd

## EAGLE design Domino LED/Domino LED No Teardrop.brd (2015-02-13)

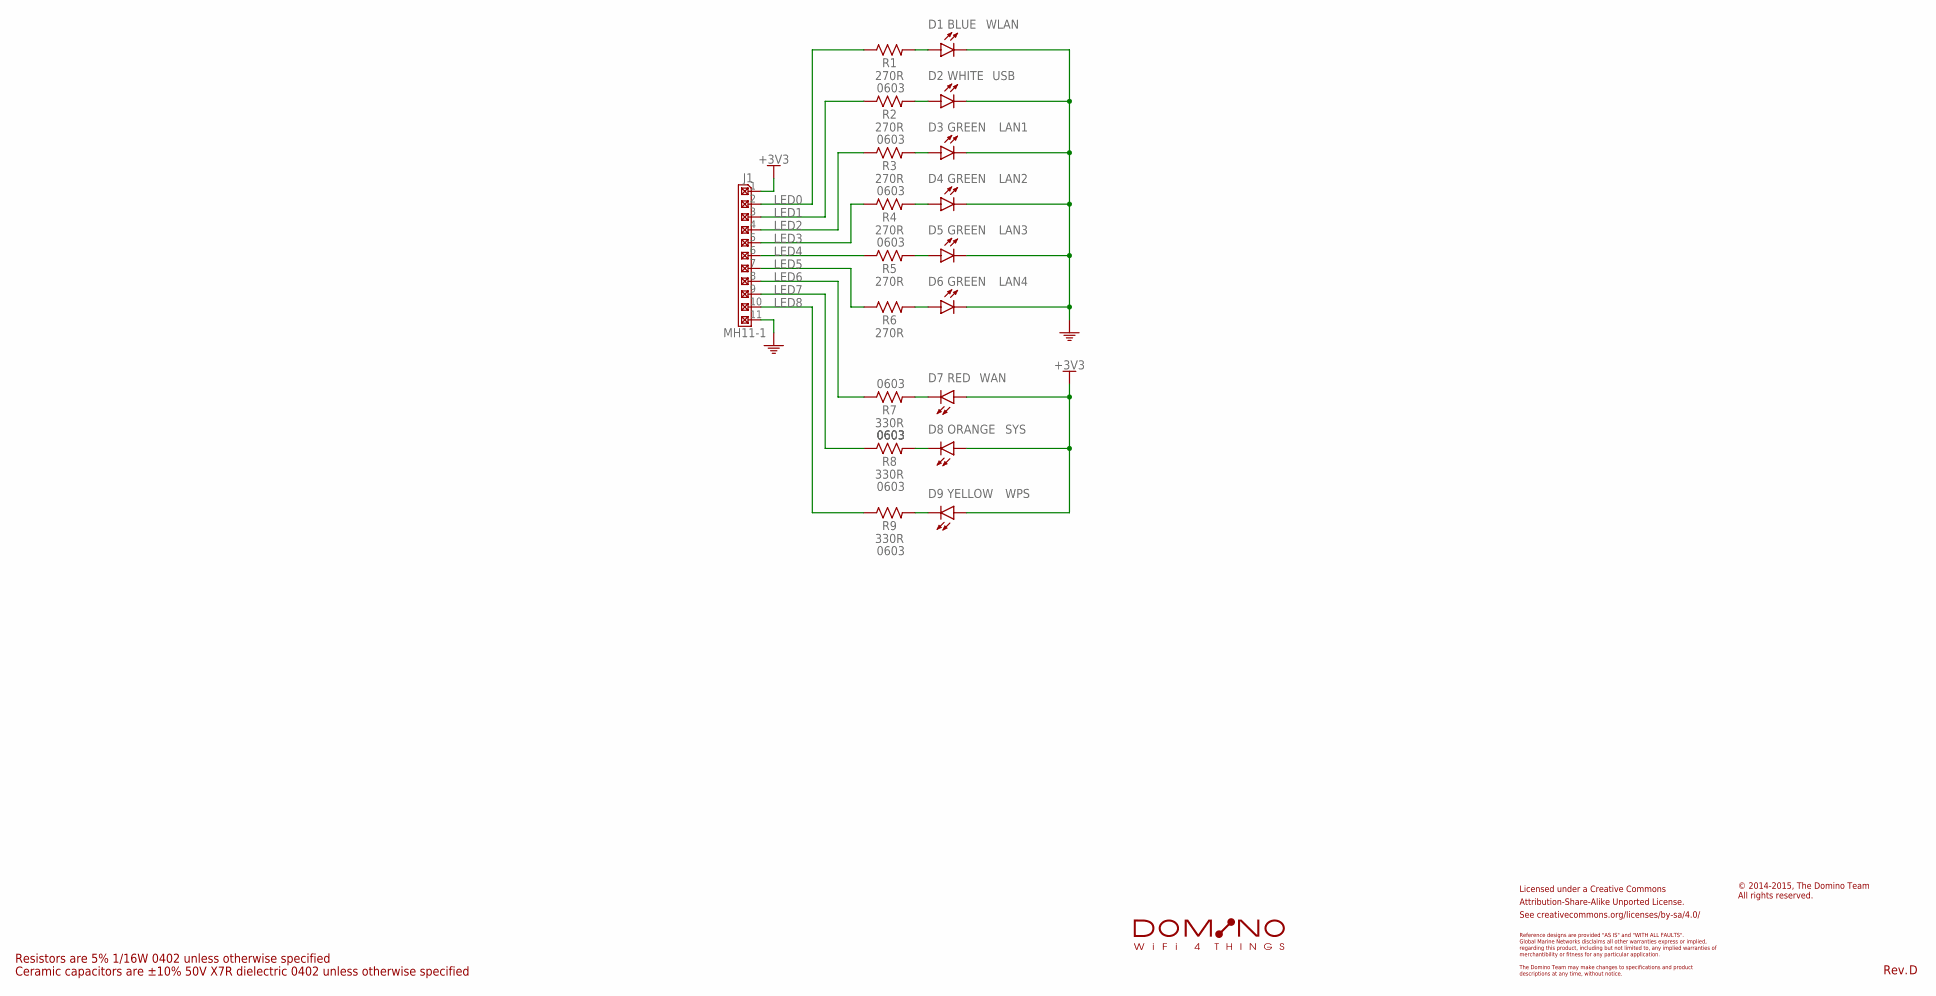
[picture p96: schematic Domino LED No Teardrop.sch]

Parts:
CC-BY-SA1: CC-BY-SA_LOGO
D1: BLUE; LED0603; PARTNO LED0603-BLUE
D2: WHITE; LED0603; PARTNO LED0603-WHITE
D3, D4, D5, D6: GREEN; LED0603; PARTNO LED0603-GREEN
D7: RED; LED0603; PARTNO LED0603-RED
D8: ORANGE; LED0603; PARTNO LED0603-ORANGE
D9: YELLOW; LED0603; PARTNO LED0603-YELLOW
J1: MH11-1; MH11-1-0.1; PARTNO MH11-1-0.1
R1, R2, R3, R4, R5, R6: 270R; R0603; PARTNO R0603_270R_5%_125mW
R7, R8, R9: 330R; R0603; PARTNO R0603_330R_5%_125mW
U$4: DOMINO_LOGO

Connections:
+3V3: D7.2 (A), D8.2 (A), D9.2 (A), J1.1
GND: D1.1 (C), D2.1 (C), D3.1 (C), D4.1 (C), D5.1 (C), D6.1 (C), J1.11
LED0: J1.2, R1.1
LED1: J1.3, R2.1
LED2: J1.4, R3.1
LED3: J1.5, R4.1
LED4: J1.6, R5.1
LED5: J1.7, R6.1
LED6: J1.8, R7.1
LED7: J1.9, R8.1
LED8: J1.10, R9.1
unnamed: D1.2 (A), R1.2
unnamed: D2.2 (A), R2.2
unnamed: D3.2 (A), R3.2
unnamed: D4.2 (A), R4.2
unnamed: D5.2 (A), R5.2
unnamed: D7.1 (C), R7.2
unnamed: D8.1 (C), R8.2
unnamed: D9.1 (C), R9.2
unnamed: D6.2 (A), R6.2

Notes on the sheet:
Ceramic capacitors are ±10% 50V X7R dielectric 0402 unless otherwise specified
Resistors are 5% 1/16W 0402 unless otherwise specified
Licensed under a Creative Commons
Attribution-Share-Alike Unported License.
See creativecommons.org/licenses/by-sa/4.0/
Reference designs are provided "AS IS" and "WITH ALL FAULTS".
regarding this product, including but not limited to, any implied warranties of
The Domino Team may make changes to specifications and product
Global Marine Networks disclaims all other warranties express or implied,
merchantibility or fitness for any particular application.
descriptions at any time, without notice.
© 2014-2015, The Domino Team All rights reserved.
Rev.
WLAN
USB
LAN1
LAN2
LAN3
LAN4
WAN
SYS
WPS

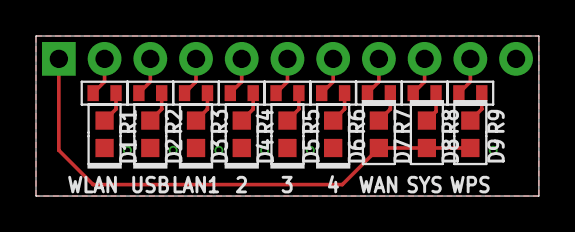
[picture p97: board Domino LED No Teardrop.brd from above]

Board: 2 copper layers, 27.9 x 8.9 mm, 23 parts (1 on the bottom side), 20 nets.

Other parts of the board:
DRILEGEND: DRILEGEND
U$3: A5L-LOC
