domino-team/domino-hardware/Domino JTAG SPI/Domino JTAG SPI.brd

## EAGLE design Domino JTAG SPI/Domino JTAG SPI.brd (2015-02-12)

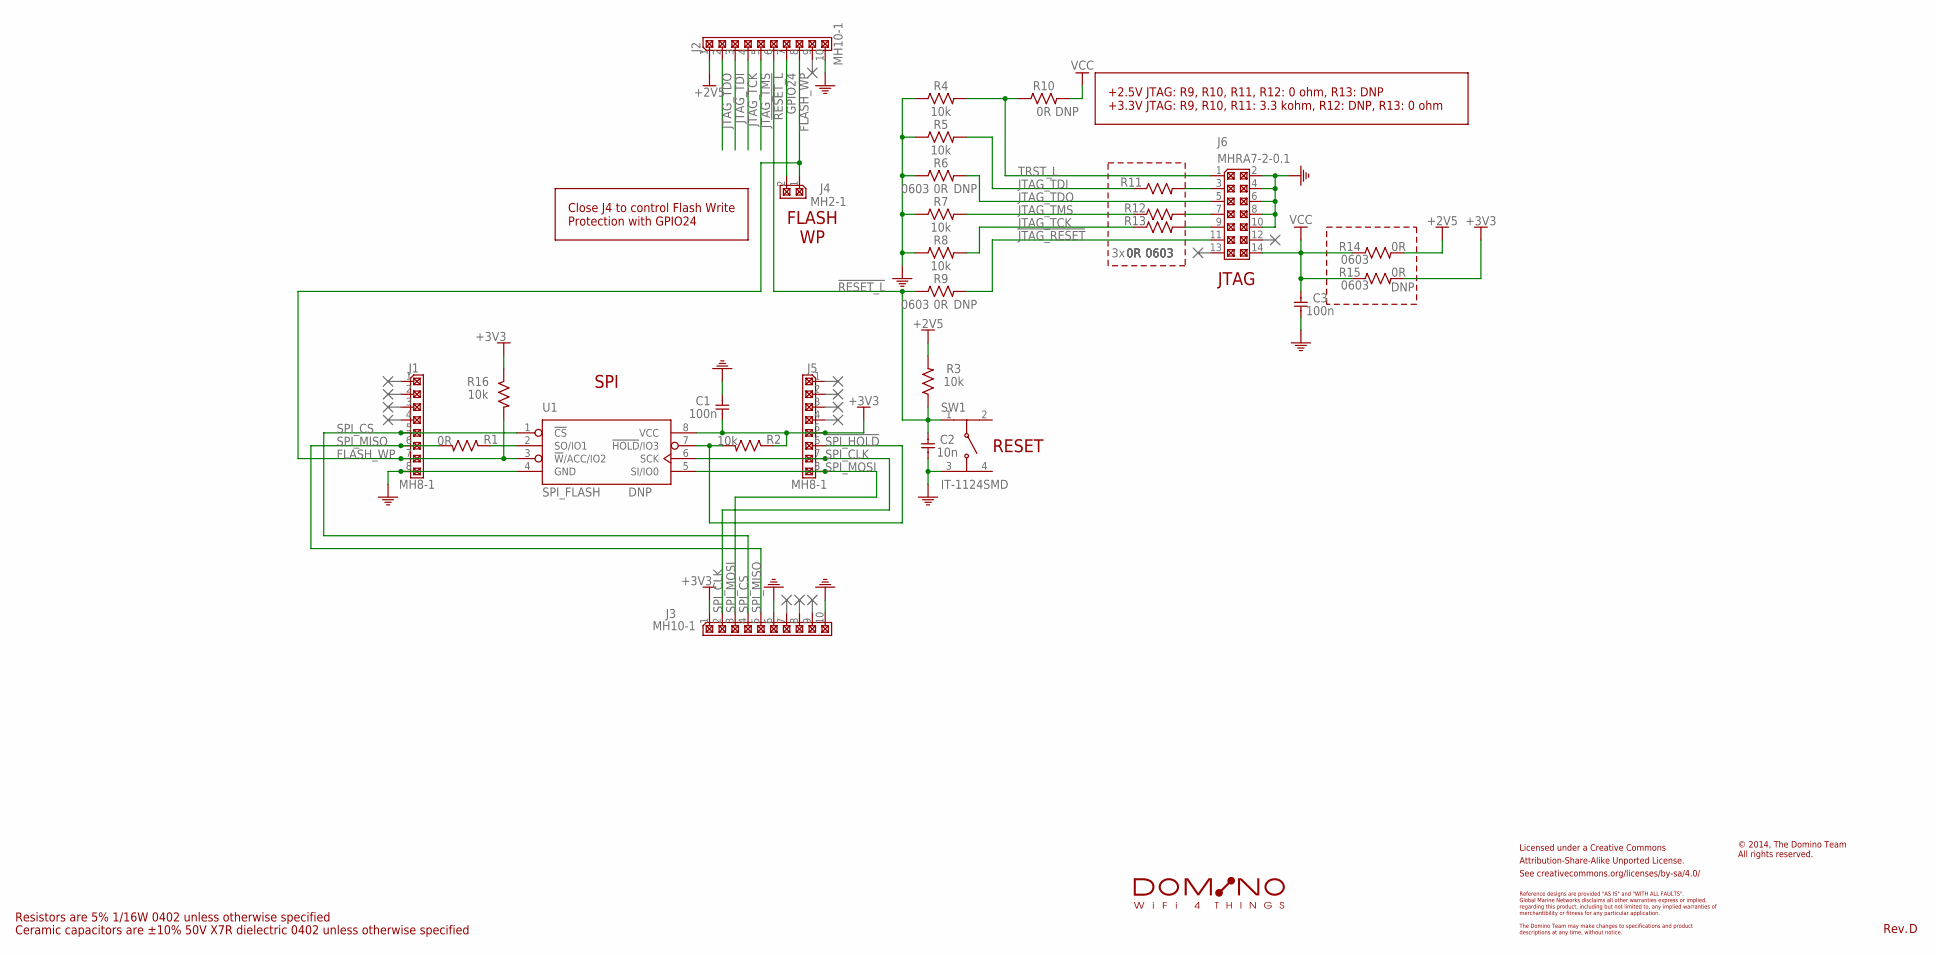
[picture p98: schematic Domino JTAG SPI.sch]

Parts:
C1, C3: 100n; C0402; PARTNO C0402_100n_X7R_10%_CER_50V
C2: 10n; C0402; PARTNO C0402_10n_X7R_10%_CER_50V
CC-BY-SA1: CC-BY-SA_LOGO
J1, J5: MH8-1; MH8-1-0.1; PARTNO MH8-1-0.1
J2, J3: MH10-1; MH10-1-0.1; PARTNO MH10-1-0.1
J4: MH2-1; MH2-1-0.1; PARTNO MH2-1-0.1
J6: MHRA7-2-0.1; PARTNO MHRA7-2-0.1
R1: 0R; R0402; PARTNO R0402_0R_5%_62.5mW
R2, R3, R4, R5, R7, R8, R16: 10k; R0402; PARTNO R0402_10k_5%_62.5mW
R6, R9, R10, R11, R12, R13, R14, R15: 0R; R0603; PARTNO R0603_0R_5%_125mW
SW1: IT-1124SMD; PARTNO IT-1124SMD
U1: SPI_FLASH; SOIC-8; PARTNO SPI_FLASH
U$2: DOMINO_LOGO

Connections:
!JTAG_RESET: J6.11, R9.2
!RESET_L: C2.1, J2.6, R3.1, R9.1, SW1.1
!SPI_HOLD: J5.6, R2.2, U1.7 (!HOLD!/IO3)
+2V5: J2.1, R3.2, R14.2
+3V3: C1.2, J3.1, J5.5, R2.1, R15.2, R16.1, U1.8 (VCC)
FLASH_WP: J1.7, J2.8, J4.1, R16.2, U1.3 (!W!/ACC/IO2)
GND: C1.1, C2.2, C3.2, J1.8, J2.10, J3.6, J3.10, J6.2, J6.4, J6.6, J6.8, J6.10, R4.1, R5.1, R6.1, R7.1, R8.1, SW1.3, U1.4 (GND)
GPIO24: J2.7, J4.2
JTAG_TCK: J2.4, R8.2, R13.1
JTAG_TDI: J2.3, R5.2, R11.1
JTAG_TDO: J2.2, J6.5, R6.2
JTAG_TMS: J2.5, R7.2, R12.1
unnamed: J6.7, R12.2
unnamed: J6.9, R13.2
unnamed: J6.3, R11.2
unnamed: R1.1, U1.2 (SO/IO1)
SPI_CLK: J3.2, J5.7, U1.6 (SCK)
SPI_CS: J1.5, J3.4, U1.1 (!CS)
SPI_MISO: J1.6, J3.5, R1.2
SPI_MOSI: J3.3, J5.8, U1.5 (SI/IO0)
TRST_L: J6.1, R4.2, R10.1
VCC: C3.1, J6.14, R10.2, R14.1, R15.1

Notes on the sheet:
Ceramic capacitors are ±10% 50V X7R dielectric 0402 unless otherwise specified
Resistors are 5% 1/16W 0402 unless otherwise specified
Licensed under a Creative Commons
Attribution-Share-Alike Unported License.
See creativecommons.org/licenses/by-sa/4.0/
Reference designs are provided "AS IS" and "WITH ALL FAULTS".
regarding this product, including but not limited to, any implied warranties of
The Domino Team may make changes to specifications and product
Global Marine Networks disclaims all other warranties express or implied,
merchantibility or fitness for any particular application.
descriptions at any time, without notice.
© 2014, The Domino Team All rights reserved.
Rev.
FLASH WP
SPI
JTAG
+2.5V JTAG: R9, R10, R11, R12: 0 ohm, R13: DNP +3.3V JTAG: R9, R10, R11: 3.3 kohm, R12: DNP, R13: 0 ohm
Close J4 to control Flash Write Protection with GPIO24
RESET

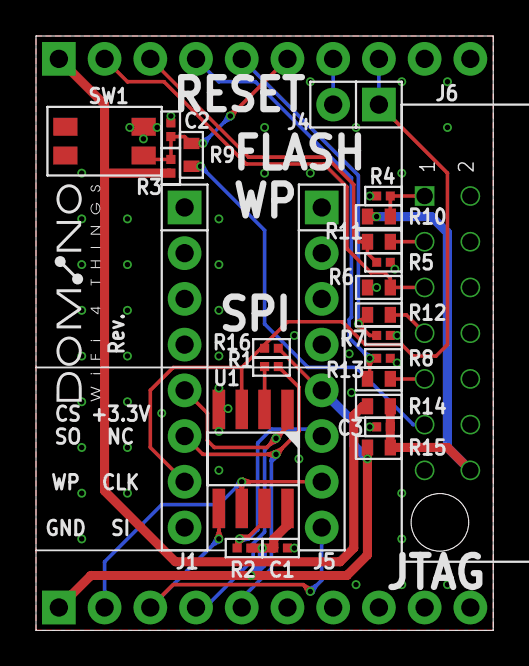
[picture p99: board Domino JTAG SPI.brd from above]

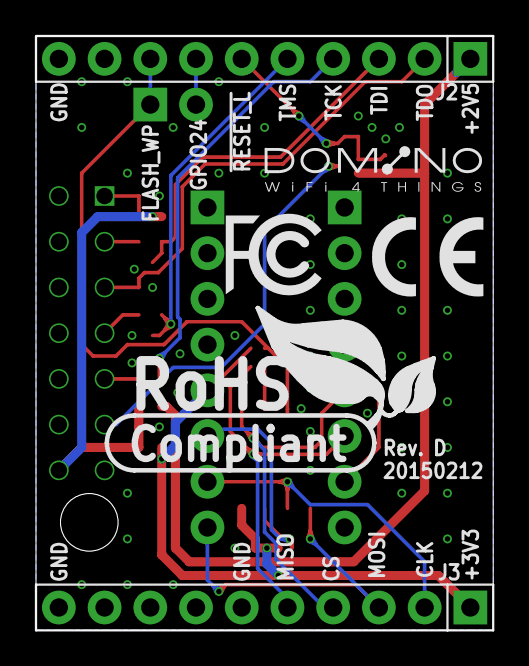
[picture p100: board Domino JTAG SPI.brd from below]

Board: 2 copper layers, 25.4 x 33.0 mm, 36 parts (6 on the bottom side), 22 nets.

Other parts of the board:
DRILEGEND: DRILEGEND
U$3: A5L-LOC
U$6: ROHS_LOGO
U$8: CE_LOGO_SMALL
U$10: FCC_LOGO_SMALL
U$11, U$12: DOMINO_LOGO_SMALL
