domino-team/domino-hardware/Domino I2S/Domino I2S.brd

## EAGLE design Domino I2S/Domino I2S.brd (2015-02-12)

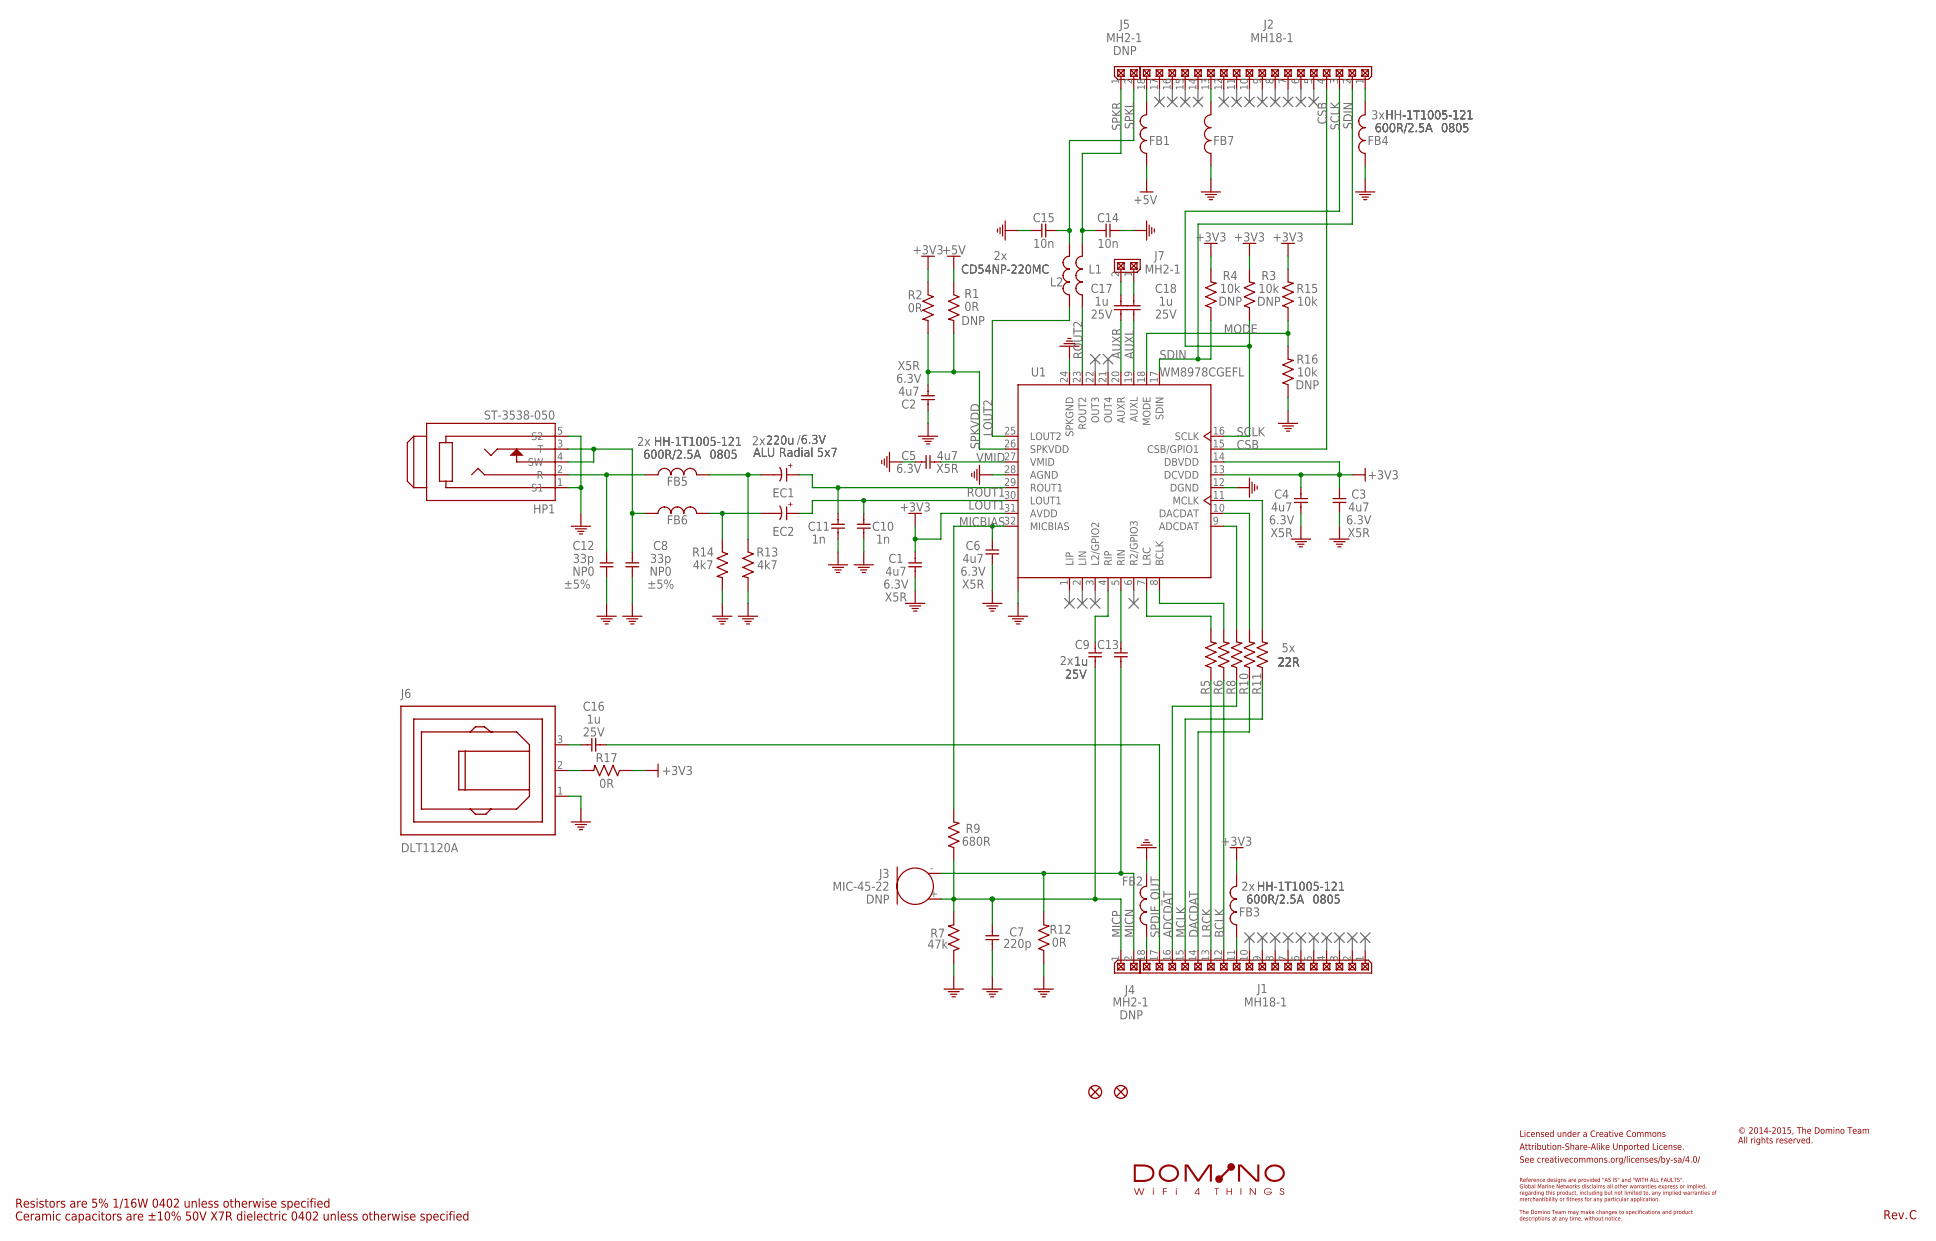
[picture p101: schematic Domino I2S.sch]

Parts:
C1, C2, C3, C4, C5, C6: 4u7; C0402; PARTNO C0402_4u7_X5R_10%_CER_6V3
C7: 220p; C0402; PARTNO C0402_220p_X7R_10%_CER_50V
C8, C12: 33p; C0402; PARTNO C0402_33p_NP0_5%_CER_50V
C9, C13, C16, C17, C18: 1u; C0402; PARTNO C0402_1u_X7R_10%_CER_25V
C10, C11: 1n; C0402; PARTNO C0402_1n_X7R_10%_CER_50V
C14, C15: 10n; C0402; PARTNO C0402_10n_X7R_10%_CER_50V
CC-BY-SA101: CC-BY-SA_LOGO
EC1, EC2: 220u; E2-5; PARTNO C2-5x7_220u_ALU_20%_RAD_6V3
F1, F2: FIDUCIAL
FB1, FB2, FB3, FB4, FB5, FB6, FB7: HH-1T1005-121; FB0805; PARTNO HH-1T2012-601
HP1: ST-3538-050; PARTNO ST-3538-050
J1, J2: MH18-1; MH18-1-0.1; PARTNO MH18-1-0.1
J3: MIC-45-22; PARTNO MIC-45-22
J4, J5, J7: MH2-1; MH2-1-0.1; PARTNO MH2-1-0.1
J6: DLT1120A; PARTNO DLT1120A
L1, L2: CD54NP-220MC; CD54; PARTNO CD54NP-220MC
R1, R2, R12, R17: 0R; R0402; PARTNO R0402_0R_5%_62.5mW
R3, R4, R15, R16: 10k; R0402; PARTNO R0402_10k_5%_62.5mW
R5, R6, R8, R10, R11: 22R; R0402; PARTNO R0402_22R_5%_62.5mW
R7: 47k; R0402; PARTNO R0402_47k_5%_62.5mW
R9: 680R; R0402; PARTNO R0402_680R_5%_62.5mW
R13, R14: 4k7; R0402; PARTNO R0402_4k7_5%_62.5mW
S101: DOMINO_LOGO
U1: WM8978CGEFL; QFN-32_EP_5X5; PARTNO WM8978CGEFL

Connections:
+3V3: C1.1, C3.1, C4.1, FB3.2, R2.1, R3.2, R4.2, R15.2, R17.1, U1.13 (DCVDD), U1.14 (DBVDD), U1.31 (AVDD)
+5V: FB1.1, R1.1
ADCDAT: J1.16, R8.1
AUXL: C18.2, U1.19 (AUXL)
AUXR: C17.2, U1.20 (AUXR)
BCLK: J1.12, R6.1
CSB: J2.4, U1.15 (CSB/GPIO1)
DACDAT: J1.14, R10.1
GND: C1.2, C2.1, C3.2, C4.2, C5.1, C6.2, C7.2, C8.1, C10.2, C11.2, C12.1, C14.2, C15.2, FB2.2, FB4.1, FB7.1, HP1.1 (S1), HP1.5 (S2), J6.1 (GND), R7.1, R12.1, R13.2, R14.2, R16.1, U1.12 (DGND), U1.24 (SPKGND), U1.28 (AGND), U1.PAD
LOUT1: C10.1, EC2.1 (+), U1.30 (LOUT1)
LOUT2: L2.1, U1.25 (LOUT2)
LRCK: J1.13, R5.1
MCLK: J1.15, R11.1
MICBIAS: C6.1, R9.2, U1.32 (MICBIAS)
MICN: C13.2, J3.-, J4.2, R12.2
MICP: C7.1, C9.2, J3.+, J4.1, R7.2, R9.1
MODE: R15.1, R16.2, U1.18 (MODE)
unnamed: R5.2, U1.7 (LRC)
unnamed: R6.2, U1.8 (BCLK)
unnamed: R8.2, U1.9 (ADCDAT)
unnamed: R10.2, U1.10 (DACDAT)
unnamed: R11.2, U1.11 (MCLK)
unnamed: C9.1, U1.4 (RIP)
unnamed: C13.1, U1.5 (RIN)
unnamed: C16.1, J6.3 (VIN)
unnamed: J6.2 (VCC), R17.2
unnamed: FB2.1, J1.18
unnamed: FB1.2, J2.18
unnamed: EC1.2 (-), FB5.2, R13.1
unnamed: EC2.2 (-), FB6.2, R14.1
unnamed: FB3.1, J1.11
unnamed: FB7.2, J2.13
unnamed: C8.2, FB6.1, HP1.3 (T), HP1.4 (SW)
unnamed: C12.2, FB5.1, HP1.2 (R)
unnamed: FB4.2, J2.1
unnamed: C17.1, J7.2
unnamed: C18.1, J7.1
ROUT1: C11.1, EC1.1 (+), U1.29 (ROUT1)
ROUT2: L1.1, U1.23 (ROUT2)
SCLK: J2.3, R3.1, U1.16 (SCLK)
SDIN: J2.2, R4.1, U1.17 (SDIN)
SPDIF_OUT: C16.2, J1.17
SPKL: C15.1, J5.2, L2.2
SPKR: C14.1, J5.1, L1.2
SPKVDD: C2.2, R1.2, R2.2, U1.26 (SPKVDD)
VMID: C5.2, U1.27 (VMID)

Notes on the sheet:
Ceramic capacitors are ±10% 50V X7R dielectric 0402 unless otherwise specified
Resistors are 5% 1/16W 0402 unless otherwise specified
Licensed under a Creative Commons
Attribution-Share-Alike Unported License.
See creativecommons.org/licenses/by-sa/4.0/
Reference designs are provided "AS IS" and "WITH ALL FAULTS".
regarding this product, including but not limited to, any implied warranties of
The Domino Team may make changes to specifications and product
Global Marine Networks disclaims all other warranties express or implied,
merchantibility or fitness for any particular application.
descriptions at any time, without notice.
© 2014-2015, The Domino Team All rights reserved.
Rev.
