domino-team/domino-hardware/Domino I2S/Domino I2S.brd

## EAGLE design Domino I2S/Domino I2S.brd (continued)

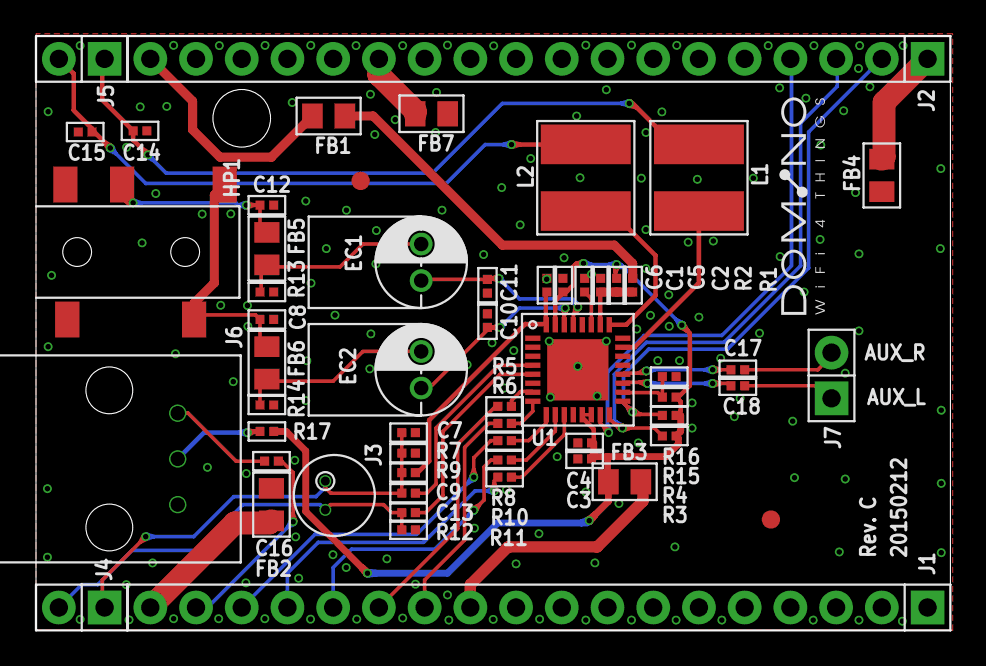
[picture p102: board Domino I2S.brd from above]

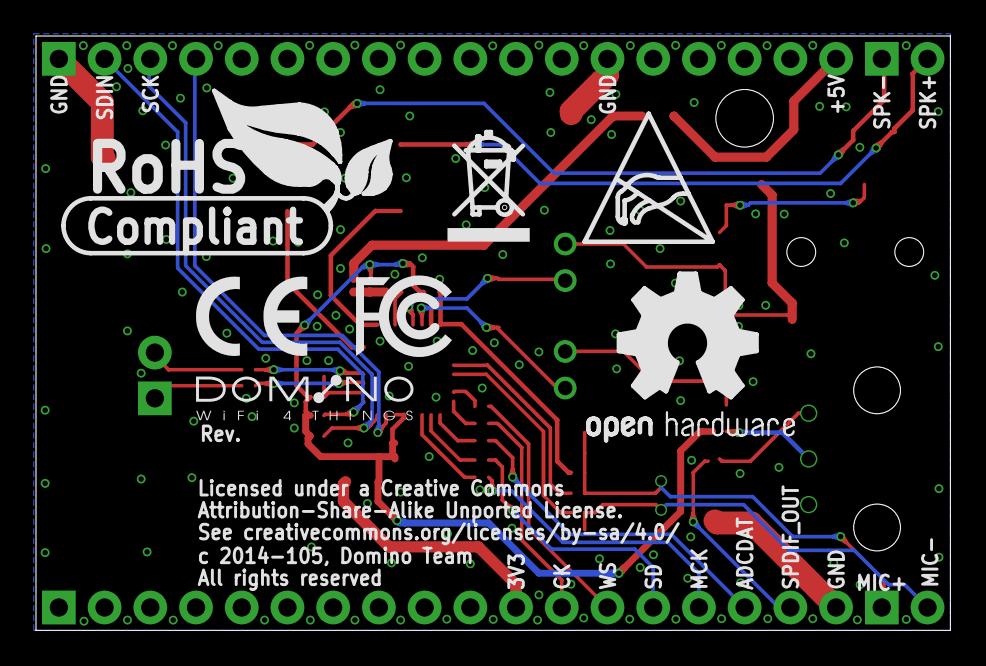
[picture p103: board Domino I2S.brd from below]

Board: 2 copper layers, 50.8 x 33.0 mm, 69 parts (7 on the bottom side), 46 nets.

Other parts of the board:
DRILEGEND: DRILEGEND
U$3: A5L-LOC
U$12, U$14: DOMINO_LOGO_SMALL
U$13: RECYCLE_BIN_LOGO
U$15: ESD_LOGO
U$16: OPEN_HARDWARE_LOGO
U$20: CE_LOGO_SMALL
U$21: FCC_LOGO_SMALL
U$22: ROHS_LOGO
