domino-team/domino-hardware/Domino Qi/Domino Qi.brd

## EAGLE design Domino Qi/Domino Qi.brd (2015-01-06)

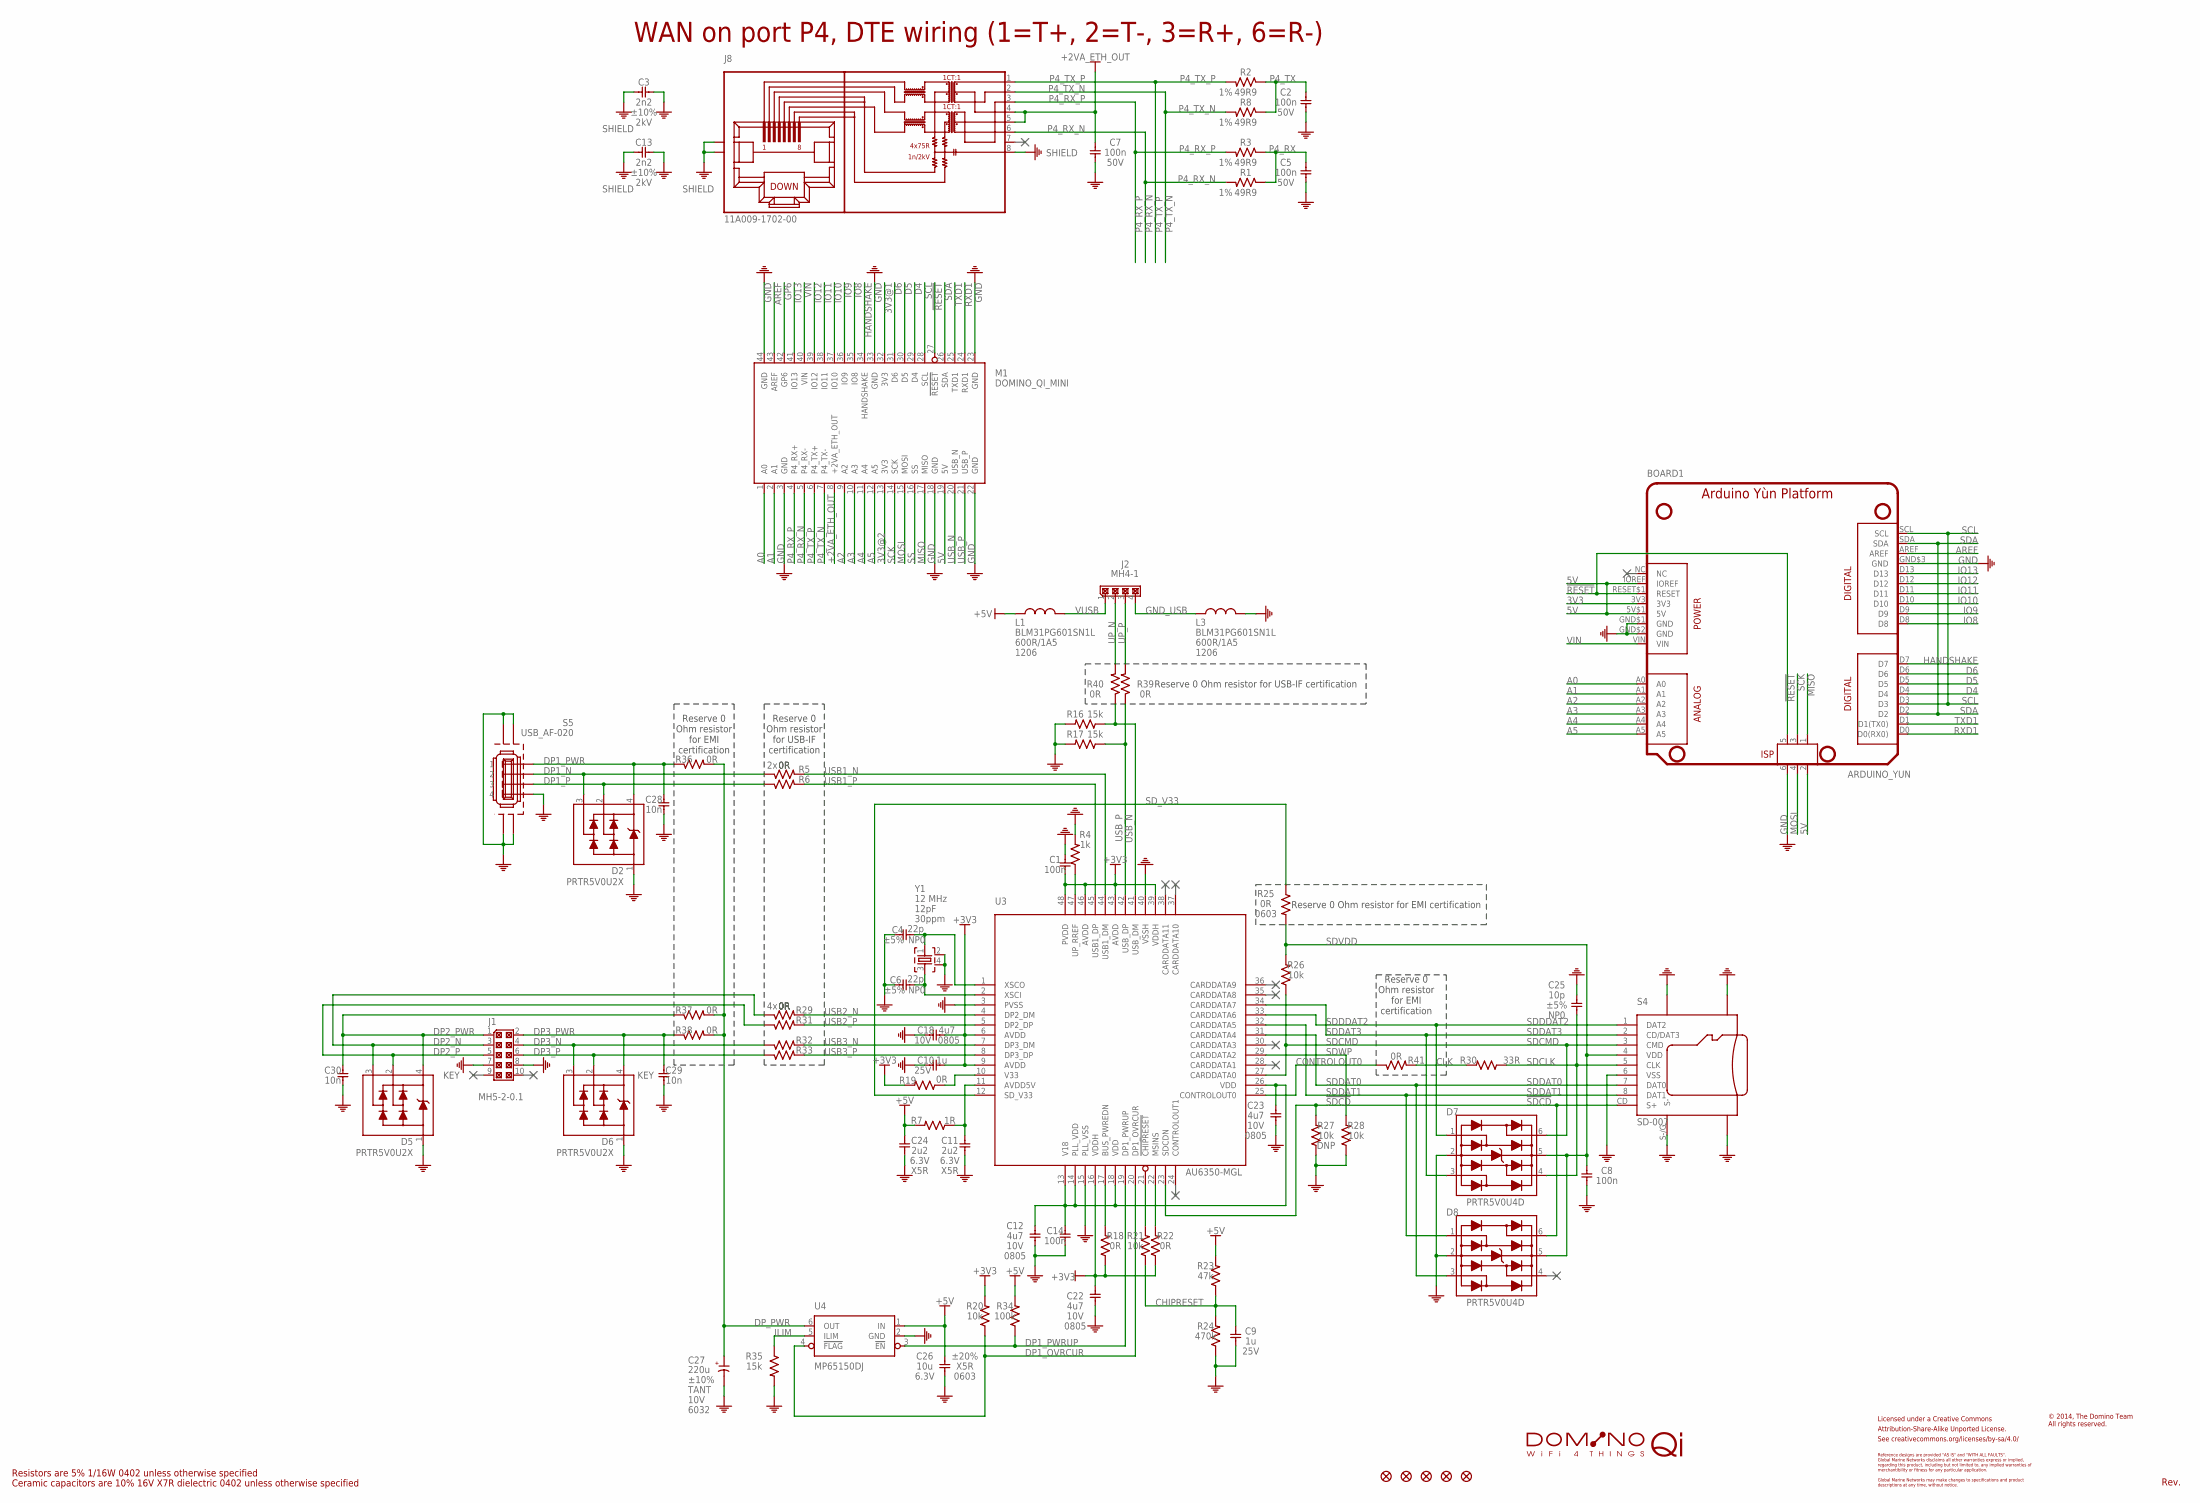
[picture p104: schematic Domino Qi.sch]

Parts:
BOARD1: ARDUINO_YUN; ARDUINO-YUN-PLATFORM
C1, C2, C5, C7, C8, C14: 100n; C0402; PARTNO C0402_100n_X7R_10%_CER_50V
C3, C13: 2n2; C1206; PARTNO C1210_2n2_X7R_10%_CER_2kV
C4, C6: 22p; C0402; PARTNO C0402_22p_NP0_5%_CER_50V
C9, C10: 1u; C0402; PARTNO C0402_1u_X7R_10%_CER_25V
C11, C24: 2u2; C0402; PARTNO C0402_2u2_X5R_10%_CER_6V3
C12, C18, C22, C23: 4u7; C0805; PARTNO C0805_4u7_X7R_10%_CER_6V3
C25: 10p; C0402; PARTNO C0402_10p_NP0_5%_CER_50V
C26: 10u; C0603; PARTNO C0603_10u_X5R_20%_CER_6V3
C27: 220u; C/6032-25; PARTNO CPOLC-6032_220u_20%_TANT_10V
C28, C29, C30: 10n; C0402; PARTNO C0402_10n_X7R_10%_CER_50V
D2, D5, D6: PRTR5V0U2X; SOT143B; PARTNO PRTR5V0U2X
D7, D8: PRTR5V0U4D; SOT23-6; PARTNO PRTR5V0U4D
F1, F2, F4, F5, F6: FIDUCIAL
J1: MH5-2-0.1; MH05-2-0.1; PARTNO MH5-2-0.1
J2: MH4-1; MH4-1-0.1; PARTNO MH4-1-0.1
J8: 11A009-1702-00; PARTNO 11A009-1702-00
L1, L3: BLM31PG601SN1L; FB1206; PARTNO BLM31PG601SN1L
M1: DOMINO_QI_MINI
R1, R2, R3, R8: 49R9; R0402; PARTNO R0402_49R9_1%_62.5mW
R4: 1k; R0402; PARTNO R0402_1k_5%_62.5mW
R5, R6, R18, R19, R22, R29, R31, R32, R33, R36, R37, R38, R39, R40, R41: 0R; R0402; PARTNO R0402_0R_5%_62.5mW
R7: 1R; R0402; PARTNO R0402_1R_5%_62.5mW
R16, R17, R35: 15k; R0402; PARTNO R0402_15k_5%_62.5mW
R20, R21, R26, R27, R28: 10k; R0402; PARTNO R0402_10k_5%_62.5mW
R23: 47k; R0402; PARTNO R0402_47k_5%_62.5mW
R24: 470k; R0402; PARTNO R0402_470k_5%_62.5mW
R25: 0R; R0603; PARTNO R0603_0R_5%_125mW
R30: 33R; R0402; PARTNO R0402_33R_5%_62.5mW
R34: 100k; R0402; PARTNO R0402_100k_5%_62.5mW
S4: SD-007; PARTNO SD-007
S5: USB_AF-020; PARTNO USB_AF-020
U3: AU6350-MGL; LQFP-48_7X7; PARTNO AU6350-MGL
U4: MP65150DJ; SOT23-6; PARTNO MP65150DJ
U$2: CC-BY-SA_LOGO
U$13: DOMINO_QI_LOGO
Y1: 12 MHz; CRYSTAL_32X25; PARTNO CRYSTAL_32X25_2SH_12PF_30PPM

Connections:
3V3: BOARD1.3V3
3V3@1: M1.32 (3V3)
3V3@2: M1.13 (3V3)
5V: BOARD1.2 (5V), BOARD1.5V$1 (5V), BOARD1.IOREF, M1.19 (5V)
!CHIPRESET: R21.2, U3.21 (!CHIPRESET)
!RESET: BOARD1.5 (RESET), BOARD1.RESET$1 (RESET), M1.27 (!RESET)
!SDCD: D8.6 (I/O4), R27.2, S4.CD (S+), U3.23 (SDCDN)
+2VA_ETH_OUT: C7.2, J8.4, J8.5, M1.8 (+2VA_ETH_OUT)
+3V3: C1.2, C10.2, C18.2, C22.2, R18.1, R19.2, R20.2, R22.1, U3.6 (AVDD), U3.9 (AVDD), U3.16 (VDDH), U3.39 (VDDH), U3.43 (AVDD), U3.46 (AVDD), U3.48 (PVDD)
+5V: C24.1, C26.1, L1.2, R7.2, R23.2, R34.2, U4.1 (IN)
A0: BOARD1.A0, M1.1 (A0)
A1: BOARD1.A1, M1.2 (A1)
A2: BOARD1.A2, M1.9 (A2)
A3: BOARD1.A3, M1.10 (A3)
A4: BOARD1.A4, M1.11 (A4)
A5: BOARD1.A5, M1.12 (A5)
AREF: BOARD1.AREF, M1.43 (AREF)
AVDD5V1: C11.1, R7.1, U3.11 (AVDD5V)
BUS_PWREDN: R18.2, U3.17 (BUS_PWREDN)
CHIPRESET: C9.1, R21.1, R23.1, R24.2
CLK: R30.2, R41.2
CONTROLOUT0: R41.1, U3.25 (CONTROLOUT0)
D4: BOARD1.D4, M1.29 (D4)
D5: BOARD1.D5, M1.30 (D5)
D6: BOARD1.D6, M1.31 (D6)
DP1_N: D2.3, R5.1, S5.2
DP1_OVRCUR: R20.1, U3.20 (DP1_OVRCUR), U4.4 (!FLAG)
DP1_P: D2.2, R6.1, S5.3
DP1_PWR: C28.1, D2.4, R36.1, S5.1
DP1_PWRUP: R34.1, U3.19 (DP1_PWRUP), U4.3 (!EN)
DP2_N: D5.3, J1.3, R29.1
DP2_P: D5.2, J1.5, R31.1
DP2_PWR: C30.1, D5.4, J1.1, R37.1
DP3_N: D6.3, J1.4, R32.1
DP3_P: D6.2, J1.6, R33.1
DP3_PWR: C29.1, D6.4, J1.2, R38.1
DP_PWR: C27.1 (+), R36.2, R37.2, R38.2, U4.6 (OUT)
GND: BOARD1.6 (GND), BOARD1.GND$1 (GND), BOARD1.GND$2 (GND), BOARD1.GND$3 (GND), C1.1, C2.1, C3.1, C4.1, C5.1, C6.1, C7.1, C8.2, C9.2, C10.1, C11.2, C12.1, C13.1, C14.2, C18.1, C22.1, C23.1, C24.2, C25.2, C26.2, C27.2 (-), C28.2, C29.2, C30.2, D2.1, D5.1, D6.1, D7.2 (GND), D8.2 (GND), J1.7, J1.8, L3.1, M1.3 (GND), M1.18 (GND), M1.22 (GND), M1.23 (GND), M1.33 (GND), M1.44 (GND), R4.2, R16.2, R17.2, R24.1, R27.1, R28.1, R35.2, S4.6 (VSS), S4.G$1 (G), S4.G$2 (G), S4.G$3 (G), S4.S-/G (S-), S5.4, S5.G$1 (G), S5.G$2 (G), S5.G$3 (G), S5.G$4 (G), U3.3 (PVSS), U3.15 (PLL_VSS), U3.40 (VSSH), U4.2 (GND), Y1.2, Y1.4
GND_USB: J2.4, L3.2
GP6: M1.42 (GP6)
HANDSHAKE: BOARD1.D7, M1.34 (HANDSHAKE)
ILIM: R35.1, U4.5 (ILIM)
IO8: BOARD1.D8, M1.35 (IO8)
IO9: BOARD1.D9, M1.36 (IO9)
IO10: BOARD1.D10, M1.37 (IO10)
IO11: BOARD1.D11, M1.38 (IO11)
IO12: BOARD1.D12, M1.39 (IO12)
IO13: BOARD1.D13, M1.41 (IO13)
MISO: BOARD1.1 (MISO), M1.17 (MISO)
MOSI: BOARD1.4 (MOSI), M1.15 (MOSI)
MSINS: R22.2, U3.22 (MSINS)
P4_RX: C5.2, R1.1, R3.1
P4_RX_N: J8.6, M1.5 (P4_RX-), R1.2
P4_RX_P: J8.3, M1.4 (P4_RX+), R3.2
P4_TX: C2.2, R2.1, R8.1
P4_TX_N: J8.2, M1.7 (P4_TX-), R8.2
P4_TX_P: J8.1, M1.6 (P4_TX+), R2.2
RXD1: BOARD1.D0 (D0(RX0)), M1.24 (RXD1)
SCK: BOARD1.3 (SCK), M1.14 (SCK)
SCL: BOARD1.D3, BOARD1.SCL, M1.28 (SCL)
SDA: BOARD1.D2, BOARD1.SDA, M1.26 (SDA)
SDCLK: C25.1, D7.4 (I/O3), R30.1, S4.5 (CLK)
SDCMD: D7.6 (I/O4), R26.1, S4.3 (CMD), U3.27 (CARDDATA0)
SDDAT0: D8.3 (I/O2), S4.7 (DAT0), U3.31 (CARDDATA4)
SDDAT1: D8.1 (I/O1), S4.8 (DAT1), U3.32 (CARDDATA5)
SDDAT3: D7.3 (I/O2), S4.2 (CD/DAT3), U3.34 (CARDDATA7)
SDDDAT2: D7.1 (I/O1), S4.1 (DAT2), U3.33 (CARDDATA6)
SDVDD: C8.1, D7.5 (VCC), D8.5 (VCC), R25.2, R26.2, S4.4 (VDD)
SDWP: R28.2, U3.29 (CARDDATA2)
SD_V33: R25.1, U3.12 (SD_V33)
SHIELD: C3.2, C13.2, J8.8, J8.SH$1 (SHIELD), J8.SH$2 (SHIELD)
SS: M1.16 (SS)
TXD1: BOARD1.D1 (D1(TX0)), M1.25 (TXD1)
UP_N: J2.2, R40.2
UP_P: J2.3, R39.2
UP_PREF: R4.1, U3.47 (UP_RREF)
USB1_N: R5.2, U3.44 (USB1_DM)
USB1_P: R6.2, U3.45 (USB1_DP)
USB2_N: R29.2, U3.4 (DP2_DM)
USB2_P: R31.2, U3.5 (DP2_DP)
USB3_N: R32.2, U3.7 (DP3_DM)
USB3_P: R33.2, U3.8 (DP3_DP)
USB_N: M1.20 (USB_N), R16.1, R40.1, U3.41 (USB_DM)
USB_P: M1.21 (USB_P), R17.1, R39.1, U3.42 (USB_DP)
V1: R19.1, U3.10 (V33)
V18: C12.2, C14.1, C23.2, U3.13 (V18), U3.14 (PLL_VDD), U3.18 (VDD), U3.26 (VDD)
VIN: BOARD1.VIN, M1.40 (VIN)
VUSB: J2.1, L1.1
XSCI: C6.2, U3.2 (XSCI), Y1.3
XSCO: C4.2, U3.1 (XSCO), Y1.1

Notes on the sheet:
Ceramic capacitors are 10% 16V X7R dielectric 0402 unless otherwise specified
Resistors are 5% 1/16W 0402 unless otherwise specified
Licensed under a Creative Commons
Attribution-Share-Alike Unported License.
See creativecommons.org/licenses/by-sa/4.0/
Reference designs are provided "AS IS" and "WITH ALL FAULTS".
regarding this product, including but not limited to, any implied warranties of
Global Marine Networks may make changes to specifications and product
Global Marine Networks disclaims all other warranties express or implied,
merchantibility or fitness for any particular application.
descriptions at any time, without notice.
© 2014, The Domino Team All rights reserved.
Rev.
KEY
Reserve 0 Ohm resistor for EMI certification
Reserve 0 Ohm resistor for EMI certification
Reserve 0 Ohm resistor for USB-IF certification
Reserve 0 Ohm resistor for USB-IF certification
WAN on port P4, DTE wiring (1=T+, 2=T-, 3=R+, 6=R-)

Board: 2 copper layers, 84 parts (2 on the bottom side), 85 nets, no tracks yet.

Other parts of the board:
DRILEGEND: DRILEGEND
U$28: A5L-LOC
