domino-team/domino-hardware/Domino USB MicroSD/Domino USB MicroSD No Teardrop New.brd

## EAGLE design Domino USB MicroSD/Domino USB MicroSD No Teardrop New.brd (2014-09-30)

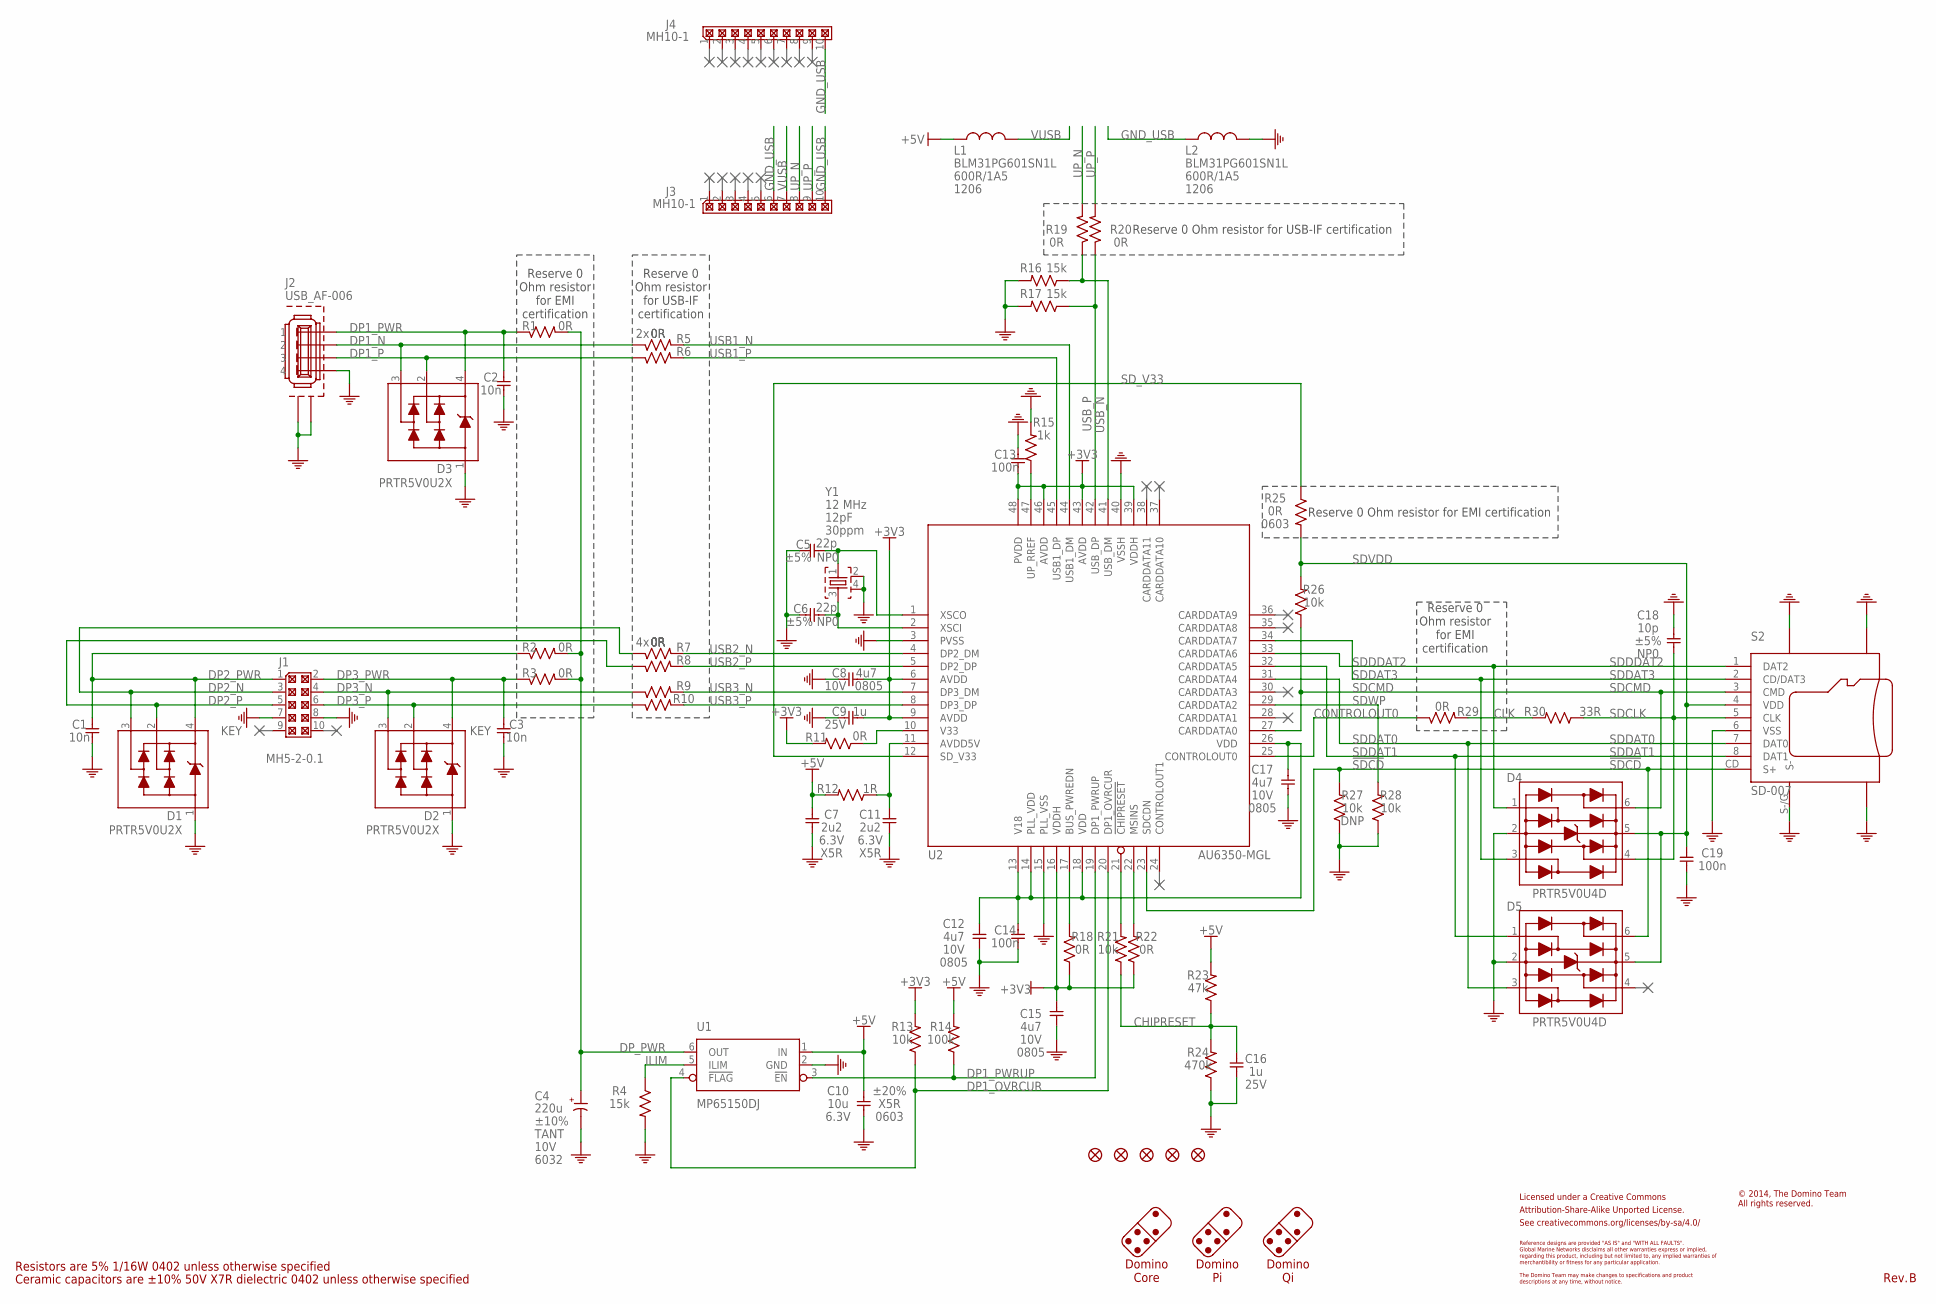
[picture p105: schematic Domino USB MicroSD No Teardrop New.sch]

Parts:
C1, C2, C3: 10n; C0402; PARTNO C0402_10n_X7R_10%_CER_50V
C4: 220u; C/6032-25; PARTNO CPOLC-6032_220u_20%_TANT_10V
C5, C6: 22p; C0402; PARTNO C0402_22p_NP0_5%_CER_50V
C7, C11: 2u2; C0402; PARTNO C0402_2u2_X5R_10%_CER_6V3
C8, C12, C15, C17: 4u7; C0805; PARTNO C0805_4u7_X7R_10%_CER_6V3
C9, C16: 1u; C0402; PARTNO C0402_1u_X7R_10%_CER_25V
C10: 10u; C0603; PARTNO C0603_10u_X5R_20%_CER_6V3
C13, C14, C19: 100n; C0402; PARTNO C0402_100n_X7R_10%_CER_50V
C18: 10p; C0402; PARTNO C0402_10p_NP0_5%_CER_50V
CC-BY-SA1: CC-BY-SA_LOGO
D1, D2, D3: PRTR5V0U2X; SOT143B; PARTNO PRTR5V0U2X
D4, D5: PRTR5V0U4D; SOT23-6; PARTNO PRTR5V0U4D
F1, F2, F4, F5, F6: FIDUCIAL
J1: MH5-2-0.1; MH05-2-0.1; PARTNO MH5-2-0.1
J2: USB_AF-006
J3, J4: MH10-1; MH10-1-0.1
L1, L2: BLM31PG601SN1L; FB1206; PARTNO BLM31PG601SN1L
R1, R2, R3, R5, R6, R7, R8, R9, R10, R11, R18, R19, R20, R22, R29: 0R; R0402; PARTNO R0402_0R_5%_62.5mW
R4, R16, R17: 15k; R0402; PARTNO R0402_15k_5%_62.5mW
R12: 1R; R0402; PARTNO R0402_1R_5%_62.5mW
R13, R21, R26, R27, R28: 10k; R0402; PARTNO R0402_10k_5%_62.5mW
R14: 100k; R0402; PARTNO R0402_100k_5%_62.5mW
R15: 1k; R0402; PARTNO R0402_1k_5%_62.5mW
R23: 47k; R0402; PARTNO R0402_47k_5%_62.5mW
R24: 470k; R0402; PARTNO R0402_470k_5%_62.5mW
R25: 0R; R0603; PARTNO R0603_0R_5%_125mW
R30: 33R; R0402; PARTNO R0402_33R_5%_62.5mW
S2: SD-007; PARTNO SD-007
U1: MP65150DJ; SOT23-6; PARTNO MP65150DJ
U2: AU6350-MGL; LQFP-48_7X7
Y1: 12 MHz; CRYSTAL_32X25; PARTNO CRYSTAL_32X25_2SH_12PF_30PPM

Connections:
!CHIPRESET: R21.2, U2.21 (!CHIPRESET)
!SDCD: D5.6 (I/O4), R27.2, S2.CD (S+), U2.23 (SDCDN)
+3V3: C8.2, C9.2, C13.2, C15.2, R11.2, R13.2, R18.1, R22.1, U2.6 (AVDD), U2.9 (AVDD), U2.16 (VDDH), U2.39 (VDDH), U2.43 (AVDD), U2.46 (AVDD), U2.48 (PVDD)
+5V: C7.1, C10.1, L1.2, R12.2, R14.2, R23.2, U1.1 (IN)
AVDD5V: C11.1, R12.1, U2.11 (AVDD5V)
BUS_PWREDN: R18.2, U2.17 (BUS_PWREDN)
CHIPRESET: C16.1, R21.1, R23.1, R24.2
CLK: R29.2, R30.2
CONTROLOUT0: R29.1, U2.25 (CONTROLOUT0)
DP1_N: D3.3, J2.2, R5.1
DP1_OVRCUR: R13.1, U1.4 (!FLAG), U2.20 (DP1_OVRCUR)
DP1_P: D3.2, J2.3, R6.1
DP1_PWR: C2.1, D3.4, J2.1, R1.1
DP1_PWRUP: R14.1, U1.3 (!EN), U2.19 (DP1_PWRUP)
DP2_N: D1.3, J1.3, R7.1
DP2_P: D1.2, J1.5, R8.1
DP2_PWR: C1.1, D1.4, J1.1, R2.1
DP3_N: D2.3, J1.4, R9.1
DP3_P: D2.2, J1.6, R10.1
DP3_PWR: C3.1, D2.4, J1.2, R3.1
DP_PWR: C4.1 (+), R1.2, R2.2, R3.2, U1.6 (OUT)
GND: C1.2, C2.2, C3.2, C4.2 (-), C5.1, C6.1, C7.2, C8.1, C9.1, C10.2, C11.2, C12.1, C13.1, C14.2, C15.1, C16.2, C17.1, C18.2, C19.2, D1.1, D2.1, D3.1, D4.2 (GND), D5.2 (GND), J1.7, J1.8, J2.4, J2.S$1 (G), J2.S$2 (G), L2.1, R4.2, R15.2, R16.2, R17.2, R24.1, R27.1, R28.1, S2.6 (VSS), S2.G$1 (G), S2.G$2 (G), S2.G$3 (G), S2.S-/G (S-), U1.2 (GND), U2.3 (PVSS), U2.15 (PLL_VSS), U2.40 (VSSH), Y1.2, Y1.4
GND_USB: J3.6, J3.10, J4.10, L2.2
ILIM: R4.1, U1.5 (ILIM)
MSINS: R22.2, U2.22 (MSINS)
SDCLK: C18.1, D4.4 (I/O3), R30.1, S2.5 (CLK)
SDCMD: D4.6 (I/O4), R26.1, S2.3 (CMD), U2.27 (CARDDATA0)
SDDAT0: D5.3 (I/O2), S2.7 (DAT0), U2.31 (CARDDATA4)
SDDAT1: D5.1 (I/O1), S2.8 (DAT1), U2.32 (CARDDATA5)
SDDAT3: D4.3 (I/O2), S2.2 (CD/DAT3), U2.34 (CARDDATA7)
SDDDAT2: D4.1 (I/O1), S2.1 (DAT2), U2.33 (CARDDATA6)
SDVDD: C19.1, D4.5 (VCC), D5.5 (VCC), R25.2, R26.2, S2.4 (VDD)
SDWP: R28.2, U2.29 (CARDDATA2)
SD_V33: R25.1, U2.12 (SD_V33)
UP_N: J3.8, R19.2
UP_P: J3.9, R20.2
UP_PREF: R15.1, U2.47 (UP_RREF)
USB1_N: R5.2, U2.44 (USB1_DM)
USB1_P: R6.2, U2.45 (USB1_DP)
USB2_N: R7.2, U2.4 (DP2_DM)
USB2_P: R8.2, U2.5 (DP2_DP)
USB3_N: R9.2, U2.7 (DP3_DM)
USB3_P: R10.2, U2.8 (DP3_DP)
USB_N: R16.1, R19.1, U2.41 (USB_DM)
USB_P: R17.1, R20.1, U2.42 (USB_DP)
V18: C12.2, C14.1, C17.2, U2.13 (V18), U2.14 (PLL_VDD), U2.18 (VDD), U2.26 (VDD)
V33: R11.1, U2.10 (V33)
VUSB: J3.7, L1.1
XSCI: C6.2, U2.2 (XSCI), Y1.3
XSCO: C5.2, U2.1 (XSCO), Y1.1

Notes on the sheet:
Ceramic capacitors are ±10% 50V X7R dielectric 0402 unless otherwise specified
Resistors are 5% 1/16W 0402 unless otherwise specified
Licensed under a Creative Commons
Attribution-Share-Alike Unported License.
See creativecommons.org/licenses/by-sa/4.0/
Reference designs are provided "AS IS" and "WITH ALL FAULTS".
regarding this product, including but not limited to, any implied warranties of
The Domino Team may make changes to specifications and product
Global Marine Networks disclaims all other warranties express or implied,
merchantibility or fitness for any particular application.
descriptions at any time, without notice.
Domino Core
Domino Pi
Domino Qi
© 2014, The Domino Team All rights reserved.
Rev.
KEY
Reserve 0 Ohm resistor for EMI certification
Reserve 0 Ohm resistor for EMI certification
Reserve 0 Ohm resistor for USB-IF certification
Reserve 0 Ohm resistor for USB-IF certification

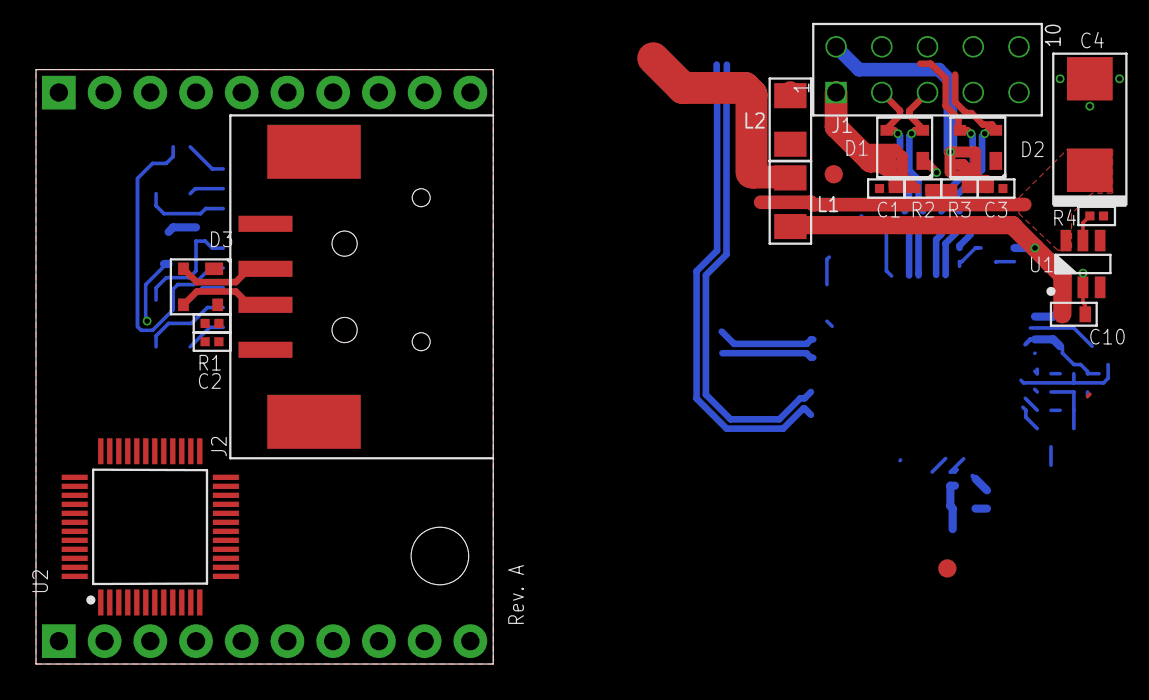
[picture p106: board Domino USB MicroSD No Teardrop New.brd from above]

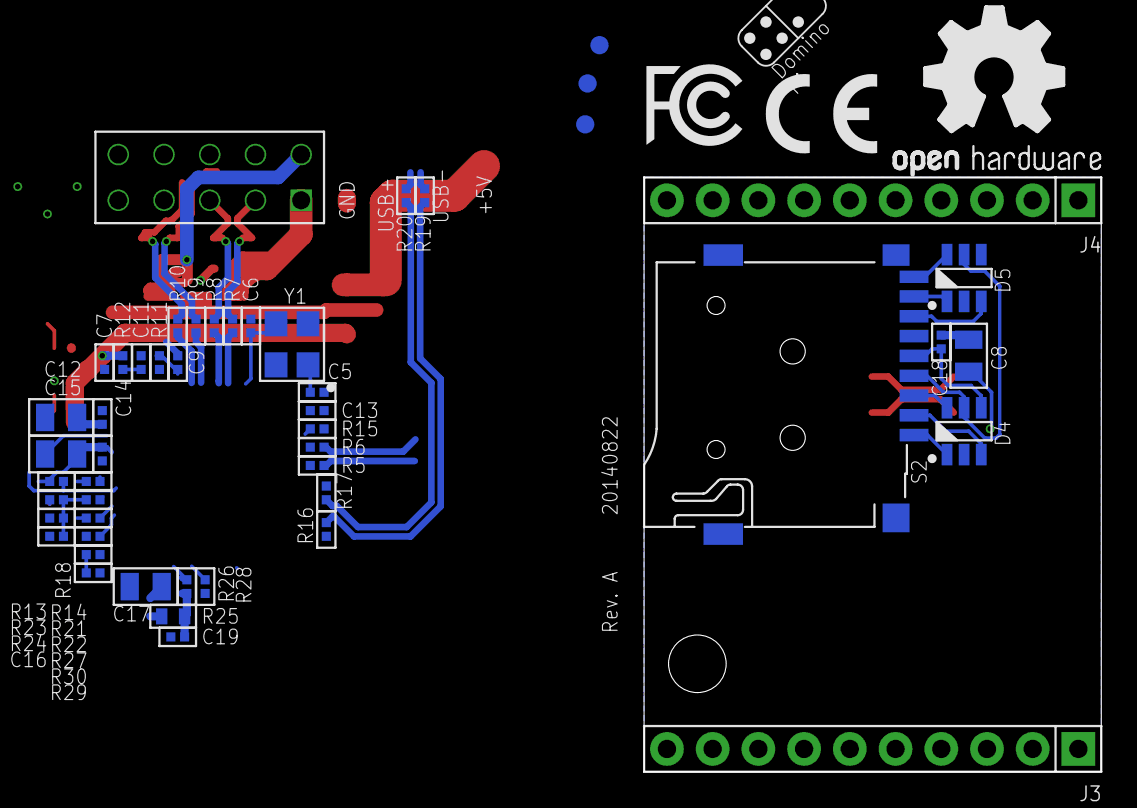
[picture p107: board Domino USB MicroSD No Teardrop New.brd from below]

Board: 2 copper layers, 25.4 x 33.0 mm, 76 parts (53 on the bottom side), 50 nets.

Other parts of the board:
DRILEGEND: DRILEGEND
U$3: A5L-LOC
U$4: DOMINO_LOGO_SMALL
U$13: CE_LOGO_SMALL
U$15: FCC_LOGO_SMALL
U$16: OPEN_HARDWARE_LOGO
