domino-team/domino-hardware/Domino Single Ethernet/Domino Single Ethernet PoE No Teardrop.brd

## EAGLE design Domino Single Ethernet/Domino Single Ethernet PoE No Teardrop.brd (2014-08-12)

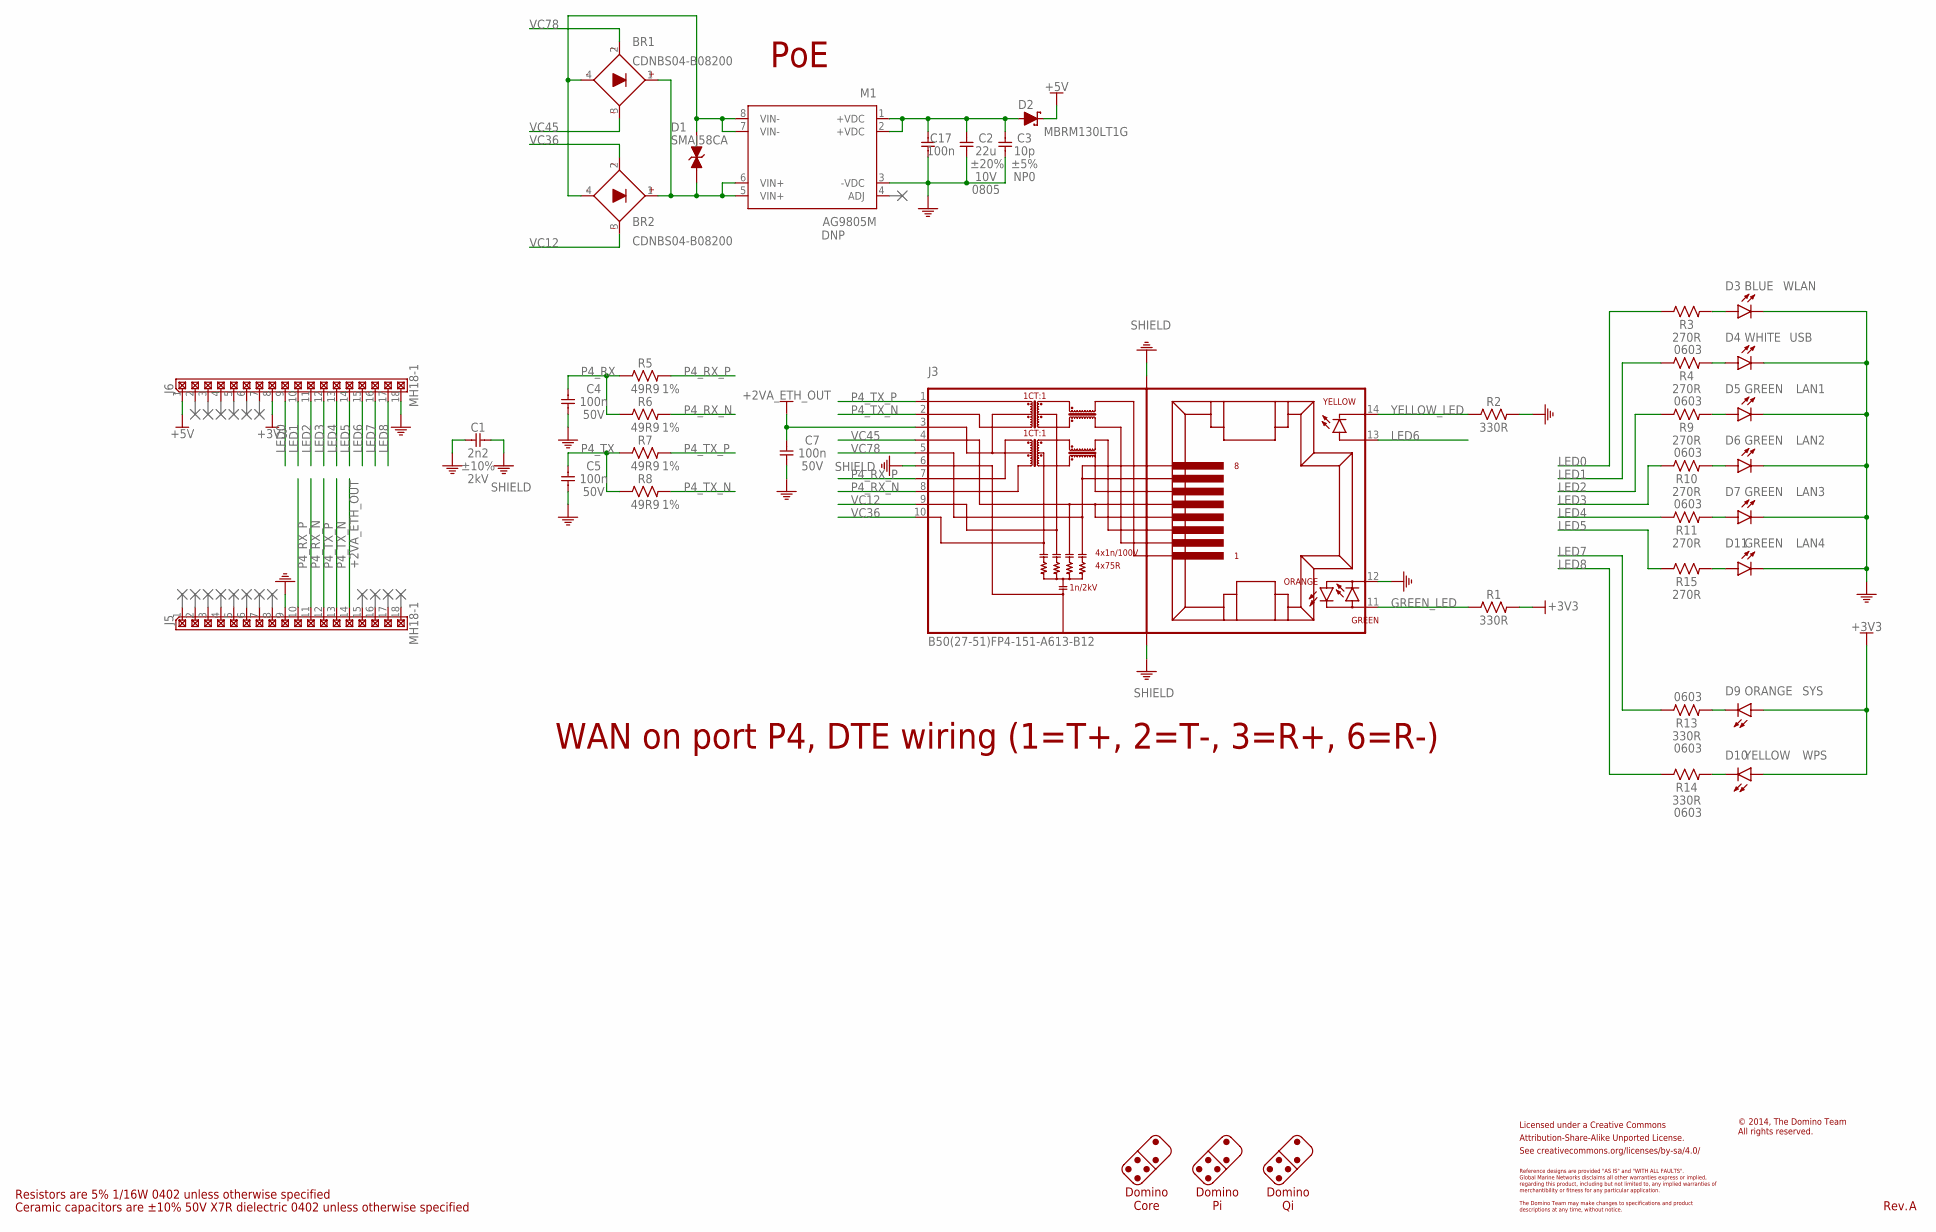
[picture p108: schematic Domino Single Ethernet PoE No Teardrop.sch]

Parts:
BR1, BR2: CDNBS04-B08200; NBS04; PARTNO CDNBS04-B08200
C1: 2n2; C1206; PARTNO C1210_2n2_X7R_10%_CER_2kV
C2: 22u; C0805; PARTNO C1206_22u_X7R_20%_CER_10V
C3: 10p; C0402; PARTNO C0402_10p_NP0_5%_CER_50V
C4, C5, C7, C17: 100n; C0402; PARTNO C0402_100n_X7R_10%_CER_50V
CC-BY-SA1: CC-BY-SA_LOGO
D1: SMAJ58CA; SMA
D2: MBRM130LT1G; DO-216AA; PARTNO MBRM130LT1G
D3: BLUE; LED0603; PARTNO LED0603-BLUE
D4: WHITE; LED0603; PARTNO LED0603-WHITE
D5, D6, D7, D11: GREEN; LED0603; PARTNO LED0603-GREEN
D9: ORANGE; LED0603; PARTNO LED0603-ORANGE
D10: YELLOW; LED0603; PARTNO LED0603-YELLOW
J3: B50(27-51)FP4-151-A613-B12; PARTNO B50(27-51)FP4-151-A613-B12
J5, J6: MH18-1; MH18-1-0.1
M1: AG9805M; AG9800M; PARTNO Ag9800M
R1, R2: 330R; R0402; PARTNO R0402_330R_5%_62.5mW
R3, R4, R9, R10, R11, R15: 270R; R0603; PARTNO R0603_270R_5%_125mW
R5, R6, R7, R8: 49R9; R0402; PARTNO R0402_49R9_1%_62.5mW
R13, R14: 330R; R0603; PARTNO R0603_330R_5%_125mW

Connections:
+: BR1.1 (+), BR2.1 (+), D1.C (2), M1.5 (VIN+), M1.6 (VIN+)
+2VA_ETH_OUT: C7.2, J3.3, J5.14
+3V3: D9.2 (A), D10.2 (A), J6.8, R1.2
+5V: D2.1 (C), J6.1
+VDC@1: C2.1, C3.1, C17.1, D2.2 (A), M1.1 (+VDC), M1.2 (+VDC)
-: BR1.4 (-), BR2.4 (-), D1.A (1), M1.7 (VIN-), M1.8 (VIN-)
GND: C1.1, C2.2, C3.2, C4.1, C5.1, C7.1, C17.2, D3.1 (C), D4.1 (C), D5.1 (C), D6.1 (C), D7.1 (C), D11.1 (C), J3.12, J5.9, J6.18, M1.3 (-VDC), R2.2
GREEN_LED: J3.11, R1.1
LED0: J6.9, R3.1
LED1: J6.10, R4.1
LED2: J6.11, R9.1
LED3: J6.12, R10.1
LED4: J6.13, R11.1
LED5: J6.14, R15.1
LED6: J3.13, J6.15
LED7: J6.16, R13.1
LED8: J6.17, R14.1
unnamed: D3.2 (A), R3.2
unnamed: D4.2 (A), R4.2
unnamed: D5.2 (A), R9.2
unnamed: D6.2 (A), R10.2
unnamed: D7.2 (A), R11.2
unnamed: D9.1 (C), R13.2
unnamed: D10.1 (C), R14.2
unnamed: D11.2 (A), R15.2
P4_RX: C4.2, R5.1, R6.1
P4_RX_N: J3.8, J5.11, R6.2
P4_RX_P: J3.7, J5.10, R5.2
P4_TX: C5.2, R7.1, R8.1
P4_TX_N: J3.2, J5.13, R8.2
P4_TX_P: J3.1, J5.12, R7.2
SHIELD: C1.2, J3.6, J3.SH$1 (SHIELD), J3.SH$2 (SHIELD)
VC12: BR2.3 (AC2), J3.9
VC36: BR2.2 (AC1), J3.10
VC45: BR1.3 (AC2), J3.4
VC78: BR1.2 (AC1), J3.5
YELLOW_LED: J3.14, R2.1

Notes on the sheet:
Ceramic capacitors are ±10% 50V X7R dielectric 0402 unless otherwise specified
Resistors are 5% 1/16W 0402 unless otherwise specified
Licensed under a Creative Commons
Attribution-Share-Alike Unported License.
See creativecommons.org/licenses/by-sa/4.0/
Reference designs are provided "AS IS" and "WITH ALL FAULTS".
regarding this product, including but not limited to, any implied warranties of
The Domino Team may make changes to specifications and product
Global Marine Networks disclaims all other warranties express or implied,
merchantibility or fitness for any particular application.
descriptions at any time, without notice.
Domino Core
Domino Pi
Domino Qi
© 2014, The Domino Team All rights reserved.
Rev.
WAN on port P4, DTE wiring (1=T+, 2=T-, 3=R+, 6=R-)
PoE
WLAN
USB
LAN1
LAN2
LAN3
LAN4
SYS
WPS

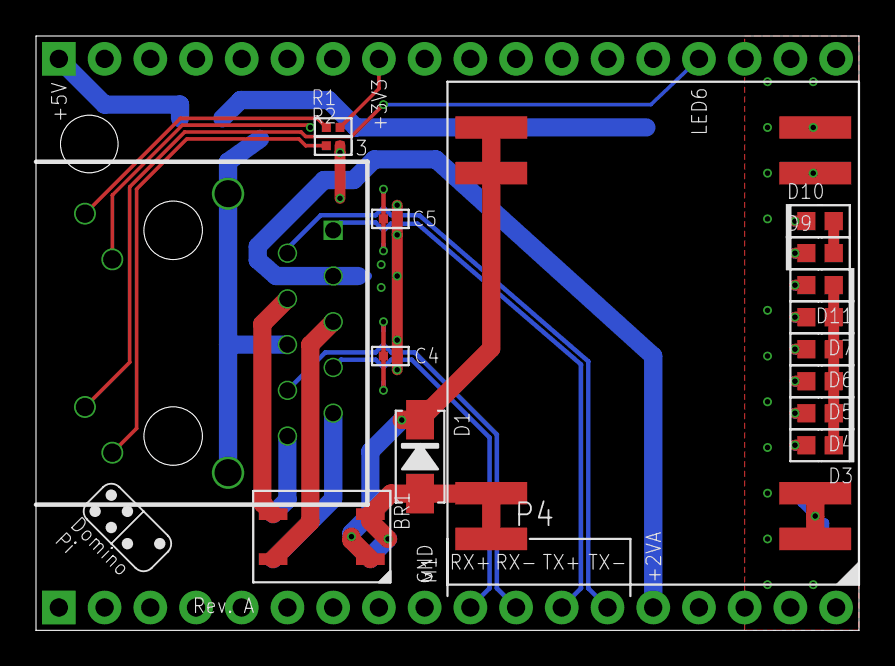
[picture p109: board Domino Single Ethernet PoE No Teardrop.brd from above]

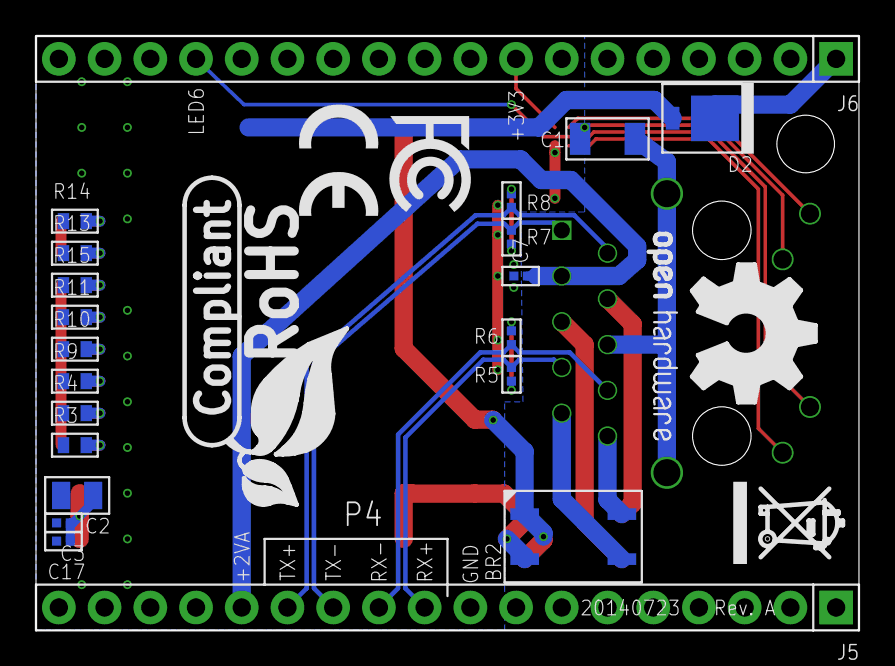
[picture p110: board Domino Single Ethernet PoE No Teardrop.brd from below]

Board: 2 copper layers, 45.7 x 33.0 mm, 46 parts (26 on the bottom side), 37 nets.

Other parts of the board:
DRILEGEND: DRILEGEND
U$3: A5L-LOC
U$4: DOMINO_LOGO_SMALL
U$5: CE_LOGO_SMALL
U$6: FCC_LOGO_SMALL
U$7: OPEN_HARDWARE_LOGO
U$8: RECYCLE_BIN_LOGO
U$9: ROHS_LOGO
