domino-team/domino-hardware/Domino USB MicroSD/Domino USB MicroSD Passive Overcurrent Protection.brd

## EAGLE design Domino USB MicroSD/Domino USB MicroSD Passive Overcurrent Protection.brd (2014-08-10)

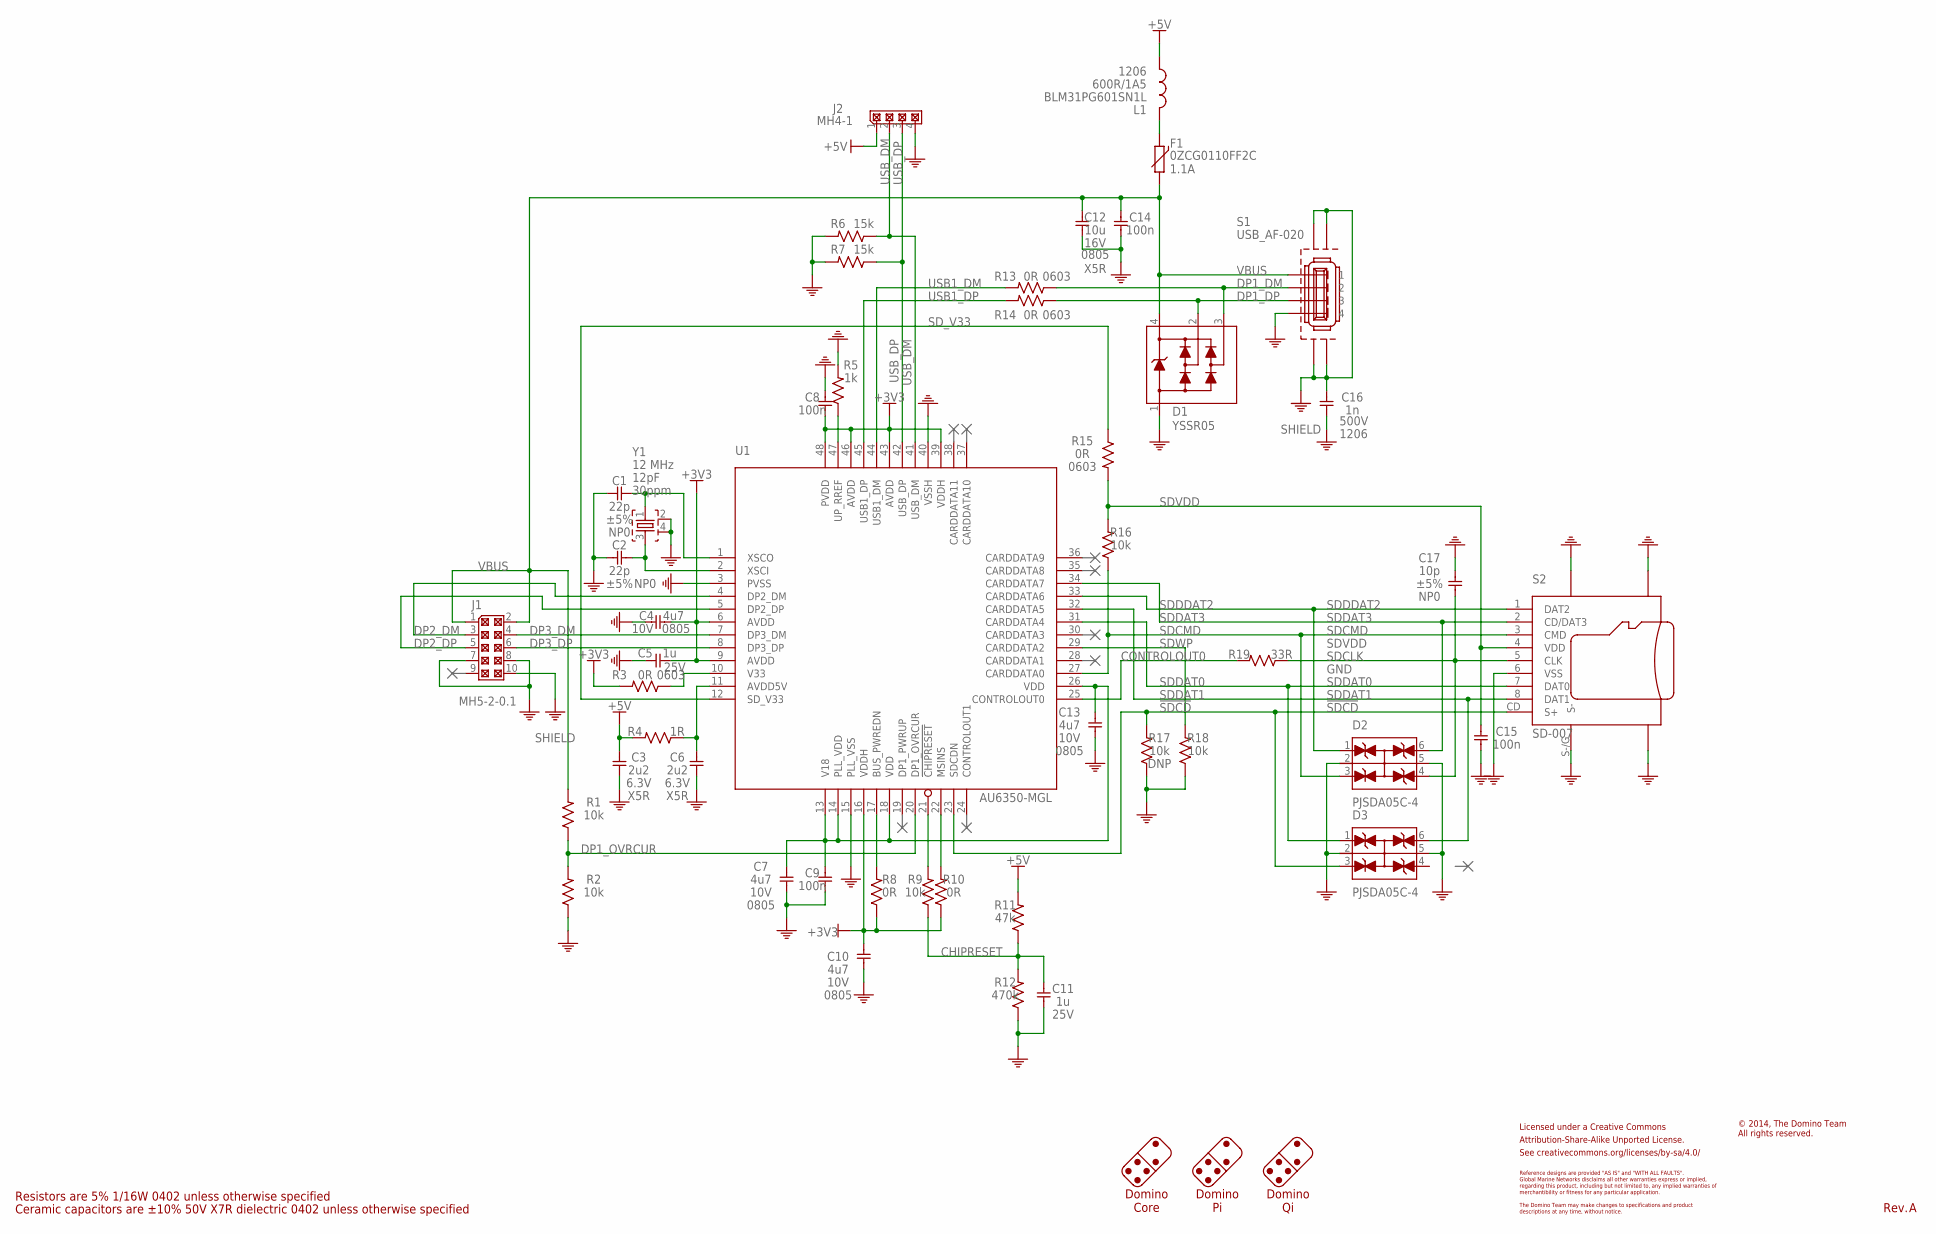
[picture p111: schematic Domino USB MicroSD Passive Overcurrent Protection.sch]

Parts:
C1, C2: 22p; C0402; PARTNO C0402_22p_NP0_5%_CER_50V
C3, C6: 2u2; C0402; PARTNO C0402_2u2_X5R_10%_CER_6V3
C4, C7, C10, C13: 4u7; C0805; PARTNO C0805_4u7_X7R_10%_CER_6V3
C5, C11: 1u; C0402; PARTNO C0402_1u_X7R_10%_CER_25V
C8, C9, C14, C15: 100n; C0402; PARTNO C0402_100n_X7R_10%_CER_50V
C12: 10u; C0805; PARTNO C0805_10u_X5R_10%_CER_16V
C16: 1n; C1206; PARTNO C1206_1n_X7R_10%_CER_500V
C17: 10p; C0402; PARTNO C0402_10p_NP0_5%_CER_50V
CC-BY-SA1: CC-BY-SA_LOGO
D1: YSSR05; SOT143B; PARTNO YSSR05
D2, D3: PJSDA05C-4; SOT23-6
F1: 0ZCG0110FF2C; PTC1812; PARTNO 0ZCG0110FF2C
J1: MH5-2-0.1; MH05-2-0.1; PARTNO MH5-2-0.1
J2: MH4-1; MH4-1-0.1; PARTNO MH4-1-0.1
L1: BLM31PG601SN1L; FB1206; PARTNO BLM31PG601SN1L
R1, R2, R9, R16, R17, R18: 10k; R0402; PARTNO R0402_10k_5%_62.5mW
R3, R13, R14, R15: 0R; R0603; PARTNO R0603_0R_5%_125mW
R4: 1R; R0402; PARTNO R0402_1R_5%_62.5mW
R5: 1k; R0402; PARTNO R0402_1k_5%_62.5mW
R6, R7: 15k; R0402; PARTNO R0402_15k_5%_62.5mW
R8, R10: 0R; R0402; PARTNO R0402_0R_5%_62.5mW
R11: 47k; R0402; PARTNO R0402_47k_5%_62.5mW
R12: 470k; R0402; PARTNO R0402_470k_5%_62.5mW
R19: 33R; R0402; PARTNO R0402_33R_5%_62.5mW
S1: USB_AF-020; PARTNO USB_AF-020
S2: SD-007; PARTNO SD-007
U1: AU6350-MGL; LQFP-48_7X7; PARTNO AU6350-MGL
Y1: 12 MHz; CRYSTAL_32X25; PARTNO CRYSTAL_32X25_2SH_12PF_30PPM

Connections:
!CHIPRESET: R9.2, U1.21 (!CHIPRESET)
!SDCD: D3.3, R17.2, S2.CD (S+), U1.23 (SDCDN)
+3V3: C4.2, C5.2, C8.2, C10.2, R3.2, R8.1, R10.1, U1.6 (AVDD), U1.9 (AVDD), U1.16 (VDDH), U1.39 (VDDH), U1.43 (AVDD), U1.46 (AVDD), U1.48 (PVDD)
+5V: C3.1, J2.1, L1.2, R4.2, R11.2
BUS_PWREDN: R8.2, U1.17 (BUS_PWREDN)
CHIPRESET: C11.1, R9.1, R11.1, R12.2
CONTROLOUT0: R19.2, U1.25 (CONTROLOUT0)
DP1_DM: D1.3, R13.1, S1.2
DP1_DP: D1.2, R14.1, S1.3
DP1_OVRCUR: R1.1, R2.2, U1.20 (DP1_OVRCUR)
DP2_DM: J1.3, U1.4 (DP2_DM)
DP2_DP: J1.5, U1.5 (DP2_DP)
DP3_DM: J1.4, U1.7 (DP3_DM)
DP3_DP: J1.6, U1.8 (DP3_DP)
GND: C1.1, C2.1, C3.2, C4.1, C5.1, C6.2, C7.1, C8.1, C9.2, C10.1, C11.2, C12.2, C13.1, C14.2, C15.2, C16.2, C17.2, D1.1, D2.2, D2.5, D3.2, D3.5, J1.7, J1.8, J2.4, R2.1, R5.2, R6.2, R7.2, R12.1, R17.1, R18.1, S1.4, S2.6 (VSS), S2.G$1 (G), S2.G$2 (G), S2.G$3 (G), S2.S-/G (S-), U1.3 (PVSS), U1.15 (PLL_VSS), U1.40 (VSSH), Y1.2, Y1.4
MSINS: R10.2, U1.22 (MSINS)
unnamed: F1.1, L1.1
unnamed: C6.1, R4.1, U1.11 (AVDD5V)
unnamed: R3.1, U1.10 (V33)
SDCLK: C17.1, D2.4, R19.1, S2.5 (CLK)
SDCMD: D2.3, R16.1, S2.3 (CMD), U1.27 (CARDDATA0)
SDDAT0: D3.1, S2.7 (DAT0), U1.31 (CARDDATA4)
SDDAT1: D3.6, S2.8 (DAT1), U1.32 (CARDDATA5)
SDDAT3: D2.6, S2.2 (CD/DAT3), U1.34 (CARDDATA7)
SDDDAT2: D2.1, S2.1 (DAT2), U1.33 (CARDDATA6)
SDVDD: C15.1, R15.2, R16.2, S2.4 (VDD)
SDWP: R18.2, U1.29 (CARDDATA2)
SD_V33: R15.1, U1.12 (SD_V33)
SHIELD: C16.1, J1.10, S1.G$1 (G), S1.G$2 (G), S1.G$3 (G), S1.G$4 (G)
UP_PREF: R5.1, U1.47 (UP_RREF)
USB1_DM: R13.2, U1.44 (USB1_DM)
USB1_DP: R14.2, U1.45 (USB1_DP)
USB_DM: J2.2, R6.1, U1.41 (USB_DM)
USB_DP: J2.3, R7.1, U1.42 (USB_DP)
V18: C7.2, C9.1, C13.2, U1.13 (V18), U1.14 (PLL_VDD), U1.18 (VDD), U1.26 (VDD)
VBUS: C12.1, C14.1, D1.4, F1.2, J1.1, J1.2, R1.2, S1.1
XSCI: C2.2, U1.2 (XSCI), Y1.3
XSCO: C1.2, U1.1 (XSCO), Y1.1

Notes on the sheet:
Ceramic capacitors are ±10% 50V X7R dielectric 0402 unless otherwise specified
Resistors are 5% 1/16W 0402 unless otherwise specified
Licensed under a Creative Commons
Attribution-Share-Alike Unported License.
See creativecommons.org/licenses/by-sa/4.0/
Reference designs are provided "AS IS" and "WITH ALL FAULTS".
regarding this product, including but not limited to, any implied warranties of
The Domino Team may make changes to specifications and product
Global Marine Networks disclaims all other warranties express or implied,
merchantibility or fitness for any particular application.
descriptions at any time, without notice.
Domino Core
Domino Pi
Domino Qi
© 2014, The Domino Team All rights reserved.
Rev.

Board: 2 copper layers, 51 parts (1 on the bottom side), 38 nets, no tracks yet.

Other parts of the board:
DRILEGEND: DRILEGEND
U$3: A5L-LOC
U$4: DOMINO_LOGO_SMALL
