domino-team/domino-hardware/(commit log)

2014-08-10 Changed directory organization for revision B
    [DRILEGEND.CFG, Domino Dual Ethernet BOM.xlsx, Domino Dual Ethernet No Teardrop.brd, Domino Dual Ethernet No Teardrop.sch, Domino Dual Ethernet.brd, Domino Dual Ethernet.sch, Domino JTAG BOM.xlsx, Domino JTAG No Teardrop.brd]
2014-08-10 Point to common part database for BOM
    [Domino Dual Ethernet No Teardrop.sch, Domino Dual Ethernet.sch, Domino JTAG No Teardrop.sch, Domino JTAG.sch, Domino LED No Teardrop.sch, Domino LED Overlap No Teardrop.sch, Domino LED.sch, Domino Pi No Teardrop.sch]
2014-08-10 Remvoed references to other projects
    [Domino Pi No Teardrop.brd, Domino Pi No Teardrop.sch, Domino Pi.brd, Domino Pi.sch, Domino Qi.brd, Domino Qi.sch, Domino Single Ethernet Overlap No Teardrop.brd, Domino Single Ethernet Overlap No Teardrop.sch]
2014-08-10 Changed copyright
    [Domino Dual Ethernet No Teardrop.brd, Domino Dual Ethernet No Teardrop.sch, Domino Dual Ethernet.brd, Domino Dual Ethernet.sch, Domino JTAG No Teardrop.brd, Domino JTAG No Teardrop.sch, Domino JTAG.brd, Domino JTAG.sch]
2014-08-12 Created Domino Single Ethernet Revision B and updated Domino LED tiles
    [DRILEGEND.CFG, Domino Single Ethernet PoE No Teardrop.brd, Domino Single Ethernet PoE No Teardrop.sch]
2014-08-12 ... and all the files I missed
    [Domino LED BOM.xlsx, Domino LED No Teardrop.brd, Domino LED No Teardrop.sch, Domino LED Overlap No Teardrop.brd, Domino LED Overlap No Teardrop.sch, Domino LED.brd, Domino LED.sch, Domino Pi No Teardrop.brd]
2014-08-13 Made Single Ethernet tile with component on top side only
    [DRILEGEND.CFG, Domino Single Ethernet No Teardrop.brd, Domino Single Ethernet.brd]
2014-08-15 Domino tile Dual Ethernet Revision B
    [DRILEGEND.CFG, Domino Dual Ethernet BOM.xlsx, Domino Dual Ethernet No Teardrop.brd, Domino Dual Ethernet No Teardrop.sch, Domino Dual Ethernet.brd, Domino Dual Ethernet.sch]
2014-08-17 Domino Single USB tile Revision B
    [DRILEGEND.CFG, Domino Dual Ethernet No Teardrop.brd, Domino Dual Ethernet No Teardrop.sch, Domino Single USB BOM.xlsx, Domino Single USB No Teardrop.brd, Domino Single USB No Teardrop.sch, Domino Single USB.brd, Domino Single USB.sch]
2014-08-17 Added M3 hole to Domino Single USB tile
    [Domino Single USB No Teardrop.brd, Domino Single USB.brd]
2014-08-17 Added M3 hole dimensions to Domino Single USB tile
    [Domino Single USB No Teardrop.brd, Domino Single USB.brd]
2014-08-18 Re-routed Single USB tile to remove vias on USB traces
    [Domino Single USB No Teardrop.brd, Domino Single USB No Teardrop.sch, Domino Single USB.brd, Domino Single USB.sch]
2014-08-20 Replaced RJ45 Jack with one model without LED in Dual Ethernet tile
    [Domino Dual Ethernet BOM.xlsx, Domino Dual Ethernet No Teardrop.brd, Domino Dual Ethernet No Teardrop.sch, Domino Dual Ethernet.brd, Domino Dual Ethernet.sch]
2014-08-21 Domino Single Ethernet tile Revision B
    [Domino Single Ethernet BOM.xlsx, Domino Single Ethernet No Teardrop.brd, Domino Single Ethernet No Teardrop.sch, Domino Single Ethernet.brd, Domino Single Ethernet.sch]
2014-08-21 Domino Pi Dual Ethernet tile: Removed thermals on copper pour and completed pinout
    [Domino Dual Ethernet No Teardrop.brd, Domino Dual Ethernet.brd]
2014-08-22 Domino JTAG/SPI tile Revision B
    [DRILEGEND.CFG, Domino JTAG BOM.xlsx, Domino JTAG No Teardrop.brd, Domino JTAG No Teardrop.sch, Domino JTAG SPI BOM.xlsx, Domino JTAG SPI No Teardrop.brd, Domino JTAG SPI No Teardrop.sch, Domino JTAG SPI.brd]
2014-08-24 Modified Domino Flash SPI tile to fit a standard SPI Flash jig and SPI Flash chip footprint
    [Domino JTAG SPI BOM.xlsx, Domino JTAG SPI No Teardrop.brd, Domino JTAG SPI No Teardrop.sch, Domino JTAG SPI.brd, Domino JTAG SPI.sch]
2014-08-24 Added series resistors on SPI Flash SO in Domino JTAG SPI tile
    [Domino JTAG SPI BOM.xlsx, Domino JTAG SPI No Teardrop.brd, Domino JTAG SPI No Teardrop.sch, Domino JTAG SPI.brd, Domino JTAG SPI.sch]
2014-08-27 Added vias to JTAG SPI tile for better RF performance
    [Domino JTAG SPI No Teardrop.brd, Domino JTAG SPI.brd]
2014-09-30 Added new right tile layout for Domino USB MicroSD
    [Domino USB MicroSD No Teardrop New.brd, Domino USB MicroSD No Teardrop New.sch]
2014-10-10 Added first Domino Qi Mini board
    [Domino Qi Mini.brd, Domino Qi Mini.sch]
2014-12-15 Changed Domino JTAG SPI to Rev. C
    [Domino JTAG SPI BOM.xlsx, Domino JTAG SPI No Teardrop.brd, Domino JTAG SPI No Teardrop.sch, Domino JTAG SPI.brd, Domino JTAG SPI.sch]
2014-12-30 Domino Pi rev. C: removed Schottky diode on +VUSB, it causes too much voltage drop, optimized power wiring, changed Logos
    [DRILEGEND.CFG, Domino Pi BOM.xlsx, Domino Pi No Teardrop.brd, Domino Pi No Teardrop.sch, Domino Pi.brd, Domino Pi.sch]
2014-12-30 Domino JTAG SPI Rev. C: changed Logos
    [Domino JTAG SPI No Teardrop.brd, Domino JTAG SPI No Teardrop.sch, Domino JTAG SPI.brd, Domino JTAG SPI.sch]
2014-12-30 Domino LED Rev. C: changed Logos
    [Domino LED BOM.xlsx, Domino LED No Teardrop.brd, Domino LED No Teardrop.sch, Domino LED.brd, Domino LED.sch]
2014-12-30 Domino Single Ethernet Rev. C: changed Logos
    [Domino Single Ethernet BOM.xlsx, Domino Single Ethernet No Teardrop.brd, Domino Single Ethernet No Teardrop.sch, Domino Single Ethernet.brd, Domino Single Ethernet.sch]
2014-12-30 Domino Single USB Rev. C: changed Logos
    [Domino Single USB BOM.xlsx, Domino Single USB No Teardrop.brd, Domino Single USB No Teardrop.sch, Domino Single USB.brd, Domino Single USB.sch]
2014-12-30 Domino Qi Mini: work in progress
    [Domino Qi Mini.brd, Domino Qi Mini.sch]
2014-12-31 Domino Dual Ethernet Rev. C: Changed dual Magjack connector for new one, changed Logos
    [Domino Dual Ethernet BOM.xlsx, Domino Dual Ethernet No Teardrop.brd, Domino Dual Ethernet No Teardrop.sch, Domino Dual Ethernet.brd, Domino Dual Ethernet.sch]
2014-12-31 Domino Single USB Rev. C: removed the resetable fuse that causes too much drop for high-current USB devices
    [Domino Single USB BOM.xlsx, Domino Single USB No Teardrop.brd, Domino Single USB No Teardrop.sch, Domino Single USB.brd, Domino Single USB.sch]
2015-01-06 Work in progress: changed for PCB antenna and removed Schottky diode on Domino Qi Mini, first Domino Qi draft
    [Domino Qi Mini.brd, Domino Qi Mini.sch, Domino Qi.brd, Domino Qi.sch]
2015-01-06 Pushed remaining Domino Qi files
    [Domino Qi.brd]
2015-01-16 Added USB power switch to Sinfle USB tile
    [Domino Single USB BOM.xlsx, Domino Single USB No Teardrop.brd, Domino Single USB No Teardrop.sch, Domino Single USB.brd, Domino Single USB.sch]
2015-01-17 Domino Single USB tile Rev. D: added resistors en power siwtch feedback and enable, changed output capacitor to smaller one
    [Arduino Yùn Outline.dxf, Domino Single USB BOM.xlsx, Domino Single USB No Teardrop.brd, Domino Single USB No Teardrop.sch, Domino Single USB.brd, Domino Single USB.sch]
2015-01-19 Domino Pi Rev. D: replaced resetable fuse by power swich, mino changes DC/DC layout and added more stitching vias
    [Domino Pi BOM.xlsx, Domino Pi No Teardrop.brd, Domino Pi No Teardrop.sch, Domino Pi.brd, Domino Pi.sch]
2015-01-19 Domino Pi Rev. D: added some vias, spaced antenna pi network components and removed solder paste from antenna
    [Domino Pi No Teardrop.brd, Domino Pi No Teardrop.sch, Domino Pi.brd, Domino Pi.sch]
2015-01-19 Domino Pi Rev. D: bumped year in bottom silkscreen
    [Domino Pi No Teardrop.brd, Domino Pi.brd]
2015-01-19 Domino Pi Rev.D: removed some leftover traces within poured areas
    [Domino Pi No Teardrop.brd, Domino Pi.brd]
2015-01-20 Work in progress on Domino Qi Mini board
    [Arduino Yùn Outline.dxf, Domino Qi Mini.brd, Domino Qi Mini.sch, Logos.dxf]
2015-01-20 Domino Pi Rev.D: removed silkscreen for test pads, moved text to make them nicer
    [Domino Pi No Teardrop.brd, Domino Pi.brd]
2015-01-26 Work in progress on Domino Qi Mini board: clustered all voltage translator chips instead of putting them close to ATMega32U4
    [DRILEGEND.CFG, Domino Qi Mini.brd, Domino Qi Mini.sch]
2015-01-27 Domino Qi Mini: only 20 airwires left
    [Domino Qi Mini.brd]
2015-01-27 Domino Qi Mini: Work in progress, only 8 airwires left
    [Domino Qi Mini.brd]
2015-01-28 Domino Qi Mini: only 1 airwire left!
    [Domino Qi Mini.brd, Domino Qi Mini.sch]
2015-01-29 Domino Qi Mini rev. A: eventually no more airwires
    [Domino Qi Mini No Teardrop.brd, Domino Qi Mini No Teardrop.sch]
2015-01-30 Domino Qi Mini Rev. A: changes in bottom silkscreen
    [Domino Qi Mini No Teardrop.brd, Domino Qi Mini No Teardrop.sch, Domino Qi Mini.brd, Domino Qi Mini.sch]
2015-01-31 Domino Qi Mini Rev. A: added BOM and a few datasheets
    [Domino Qi Mini BOM.xlsx, Domino Qi Mini No Teardrop.brd, Domino Qi Mini No Teardrop.sch, Domino Qi Mini.brd, Domino Qi Mini.sch]
2015-02-03 Domino I2S Rev. A: work in progress
    [DRILEGEND.CFG, Domino I2S No Teardrop.brd, Domino I2S No Teardrop.sch, Domino I2S.brd, Domino I2S.sch]
2015-02-04 Domino I2S Rev. A: added mounting hole and silkscreen artwork
    [Domino I2S No Teardrop.brd, Domino I2S No Teardrop.sch, Domino I2S.brd, Domino I2S.sch]
2015-02-07 Domino I2S Rev. A: started again from correct PADS files
    [Domino I2S BOM.xlsx, Domino I2S No Teardrop.brd, Domino I2S No Teardrop.sch, Domino I2S.brd, Domino I2S.sch]
2015-02-09 Domino I2S tile Rev. A: corrected ferrite beads to HH-1T2012-601
    [Domino I2S BOM.xlsx, Domino I2S No Teardrop.brd, Domino I2S No Teardrop.sch, Domino I2S.brd, Domino I2S.sch]
2015-02-09 Domino I2S tile Rev. B: made board multiple of 100 mils Cleaned up silkscreen made +5V trace wider Aligned some components
    [Domino I2S BOM.xlsx, Domino I2S No Teardrop.brd, Domino I2S.brd]
2015-02-12 Domino Qi Mini Rev. B: changed silkscreen font ratio to 20%
    [Domino Qi Mini BOM.xlsx, Domino Qi Mini No Teardrop.brd, Domino Qi Mini No Teardrop.sch, Domino Qi Mini.brd, Domino Qi Mini.sch]
2015-02-12 Domino Dual Ethernet Rev. D: changed silkscreen font ratio to 20%
    [Domino Dual Ethernet BOM.xlsx, Domino Dual Ethernet No Teardrop.brd, Domino Dual Ethernet No Teardrop.sch, Domino Dual Ethernet.brd, Domino Dual Ethernet.sch]
2015-02-12 Domino I2S Rev. C: changed silkscreen font ratio to 20%
    [Domino I2S BOM.xlsx, Domino I2S No Teardrop.brd, Domino I2S No Teardrop.sch, Domino I2S.brd, Domino I2S.sch]
2015-02-12 Domino JTAG SPI Rev. D: changed silkscreen font ratio to 20%
    [Domino JTAG SPI BOM.xlsx, Domino JTAG SPI No Teardrop.brd, Domino JTAG SPI No Teardrop.sch, Domino JTAG SPI.brd, Domino JTAG SPI.sch]
2015-02-13 Domino LED Rev. D: changed silkscreen font ratio to 20%
    [Domino LED BOM.xlsx, Domino LED No Teardrop.brd, Domino LED No Teardrop.sch, Domino LED.brd, Domino LED.sch]
2015-02-13 Domnio Pi Rev. E: changed silkscreen font ratio to 20%
    [Domino Pi BOM.xlsx, Domino Pi No Teardrop.brd, Domino Pi No Teardrop.sch, Domino Pi.brd, Domino Pi.sch]
2015-02-13 Domnio Single Ethernet Rev. D: changed silkscreen font ratio to 20%
    [Domino Single Ethernet BOM.xlsx, Domino Single Ethernet No Teardrop.brd, Domino Single Ethernet No Teardrop.sch, Domino Single Ethernet.brd, Domino Single Ethernet.sch]
2015-02-13 Domino Single USB Rev. E: changed silkscreen font ratio to 20%
    [Domino Single USB BOM.xlsx, Domino Single USB No Teardrop.brd, Domino Single USB No Teardrop.sch, Domino Single USB.brd, Domino Single USB.sch]
2015-03-06 Domino Qi Mini Rev. C: changed NTB0102GU to NTB0102GF
    [Domino Qi Mini BOM.xlsx, Domino Qi Mini No Teardrop.brd, Domino Qi Mini No Teardrop.sch, Domino Qi Mini.brd, Domino Qi Mini.sch]
2015-03-18 Domino Qi Mini Rev. D: corrected bridge pinout
    [Domino Qi Mini BOM.xlsx, Domino Qi Mini No Teardrop.brd, Domino Qi Mini No Teardrop.sch, Domino Qi Mini.brd, Domino Qi Mini.sch]
2015-04-19 Added Domino Di Rev. A board
    [DRILEGEND.CFG, Domino Di BOM.xlsx, Domino Di No Teardrop.brd, Domino Di No Teardrop.sch, Domino Di.brd, Domino Di.sch]
2015-04-20 Domino Di Rev. A: added slider switch
    [Domino Di BOM.xlsx, Domino Di No Teardrop.brd, Domino Di No Teardrop.sch, Domino Di.brd, Domino Di.sch]
2015-05-09 Added UART header to both Ethernet tiles
    [Domino Dual Ethernet BOM.xlsx, Domino Dual Ethernet No Teardrop.brd, Domino Dual Ethernet No Teardrop.sch, Domino Dual Ethernet.brd, Domino Dual Ethernet.sch, Domino Single Ethernet BOM.xlsx, Domino Single Ethernet No Teardrop.brd, Domino Single Ethernet No Teardrop.sch]
2015-05-09 Changed Domino Qi Mini to 4 layers
    [Domino Qi Mini BOM.xlsx, Domino Qi Mini.brd, Domino Qi Mini.sch]
2015-05-10 Domino Di Rev. B: removed battery charger as too complex
    [Domino Di BOM.xlsx, Domino Di No Teardrop.brd, Domino Di No Teardrop.sch, Domino Di.brd, Domino Di.sch]
