domino-team/domino-hardware/(notices)

Notices in the files:
parts and their libraries:
Domino: See creativecommons.org/licenses/by-sa/4.0/ for details.
Domino: See creativecommons.org/licenses/by-sa/3.0/ for details.
Domino: Copyright © 2012, Michel Stempin, All rights reserved
Licenced under Creative Commons CC BY-SA 3.0 license.
